DangerMonkeys/leaf/src/README.md

# leaf source code

This folder contains the source code for the leaf vario including [libraries](libraries) and [core source code](vario).  It requires Arduino and the ESP 32 Board Manager (see [documentation](vario/README.md)).

## PlatformIO

To use [PlatformIO](https://platformio.org/) to develop this project:

### Setup

1. Download [Visual Studio Code](https://code.visualstudio.com/)
2. In the Extensions tab, search for PlatformIO and install the extension (make sure to restart VS Code when requested)
3. Make sure that formatting will be applied on save:
    1. Open preferences with File -> Preferences -> Settings
    2. Type in "files: auto save" to the search box to find "Files: Auto Save"
    3. Ensure this setting is **not** afterDelay (all other settings are ok)

### Development

* Open the [root repository folder](..) (File -> Open Folder...)
* Change build environment as desired
    * Click second-from-right icon in PlatformIO toolbar (small bar at bottom of IDE) and select the release environment appropriate to your hardware (e.g., "leaf_3_2_5_release")
* Build and upload firmware
    * If needed (if upload fails and/or if running a release version with mass storage enabled), put in bootloader mode:
        * Unplug device (leaf)
        * Make sure device is turned off (hold center button to turn off)
        * Hold down boot button (smallest speaker hole)
        * Plug in device to USB
            * Alternately, press and release reset button (largest speaker hole)
        * Release boot button
    * Click the small rightward arrow in the PlatformIO toolbar to build and upload firmware

### Testing

* To ensure minimal functionality of new firmware, use this [basic test procedure](../docs/dev-references/testing/test_procedure.md)

#### Formatting

To auto-format all Leaf C++ files:

* Open command palette (ctrl-shift-p or View -> Command Palette...)
* Select "Tasks: Run Task" (start typing "run task" to find that option)
* Select "Format Leaf C++ Files"

### Versioning

The many types of versions used by leaf are documented here.

#### Tag version

Releases on this repository are assigned [semantic versions](https://semver.org) which point to a specific commit in the repository, and the tag for the release is named according to that version, prefixed with a "v" (e.g., `v0.0.9`).  That semantic version is a "tag version".  Since a release contains/produces firmware for multiple hardware variants, a given tag version can be associated with multiple firmware versions.

#### Hardware version

All leaf-compatible hardware designs are assigned [semantic versions](https://semver.org); e.g., 2.3.5.

#### Hardware type

Currently, firmware is only built for native leaf hardware and the hardware type for all leaf hardware versions is "leaf".  If support were ever added for hardware other than leaf hardware, that hardware would have a different hardware type.  The hardware type should be a lowercase alphanumeric identifier starting with an alphabet character.

#### Hardware variant

A hardware variant refers to a specific type of hardware.  It is formed by replacing the periods in the hardware version with underscores, and then concatenating the hardware type and underscored hardware version with an underscore.  So, for instance leaf hardware version 2.3.5 would be the hardware variant `leaf_2_3_5`.  Each hardware variant customizes the build as described in [variants](./variants).

#### Behavior variant

All supported hardware uses the `release` environment. Developer features are controlled by the runtime `dev_mode` setting in that firmware.

UDP sensor injection accepts messages on port 7431 only when `dev_mode` and the web app Developer card's **UDP sensor injection** setting are both enabled, and Leaf is connected to WiFi or hosting its access point. Injection is off by default. Disabling `dev_mode` also clears the saved injection setting, so enabling developer mode again does not resume injection. Connect using the usual WiFi controls; developer mode does not automatically start WiFi or keep it connected after leaving the menu.

For replay while using the flight pages, enable the web app's developer control to keep the app always on before leaving the menu.

The v3.2.2 lab hardware can be built manually with `pio run -e leaf_3_2_2_release`; GitHub CI builds only field hardware.

#### Firmware version

A firmware version is a [semantic version](https://semver.org) describing a particular firmware binary.  It is composed of the tag version of the most recent release tag in the history of the branch from which the firmware was built, plus a prerelease label when appropriate, plus build metadata.

When firmware is built from a commit tagged as a release, no prerelease label is added (e.g., `0.0.9+h2.3.5`).  When firmware is built from a clean workspace at a commit later than a tagged release, a prerelease label of the first three characters of the commit hash is added (e.g., `0.0.9-fa8+h2.3.5`).  If the workspace is dirty (there are uncommitted changes that would affect the repository), a "d" is appended to the prerelease label (e.g., `0.0.9-fa8d+h2.3.5` for local changes on top of commit faa8 after/on the `0.0.9` tag version).

The build metadata is the hardware version prefixed with "h" (e.g., `h2.3.5` for leaf hardware version 2.3.5).  The build metadata is appended to the firmware version with a plus, per semantic versioning.  Note that hardware type is not encoded in firmware version.
