DangerMonkeys/leaf/vario/hardware/readme.md

Sensor Axes
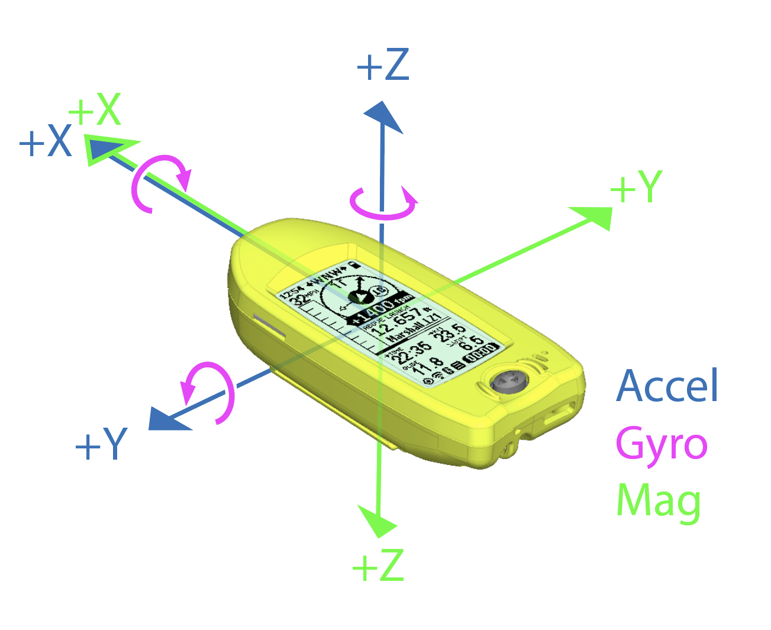
[picture p1: vario/hardware/assets/Leaf_Axes.jpg]


PCB
