DangerMonkeys/leaf/src/vario/hardware/README.md

# hardware

This folder contains abstractions for hardware devices. These tools interact directly with the hardware device at the electrical level and present the information gathered in the most "raw" form that is semantically meaningful.

- [Buttons](./buttons.md)
