DangerMonkeys/leaf/docs/dev-references/bluetooth.md

---
title: Bluetooth Low Energy
description: Leaf BLE serial protocol and diagnostics
---

# Bluetooth Low Energy

Leaf exposes a Nordic UART Service (NUS) so that flight applications can treat it as a BLE serial
device. The implementation has been tested with XCSoar, XCTrack, and SeeYou Navigator.

## Device name and advertising

The complete Bluetooth name is `LeafXXXX`, where `XXXX` is the last four hexadecimal digits of
Leaf's Wi-Fi station MAC address. The Connect menu and the GAP Device Name characteristic use
this same eight-character name. The Wi-Fi access point name remains `Leaf-XXXX`.

The primary advertisement contains flags (3 bytes), the Nordic UART service UUID (18 bytes), and
the complete Bluetooth name (10 bytes including field overhead), totaling 31 bytes. Both the
service and the full device identifier are available without a scan response. Advertising data
is reset on each setup so Bluetooth restarts do not accumulate old fields.

Disabling Bluetooth tears down both the radio stack and its server, services, and characteristics.
Re-enabling it creates a fresh GATT database with a single Nordic UART service. The server callback
has static lifetime and is not owned by NimBLE, allowing the server to be safely deleted.

## GATT interface

| Item | UUID | Properties | Purpose |
| --- | --- | --- | --- |
| Nordic UART service | `6E400001-B5A3-F393-E0A9-E50E24DCCA9E` | Service | BLE serial container |
| RX characteristic | `6E400002-B5A3-F393-E0A9-E50E24DCCA9E` | Write without response, 64-byte maximum | Data written by the phone to Leaf |
| TX characteristic | `6E400003-B5A3-F393-E0A9-E50E24DCCA9E` | Read and notify | Data sent by Leaf to the phone |

The RX characteristic is present because some BLE serial clients require the complete bidirectional
NUS interface during service discovery. Leaf currently accepts but does not interpret RX data. It
also does not echo received data.

Only one BLE central connection is supported at a time. When an application disconnects, Leaf
restarts advertising so another application can connect. The BLE task checks the connection count
and actual advertising state on each wakeup. While enabled and disconnected, it retries inactive
advertising at most once per second, including after a failed initial start. Disconnect callbacks
record diagnostics; restarting happens in the BLE task. Advertising attempts are serialized with
start/stop, so recovery cannot undo an intentional Bluetooth shutdown.

The Connect menu shows the sampled runtime state below the Bluetooth name: `Advertising`,
`Connected`, `Retrying...`, or `Inactive`. `Connected` means NimBLE still reports a central connection;
it does not confirm that the phone has subscribed to NMEA notifications. If the phone reports a
disconnect but Leaf remains `Connected`, advertising retries deliberately leave that connection
alone. This distinguishes a missed disconnect or retained phone connection from a failed restart.

## Transmitted data

All TX records are ASCII NMEA-style sentences ending in an XOR checksum and `\r\n`. Incoming GPS
GGA and RMC records have their checksum recalculated before transmission, so a checksum inherited
from the GPS module cannot cover stale or modified content.

Leaf sends the following record types:

- `$LK8EX1` at up to 10 Hz, containing pressure in Pa, pressure altitude in metres, filtered climb
  rate in cm/s, ambient temperature in degrees Celsius, and battery percentage encoded as
  `1000 + percentage`. The comma before the checksum is intentional and required for compatibility
  with some clients. Temperature is `99` until the ambient sensor is ready.
- `$GPGGA`/`$GNGGA` and `$GPRMC`/`$GNRMC` GPS records, limited to two of each type per second.
- `$PFLAA` traffic records generated from received FANET tracking packets when Leaf has a usable
  local GPS fix.

Leaf does not expose the standard Battery Service or Environmental Sensing Service. Battery and
temperature are carried in `$LK8EX1`; humidity and wind are not currently transmitted over BLE.

## Diagnostics

BLE diagnostics use the existing `diagnostics/system_events.csv` file. No separate BLE log or
in-memory history buffer is created. The instrumentation records:

- connection and disconnection checkpoints, including the NimBLE disconnect reason;
- advertising restart success or failure;
- changes in the sampled connection/advertising state (also shown in the Connect menu);
- cumulative NUS notification submission counts at disconnect;
- immediately reported notification-submission failures;
- full periodic, GPS, or FANET BLE queues; and
- heap and registered-task stack snapshots at important connection lifecycle events.

Leaf also checks heap integrity every five seconds while the BLE task is running. A healthy check is
silent; only a failure produces a `ble-heap-invalid` event. Consequently, normal operation adds no
per-sentence SD writes and only a few records around each connection transition.
SD diagnostics require Developer Mode and the System Events diagnostic log to be enabled.

NimBLE's characteristic-update API is asynchronous. A successful `notify()` result means the update
was submitted to NimBLE; it is not confirmation that the phone received the notification over the
air.
