DangerMonkeys/leaf/codex_artifacts/runtime-telemetry/thermal-track-bitmap-2026-10-22/report.html

# Leaf runtime assessment · Leaf 3.2.8 bitmap Thermal Track - logging and wind page sweep

device · leaf_3_2_8 · 0.2.4-842d.thermaltest+h3.2.8 · 72.3 seconds

REVIEW REQUIRED · Normal slots: 43 deadline crossings · 0 duration overruns · 0 coalesced ticks · minimum 67 samples/slot

0–10 ms scale. Green <5; yellow 5–7.5; orange 7.5–10; red >10 ms or a deadline miss. Thresholds are provisional. Bars show maxima across different seconds. A short red bar indicates work finishing beyond its deadline despite low accumulated occupancy. T/G/S show average assigned-task/GPS/service milliseconds. GPS and foreground services are included; empty UART polling is separate. Base work includes barometer, buttons, and speaker.

00 baro_adc

max 1.15 ms · p95 ≤ 1.15 msstart +0.01 · end +0.00 msavg T 0.89 G 0.00 S 0.00n=69 · misses 0excluded B 4 · R 0

01 base

max 0.60 ms · p95 ≤ 0.60 msstart +0.01 · end +0.00 msavg T 0.46 G 0.00 S 0.00n=69 · misses 0excluded B 3 · R 1

02 imu_wind

max 3.91 ms · p95 ≤ 3.91 msstart +0.01 · end +0.00 msavg T 3.48 G 0.00 S 0.00n=69 · misses 0excluded B 3 · R 1

03 base

max 0.79 ms · p95 ≤ 0.50 msstart +0.01 · end +0.00 msavg T 0.31 G 0.00 S 0.00n=69 · misses 0excluded B 3 · R 1

04 base

max 0.80 ms · p95 ≤ 0.80 msstart +0.01 · end +0.00 msavg T 0.42 G 0.00 S 0.00n=70 · misses 0excluded B 3 · R 0

05 baro_adc

max 1.70 ms · p95 ≤ 1.00 msstart +0.01 · end +0.00 msavg T 0.76 G 0.00 S 0.00n=70 · misses 0excluded B 3 · R 0

06 base

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

88 base

max 0.91 ms · p95 ≤ 0.91 msstart +0.01 · end +0.00 msavg T 0.31 G 0.00 S 0.01n=72 · misses 0excluded B 1 · R 0

89 display

max 8.01 ms · p95 ≤ 8.00 msstart +0.01 · end +0.00 msavg T 6.84 G 0.00 S 0.01n=71 · misses 0excluded B 2 · R 0

90 baro_adc

max 1.56 ms · p95 ≤ 1.00 msstart +0.01 · end +0.00 msavg T 0.85 G 0.00 S 0.01n=71 · misses 0excluded B 2 · R 0

91 base

max 1.13 ms · p95 ≤ 1.00 msstart +0.01 · end +0.00 msavg T 0.49 G 0.00 S 0.01n=71 · misses 0excluded B 1 · R 1

92 imu_wind

max 4.44 ms · p95 ≤ 4.00 msstart +0.01 · end +0.00 msavg T 3.41 G 0.00 S 0.01n=71 · misses 0excluded B 1 · R 1

93 base

max 0.91 ms · p95 ≤ 0.91 msstart +0.01 · end +0.00 msavg T 0.30 G 0.00 S 0.01n=70 · misses 0excluded B 2 · R 1

94 base

max 1.03 ms · p95 ≤ 1.00 msstart +0.01 · end +0.00 msavg T 0.41 G 0.00 S 0.01n=70 · misses 0excluded B 3 · R 0

95 baro_adc

max 1.14 ms · p95 ≤ 1.00 msstart +0.01 · end +0.00 msavg T 0.74 G 0.00 S 0.00n=70 · misses 0excluded B 3 · R 0

96 base

max 0.84 ms · p95 ≤ 0.84 msstart +0.01 · end +0.00 msavg T 0.47 G 0.00 S 0.00n=70 · misses 0excluded B 3 · R 0

97 imu

max 4.22 ms · p95 ≤ 4.00 msstart +0.01 · end +0.00 msavg T 3.37 G 0.00 S 0.00n=70 · misses 0excluded B 3 · R 0

98 base

max 0.77 ms · p95 ≤ 0.77 msstart +0.01 · end +0.00 msavg T 0.30 G 0.00 S 0.00n=70 · misses 0excluded B 3 · R 0

99 ambient_read

max 1.73 ms · p95 ≤ 1.73 msstart +0.01 · end +0.00 msavg T 0.81 G 0.00 S 0.00n=69 · misses 0excluded B 4 · R 0

## Display pages

Normal renders only; menus and overlays excluded. Render costs include SPI wait, drawing and transfer, and are already included in slot occupancy. Page flags refer to actual rendered content. Unvisited pages remain unmeasured.

Page | Renders | Max ms | Mean ms | p95 ms | Max occupied slot ms | Slot misses/samples | Excluded B/R renders
User | 23 | 8.727 | 6.346 | ≤7.000 | 9.239 | 0/23 | 6/0
Thermal Track | 32 | 7.379 | 6.684 | ≤7.000 | 7.827 | 0/32 | 6/0
Navigate | 31 | 7.354 | 7.121 | ≤7.354 | 8.016 | 0/31 | 7/0
Basic | 24 | 6.183 | 5.807 | ≤6.183 | 6.766 | 0/24 | 3/1
Thermal Core | 25 | 5.706 | 5.332 | ≤5.706 | 6.215 | 0/25 | 7/0
Debug | Not measured | | | | | | 0/0
Debug 2 | Not measured | | | | | | 0/0

## Buttons and recovery

Excluded from normal grid: 238 button slots and 52 recovery slots. Button peak occupied 21.877 ms; button coalesced ticks 0. Recovery: 2 deadline crossings, 2 coalesced ticks; max start +8.916 ms, end +0.022 ms, barometer first call +8.979 ms.

Recovery by slot

Slot | Excluded B/R | Max start +ms | Max end +ms | Misses/ticks | Baro +ms
00 | 4/0 | 0.000 | 0.000 | 0/0 | 0.000
01 | 3/1 | 4.442 | 0.000 | 0/0 | 4.503
02 | 3/1 | 0.005 | 0.000 | 0/0 | 0.038
03 | 3/1 | 0.007 | 0.000 | 0/0 | 0.073
04 | 3/0 | 0.000 | 0.000 | 0/0 | 0.000
05 | 3/0 | 0.000 | 0.000 | 0/0 | 0.000
06 | 2/0 | 0.000 | 0.000 | 0/0 | 0.000
07 | 3/0 | 0.000 | 0.000 | 0/0 | 0.000
08 | 2/1 | 0.005 | 0.000 | 0/0 | 0.066
09 | 2/2 | 5.257 | 0.000 | 0/0 | 5.320
10 | 2/1 | 0.005 | 0.000 | 0/0 | 0.053
11 | 2/1 | 0.005 | 0.000 | 0/0 | 0.025
12 | 2/0 | 0.000 | 0.000 | 0/0 | 0.000
13 | 2/0 | 0.000 | 0.000 | 0/0 | 0.000
14 | 2/0 | 0.000 | 0.000 | 0/0 | 0.000
15 | 2/0 | 0.000 | 0.000 | 0/0 | 0.000
16 | 2/0 | 0.000 | 0.000 | 0/0 | 0.000
17 | 2/0 | 0.000 | 0.000 | 0/0 | 0.000
18 | 2/0 | 0.000 | 0.000 | 0/0 | 0.000
19 | 2/0 | 0.000 | 0.000 | 0/0 | 0.000
20 | 2/1 | 5.369 | 0.000 | 0/0 | 5.436
21 | 2/1 | 0.005 | 0.000 | 0/0 | 0.059
22 | 2/1 | 0.007 | 0.000 | 0/0 | 0.026
23 | 2/1 | 4.573 | 0.000 | 0/0 | 4.636
24 | 2/1 | 0.008 | 0.000 | 0/0 | 0.037
25 | 2/1 | 0.007 | 0.000 | 0/0 | 0.023
26 | 2/0 | 0.000 | 0.000 | 0/0 | 0.000
27 | 2/0 | 0.000 | 0.000 | 0/0 | 0.000
28 | 2/0 | 0.000 | 0.000 | 0/0 | 0.000
29 | 3/0 | 0.000 | 0.000 | 0/0 | 0.000
30 | 3/0 | 0.000 | 0.000 | 0/0 | 0.000
31 | 3/0 | 0.000 | 0.000 | 0/0 | 0.000
32 | 3/0 | 0.000 | 0.000 | 0/0 | 0.000
33 | 2/1 | 7.808 | 0.000 | 0/0 | 7.874
34 | 2/1 | 0.008 | 0.000 | 0/0 | 0.038
35 | 2/1 | 0.005 | 0.000 | 0/0 | 0.020
36 | 2/0 | 0.000 | 0.000 | 0/0 | 0.000
37 | 2/0 | 0.000 | 0.000 | 0/0 | 0.000
38 | 2/0 | 0.000 | 0.000 | 0/0 | 0.000
39 | 1/1 | 2.091 | 0.000 | 0/0 | 2.156
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

## GPS sentence handling

1002 completed dispatches · 5 sentence deadline crossings. Sentence and slot crossing counts differ: multiple sentences may share a slot. These summaries include button/recovery activity.

NMEA | Count | Accepted/rejected/unobserved | Mean ms | Max ms | p95 ms | Crossings | Max end +ms
GGA | 72 | 72/0/0 | 1.818 | 2.026 | ≤2.000 | 0 | 0.000
RMC | 73 | 73/0/0 | 1.864 | 2.062 | ≤2.000 | 1 | 0.155
GSV | 421 | 421/0/0 | 1.209 | 1.894 | ≤1.894 | 3 | 0.262
GSA | 216 | 216/0/0 | 1.035 | 1.330 | ≤1.330 | 0 | 0.000
VTG | 73 | 73/0/0 | 0.926 | 1.068 | ≤1.068 | 0 | 0.000
GLL | 72 | 72/0/0 | 1.300 | 1.374 | ≤1.374 | 1 | 0.112
ZDA | Not measured
Other | 75 | 75/0/0 | 0.636 | 0.888 | ≤0.888 | 0 | 0.000

Checksum acceptance is separate from a valid position fix. Processing combines active UART-read chunks and complete-line dispatch; idle waiting between fragments is excluded. On device, elapsed times include blocking and preemption; simulator values use host thread CPU time.

Processing stages · mean (maximum) ms

Stages are exclusive, including nested mutex waits. GPS updates means immediate sentence updates; scheduled navigation/glide work remains in slots 09/59. Other is remaining measured processing time. UART reads are absent for injected messages; separate captures should be used for distinct input sources.

NMEA | UART read | Bus mutex wait | Mutex wait | Parse | GPS updates | Reading callbacks | BLE enqueue | Other mean
GGA | 1.404 (1.505) | 0.006 (0.011) | 0.006 (0.008) | 0.115 (0.161) | 0.031 (0.043) | 0.103 (0.120) | 0.041 (0.052) | 0.110
RMC | 1.360 (1.484) | 0.006 (0.010) | 0.006 (0.008) | 0.097 (0.110) | 0.008 (0.011) | 0.230 (0.274) | 0.049 (0.097) | 0.109
GSV | 0.921 (1.291) | 0.006 (0.014) | 0.004 (0.012) | 0.082 (0.201) | 0.062 (0.131) | 0.062 (0.199) | 0.014 (0.041) | 0.057
GSA | 0.848 (1.019) | 0.006 (0.011) | 0.004 (0.010) | 0.044 (0.067) | 0.005 (0.014) | 0.059 (0.113) | 0.014 (0.031) | 0.055
VTG | 0.712 (0.784) | 0.005 (0.016) | 0.005 (0.010) | 0.035 (0.044) | 0.007 (0.011) | 0.076 (0.118) | 0.014 (0.030) | 0.070
GLL | 1.006 (1.052) | 0.006 (0.011) | 0.005 (0.011) | 0.048 (0.052) | 0.009 (0.011) | 0.100 (0.121) | 0.024 (0.029) | 0.100
Other | 0.531 (0.580) | 0.005 (0.012) | 0.004 (0.009) | 0.016 (0.044) | 0.002 (0.011) | 0.037 (0.100) | 0.010 (0.046) | 0.031

### Sentence dispatch phase across the 100 logical slots

Phase is observed after a line is assembled, before dispatch. It is not the receiver's wire-arrival timestamp; queued bytes can be older. Logical phase can shift after coalesced ticks. Injected input reflects its playback schedule.

### Retained sentence deadline crossings

Ready/end offsets are relative to the slot's intended start; end beyond +10 ms crosses its deadline. Observed read span may include inter-fragment waiting and is not CPU cost. Hover for stage durations.

Sentence | Checksum/parser | Slot/tick | Ready +ms | End +ms | Processing ms | Observed read span ms | Context
GPGSV | accepted | 83/2881475 | 9.770 | 10.262 | 1.306 | 0.839 | UART, partial ingestion
GNRMC | accepted | 82/2886575 | 9.637 | 10.155 | 1.860 | 4.945 | UART
GNGLL | accepted | 78/2883471 | 9.795 | 10.112 | 1.326 | 8.215 | UART
GLGSV | accepted | 81/2887074 | 9.824 | 10.053 | 1.010 | 7.647 | UART

Recent sentences (may overlap retained crossings)

Sentence | Checksum/parser | Slot/tick | Ready +ms | End +ms | Processing ms | Observed read span ms | Context
GPGSV | accepted | 79/2888673 | 2.504 | 3.028 | 1.677 | 8.689 | UART
GPGSV | accepted | 79/2888673 | 3.532 | 3.711 | 0.627 | 0.458 | UART
GLGSV | accepted | 80/2888674 | 1.772 | 2.123 | 1.158 | 8.044 | UART
GAGSV | accepted | 80/2888674 | 3.377 | 3.571 | 1.392 | 1.207 | UART
GAGSV | accepted | 80/2888674 | 4.202 | 4.333 | 0.738 | 0.613 | UART
GNRMC | accepted | 81/2888675 | 3.280 | 3.825 | 1.903 | 8.932 | UART
GNVTG | accepted | 81/2888675 | 4.687 | 4.913 | 0.949 | 0.749 | UART
PQOther | accepted | 81/2888675 | 5.473 | 5.569 | 0.625 | 0.534 | UART

Coverage: 0 asynchronous dispatches excluded; 0 nested dispatches omitted; 0 dispatches before a slot; 1 partial-ingestion sentences; 0 UART buffer resets. Recent events overwritten: 994 (capacity 8); crossing capacity 4. Maximum profile-record bookkeeping: 37 µs. This does not isolate full profiler overhead.

## Memory

Internal heap change -4 B. Allocation failures: 0

Sampled minima: {"internal_free": 33208, "internal_min": 26644, "internal_largest": 13300, "loop_stack": 8304, "ble_stack": 2992, "fanet_tx_stack": 0, "fanet_rx_stack": 0}

## Observer footprint

Capture buffer: 22,496 B (internal). Clock pair max: 1 µs; slot bookkeeping max: 166 µs; memory sample max: 650 µs. Trace records overwritten: 7216; partial slots excluded: 1.

## Baseline changes

No compatible baseline comparison

Slot | Maximum change | Miss-rate change

## Worst incident and preceding slot

Timestamps in microseconds since boot; work columns use elapsed microseconds.

Event | Slot | Tick | Expected start | Actual start | Tasks end | Last work end | Tasks/GPS/services | Page mask
Normal worst | 83 | 2881475 | 28815754600 | 28815763223 | 28815763500 | 28815764890 | 248/1365/0 | 00
Recovery preceding | 82 | 2881575 | 28816754600 | 28816754606 | 28816773469 | 28816773432 | 18780/0/0 | 08
Recovery worst | 83 | 2881576 | 28816764600 | 28816773516 | 28816773804 | 28816774622 | 263/790/0 | 00

Review notes and measurement limits

- Normal slot/page statistics exclude held buttons, button events and recovery. Recovery covers the next two dispatched slots and extends while completion is late or start delay exceeds 1 ms; inspect it separately.
- Few samples: the least-sampled slot has 67; tail estimates are preliminary.
- GPS summaries include all sentence dispatches, including interactions. Stages are exclusive elapsed times on device (host thread CPU in sim), not isolated CPU costs. UART timestamps observe firmware reads, not wire arrival. Checksum acceptance does not establish a valid position fix.
- The first UART sentence(s) contained bytes read before capture; their ingestion timings are partial.
- Recent trace wrapped by design; full-run slot aggregates and the worst incident remain available.
- Clock-pair, slot-bookkeeping, and memory-sampling costs are reported. Full instrumentation overhead requires an external A/B measurement.
- A zero stack reading can mean an unregistered task or no headroom; inspect active task state and raw samples. Positive stack minima skip zero readings.
- Stage 1 manual capture: enabled features are not verified workload coverage. Review is required before release.
- Memory change is between manual capture endpoints; a negative change alone does not prove a leak. Heap low watermarks include earlier boot activity.
- ATTENTION: internal free heap ended below its starting value; repeat equivalent lifecycle phases to assess recovery.
- ATTENTION: barometer first-call delay exceeded 1 ms in slots 83. Check conversion timing.
- ATTENTION: button recovery includes deadline crossings, coalesced ticks or barometer delays. Button exclusions do not establish safe recovery; check sensor/GPS/IGC continuity on hardware.

Provenance

{"commit": "8427b318ffb68ce1360d7c247d6eaacf4d6997ad", "coverage_notes": "User reports logging active, enough collected points for a valid wind estimate, then about 10-12 seconds on each page from Navigate through Basic. Capture spans 72.261 seconds. Ten fixed synthetic Thermal Track markers, bitmap rings/erase/markers/pilot, outlined distance labels. BLE enabled; client activity not established. Debug pages enabled but unvisited. Latest IGC preserved separately; this export does not record wind estimate validity or its value.", "device_id": "7C4FAD3BACB0", "dirty": true, "firmware_sha256": "1847d9102bfe5b5d9fb40b6beb8cbbbc3108df9b7cd0986936401472f5fbd548", "flashed_firmware_verified": "USB I:/FIRMWARE.BIN SHA256 equals local test build and preserved firmware.bin", "label": "Leaf 3.2.8 bitmap Thermal Track - logging and wind page sweep", "limitations": "Short exploratory manual sweep, 23-32 normal renders per page; not a release assessment. Prior runtime_6 had different GPS activity/arrival phase, shorter duration, debug setting and unconfirmed flight logging/wind conditions. Descriptive before/after only; no matched-baseline speedup attribution. Render times include SPI wait, raster drawing and transfer.", "profile": "manual-page-sweep-v1", "scenario": "real-gps-logging-wind-ten-fixed-thermal-markers-v1", "sd_card": "Connected Leaf SD card; model/capacity not recorded", "toolchain": "leaf_3_2_8_thermaltest; pinned PlatformIO configuration; exact firmware.bin preserved"}
