DangerMonkeys/leaf/test-data/field-testing/2026-10-25-firmware-0.2.4-968/_motion-analysis/auto-stop-proposals.html

# October 25: both auto-stop proposals pass the recorded flights

Fresh replay from the six original flight-containing IGC files, including Bowen and Scott in unknown hardware. Ground-only records are excluded from the airborne-landing assessment. No original files or firmware were changed.

Both candidates retain speed below 3 mph when GPS is usable (speed bypassed without GPS), valid acceleration within 0.2 g of 1 g, and altitude strictly within 2 m of the retained anchor. They differ only in requiring 10 or 15 consecutive qualifying checks, approximately seconds at the normal one-Hz check rate. This is the existing anchor/counter algorithm, not a new full-range altitude window.

Recording | 10-second proposal | 15-second proposal | Possible in-flight stops
Racoon | 14:40:10 | 14:40:15 | None
RedStrap | 14:40:00 | 14:40:05 | None
BlueGreen326 | 14:40:19 | 14:40:24 | None
Bethany | Not reached before file ended | Not reached before file ended | None
Bowen | 14:50:24 | 14:50:29 | None
Scott | 14:50:15 | 14:50:20 | None

All times are October 25 PDT. Bethany's file ends at 13:41:53; neither proposal reaches confirmation within its recorded post-landing coverage. This is not an in-flight false stop.

Bowen has the longest recorded airborne run passing speed and acceleration alone: 8 consecutive checks. Neither confirmation duration is reached while airborne. A ten-check confirmation leaves relatively little margin against longer unrecorded calm, slow flight; fifteen is the more conservative of the two proposals. These six recordings include repeated views of the same flights and are not six independent flight conditions.

Limits: auto-stop is evaluated hypothetically without pilot cancellation. Flight boundaries use the earlier analysis references, not newly confirmed touchdown labels. Each whole-meter pressure-altitude record is treated as any of its 100 possible integer-centimeter values, and all compatible retained-anchor/count states are propagated. At the tabulated candidate stop times, the compatible pressure reconstructions agree. Actual sensor freshness and sampling order were not fully logged, so these remain model predictions, approximately one-second precision, not observed device stops.

Per-track results, source paths and original-file hashes
