DangerMonkeys/leaf/docs/dev-references/archives/index.md

---
title: Historical development records
description: Archived repository audits and development history.
---

# Historical development records

These records describe the repository state at the time they were written. They
are retained for context, not maintained as current instructions.

- [October 28, 2026 branch-cleanup audit](branch-cleanup-2026-10-28.txt): original
  audit before the approved seven-branch cleanup. Its branch lists and deletion
  status are historical; recheck current refs before any future cleanup.
