DangerMonkeys/leaf/codex_artifacts/leaf-thermal-map-preview-384x480.gif

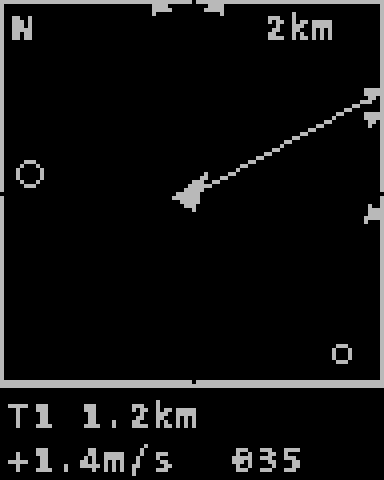
codex_artifacts/leaf-thermal-map-preview-384x480.gif
