DangerMonkeys/leaf/codex_artifacts/leaf-thermal-map-track-up-preview-384x480.gif

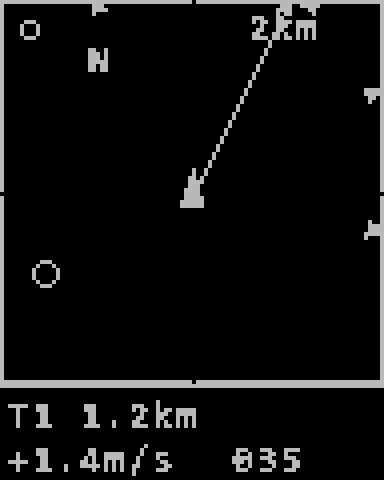
codex_artifacts/leaf-thermal-map-track-up-preview-384x480.gif
