DangerMonkeys/leaf/docs/dev-references/assets/idle_activeflight_activities.png

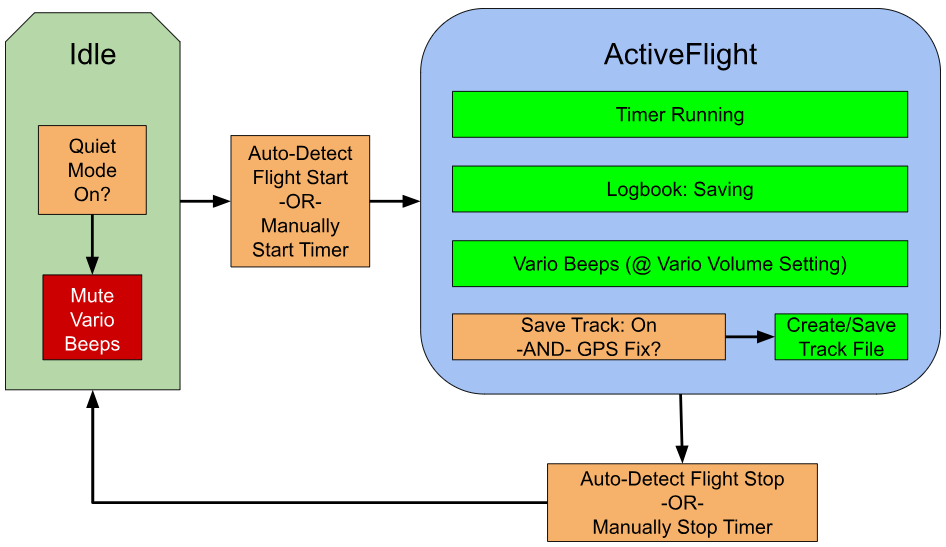
docs/dev-references/assets/idle_activeflight_activities.png
