DangerMonkeys/leaf/docs/dev-references/assets/idle_activeflight_state_diagram.png

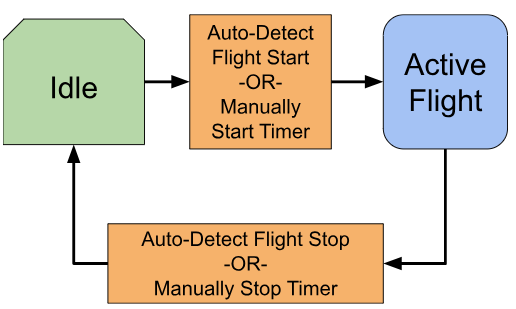
docs/dev-references/assets/idle_activeflight_state_diagram.png
