DangerMonkeys/leaf/docs/ui-reviews/charging-compact-status/preview.png

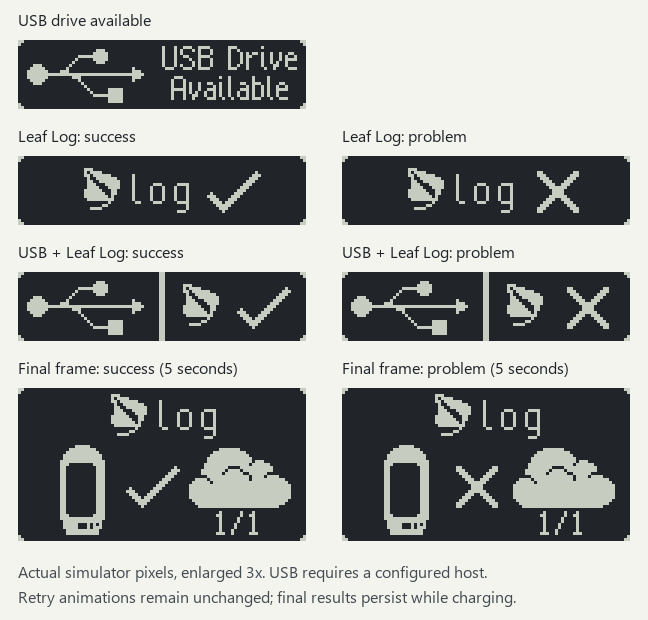
docs/ui-reviews/charging-compact-status/preview.png
