DangerMonkeys/leaf/docs/ui-reviews/charging-dialog-revamp/reference/dialog-spec.png

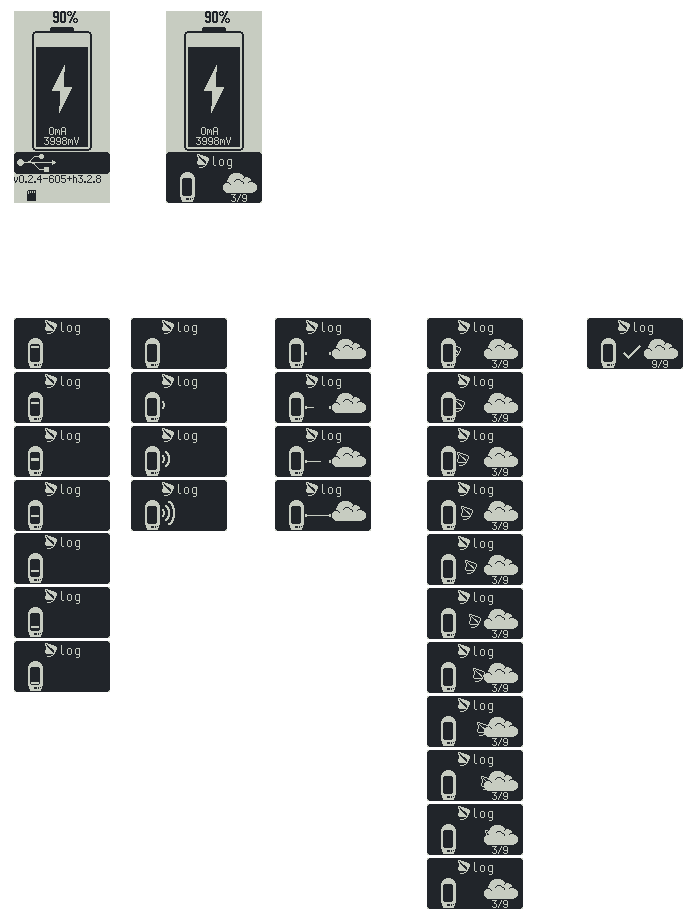
docs/ui-reviews/charging-dialog-revamp/reference/dialog-spec.png
