DangerMonkeys/leaf/docs/ui-reviews/charging-dialog-revamp/reference/upload-detail.png

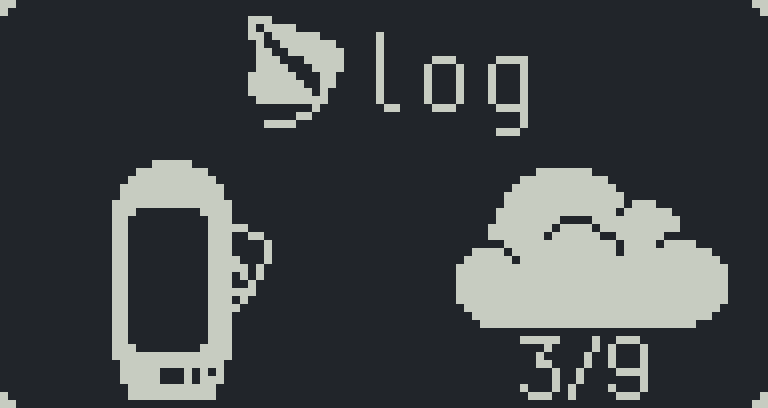
docs/ui-reviews/charging-dialog-revamp/reference/upload-detail.png
