DangerMonkeys/leaf/docs/ui-reviews/charging-dialogs-2026-10-21/01-leaf-log-checking-flights.png

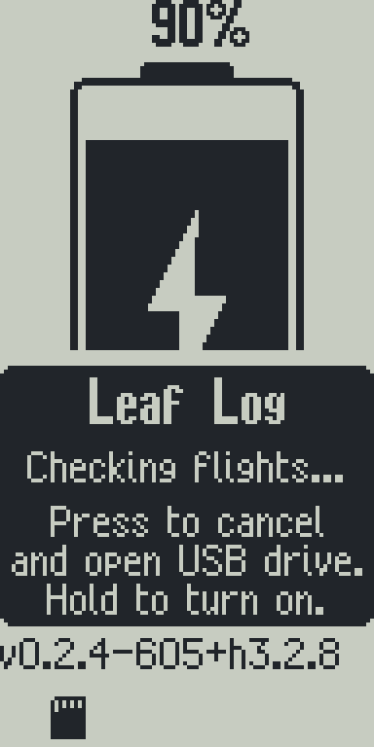
docs/ui-reviews/charging-dialogs-2026-10-21/01-leaf-log-checking-flights.png
