DangerMonkeys/leaf/docs/ui-reviews/charging-dialogs-2026-10-21/02-leaf-log-starting-wifi.png

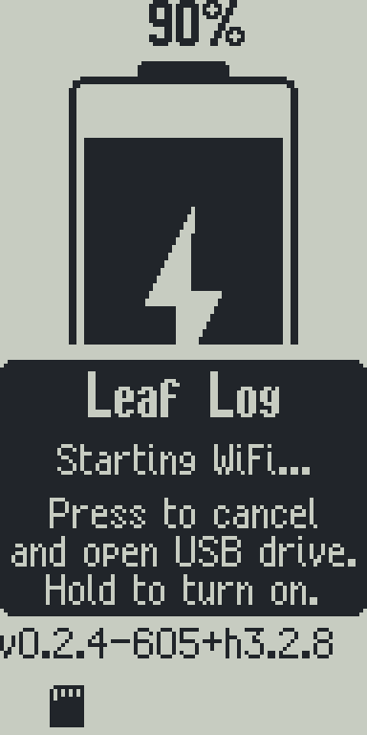
docs/ui-reviews/charging-dialogs-2026-10-21/02-leaf-log-starting-wifi.png
