DangerMonkeys/leaf/docs/ui-reviews/charging-dialogs-2026-10-21/07-leaf-log-uploaded-2-of-2-preparing-usb.png

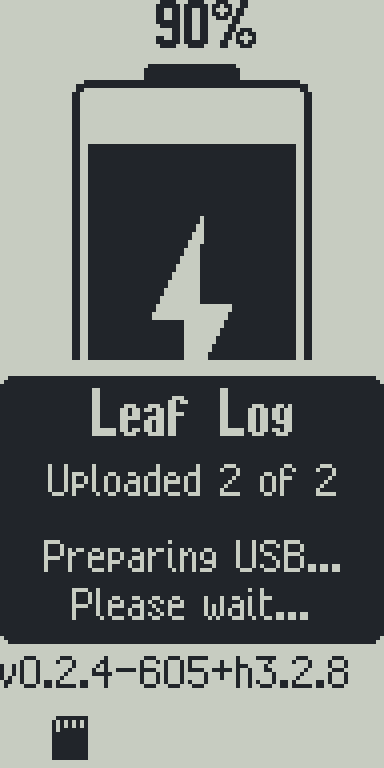
docs/ui-reviews/charging-dialogs-2026-10-21/07-leaf-log-uploaded-2-of-2-preparing-usb.png
