DangerMonkeys/leaf/docs/ui-reviews/charging-dialogs-2026-10-21/15-turning-on-please-wait.png

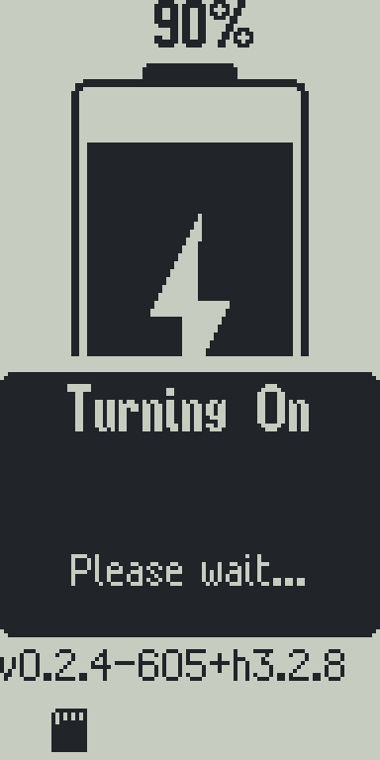
docs/ui-reviews/charging-dialogs-2026-10-21/15-turning-on-please-wait.png
