DangerMonkeys/leaf/docs/ui-reviews/charging-dialogs-2026-10-21/contact-sheet.png

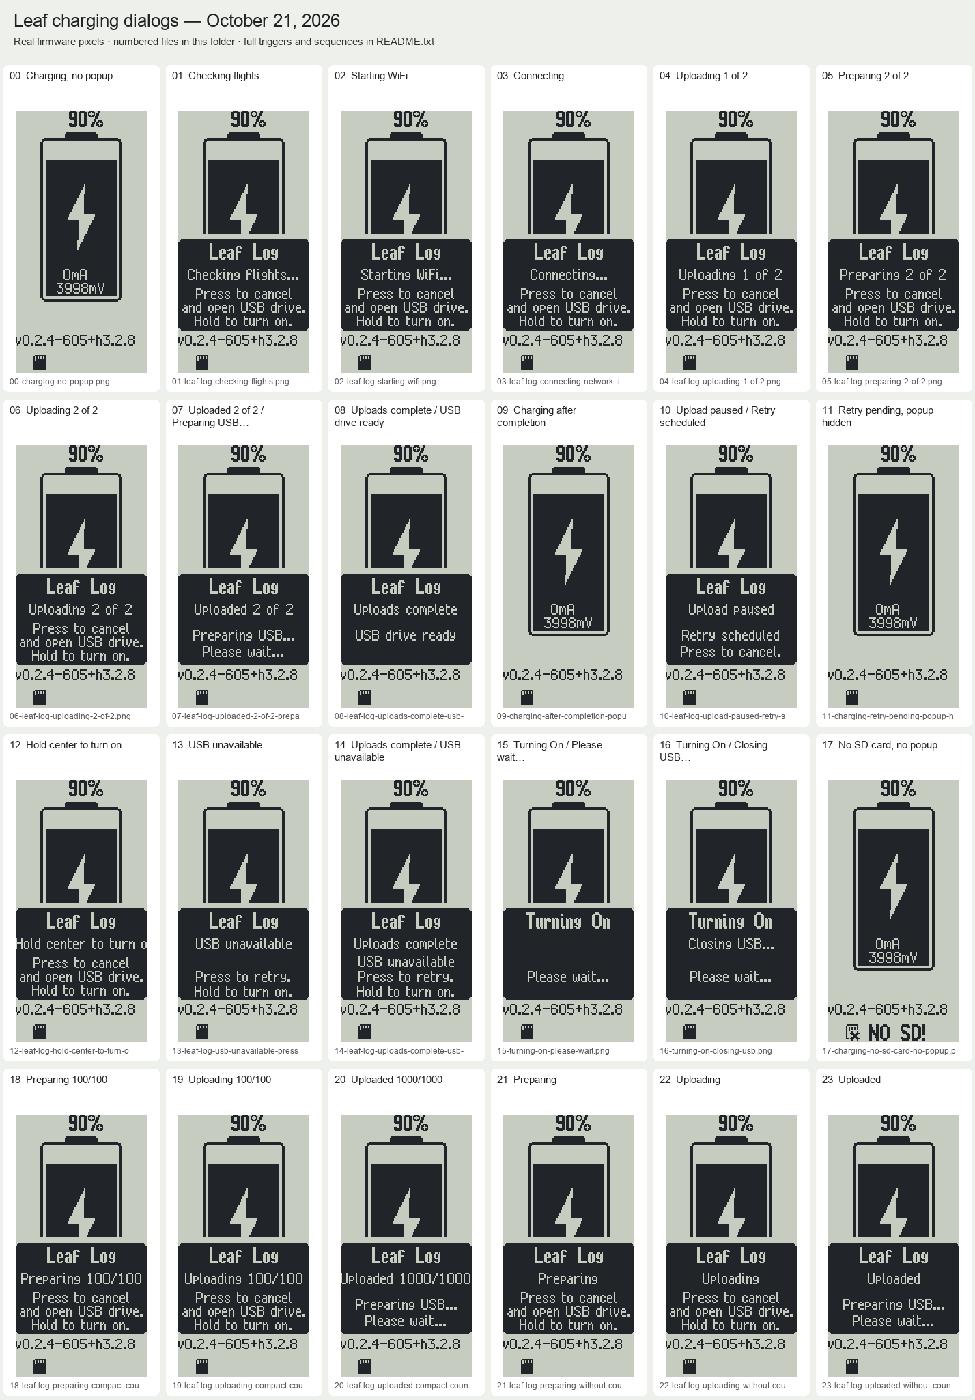
docs/ui-reviews/charging-dialogs-2026-10-21/contact-sheet.png
