DangerMonkeys/leaf/docs/ui-reviews/sd-card-dialogs/05-charging-animation.png

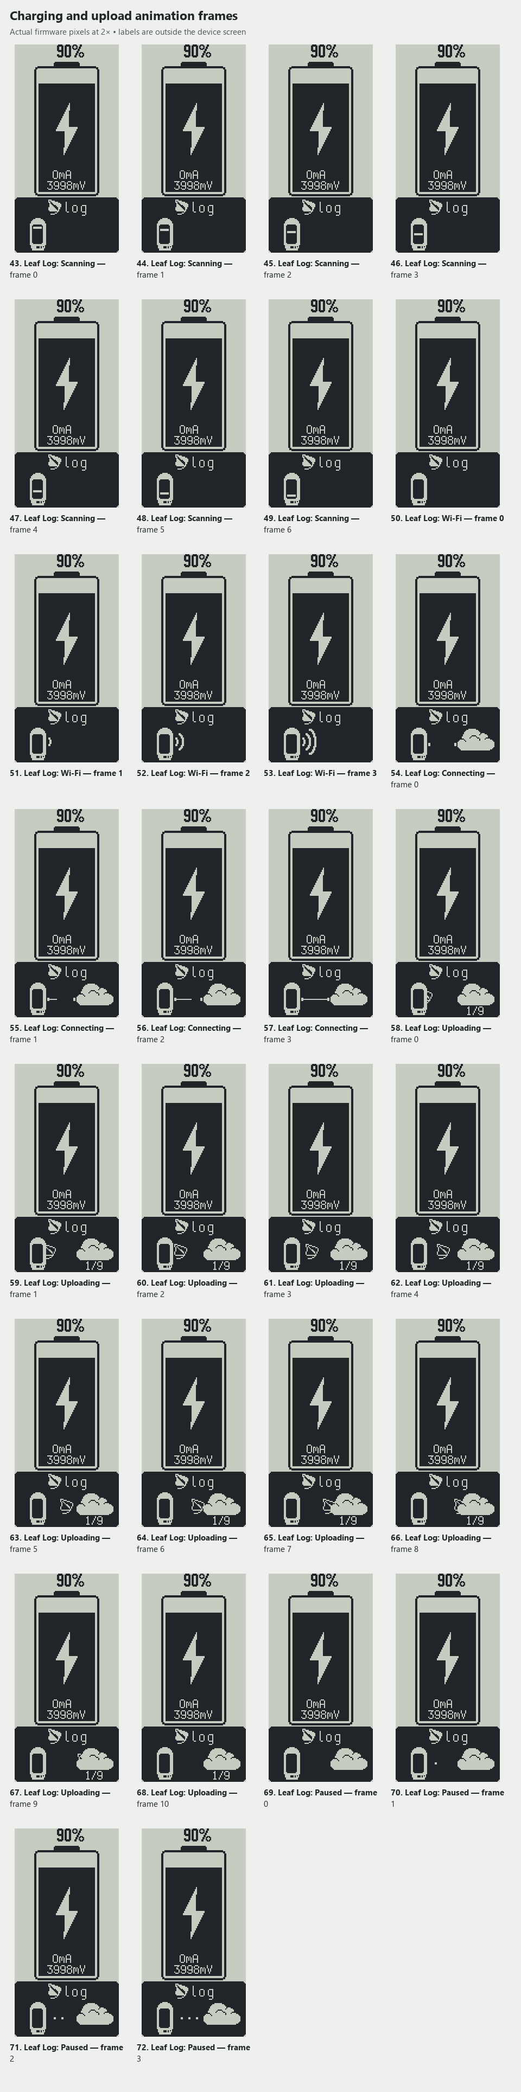
docs/ui-reviews/sd-card-dialogs/05-charging-animation.png
