DangerMonkeys/leaf/scratch/speaker-research/cpt9019a-p2.png

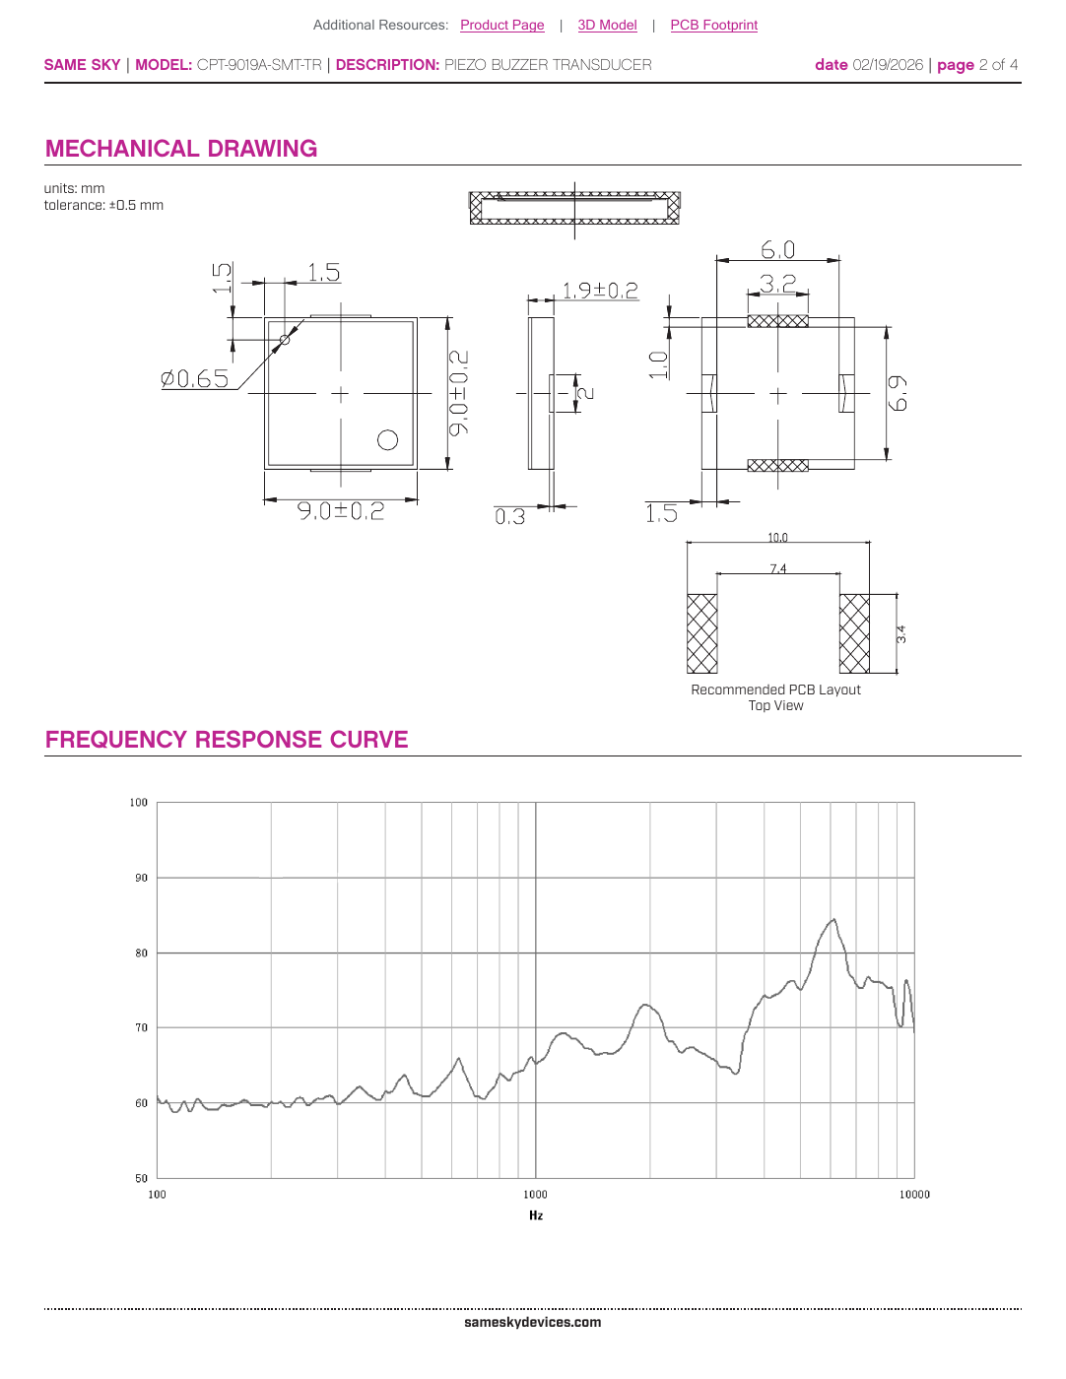
scratch/speaker-research/cpt9019a-p2.png
