DangerMonkeys/leaf/scratch/speaker-research/cy9019-p2.png

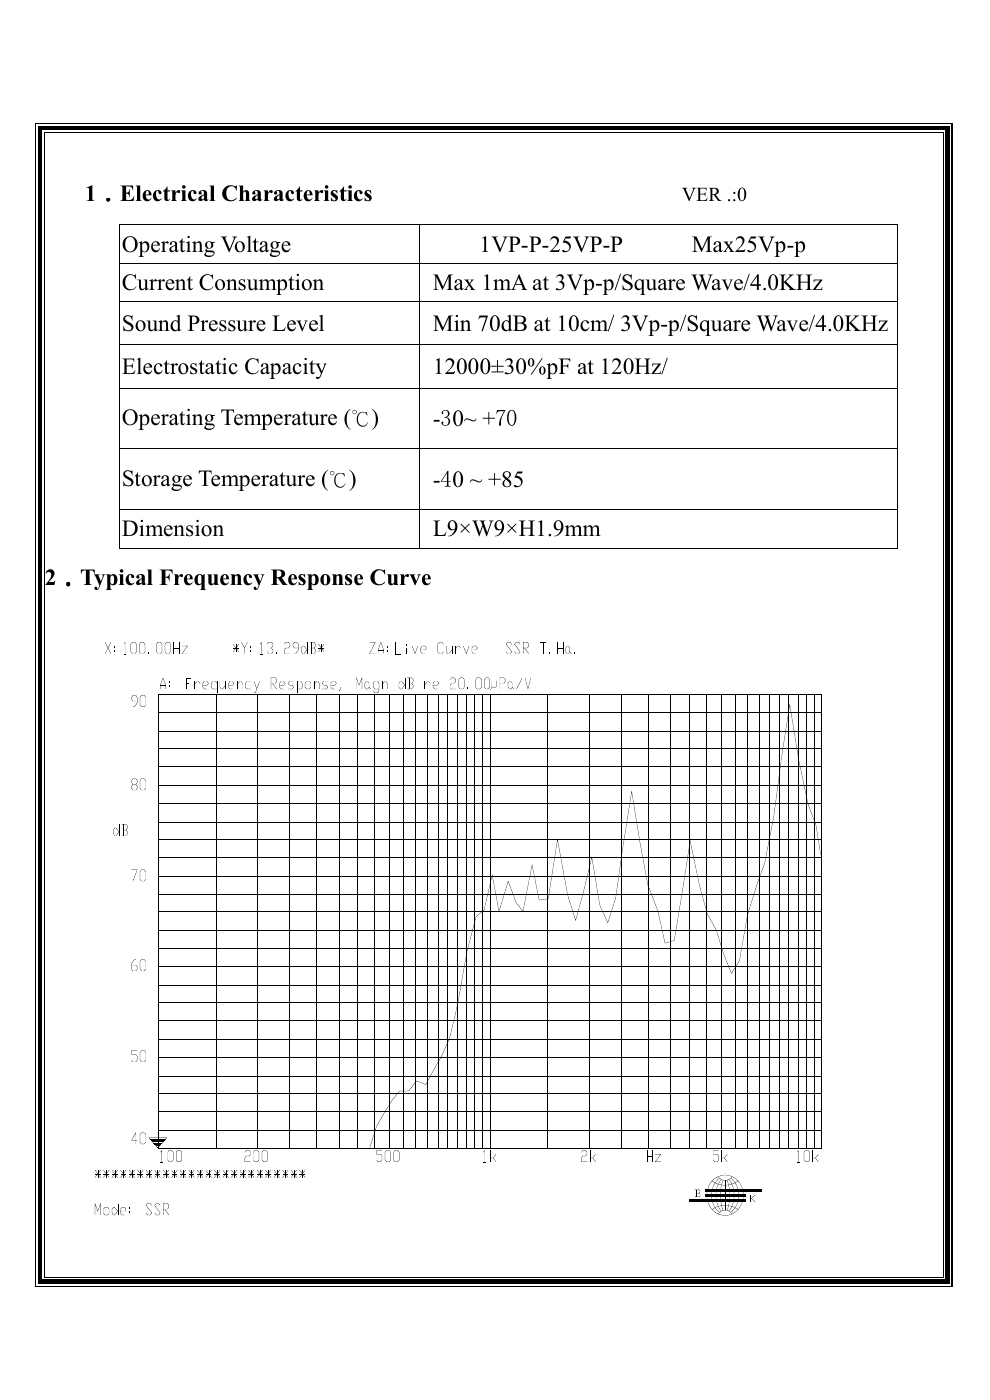
scratch/speaker-research/cy9019-p2.png
