DangerMonkeys/leaf/docs/user-guides/vario-user-manual/button-left-only.png

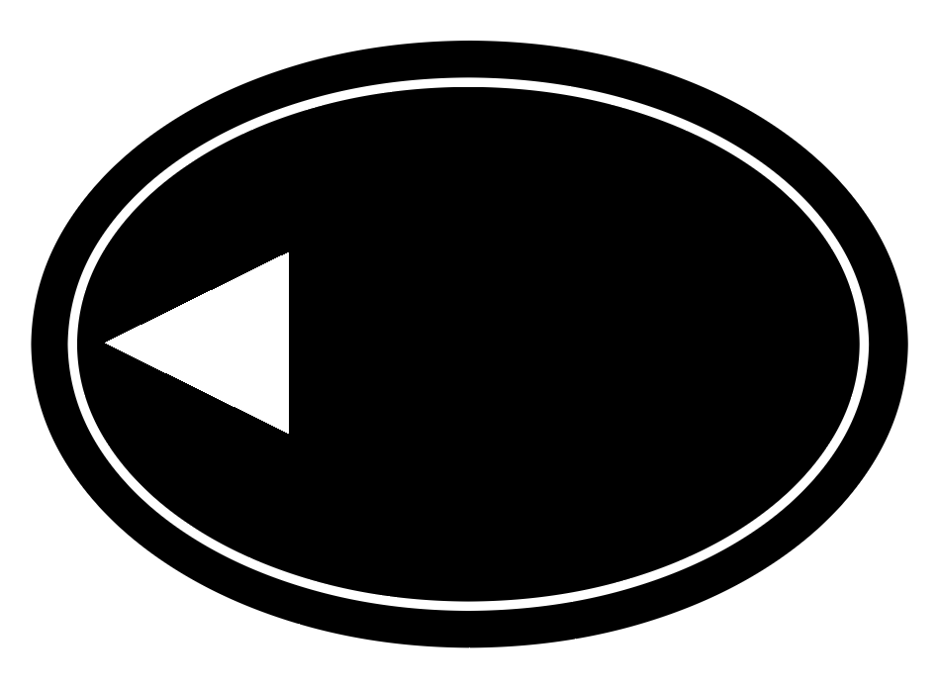
docs/user-guides/vario-user-manual/button-left-only.png
