DangerMonkeys/leaf/docs/user-guides/vario-user-manual/menu_images/GPSmenu.png

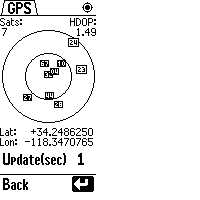
docs/user-guides/vario-user-manual/menu_images/GPSmenu.png
