DangerMonkeys/leaf/docs/user-guides/vario-user-manual/menu_images/MenuAltimeter.png

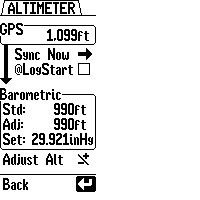
docs/user-guides/vario-user-manual/menu_images/MenuAltimeter.png
