DangerMonkeys/leaf/docs/user-guides/vario-user-manual/menu_images/MenuDisplay.png

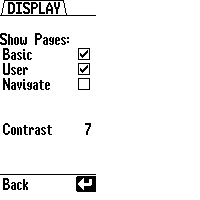
docs/user-guides/vario-user-manual/menu_images/MenuDisplay.png
