DangerMonkeys/leaf/docs/user-guides/vario-user-manual/menu_images/MenuLogTimer.png

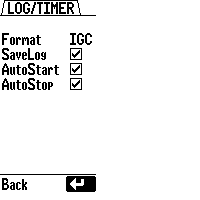
docs/user-guides/vario-user-manual/menu_images/MenuLogTimer.png
