DangerMonkeys/leaf/docs/user-guides/vario-user-manual/menu_images/MenuSystem.png

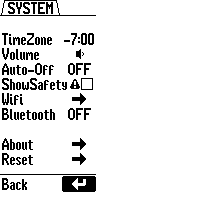
docs/user-guides/vario-user-manual/menu_images/MenuSystem.png
