DangerMonkeys/leaf/docs/user-guides/vario-user-manual/menu_images/MenuSystemAbout.png

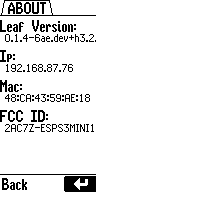
docs/user-guides/vario-user-manual/menu_images/MenuSystemAbout.png
