DangerMonkeys/leaf/docs/user-guides/vario-user-manual/menu_images/MenuUnits.png

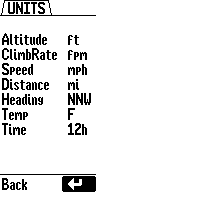
docs/user-guides/vario-user-manual/menu_images/MenuUnits.png
