DangerMonkeys/leaf/docs/user-guides/vario-user-manual/menu_images/MenuVario.png

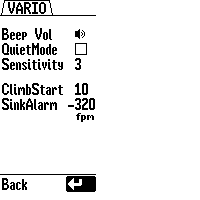
docs/user-guides/vario-user-manual/menu_images/MenuVario.png
