DangerMonkeys/leaf/docs/user-guides/vario-user-manual/menu_images/WifiPortal_screenshot.png

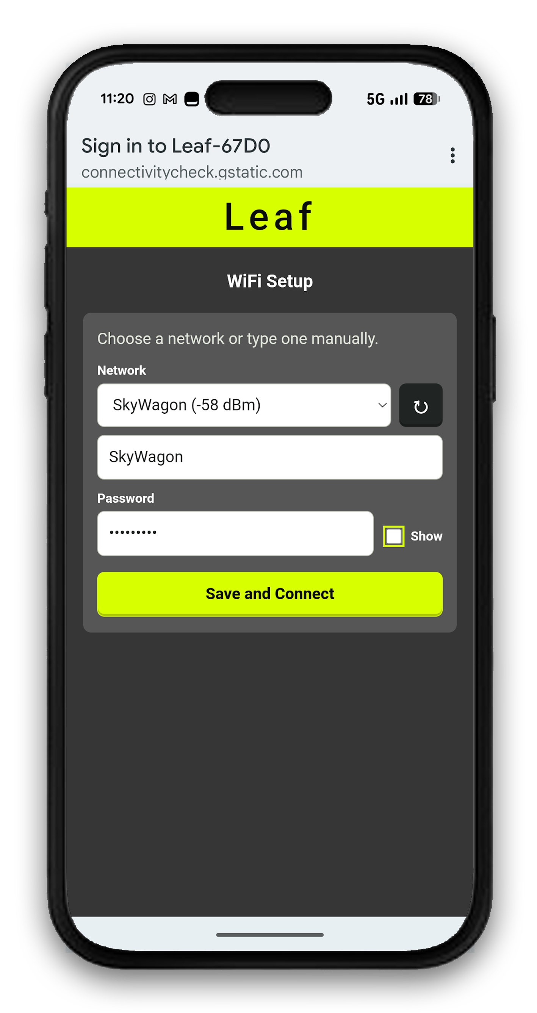
docs/user-guides/vario-user-manual/menu_images/WifiPortal_screenshot.png
