DangerMonkeys/leaf/docs/user-guides/vario-user-manual/menu_images/WifiSetup_leafScreenshot.png

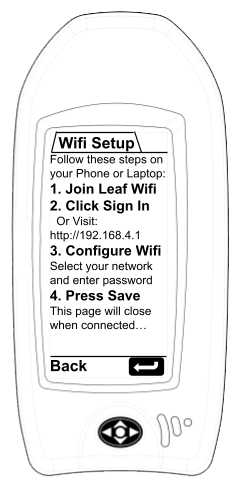
docs/user-guides/vario-user-manual/menu_images/WifiSetup_leafScreenshot.png
