DangerMonkeys/leaf/docs/user-guides/vario-user-manual/ResetButton.png

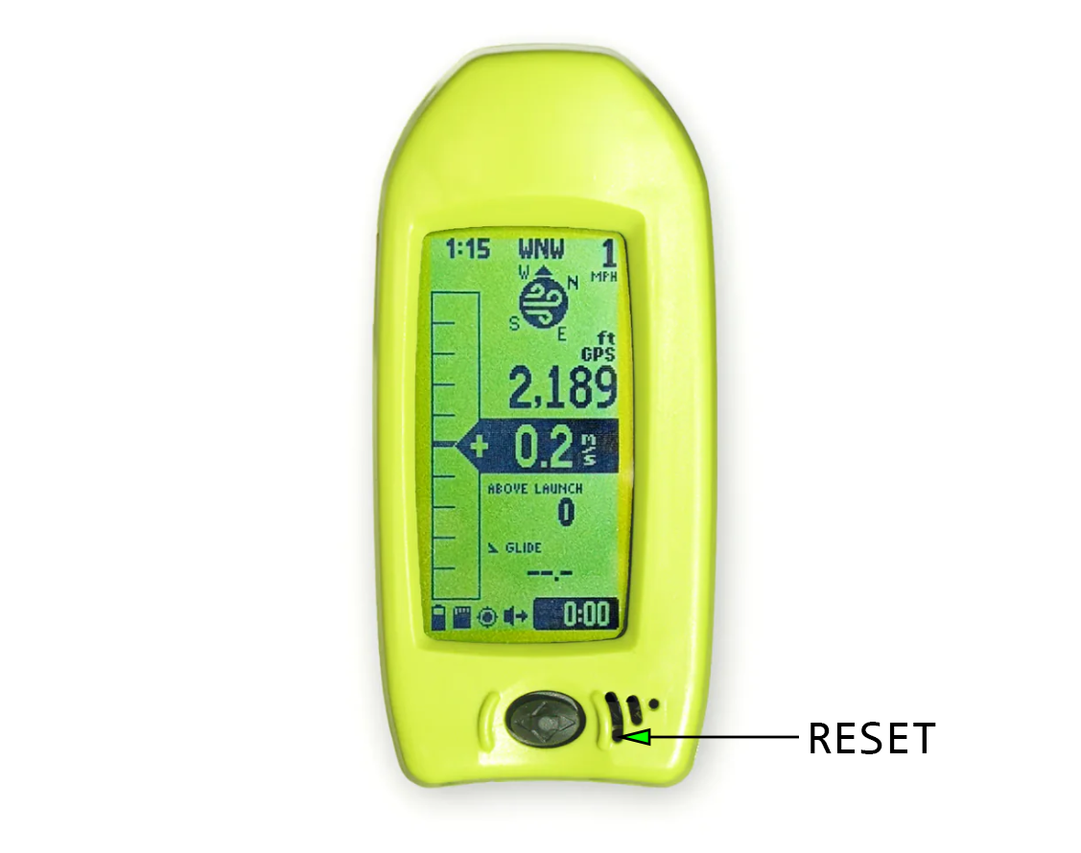
docs/user-guides/vario-user-manual/ResetButton.png
