DangerMonkeys/leaf/docs/user-guides/vario-user-manual/user-page.png

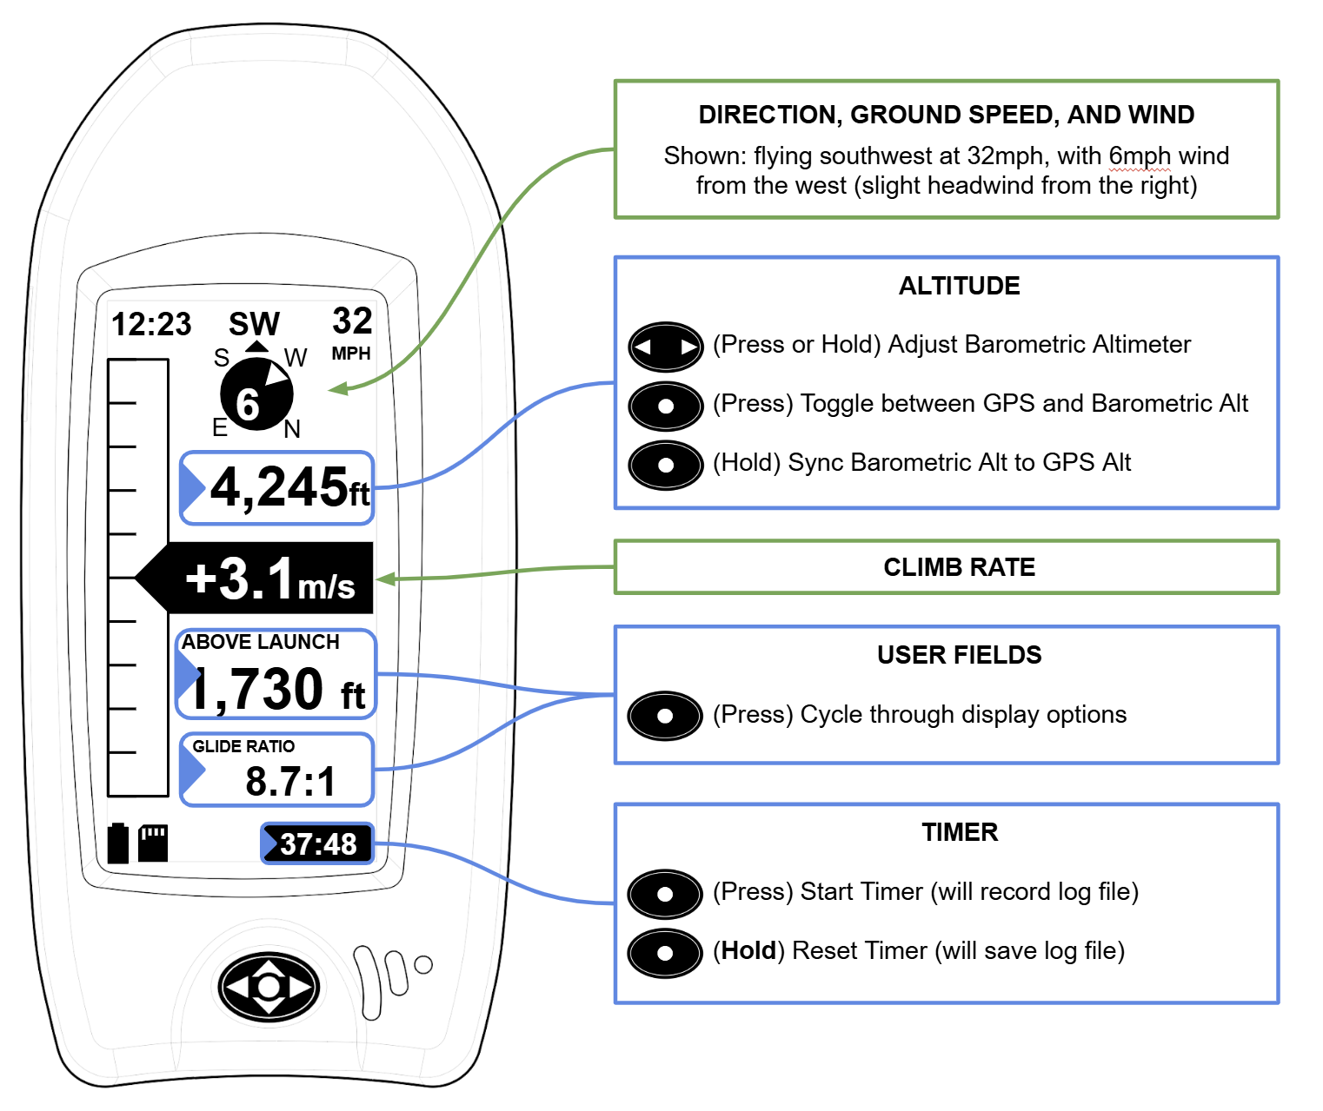
docs/user-guides/vario-user-manual/user-page.png
