DangerMonkeys/leaf/docs/user-guides/vario-user-manual/wifi-setup.png

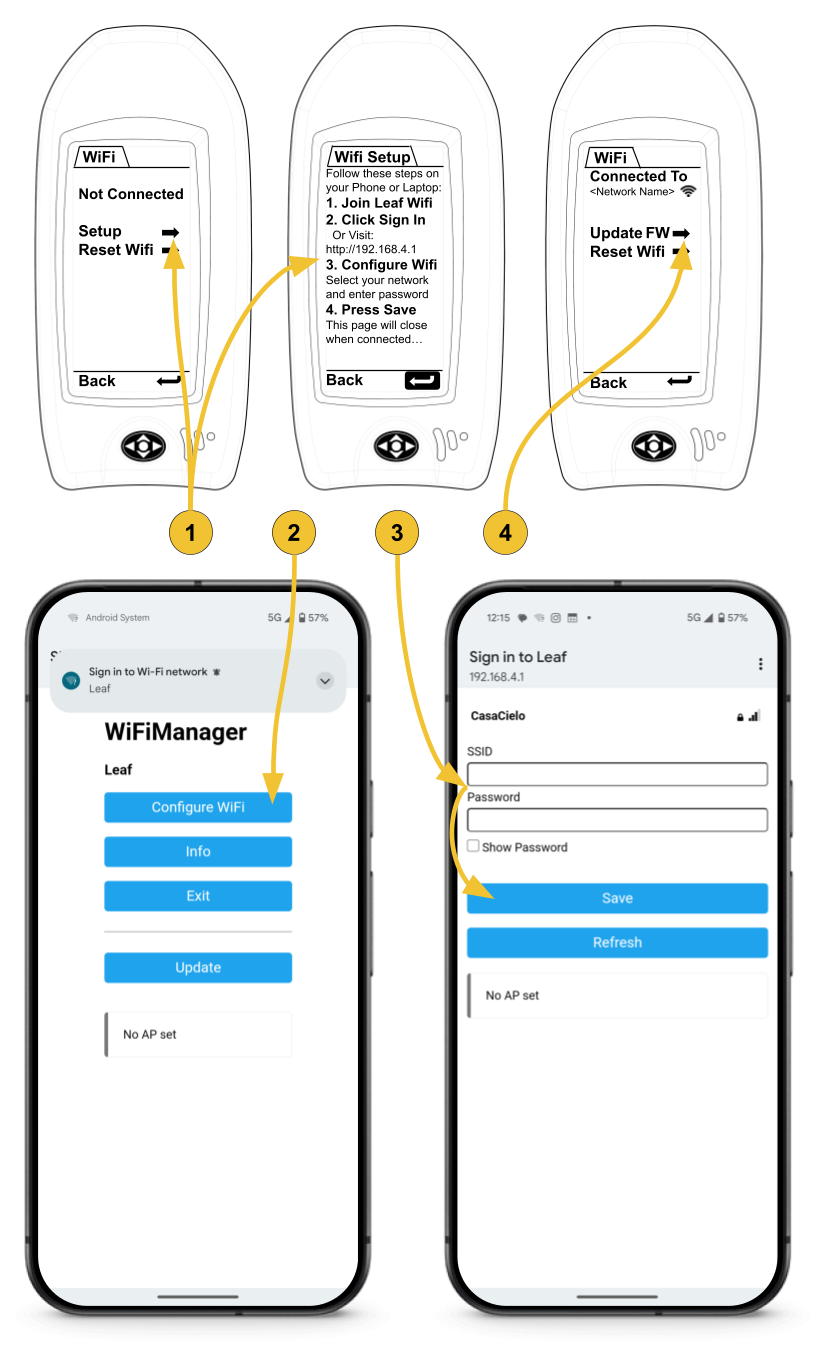
docs/user-guides/vario-user-manual/wifi-setup.png
