DangerMonkeys/leaf/docs/user-guides/test-pilot-page.md

---
title: Test Pilot Page
description: Helpful links and resources for test pilots
---



Thanks for being a test pilot!  Here are some helpful links:

## Leaf Manual
[User Manual Available Here](/user-manual/)

## Feedback Form
Let us know what you think! 

Fill out [this brief questionnaire](https://docs.google.com/forms/d/e/1FAIpQLScCz3XbxYCgQPGmazFjcjsg6wPizb-6Uk98m3w0qamMUfB78g/viewform?usp=dialog) 

## Contact Us!
[Email](mailto:leafvario@gmail.com) us!

Chat on our [Leaf Discord Server](https://discord.gg/m7nC8Dgbu6)

## Leaf Vario Website

[See more info here!](https://leafvario.com)
