DangerMonkeys/leaf/test-data/field-testing/2026-10-25-firmware-0.2.4-968/_motion-analysis/categorized-tracks.csv

path | unit | hardware | name | date | firmware | sha256 | n_b | n_gl | cause | end | duration | local_start | local_end | alt_start | alt_end | alt_range | max_speed | p95_speed | climb_p95 | sink_p05 | distance | max_gap | category | inferred_takeoff_PDT | inferred_touchdown_PDT
hardware-3.2.3/Racoon/tracks/2026-10-25-XLV-000-01.igc | Racoon | hardware-3.2.3 | 2026-10-25-XLV-000-01.igc | 251026 | v0.2.4-968 | ee0d055e29029cdf2779f8860169bde2ff429191d5a469db602b45a8cdce5d9d | 3875 | 3876 | AUTO | MANUAL | 3879.4 | 13:54:03 | 14:58:42 | 639 | 129 | 620 | 13.684 | 11.52 | 2.08 | -1.85 | 18867 | 1.26 | Flight-containing (inferred) | 14:04:10 | 14:39:35
hardware-3.2.3/RedStrap/tracks/2026-10-25-XLV-000-01.igc | RedStrap | hardware-3.2.3 | 2026-10-25-XLV-000-01.igc | 251026 | v0.2.4-968 | bbfb834743fd1b8bc70f3bf87ad9100a0e97eebe1e1106deaf331dd2bbea198a | 2302 | 2303 | AUTO | MANUAL | 2302.34 | 14:04:10 | 14:42:32 | 641 | 129 | 621 | 13.561 | 11.745 | 2.459 | -2.017 | 19073 | 1.209 | Flight-containing (inferred) | 14:04:10 | 14:39:35
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
