DangerMonkeys/leaf/test-data/field-testing/2026-10-25-firmware-0.2.4-968/_motion-analysis/vertical-confirm-replay.csv

id | ms | candidates | triggered | mean_speed_mps | mean_climb_mps | alt_change_m | displacement_m | valid
0 | 80857 | 0 | 0 | 0 | 0 | 0 | 0 | 0
0 | 81857 | 0 | 0 | 0 | 0 | 0 | 0 | 0
0 | 82857 | 0 | 0 | 0 | 0 | 0 | 0 | 0
0 | 83857 | 0 | 0 | 0.295798928 | 0.0216666665 | 0 | 0 | 3
0 | 84857 | 0 | 0 | 0.297520041 | -0.0116666667 | 0 | 0 | 3
0 | 85857 | 0 | 0 | 0.304389536 | -0.0516666658 | 0 | 0 | 3
0 | 86857 | 0 | 0 | 0.312965274 | 0.0150000006 | 0 | 0 | 3
0 | 87857 | 0 | 0 | 0.320676714 | 0.321666688 | 0 | 0 | 3
0 | 88857 | 0 | 0 | 0.324960828 | 0.411666691 | 0 | 0 | 3
0 | 89857 | 0 | 0 | 0.325817674 | 0.190000027 | 0 | 0 | 3
0 | 90857 | 0 | 0 | 0.344682753 | -0.0949999914 | 0 | 0 | 3
0 | 91857 | 0 | 0 | 0.354972124 | -0.0983333364 | 0 | 0 | 3
0 | 92857 | 0 | 0 | 0.335250199 | 0.103333332 | 0 | 0 | 3
0 | 93857 | 0 | 0 | 0.278662384 | 0.144999996 | 0 | 0 | 3
0 | 94857 | 0 | 0 | 0.21092838 | 0.13166666 | 0 | 0 | 3
0 | 95857 | 0 | 0 | 0.163773105 | 0.0599999987 | 0 | 0 | 3
0 | 96857 | 0 | 0 | 0.128620863 | -0.0100000007 | 0 | 0 | 3
0 | 97857 | 0 | 0 | 0.132904992 | -0.088333331 | 0 | 0 | 3
0 | 98857 | 0 | 0 | 0.161195174 | -0.0966666639 | 0 | 0 | 3
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
