DangerMonkeys/leaf/test-data/field-testing/2026-10-27/_analysis/replay-results.csv

id | ms | candidates | triggered | mean_speed_mps | mean_climb_mps | alt_change_m | displacement_m | valid
0 | 440978 | 0 | 0 | 0 | 0 | 0 | 0 | 0
0 | 441978 | 0 | 0 | 0 | 0 | 0 | 0 | 0
0 | 442978 | 0 | 0 | 0 | 0 | 0 | 0 | 0
0 | 443978 | 0 | 0 | 0.10977 | 0.0316666663 | 0.450012207 | 0.127201393 | 15
0 | 444978 | 0 | 0 | 0.088320002 | 0.0566666648 | 0.530029297 | 0.28861329 | 15
0 | 445978 | 0 | 0 | 0.0737366676 | 0.108333334 | 0.350036621 | 0.335621446 | 15
0 | 446978 | 0 | 0 | 0.0694500059 | 0.143333331 | 0.349975586 | 0.329282582 | 15
0 | 447978 | 0 | 0 | 0.0703083351 | 0.174999997 | 0.179992676 | 0.403332174 | 15
0 | 448978 | 0 | 0 | 0.0763100013 | 0.168333337 | -0.260009766 | 0.358549058 | 15
0 | 449978 | 0 | 0 | 0.0883166641 | 0.0966666639 | 0.0900268555 | 0.379565865 | 15
0 | 450978 | 0 | 0 | 0.103758335 | -0.088333331 | -0.710021973 | 0.433344603 | 15
0 | 451978 | 0 | 0 | 0.115773335 | -0.203333333 | -0.359985352 | 0.156152859 | 15
0 | 452978 | 0 | 0 | 0.121783331 | -0.275000006 | -2.22003174 | 0.138023958 | 15
0 | 453978 | 0 | 0 | 0.120066665 | -0.336666673 | -0.179992676 | 0.0529481545 | 15
0 | 454978 | 0 | 0 | 0.114050001 | -0.316666663 | 0.889953613 | 0.242900357 | 15
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
