DangerMonkeys/leaf/test-data/field-testing/2026-10-25-firmware-0.2.4-968/_motion-analysis/new-tracks-bowen.png

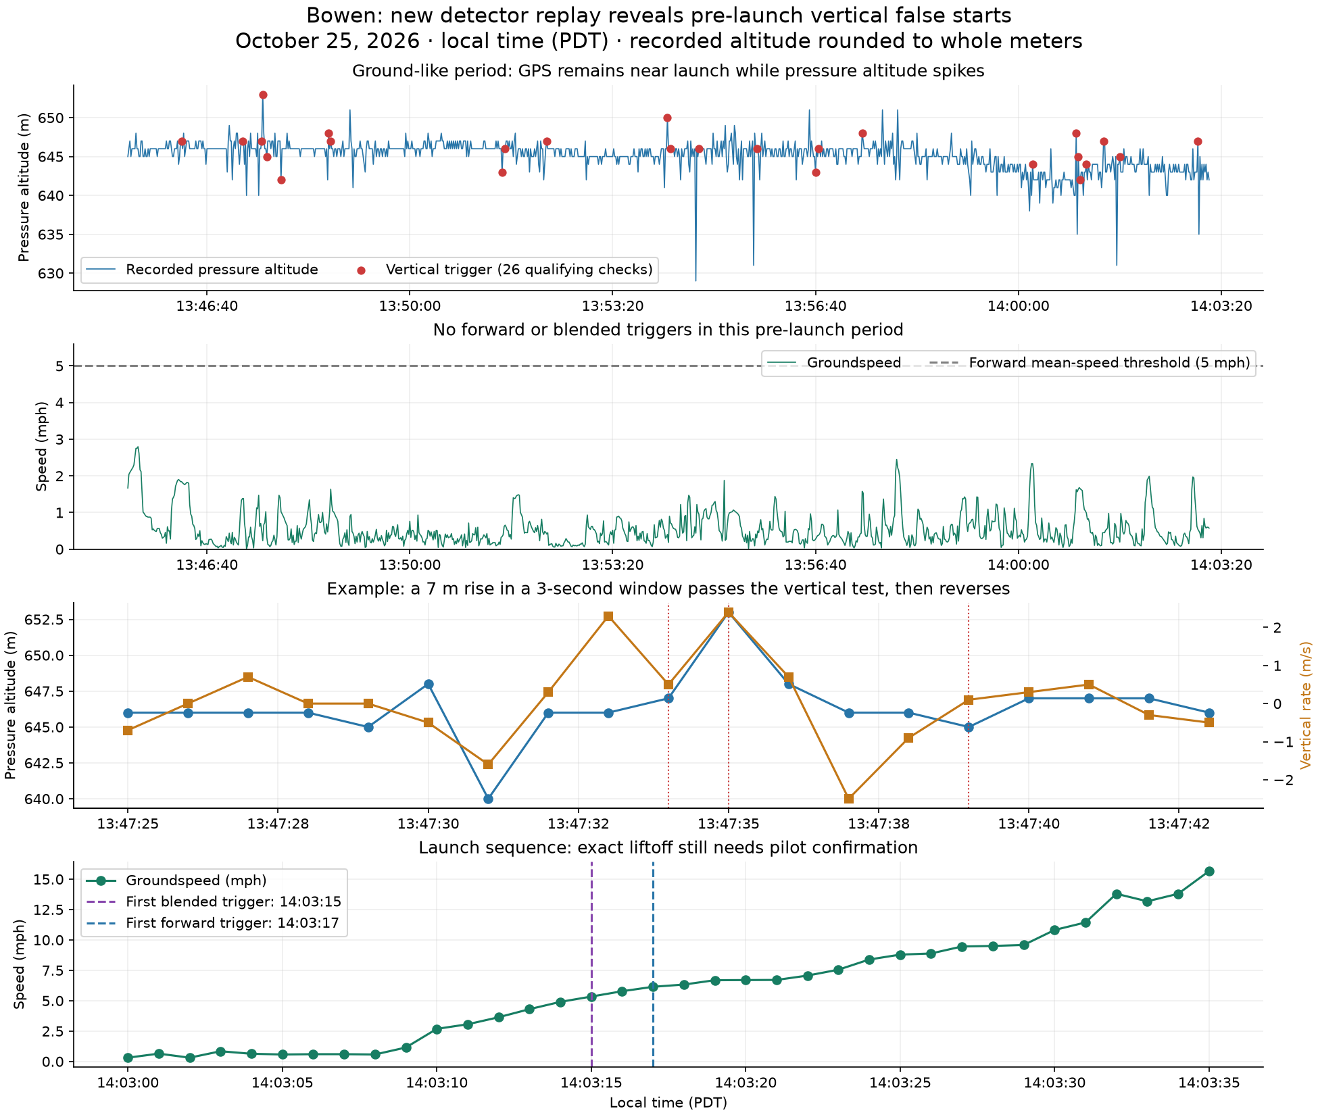
test-data/field-testing/2026-10-25-firmware-0.2.4-968/_motion-analysis/new-tracks-bowen.png
