DangerMonkeys/leaf/docs/ui-reviews/logbook-maintenance/index.html

# Logbook maintenance

Only changed/new screens. Native 96 × 192 captures rendered by the firmware in the simulator; display enlargement uses nearest-neighbor scaling. Click a screen for its native PNG.

## Logging settings

Repair Logs selected

Logging settings

## Checking logs

Manual maintenance

Checking logs

## Repairing logs

Recovery in progress

Repairing logs

## Repair complete

All affected logs recovered

Repair complete

## No problems found

Healthy logbook

No problems found

## Loading Flights

Opening and paging

Loading Flights

## Flight needs repair

Confirmed invalid/incomplete log

Flight needs repair

## Could not read flight

Temporary read failure

Could not read flight

## Some logs not repaired

Conflict preserved

Some logs not repaired

## Storage unavailable

Explicit failure

Storage unavailable

## Repair cancelled

Back / center cancellation

Repair cancelled

## Logs busy

Another storage transaction

Logs busy

## Flight timer running

Maintenance unavailable

Flight timer running
