DangerMonkeys/leaf/docs/ui-reviews/logbook-maintenance/01-maintenance-flow.png

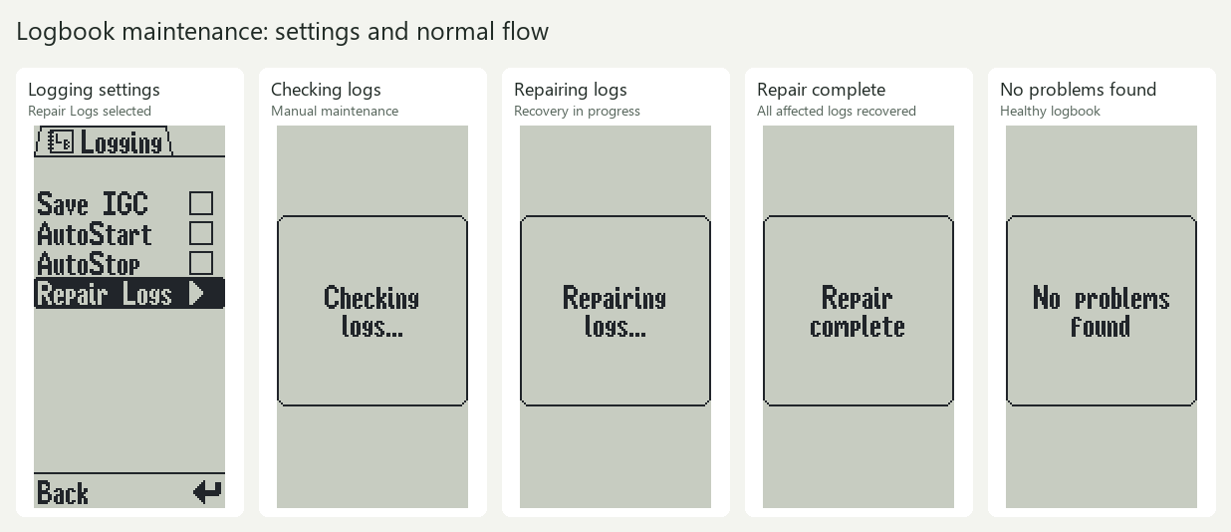
docs/ui-reviews/logbook-maintenance/01-maintenance-flow.png
