DangerMonkeys/leaf/(threads)

Thread 4 (2024-12-15):

Firmware Updates without Arduino IDE

oxothnk423, 2024-12-15:
Feature for end-users:

Need to create & test a method for uploading new firmware that does not require Arduino IDE etc.

Possible Candidates:
- put new firmware file on SD card
- wireless over the air (OTA) updates
- simple executable for Windows/Mac computers
- possibly mobile phone app via USB-C connection

scottyob, 2024-12-31:
@oxothnk423:  Worth closing this now https://github.com/DangerMonkeys/leaf/commit/47e0c28cac5e303f6f4cf75ab1a86d8cd76920e1 has it over WiFi?  Or want to keep the SD card option on the todo list too (as a P1?)

oxothnk423, 2024-12-31:
@scottyob I think we can close for now.  Thanks again!  Also, Just tried an update solely with my phone.. did manual wifi setup, connected to "leaf" with my phone, typed in credentials for my phone hotspot, hit "save" on the wifi manager page, and as soon as it said "trying to connect" I switched on my hotspot.  Worked like a charm!  So we can even update in the field easily too if needed, with just a phone and cell signal.  Perfect!

Perhaps I'll add a note to the SDcard Mass storage issue, that if we want at that point, we can enable SD card firmware updates.  Just so we don't lose the idea.

Closed 2024-12-31.

Thread 7 (2024-12-15):

Sleep Modes for Power Saving

oxothnk423, 2024-12-15:
Enable "light-sleep" on ESP32 when finished with tasks.

Notes:
* Investigate ability to keep speaker timer running during sleep (so vario sounds will still play)
* Light Sleep already supported in charging-mode.  Extending to operational mode should be fairly straightforward

Thread 8 (2024-12-15):

Bluetooth Support

oxothnk423, 2024-12-15:
Support Bluetooth data to host device.

Feature-request comment from user:

Most people want their varios to connect to their phones so that they can use them for waypoint type tasks/ starting comps. While this looks great for hike and fly I wouldn't be buying anything that doesn't support the XCTrack or FlySkyhigh via Bluetooth. The bottom of this page shows the sentence you need to support

https://xctrack.org/External_Devices.html

scottyob, 2025-03-12:
Can close when merge in https://github.com/DangerMonkeys/leaf/pull/91

Closed 2025-03-14.

Thread 18 (2024-12-22):

[Bug] Charging with audible vario makes terrible beep

scottyob, 2024-12-22:
If you set the Vario audio, then plug in the Leaf, I get a low pitched beep when it first comes up charging.  Holding down the D pad seems to initialize the device and makes the low tone go away.

oxothnk423, 2024-12-27:
I've noticed this too

I think this is an artifact of improper initialization ... either
(a) the altitude and climb filters aren't set up properly and need time to become accurate, or
(b) the initial pressure reading from the sensor is incorrect and several more samples are needed to "average out" the bad data point.
 (or something like that)

You can see this when the vario is first turned on -- the alt and climb rate are fluctuating for a moment before stabilizing.

A complete fix would be:
 1) fixing the boot up initialization issues so the vario starts at the proper altitude and with [near-]zero climbrate
   AND
 2) properly disabling the speaker in charge mode so that any future errors don't create funny sounds :)

oxothnk423, 2024-12-29:
Fixed.
   Boot sequence begins with altitudes assumed to be zero,
   then taking a pressure measurement,
   then calculating true altitude,
   then calculating climb rate (current altitude vs previous altitude)

   This resulted in a erroneous climb rate (comparing current altitude to zero).

   Quick solution without rearchitecting the baro initization sequence was to set a flag
`  bool firstClimbInitialization = true;`
 This allows us to skip the first climb rate calculation (assuming climb rate = 0), then set flag to false, and wait until the next altitude measurement so we have two true altitudes to compare for actual climbrate.

Closed 2024-12-29.

Thread 29 (2025-01-01):

[bug] Altitude adjustment appears "backwards" on display pages because you're adjusting the altimeter setting, not the height

oxothnk423, 2025-01-01:
change button directions when on the display page altitude MSL fields

oxothnk423, 2025-01-02:
Fixed.  Changed baro_adjustAltSetting() to use an int8_t argument instead of Button type argument.  This allows reversing the direction so altimeter changes work as expected depending if you're adjusting the altimeter setting or the actual altimeter height.

Closed 2025-01-02.

Thread 37 (2025-01-05):

[bug] holding buttons can lead to sequential actions being taken unexpectedly

oxothnk423, 2025-01-05:
..particularly when holding down CENTER to reset the timer, then the leaf will power off soon after

oxothnk423, 2025-01-06:
Fixed: After executing an action due to holding the center button (such as turning on, or resetting the timer), call buttons_lockAfterHold().  This prevents any future center-hold actions until user lets go of the center button.  Currently this is only implemented for the center button.  We can later generalize to all buttons if needed.

This function call is optional, because for some things (like scrolling through a list), we may want continued repeat actions while continuously holding a button.

Closed 2025-01-06.

Thread 48 (2025-01-10):

Fix Arduino artifacts

BenjaminPelletier, 2025-01-10:
#41 incidentally included removal of the Arduino CI check without properly removing Arduino support from the repository.  To fix this, the newly-incorrect documentation needs to be fixed and likely the src/libraries folder removed also.

scottyob, 2025-03-13:
Let's put "and likely the src/libraries folder removed also" in a "cleanup" task.  With Arduino support dropped I think we can close this bug?

Closed 2025-03-13.

Thread 60 (2025-01-31):

About screen doesn't show Mac in prod build

scottyob, 2025-01-31:
In prod release, mac address is all 0's unless you attempt a WiFi software update first.  Seems it needs to be enabled or initialized.

scottyob, 2025-03-14:
Was fixed to use e-fuse in #84

Thread 65 (2025-02-05):

[Bug] Timer Running without SD card creates repeated failure sounds

oxothnk423, 2025-02-05:
Without SD card, starting the timer results in repeated failure sounds (likely from kml/igc log files not being successfully created?)

This happens even if the "SAVE LOG" setting is "OFF".

I think we need to rearchitect the way we handle timers, flight-detection, and logging.

I think:
1 -- we need to auto-detect if we're flying, regardless of timer running or log setting.  This way, "flying things" can happen if someone launches without starting the timer or saving a log.  Things like: wind estimation, vario beeping turning on if Quiet Mode was enabled, etc.  Currently this is implemented with the bool flag "weAreFlying" which happens to use the timer auto-start logic to detect if we're flying or not.  It could be cleaner (maybe we should create a separate "flightManger.cpp" to make the logic more clear), but no immediate changes necessary I don't think.
2 -- we need to allow timer to run normally (solid, not blinking) even if no log is desired (SAVE LOG == OFF)
3 -- we need to allow timer to run with warning (blinking) if a log IS desired, but not possible (NO GPS FIX or NO SD CARD).

    2&3 above  were the conditions that caused unexpected repeated error sounds mentioned in this bug report.

Closed 2025-03-14.

Thread 71 (2025-02-13):

Bug - conflict with Serial debug messages and mass storage?

oxothnk423, 2025-02-13:
When first plugging leaf into USB, it will power up and show the charging screen... simultaneously it will begin initializing mass storage.

It seems that if you turn on Leaf at that point (which sends some serial debugging messages over USB due to the button pushes), it will conflict with the initialization of mass storage, and crash and reset the board.

If you instead wait for the mass storage drives to initialize, then turn on, you get working serial debug messages and no crash.

oxothnk423, 2025-02-15:
Fixed.  This was caused by a force re-mount of the SDCard whenever we changed PowerOnState (from example, from 'charging' -> 'PowerOn').  This meant when turning on shortly after plugging in to USB power, the SDMMC object was deleted and remounted right in the middle of setting up Mass Storage, which led to crash and reboot.

Now, the SDMMC object will only be renewed when there's a state change on the SD_DETECT pin.

Closed 2025-02-15.

Thread 89 (2025-03-02):

Mass Storage setup long delays on large SD cards

oxothnk423, 2025-03-02:
Moving from 1GB to 8GB SD cards: Mass Storage setup takes ~8 seconds instead of ~1 second.  This might be acceptable when plugging into USB for charging or interfacing with computer; but it's too long of a delay when just turning on from battery power (i.e., out in the field).

At minimum: only setup mass storage when turning on by USB power, not push-button

Better: only setup mass storage when turning on by USB power AND with data connection (i.e., so we don't experience the delay when just plugging into a power source like a backup battery or solar panel or "dumb" wall charger)

If possible: find a way to accelerate mass storage setup

scottyob, 2025-03-12:
Any idea what calls are blocking on the SD card?  We may be able to move that off to it's own task and make it more async.

For what it's worth.  I've not seen it take near this long on my large SD cards

scottyob, 2025-03-13:
Unable to reproduce.  will re-open if we see it again.

Closed 2025-03-13.

Thread 101 (2025-03-13):

[Cleanup][Libraries in Repo]

scottyob, 2025-03-13:
There are a bunch of libraries copied/pasted in our repo from old Arduino days.  PlatformIO takes care of this for us!  This needs to be cleaned up.

oxothnk423, 2025-03-18:
FYI the IMU library requires some tweaks to work properly in our configuration, so we should keep a copy of that one.

(line 29 has to be uncommented [here](https://github.com/DangerMonkeys/leaf/blob/496447968bb42eb7d9aa8aa69991e2e4c3ed5aef/src/libraries/SparkFun_9DoF_IMU_Breakout_-_ICM_20948_-_Arduino_Library/src/util/I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))

Thread 108 (2025-03-14):

OTA checks or attempts sometimes fail

BenjaminPelletier, 2025-03-14:
OTA updates now seem to be unreliable -- sometimes HTTPS queries work, but sometimes they don't.  To reproduce:

1. Check out commit at v0.0.10
2. Select leaf_3_2_5_dev environment
3. Build and upload firmware
4. Turn leaf on
5. Scroll to WiFi update
6. Select Update
7. Observe success (usually), but no update because v0.0.10 is current
8. Go back one screen
9. Repeat steps 6-8 until an error is observed (usually second try for me)

Note that continuing to repeat steps 6-8 will often yield another success again eventually.

When the failure occurs, I see something like this in the Serial monitor:

```
[114293][E][NetworkClient.cpp:323] setSocketOption(): fail on 0, errno: 9, "Bad file number"
[114367][E][ssl_client.cpp:36] _handle_error(): [start_ssl_client():302]: (-32512) SSL - Memory allocation failed
[114377][E][NetworkClientSecure.cpp:159] connect(): start_ssl_client: connect failed: -32512
[114386][E][NetworkClient.cpp:323] setSocketOption(): fail on 0, errno: 9, "Bad file number"
```

Even on success, I see something like this in the Serial monitor:

```
[ 22281][E][NetworkClient.cpp:323] setSocketOption(): fail on 0, errno: 9, "Bad file number"
```

**Alternate reproduction method**

1. Check out commit at v0.0.9
2. Select release environment
3. Build and upload firmware
4. Turn leaf on
5. Scroll to WiFi update
6. Select Update
7. Observe success; update takes a while but succeeds -- I've tried 3 times and gotten 3 successes here
8. Turn leaf on
9. Scroll to WiFi update
10. Select Update
11. Observe failure (usually) -- if success is observed, try again

This seems to suggest this bug was introduced between 0.0.9 and 0.0.10.

scottyob, 2025-03-16:
I found using the dev build on a 3.2.5 board, it wasn't "works on the first go", but, "never works" :(  Maybe #122 is a nice dirty enough hack to close this one out???

scottyob, 2025-03-16:
Also checked with my 3.2.3 boards on prod build.  Looks like v0.0.10 with BLE support totally broke the ability to do WiFi updates all together!  This is totally not a low pri bug :(

Thanks so much for finding this so quick, @BenjaminPelletier

Closed 2025-03-17.

Thread 111 (2025-03-15):

[Feature] Device IDs

scottyob, 2025-03-15:
- Currently we expose the e-fuse MAC address as an identifier
- We've allocated a prefix for Fanet unique addresses
- We've decided to do sequential 2-byte ID numbers for our Fanet IDs.

We need a way of allocating and flashing the device ID to the device before we can assure no Fanet ID collisions

Thread 120 (2025-03-16):

Power Latch Pin on boot / reboot

oxothnk423, 2025-03-16:
On certain occasions the ESP32 will restart (sometimes intentionally -- like during a WIFI firmware update; and sometimes unintentionally -- like during a crash).

In these cases, the power-latch pin stays high (latched), so the system is "on" and drawing power.  But because the center/power button is not being pressed, the boot-up state goes to the "charging page".  So, we're left seeing the charging page, while on battery power (and discharging).

First fix:  on startup, first forcibly set the power-latch pin to low, instead of floating, so that the system will truly turn off.  (if user is holding center button, then later in the startup routine the power-latch pin will be set high as expected).

Second fix: save a nvm flag on wifi updates, so that when the system reboots, that flag will allow a true startup back on "on/operating" state, as user would expect.  (even when not holding the center button).  Then of course clear the flag.

Closed 2025-03-16.

Thread 125 (2025-03-16):

Stopping Flight results in Crash

oxothnk423, 2025-03-16:
Even with GPS fix and SD card inserted, stopping flight results in crash.  Tested on 3.2.3hw.

scottyob, 2025-03-16:
On dev branch?  I'll try and re-create later but if you have a core dump to attach that'd be very useful!

oxothnk423, 2025-03-16:
Yes on Dev.  Is this enough (see below)?

button: CENTER state: HELD      hold count: 1
settinGuru Meditation Error: Core  1 panic'ed (LoadProhibited). Exception was unhandled.

Core  1 register dump:
PC      : 0x420320ba  PS      : 0x00060a30  A0      : 0x82006e6c  A1      : 0x3fcbf470
A2      : 0x00000000  A3      : 0x00000000  A4      : 0x00000002  A5      : 0x3fcbf4a4
A6      : 0x3fca9f40  A7      : 0x00000000  A8      : 0x82009e5c  A9      : 0x3fcbf440
A10     : 0x00000001  A11     : 0x00000001  A12     : 0x3fcd3b10  A13     : 0x00000000
A14     : 0x3fccbf60  A15     : 0x00000000  SAR     : 0x0000000a  EXCCAUSE: 0x0000001c
EXCVADDR: 0x0000015c  LBEG    : 0x40056f5c  LEND    : 0x40056f72  LCOUNT  : 0x00000000

Backtrace: 0x420320b7:0x3fcbf470 0x42006e69:0x3fcbf4a0 0x4200a1e1:0x3fcbf4d0 0x42017b11:0x3fcbf5b0 0x42006d59:0x3fcbf5d0 0x42012d78:0x3fcbf5f0 0x42012e23:0x3fcbf610 0x42012e70:0x3fcbf630 0x4205e32c:0x3fcbf650 0x403849a2:0x3fcbf670

ELF file SHA256: 644ef70db

Rebooting...

scottyob, 2025-03-16:
Not easily.  I was able to reproduce so have a core dump, but it's probably worth trying to see if you can get this running on your computer:  https://leafvario.com/dev-references/core-dumps/

Closed 2025-03-16.

Thread 130 (2025-03-17):

Charge screen broken

BenjaminPelletier, 2025-03-17:
Merging #122 seems to have broken the charge screen -- the screen is blank immediately after firmware upload, though the unit will turn on and looks normal (after cursory look) after that.  The squashed commit for #129 (c89d4e5f74e8f6e412ac657ba9467eedd337216f) appears to work (charge screen visible) but the next squashed commit for #122 (8a4b4570fe59e568803fe06ea465609ed213cc7c) appears not to work.

To reproduce:
1. Check out c89d4e5f74e8f6e412ac657ba9467eedd337216f
2. Build and upload leaf_3_2_3_dev
3. Observe charge screen
4. Check out 8a4b4570fe59e568803fe06ea465609ed213cc7c
5. Build and upload leaf_3_2_3_dev
6. Observe blank screen

oxothnk423, 2025-03-17:
@scottyob , why'd you add [this line](https://github.com/DangerMonkeys/leaf/blob/f06f6744fcb2ffd0cf88a0ede13fa3a8e6ff9f60/src/vario/power.cpp#L205)?

This will keep the unit resetting constantly, no?   We should keep separate (1) the command to unlatch power and (2) restarting.

Closed 2025-03-17.

Thread 136 (2025-03-17):

Stop beeping when not wanted (Menu, OTA, etc)

oxothnk423, 2025-03-17:
Noticed when performing OTA update, the vario beeping function can get stuck and play unwelcome continuous beeps.  At least when performing an update, we should call speaker_mute() or baro_sleep() to avoid unwanted beeps.

Perhaps we should stop all beeping when in the menu in general, since user input beeps (system sound effects from buttons) could be heard more clearly and vario beeps are unlikely to be desired anyway.

Thread 141 (2025-03-18):

Add "warning: auto-off" dialog when vario is about to auto-turn off from inactivity

oxothnk423, 2025-03-18:
Only applies when system_autoOff setting is enabled.

Dialog should pop up when vario starts playing the "auto-off" beeps (counting down 5 seconds til turn-off).

Pressing any button should dismiss the dialog if shown, as well as if the autoOffCounter is reset (from GPS speed or altitude change being above 'inactive' thresholds).

Thread 151 (2025-04-14):

Occasional Bogus Climb Rate

scottyob, 2025-04-14:
We've seen a couple of instances of bogus climb rates reported, that sustains until the device is rebooted.  Sometimes it shows as -40m/s sink, sometimes a very high lift.

## Observations:
* Not based on duration of flight.  Happened to me (Scott) with Fanet device after maybe 1 hour 15 minutes of flight time
* Happened to Non-Fanet variant after only 15 minutes.
* Reboot seems to get it back into a good state.

https://github.com/user-attachments/assets/533b1921-b461-48bb-95b4-8bce8e9fe397

scottyob, 2025-09-02:
Captured a debug log event of this happening:  https://gist.github.com/scottyob/2f9a6d059ac28d4038a78c2d8abd5600

Thread 153 (2025-04-28):

SD card mount failure if not formatted

oxothnk423, 2025-04-28:
Currently, if a non-formatted SD card is present when booting up, the display will show a valid SD card present (boot-up init only checks for the physical presence, not a successful mount)

However, if you eject and reinsert the SD card, then the display will properly show 'NO SD Card' icon because the mount failed due to improper format.

-> change boot-up init to also check for successful mount before saying SD is present.
-> also consider enabling "format if mount fails" option; but this may risk losing user data if the card fails to mount for a different reason.

BenjaminPelletier, 2025-07-31:
There also appears to be no indication that anything is wrong in general when a non-formatted SD card is present; it seems like there should definitely be an indication if the SD card is "present" but unusable.

Thread 212 (2025-08-26):

Ambient Temperature Incorrect

oxothnk423, 2025-08-26:
Ambient Temperature Reads abnormally high.  Seen on at least 2 devices, running v0.1.0 with cherry-picked flight summary speed fix.

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

Thread 220 (2025-09-02):

[Crash][In-Flight] newSentence encountered in the middle of the line of text

scottyob, 2025-09-02:
Firmware version: 0.1.0-713d.dev+h3.2.6
Error: newSentence encountered in the middle of the line of text '$GPGSV,3,1,11,10,67,309,17,27,52,280,18,23,50,042,23,46,46,191,28,1*6B1*52'

Backtrace: 0x4200E3B3:0x3FCC1050 0x4200E832:0x3FCC1070 0x42010EB1:0x3FCC12C0 0x42011711:0x3FCC14A0 0x42011725:0x3FCC14C0 0x42015455:0x3FCC14E0 0x4201566B:0x3FCC1520 0x420156B5:0x3FCC1540 0x4200F7A2:0x3FCC1570 0x42018B07:0x3FCC1680 0x42018B69:0x3FCC16A0 0x42015196:0x3FCC16E0 0x4206CF14:0x3FCC1700 0x40384D82:0x3FCC1720

```
[info] Decoding 28 unique addresses...
0x4200e3b3: getBacktrace(char*, unsigned int) at /homes-local/scott/Documents/leaf/src/vario/diagnostics/fatal_error.cpp:83
0x3fcc1050: ?? ??:0
0x4200e832: fatalError(char const*, ...) at /homes-local/scott/Documents/leaf/src/vario/diagnostics/fatal_error.cpp:189
0x3fcc1070: ?? ??:0
0x42010eb1: LeafGPS::on_receive(GpsMessage const&) at /homes-local/scott/Documents/leaf/src/vario/instruments/gps.cpp:127 (discriminator 1)
0x3fcc12c0: ?? ??:0
0x42011711: bool etl::message_router<LeafGPS, GpsMessage>::receive_message_type<GpsMessage>(etl::imessage const&) at /homes-local/scott/Documents/leaf/.pio/libdeps/leaf_3_2_6_dev/Embedded Template Library/include/etl/message_router.h:519
0x3fcc14a0: ?? ??:0
0x42011725: etl::message_router<LeafGPS, GpsMessage>::receive(etl::imessage const&) at /homes-local/scott/Documents/leaf/.pio/libdeps/leaf_3_2_6_dev/Embedded Template Library/include/etl/message_router.h:450
0x3fcc14c0: ?? ??:0
0x42015455: etl::imessage_bus::receive(unsigned char, etl::imessage const&) at /homes-local/scott/Documents/leaf/.pio/libdeps/leaf_3_2_6_dev/Embedded Template Library/include/etl/message_bus.h:177
0x3fcc14e0: ?? ??:0
0x4201566b: etl::imessage_bus::receive(etl::imessage const&) at /homes-local/scott/Documents/leaf/.pio/libdeps/leaf_3_2_6_dev/Embedded Template Library/include/etl/message_bus.h:149
 (inlined by) MessageBus<(unsigned char)11>::Locked::receive(etl::imessage const&) at /homes-local/scott/Documents/leaf/src/vario/dispatch/message_bus.h:47
0x3fcc1520: ?? ??:0
0x420156b5: MessageBus<(unsigned char)11>::receive(etl::imessage const&) at /homes-local/scott/Documents/leaf/src/vario/dispatch/message_bus.h:65
0x3fcc1540: ?? ??:0
0x4200f7a2: LC86G::readLine() at /homes-local/scott/Documents/leaf/src/vario/hardware/lc86g.cpp:94 (discriminator 4)
0x3fcc1570: ?? ??:0
0x42018b07: TaskManager::updateWhileOn() at /homes-local/scott/Documents/leaf/src/vario/taskman.cpp:229
0x3fcc1680: ?? ??:0
0x42018b69: TaskManager::update() at /homes-local/scott/Documents/leaf/src/vario/taskman.cpp:141
0x3fcc16a0: ?? ??:0
0x42015196: loop() at /homes-local/scott/Documents/leaf/src/vario/main.cpp:117
0x3fcc16e0: ?? ??:0
0x4206cf14: loopTask(void*) at /home/scott/.platformio/packages/framework-arduinoespressif32/cores/esp32/main.cpp:74
0x3fcc1700: ?? ??:0
0x40384d82: vPortTaskWrapper at /home/runner/work/esp32-arduino-lib-builder/esp32-arduino-lib-builder/esp-idf/components/freertos/FreeRTOS-Kernel/portable/xtensa/port.c:139
0x3fcc1720: ?? ??:0
 *  Terminal will be reused by tasks, press any key to close it.
```

BenjaminPelletier, 2025-09-02:
This error is triggered when there is inconsistent GPS data.  NMEA sentences are supposed to be terminated with line breaks, so a line of text is the primitive unit of data collected by leaf before processing.  During processing, the parser reports that the NMEA sentence is finished before we reach the line break.  This means the sentence is invalid, and we can confirm this by seeing that the sentence in question has two checksums.

My guess for what happened is that the system was interrupted from processing just after the last character of the NMEA sentence arrived in the buffer, and then didn't start back up until near the end of the next sentence from the GPS module.  So, the line break and entire first part of the next (and maybe more) sentences are missing.

What we do about this depends on what assumption we want to make about the validity of an NMEA sentence that isn't terminated with a line break as required by the NMEA standard.  If we assume omitting the CRLF is ok, then we can accept the sentence found mid-line and discard the rest of the line.  If we require more strict adherence to the NMEA standard, we can discard the entire line as invalid.

scottyob, 2025-09-02:
I vote for assuming it's corrupt, chucking it away on an exception, and assuming a good update will follow.

Thread 223 (2025-09-02):

[Performance] SD Card writes can back up runloops

scottyob, 2025-09-02:
* Created some telemetry for measuring IO time in the runloop:  https://github.com/scottyob/leaf/tree/file_io_telemetry

Findings:

 I added some telemetry to figure out how long some operations are taking.

Looking at the temp/humidity runtime, not much variance:

```
[scott@sob-desktop buslogs]$ {   echo "p0,p1,p5,p10,p50,p75,p90,p95,p99,p100";   grep -iE "^a" BusLog_2080-01-05_1659-2.log     | datamash -t,         min 4 perc:1 4 perc:5 4 perc:10 4 perc:50 4         perc:75 4 perc:90 4 perc:95 4 perc:99 4 perc:100 4; }
p0,p1,p5,p10,p50,p75,p90,p95,p99,p100
224,225,225,225,227,228,229,229,230,244
```

Looking at the FileWrite operations, a lot more:
```
[scott@sob-desktop buslogs]$ {   echo "p0,p1,p5,p10,p50,p75,p90,p95,p99,p100";   grep -iE "^#F" BusLog_2080-01-05_1659-2.log     | datamash -H -t,         min 2 perc:1 2 perc:5 2 perc:10 2 perc:50 2         perc:75 2 perc:90 2 perc:95 2 perc:99 2 perc:100 2; }
p0,p1,p5,p10,p50,p75,p90,p95,p99,p100
min(FileWriteTimeTakenUs(us)),perc:1(FileWriteTimeTakenUs(us)),perc:5(FileWriteTimeTakenUs(us)),perc:10(FileWriteTimeTakenUs(us)),perc:50(FileWriteTimeTakenUs(us)),perc:75(FileWriteTimeTakenUs(us)),perc:90(FileWriteTimeTakenUs(us)),perc:95(FileWriteTimeTakenUs(us)),perc:99(FileWriteTimeTakenUs(us)),perc:100(FileWriteTimeTakenUs(us))
22,25,25,26,149,155,394,417,515,939882
[scott@sob-desktop buslogs]$
```

The almost 1 second backup, was in writing the kalman record to the SD card:

```
M275187,A,0.976807,-0.0637207,0.192383,Q,0.54735,-0.321952,0.691105
#F275189,441
#275215,baro mb*100,101248
#F275216,150
P275215,101248
#F275216,27
#275238,kalman,6.52884845,-0.03414665,-0.03046155
#F276178,939882
M275237,A,0.976318,-0.0690918,0.19165,Q,0.547392,-0.321948,0.691093
#F276178,396
#276181,baro mb*100,101241
#F276181,146
P276180,101241
#F276181,34
```

To prevent the timing backlogs, we should move all File IO writes to their own thread.

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

scottyob, 2025-09-03:
Might be worth checking out some of the queues ETL provides:  https://www.etlcpp.com/concurrent_queues.html

Considering for the duration of my test, the P99 was 515us, I'm thinking it very rare that these multi-ms blocking events occur I'm thinking we would just accept the bus log as a lossy format, and, if we have to skip a few writes, perhaps we just log a counter on how many records were skipped?

I've not noticed it "backing up" on my igc logged flights over the past few months that has a different throughput, so think if we end up undersizing the buffer and skipping too many records to be useful, a move from ASCII to a binary file format for this log would be a huge, huge reduction in bytes written.

BenjaminPelletier, 2025-09-04:
> I'm thinking we would just accept the bus log as a lossy format

One of the key purposes of the bus log is to investigate behavior, and one of the most interesting places to investigate behavior is when things might back up.  This is exactly the time we wouldn't want to drop log entries.  Also, there are many debugging activities where the presence or absence of a log entry is the key piece of information -- if log entries might not exist for other reasons, this debugging approach is effectively impossible, or at least potentially very frustrating.  Also, the bus log is not the only thing we write to the SD card as mentioned above -- it would not be ok to drop GPS track or logbook SD card writes, yet we still want to immunize ourselves from long SD card writes for this data as well.  So, I don't think we would want to accept any observable write loss.

> a move from ASCII to a binary file format for this log would be a huge, huge reduction in bytes written

A big reduction in bytes written could easily be achieved by turning off [what are effectively debug messages](https://github.com/DangerMonkeys/leaf/blob/main/src/vario/logging/telemetry.h) -- KALMAN, GPS, and BARO duplicate data from the actual sensors and/or simply print computed state.  These three message types accounted for 41% of the bytes in the 8/29 bus logs.  The three remaining messages accounting for nearly all the remaining bytes are the motion message (M) at 27% of bytes, the GPS message (G) at 20% of bytes, and the pressure message (P) at 11% of bytes.

The G message's main payload is effectively already in binary -- it's reporting the raw bytes received from the GPS module and those aren't going to get smaller unless we applied some kind of compression.  The G message has three bytes of overhead (message type, comma, \n) plus timestamp per message.  8/29 timestamps averaged 6.5 bytes per timestamp.  In binary, presumably the timestamp would be a 4-byte unsigned long, so on net I think a binary format would save 3.5 bytes/G message which would reduce the bytes used for G messages by about 5%.

The M message would presumably be binary-coded with 1 byte for message type, 4 bytes for timestamp, 1 byte for validity flags, and 6*4 bytes for 6 float values = 30 bytes, versus 70 bytes on average from the 8/29 data.

The P message would presumably be binary-coded with 1 byte for message type, 4 bytes for timestamp, and 4 bytes for value = 9 bytes, versus 15 bytes on average from the 8/29 data.

With these three effects (G, M, P messages), I estimate we would reduce our byte usage by about 36% relative to today's text for the high-volume messages by switching to binary.  That's not tiny, but I don't think I would really consider it huge, huge.  And, with binary, we lose the ability to perform human-readability sanity checks (scroll to a particular place in the log and generally understand what's happening without writing code, be able to tell if things are reasonable at a glance), reduce error tolerance (\n is no longer a value reserved for termination of messages, for instance), and perform any kind of examination of the log without writing non-trivial code.

For our later reference, here's what I counted in the 8/29 logs:

| Message type | Fraction of log | Message count | Bytes per message |
|---|---|---|---|
| M | 26.5% | 382276 | 70.3 |
| baro mb*100 | 19.9% | 748160 | 27.0 |
| G | 19.8% | 302797 | 66.2 |
| kalman | 19.3% | 382276 | 51.1 |
| P | 11.1% | 748160 | 15.0 |
| gps | 2.2% | 39994 | 56.8 |
| fanet_rx | 0.6% | 7357 | 87.3 |
| A | 0.6% | 19998 | 28.5 |
| V | 0.0% | 9 | 22.1 |

> I've not noticed it "backing up" on my igc logged flights over the past few months that has a different throughput

Presumably the back up frequency is probably close to (IGC throughput) / (full-log throughput), right?  So, there are probably ~10x fewer back ups with 10x less throughput.

> Might be worth checking out some of the queues ETL provides

I would expect we would see best results by writing to a single large block of memory space rather than have each write operation be a queue element -- this would allow many write operations to be flushed to the SD card at once, which is also a more efficient way to perform the SD writes.  I don't think I'm seeing an ETL tool that does this in that queue list; perhaps they have something else that could accomplish this?

Thread 237 (2025-09-19):

Switch to HW-calibrated battery voltage

oxothnk423, 2025-09-19:
As part of [https://github.com/DangerMonkeys/leaf/pull/236](url), we now have a HW-calibrated battery voltage from the ADC.  But before we use it, we should test many units and see if the HW-calibrated value is more consistent than the manually-developed ADC curve.

If so, switch to using the HW-calibrated value, and also adjust the battery thresholds for "full" and "empty" etc.

Thread 243 (2025-09-21):

Put SX1262 radio to sleep when not in use

oxothnk423, 2025-09-21:
I noticed power consumption is higher than it used to be (even when "off" and charging).

I think the FANET Radio/SX1262 might be part of the cause?

We should put the module to sleep when not being used.  I think this requires three adjustments:

1) put it to sleep when we shut down all the peripherals to enter charge mode
https://github.com/DangerMonkeys/leaf/blob/bc8159f2d27e21d2dd438512bc537941ac198fe7/src/vario/power.cpp#L163

2) wake it up if needed when we wake all the peripherals
https://github.com/DangerMonkeys/leaf/blob/bc8159f2d27e21d2dd438512bc537941ac198fe7/src/vario/power.cpp#L177

3) sleep/wake the module when the user changes their FANET settings to ON (a valid region) or OFF
https://github.com/DangerMonkeys/leaf/blob/bc8159f2d27e21d2dd438512bc537941ac198fe7/src/vario/ui/display/pages/fanet/page_fanet.cpp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

scottyob, 2025-10-01:
This is going to need a lot more testing.  Currently the radio is put into a sleep mode, only to come out of it when a flight has started.

I'd love if there's a way to test the consumption the power on this chip.

https://github.com/DangerMonkeys/leaf/blob/main/src/vario/comms/fanet_radio.cpp#L308-L309
