DangerMonkeys/leaf/vario/hardware/Schematic_Leaf-Vario-v3.2.8_2026-10-24.pdf

## POWER TURN ON / LATCH

BATTERY CHARGE | POWER 3.3V REG

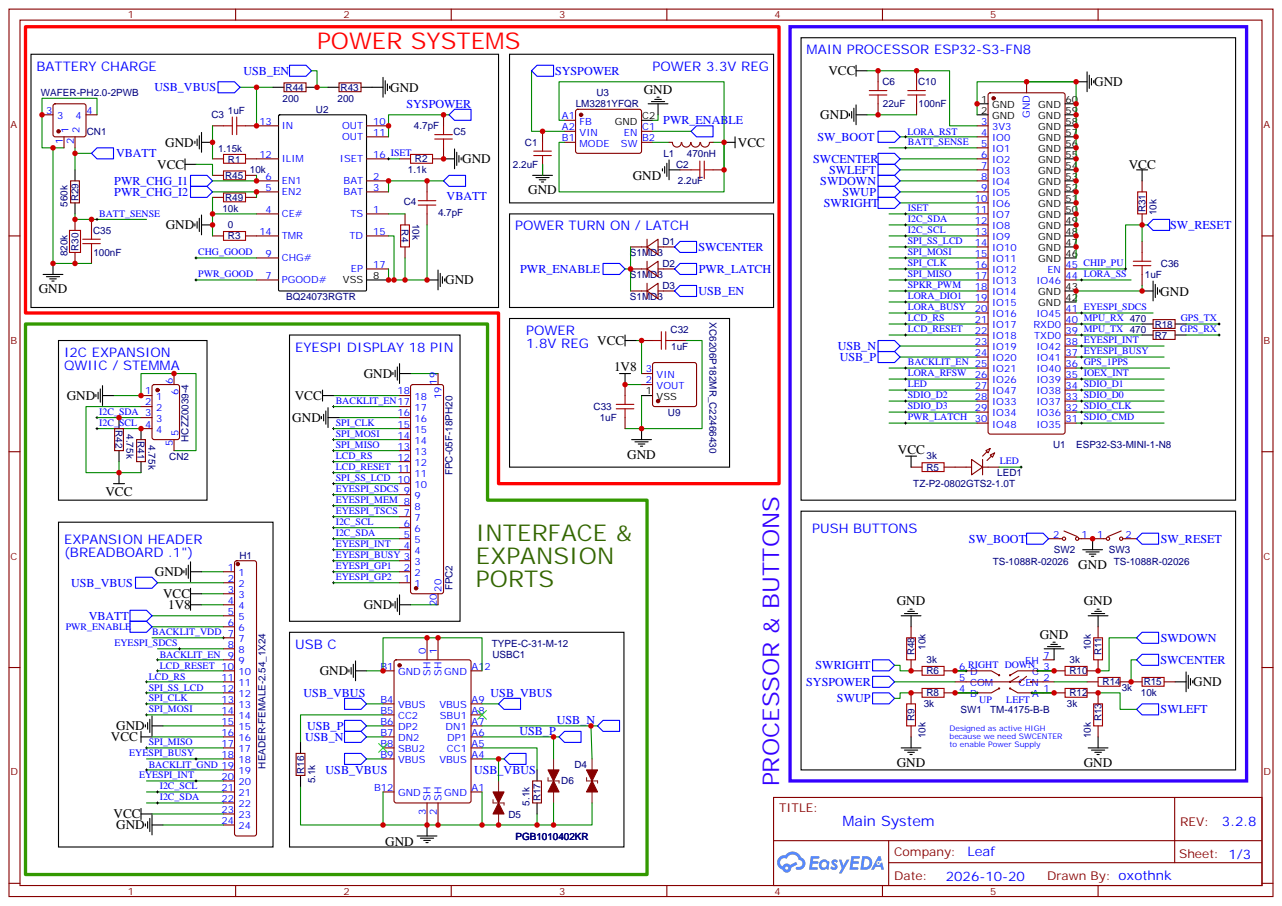
[picture p37: page 1]

Designed as active HIGH
because we need SWCENTER
to enable Power Supply

## GPS BACKUP SUPPLY

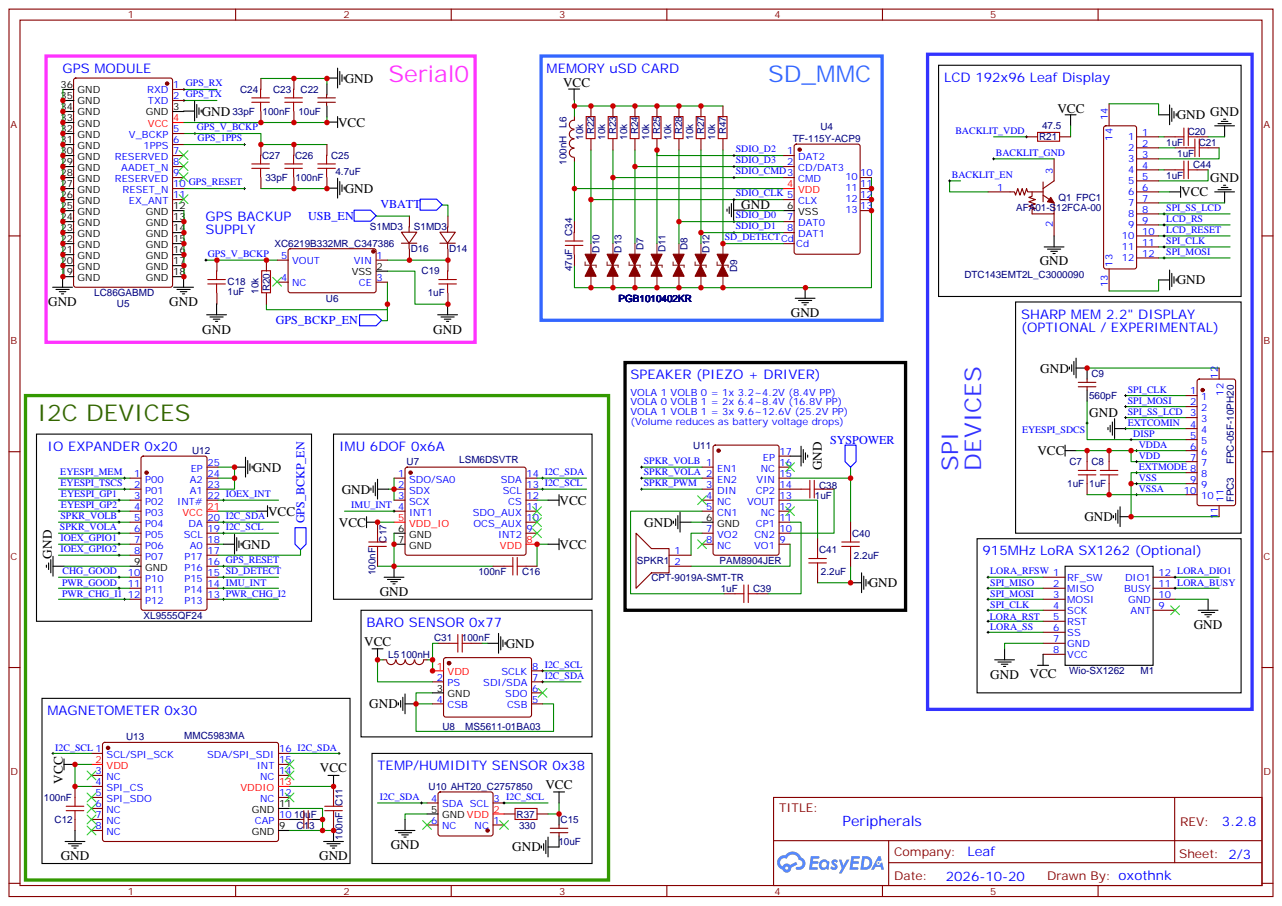
[picture p38: page 2]

GPS MODULE
GND 18 GND 19 GND 20 GND 21 GND 22 GND 23 GND 24 GND 25 GND 26 GND 27 GND 28 GND 29 GND 30 GND 31 GND 32 GND 33 GND 34 GND 35 GND 36

SPEAKER (PIEZO + DRIVER)
VOLA 1 VOLB 0 = 1x 3.2~4.2V (8.4V PP)
VOLA 0 VOLB 1 = 2x 6.4~8.4V (16.8V PP)
VOLA 1 VOLB 1 = 3x 9.6~12.6V (25.2V PP)
(Volume reduces as battery voltage drops)
CN2 10 CP1 11 NC 12 VOUT 13 CP2 14 VIN 15 NC 16 EP 17

CAP 10 GND 11 NC 12 VDDIO 13 NC 14 INT 15 SDA/SPI_SDI 16

## PROCESSOR

## MAIN 3.3V

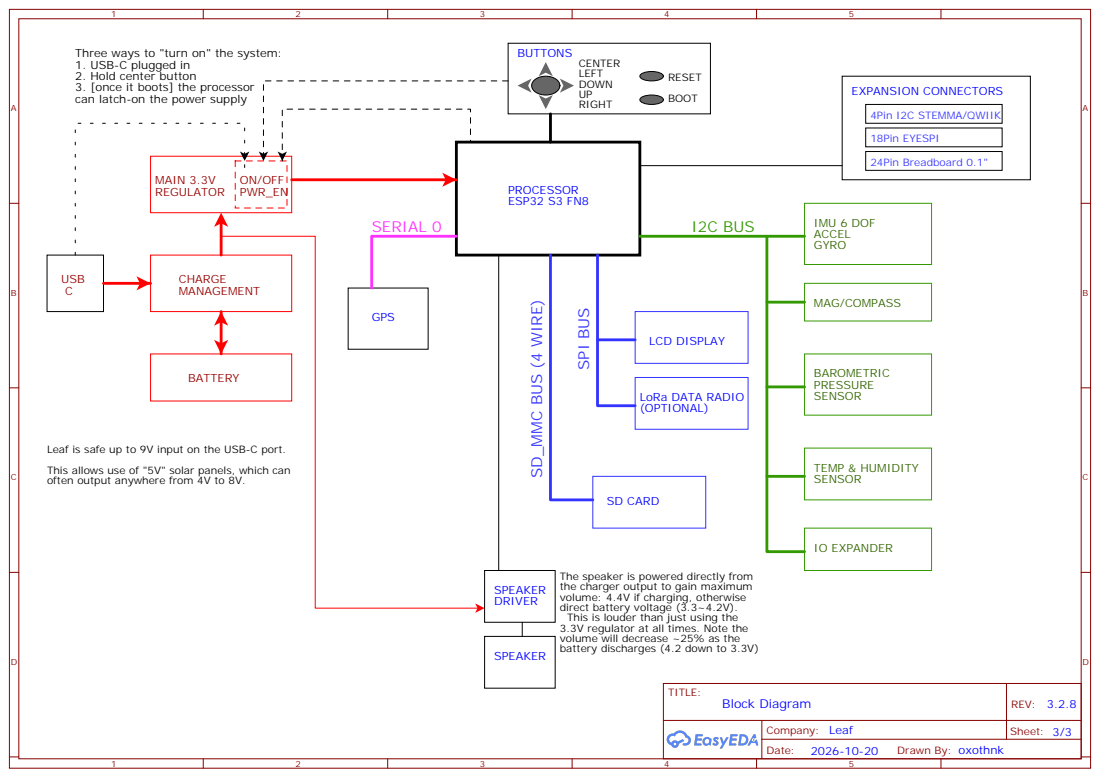
[picture p39: page 3]

Three ways to "turn on" the system:
1. USB-C plugged in
2. Hold center button
3. [once it boots] the processor
can latch-on the power supply

Leaf is safe up to 9V input on the USB-C port.
This allows use of "5V" solar panels, which can
often output anywhere from 4V to 8V.

The speaker is powered directly from
the charger output to gain maximum
volume: 4.4V if charging, otherwise
direct battery voltage (3.3~4.2V).
This is louder than just using the
3.3V regulator at all times. Note the
volume will decrease ~25% as the
battery discharges (4.2 down to 3.3V)
