DangerMonkeys/leaf/src/vario/vario.ino

// includes
#include <Arduino.h>
#include <HardwareSerial.h>

#include "IMU.h"
#include "Leaf_SPI.h"
#include "SDcard.h"
#include "baro.h"
#include "buttons.h"
#include "display.h"
#include "gps.h"
#include "log.h"
#include "power.h"
#include "settings.h"
#include "speaker.h"
#include "tempRH.h"
#include "wind_estimate/wind_estimate.h"

  #ifdef DEBUG_WIFI
    #include <WiFi.h>
    #include "DebugWebserver.h"
  #endif

#define DEBUG_MAIN_LOOP false

// Pinout for ESP32 Leaf V2
#define AVAIL_GPIO_0 0    // unused, broken out to header
#define AVAIL_GPIO_21 21  // unused, broken out to header (also used as LCD backlight if desired)
#define AVAIL_GPIO_39 39  // unused, broken out to header

// Main system event/task timer
hw_timer_t *task_timer = NULL;
#define TASK_TIMER_FREQ 1000  // run at 1000Hz
#define TASK_TIMER_LENGTH 10  // trigger the ISR every 10ms
void onTaskTimer(void);

// Standby system timer (when on USB power and charging battery, but otherwise "off" (i.e., soft
// off))
hw_timer_t *charge_timer = NULL;
#define CHARGE_TIMER_FREQ 1000   // run at 1000Hz
#define CHARGE_TIMER_LENGTH 500  // trigger the ISR every 500ms
void onChargeTimer(void);

// let the ISR timer set this to 1 so we're on proper timing cycle each time
char chargeman_doTasks = 0;  
// track micros() for how long we should sleep in charge mode between actions
uint64_t sleepChargeTimeStamp =0;

// Counters for system task timer
char counter_10ms_block = 0;
char counter_100ms_block = 0;
// track micros() for how long we should sleep in between task frames
uint64_t sleepTasksTimeStamp =0;

// flag if the GPS serial port is done sending data for awhile
bool gps_is_quiet = 0;

// Trackers for Task Manager Queue.  Default to tasks being needed, so they execute upon startup
char taskman_setTasks = 1;  // the task of setting tasks -- usually set by timer-driven interrupt

char taskman_buttons = 1;  // poll & process buttons
char taskman_baro = 1;     // (1) preprocess on-chip ADC pressure, (2) read pressure and preprocess
                        // on-chip ADC temperature, (3) read temp and calulate true Alt, (4) filter
                        // Alt, update climb, and store values etc
char taskman_imu = 1;      // read sensors and update values
char taskman_gps = 1;      // process any NMEA strings and update values
char taskman_display = 1;  // update display
char taskman_power = 1;    // check battery, check auto-turn-off, etc
char taskman_log = 1;      // check auto-start, increment timers, update log file, etc
char taskman_tempRH = 1;   // (1) trigger temp & humidity measurements, (2) process values and save
char taskman_SDCard = 1;   // check if SD card state has changed and attempt remount if needed
char taskman_estimateWind = 1;  // estimate wind speed and direction
char taskman_speakerSample = 1;

// temp testing stuff
// uint8_t display_page = 0;
uint8_t display_do_tracker = 1;
#define TESTING_LOOP false

/////////////////////////////////////////////////
//             SETUP              ///////////////
/////////////////////////////////////////////////
void setup() {

  // Start USB Serial Debugging Port
  Serial.begin(115200);
  delay(200);
  Serial.println("Starting Setup");

    #ifdef DEBUG_WIFI
      // Start WiFi
      WiFi.begin();
      WiFi.onEvent([](WiFiEvent_t event, WiFiEventInfo_t info) {
        Serial.println("WiFi Event " + WiFi.localIP().toString() + ": " + event);
      });
    #endif
    #ifdef DEBUG_WIFI
      // Start WebServer
      webserver_setup();
    #endif

  // turn on and handle all device initialization
  power_bootUp();

  // Start Main System Timer for Interrupt Events (this will tell Main Loop to set tasks every
  // interrupt cycle)
  task_timer = timerBegin(TASK_TIMER_FREQ);
  timerAttachInterrupt(
      task_timer,
      &onTaskTimer);  // timer, ISR call          NOTE: timerDetachInterrupt() does the opposite
  timerAlarm(task_timer,
             TASK_TIMER_LENGTH,
             true,
             0);  // auto reload timer ever time we've counted a sample length

  // Start Charge System Timer for Interrupt Events (this will tell Main Loop to do tasks every
  // interrupt cycle)
  charge_timer = timerBegin(CHARGE_TIMER_FREQ);
  timerAttachInterrupt(
      charge_timer,
      &onChargeTimer);  // timer, ISR call          NOTE: timerDetachInterrupt() does the opposite
  timerAlarm(charge_timer,
             CHARGE_TIMER_LENGTH,
             true,
             0);  // auto reload timer ever time we've counted a sample length

  // All done!
  Serial.println("Finished Setup");

  // Serial.println("Testing SD Card");
  // SDcard_test();
}

// Main Timer Interrupt
void IRAM_ATTR onTaskTimer() {
  sleepTasksTimeStamp = micros();
  // do stuff every alarm cycle (default 10ms)
  taskman_setTasks = 1;  // next time through main loop, set tasks to do!
  // wakeup();  // go back to main loop and keep processing stuff that needs doing!
}

// Charge Timer Interrupt
void IRAM_ATTR onChargeTimer() {
  sleepChargeTimeStamp = micros();
  // do stuff every alarm cycle (default 10ms)
  chargeman_doTasks = 1;  // next time through main loop, set tasks to do!
  // wakeup();  // go back to main loop and keep processing stuff that needs doing!
}

/////////////////////////////////////////////////
// Main Loop for Processing Tasks ///////////////
/////////////////////////////////////////////////
/*
The main loop perioritizes processesing any data in the serial buffer so as not to miss any NMEA GPS
characters. When the serial buffer is empty, the main loop will move on to processing any other
remaining tasks.

The gps serial port is considered 'quiet' if we received the last character of the last NMEA
sentence.  We shouldn't expect more sentences for awhile (~1 second GPS updates) If the serial port
is quiet, and all tasks are done, then the processor will go to sleep for the remainder of the 10ms
time block. Every 10ms, driven by an interrupt timer, the system will wake up, set flags for which
tasks are needed, and then return to running the main loop.

TODO: In addition to the timer-driven interrupt, we may consider also setting wake-up interrupts for
the pushbuttons, the GPS 1PPS signal, and perhaps others.
*/

// LOOP NOTES:
// when re-entering POWER_ON state, be sure to start from tasks #1, so baro ADC can be re-prepped
// before reading

void loop() {

  #ifdef DEBUG_WIFI
    webserver_loop();
  #endif
  
  if (power.onState == POWER_ON)
    main_ON_loop();
  else if (power.onState == POWER_OFF_USB)
    main_CHARGE_loop();
  else
    Serial.print("FAILED MAIN LOOP HANDLER");
}

bool allowSleepThisCycle = false;

void main_CHARGE_loop() {
  if (chargeman_doTasks) {
    allowSleepThisCycle = true;
    
    // Display Charging Page
    display_setPage(page_charging);
    display_update();  // update display based on battery charge state etc

    // Check SD Card State and remount if card was inserted
    SDcard_update();

    // update battery level and charge state 
    power_readBatteryState();

    // Check Buttons (user can turn ON from charging state)
    auto buttonPushed = buttons_update(); 
 
    // Prep to end this cycle and sleep
    chargeman_doTasks = 0;  // done with tasks this timer cycle

    if (buttonPushed == Button::NONE) {

      // don't go right back to sleep when waking, 
      // wait for new charge timer int cycle
      allowSleepThisCycle = false; 

      goToSleep();
    }  
  }
}

// uint32_t millisBegin;
void main_ON_loop() {
  if (taskman_setTasks) {  // check flag set by timer interrupt.  We only do this once every 10ms
    // millisBegin = millis();   // save the timestamp when we enter this 10ms block... we'll need
    // to be done within 10ms! Serial.println(millisBegin);
    setTasks();            // set necessary tasks for this 10ms block
    taskman_setTasks = 0;  // we don't need to do this again until the next 10ms timer interrupt

    allowSleepThisCycle = true;
  }

  // do necessary tasks
  taskManager();

  // GPS Serial Buffer Read
  // stop reading if buffer returns empty, OR, if our 10ms time block is up (because main timer
  // interrupt fired and set setTasks to true)
  bool gps_buffer_full = true;
  while (gps_buffer_full && !taskman_setTasks) {
    gps_buffer_full = gps_read_buffer_once();
  }

  // Go to sleep until next 10ms timer block
  // IF no more GPS characters, ECO_MODE is on, and we 
  //   didn't overrun our time block and setTasks has been called again
  if (!gps_buffer_full
      // && ECO_MODE 
      && !taskman_setTasks
      && allowSleepThisCycle) {

    // don't go right back to sleep when waking, 
    // wait for new task timer int cycle
    allowSleepThisCycle = false; 
      
    goToSleep();
  } 
  // else, run this loop again and keep processing the serial buffer until we're done with all the
  // NMEA sentences this cycle

  // TODO: if gps serial buffer can fill while processor is sleeping, then we don't need to wait for
  // serial port to be quiet
}

void goToSleep() {
  // don't sleep if speaker playing
  if (speaker_currentlyPlaying()) return;

  // Set Wake-up if button pushes, especially while in charge mode    
    // TODO: we probably only need to wake up with center button
    esp_sleep_enable_ext0_wakeup((gpio_num_t)BUTTON_PIN_CENTER, HIGH);
    esp_sleep_enable_ext0_wakeup((gpio_num_t)BUTTON_PIN_LEFT, HIGH);
    esp_sleep_enable_ext0_wakeup((gpio_num_t)BUTTON_PIN_RIGHT, HIGH);
    esp_sleep_enable_ext0_wakeup((gpio_num_t)BUTTON_PIN_UP, HIGH);
    esp_sleep_enable_ext0_wakeup((gpio_num_t)BUTTON_PIN_DOWN, HIGH);

  // Set wake up with timer
    uint64_t sleepTimeStamp;
    // get frame length depending on which state we're in
      uint32_t frameLength;
      if (power.onState == POWER_ON) {
        frameLength = TASK_TIMER_LENGTH * 1000; // uS frame length power on state
        sleepTimeStamp = sleepTasksTimeStamp;
      } else if (power.onState == POWER_OFF_USB) {
        frameLength = CHARGE_TIMER_LENGTH * 1000; // uS frame length charge state
        sleepTimeStamp = sleepChargeTimeStamp;
      }

    // calculate how long should we sleep for
      uint64_t microsNow = micros();
      //sleep until just 250uS before the next frame will start 
        //TODO: maybe shrink this with testing
      int64_t sleepMicros = sleepTimeStamp + frameLength - microsNow - 250;

      // cap sleep length to avoid sleeping too long 
      // in case of any math errors or micros() rollover etc
        if (sleepMicros <= 0) {
          Serial.println("** NEGATIVE SLEEP **");
          //sleepMicros = frameLength - 500;
          return;
        } else if (sleepMicros > frameLength) {
          Serial.println("** OVERRUN SLEEP **");
          //sleepMicros = frameLength - 500;
          return;
        }

      // finally, set timer duration
        esp_sleep_enable_timer_wakeup(sleepMicros);  // set timer to wake up

  // sleep for real if ECO_MODE is set, otherwise 'fake sleep' using delay
  if (ECO_MODE) {
    esp_light_sleep_start();
  } else {
    Serial.print("10ms #: ");
    Serial.print((uint8_t)counter_10ms_block);
    Serial.print("  100ms #: ");
    Serial.print((uint8_t)counter_100ms_block);
    Serial.print(" tasks uS: ");
    Serial.print(microsNow - sleepTimeStamp);
    Serial.print(" sleep uS: ");
    Serial.println(sleepMicros);

    Serial.print("timeStamp:    ");
    Serial.println(sleepTimeStamp);
    Serial.print("microsNow:    ");
    Serial.println(microsNow);
    Serial.print("sleepMicros:  ");
    Serial.println(sleepMicros);

    // use delay instead of actual sleep to test sleep logic
    // (allows us to serial print during 'fake sleep' and also
    // re-program over USB mid-'fake sleep')
    delayMicroseconds(sleepMicros);  
  }
} 





bool doBaroTemp = true;  // flag to track when to update temp reading from Baro Sensor (we can do
                         // temp every ~1 sec, even though we're doing pressure every 50ms)
bool baro_startNewCycle =
    false;  // flag to track when Baro should start over processing a new pressure measurement

void setTasks(void) {
  // increment time counters
  if (++counter_10ms_block >= 10) {
    counter_10ms_block = 0;  // every 10 periods of 10ms, go back to 0 (100ms total)
    if (++counter_100ms_block >= 10) {
      counter_100ms_block = 0;  // every 10 periods of 100ms, go back to 0 (1sec total)
    }
  }

  // tasks to complete every 10ms
  taskman_buttons = 1;
  taskman_baro = 1;
  taskman_speakerSample = 1;

  // set additional tasks to complete, broken down into 10ms block cycles.  (embedded if()
  // statements allow for tasks every second, spaced out on different 100ms blocks)
  switch (counter_10ms_block) {
    case 0:
      baro_startNewCycle = true;  // begin updating baro every 50ms on the 0th and 5th blocks
      // taskman_baro = 0;  // begin updating baro every 50ms on the 0th and 5th blocks
      break;
    case 1:
      // taskman_baro = 1;        
      break;
    case 2:
      // taskman_baro = 2;
      taskman_estimateWind = 1;  // estimate wind speed and direction
      break;
    case 3:
      // taskman_baro = 3;
      break;
    case 4:
      taskman_imu = 1;  // update accel every 100ms during the 4th block
      break;
    case 5:
      baro_startNewCycle = true;  // begin updating baro every 50ms on the 0th and 5th blocks
      // taskman_baro = 0;  // begin updating baro every 50ms on the 0th and 5th blocks
      break;
    case 6:
      // taskman_baro = 1;
      break;
    case 7:
      // taskman_baro = 2;
      break;
    case 8:
      // taskman_baro = 3
      break;
    case 9:

      // Tasks every second complete here in the 9th 10ms block.  Pick a unique 100ms block for each
      // task to space things out

      if (counter_100ms_block == 0 || counter_100ms_block == 5)
        taskman_gps = 1;  // gps update every half second (this avoids any aliasing issues if we
                          // keep trying to update GPS in the middle of an NMEA sentence string)
      if (counter_100ms_block == 1) taskman_power = 1;  // every second: power checks
      if (counter_100ms_block == 2) taskman_log = 1;    // every second: logging
      if (counter_100ms_block == 3 || counter_100ms_block == 8)
        taskman_display = 1;  // Update LCD every half-second on the 3rd and 8th 100ms blocks
      if (counter_100ms_block == 4)
        taskman_tempRH = 1;  // trigger the start of a new temp & humidity measurement
      // 5 - gps
      if (counter_100ms_block == 6)
        taskman_SDCard = 1;  // check if SD card state has changed and remount if needed
      // 7 - available
      // 8 - LCD
      if (counter_100ms_block == 9)
        taskman_tempRH = 2;  // read and process temp & humidity measurement
      break;
  }
}

uint32_t taskman_timeStamp = 0;
uint8_t taskman_didSomeTasks = 0;
uint8_t speakerCounter = 0;

void handleSpeaker() {
  speakerCounter++;
  if (speakerCounter >= 4) {
    speakerCounter = 0;
    onSpeakerTimerSample();
  }
}


// execute necessary tasks while we're awake and have things to do
void taskManager(void) {
  // just for capturing start time of taskmanager loop
  if (taskman_buttons && DEBUG_MAIN_LOOP) {
    taskman_timeStamp = micros();
    taskman_didSomeTasks = 1;
  }
  // Trying a version where we update speaker note using main task timer, 
  // rather than a separate speaker timer
  if (taskman_speakerSample) {
    handleSpeaker();
    taskman_speakerSample = 0;
  }

  // Do Baro first, because the ADC prep & read cycle is time dependent (must have >9ms between prep
  // & read).  If other tasks delay the start of the baro prep step by >1ms, then next cycle when we
  // read ADC, the Baro won't be ready.
  if (taskman_baro) {
    baro_update(baro_startNewCycle, doBaroTemp);
    taskman_baro = 0;
    baro_startNewCycle = false;
  }
  if (taskman_buttons) {
    buttons_update();
    taskman_buttons = 0;
  }
  if (taskman_estimateWind) {
    estimateWind();
    taskman_estimateWind = 0;
  }
  if (taskman_imu) {
    imu_update();
    taskman_imu = 0;
  }
  if (taskman_gps) {
    gps_update();
    taskman_gps = 0;
  }
  if (taskman_power) {
    power_update();
    taskman_power = 0;
  }
  if (taskman_log) {
    log_update();
    taskman_log = 0;
  }
  if (taskman_display) {
    display_update();
    taskman_display = 0;
  }
  if (taskman_tempRH) {
    tempRH_update(taskman_tempRH);
    taskman_tempRH = 0;
  }
  if (taskman_SDCard) {
    SDcard_update();
    taskman_SDCard = 0;
  }

  if (taskman_didSomeTasks && DEBUG_MAIN_LOOP) {
    taskman_didSomeTasks = 0;
    taskman_timeStamp = micros() - taskman_timeStamp;
    Serial.print("10ms: ");
    Serial.print((uint8_t)counter_10ms_block);
    Serial.print(" 100ms: ");
    Serial.print((uint8_t)counter_100ms_block);
    Serial.print(" taskTime: ");
    Serial.println(taskman_timeStamp);
  }
}
