DangerMonkeys/leaf/src/vario/main.cpp

#include "Arduino.h"
#include "comms/ble.h"
#include "comms/fanet_radio.h"
#include "comms/udp_message_server.h"
#include "diagnostics/boot_diagnostics.h"
#include "diagnostics/buttons.h"
#include "diagnostics/heap_monitor.h"
#include "dispatch/message_bus.h"
#include "hardware/Leaf_SPI.h"
#include "hardware/aht20.h"
#include "hardware/buttons.h"
#include "hardware/configuration.h"
#include "hardware/lc86g.h"
#include "hardware/motion_sensor.h"
#include "hardware/ms5611.h"
#include "instruments/ambient.h"
#include "instruments/baro.h"
#include "instruments/gps.h"
#include "instruments/imu.h"
#include "logging/buslog.h"
#include "power.h"
#include "system/shutdown_guard.h"
#include "taskman.h"
#include "ui/audio/sound_effects.h"
#include "ui/audio/speaker.h"
#include "ui/input/button_dispatcher.h"
#include "ui/settings/settings.h"
#include "wind_estimate/wind_estimate.h"

#ifdef RUN_EMBEDDED_TESTS
#include "tests/tests.h"
#endif

// MAIN Module
// initializes the system.  Responsible for setting up resources with
// as much dynamic memory as possible at the system bootup.  Sets up
// a message bus and hook the module's event routers into the bus

// Main message bus
MessageBus<11> bus;

TaskManager taskman;

void setup() {
  shutdown_guard::init();
  // Start USB Serial Debugging Port
  Serial.begin(115200);
  boot_diagnostics::captureResetReason();
  Serial.println("Starting Setup");

  // Initialize the shared bus
  spi_init();
  Serial.println(" - Finished SPI");

#ifdef FANET_CAPABLE
  fanetRadio.subscribe(&bus);
  fanetRadio.setup();
  fanetRadio.publishTo(&bus);
#endif

  // grab user settings (or populate defaults if no saved settings)
  settings.init();
  heap_monitor::registerTask("loop", xTaskGetCurrentTaskHandle());
  heap_monitor::record("setup-settings");

  buttons.publishTo(&bus);

  if (!settings.dev_startDisconnected) {
    Serial.println("Connecting hardware devices to bus");
    aht20.publishTo(&bus);
    MotionSensor::getInstance().publishTo(&bus);
    lc86g.publishTo(&bus);
    ms5611.publishTo(&bus);
  } else {
    Serial.println("Leaving hardware devices unconnected to bus");
  }

  udpMessageServer.publishTo(&bus);

  baro.subscribeTo(&bus);
  baro.publishTo(&bus);

  // Initialize anything left over on the Task Manager System
  Serial.println("Initializing Taskman Service");
  taskman.init();
  heap_monitor::checkpoint("setup-taskman");

  // Initialize the BLE stack only when the saved setting asks for it. BLE still subscribes to the
  // bus below so it can be enabled later from settings without rebooting.
  if (power.info().onState == PowerState::On && settings.system_bluetoothOn) {
    Serial.println("Initializing Bluetooth Module");
    BLE::get().setup();
    heap_monitor::checkpoint("setup-ble");
    BLE::get().start();
    heap_monitor::checkpoint("setup-ble-start");
  } else {
    heap_monitor::checkpoint("setup-ble-skipped");
  }

  // Connect GPS instrument to message bus sourcing lines of text that should be NMEA sentences
  gps.subscribeTo(&bus);
  // Publish parsed GPS messages to message bus
  gps.publishTo(&bus);

  // Connect ambient environment instrument to message bus sourcing ambient environment updates
  ambient.subscribeTo(&bus);

  // Connect IMU instrument to message bus sourcing motion updates
  imu.subscribeTo(&bus);
  imu.publishTo(&bus);

  windEstimator.subscribeTo(&bus);

  BLE::get().subscribeTo(&bus);

  buttonMonitor.subscribeTo(&bus);
  buttonDispatcher.subscribeTo(&bus);

  // Provide bus logger access to the bus
  busLog.setBus(&bus);

  Serial.println("Leaf Initialized");
  heap_monitor::checkpoint("setup-complete");
  shutdown_guard::finishBoot();
}

void loop() {
#ifdef RUN_EMBEDDED_TESTS
  run_tests(&bus);
#else
  taskman.update();
#endif
}
