DangerMonkeys/leaf/src/vario/logbook/flight.cpp

#include "flight.h"

#include <SD_MMC.h>

#include "FS.h"
#include "instruments/gps.h"
#include "logging/telemetry.h"
#include "storage/sd_card.h"

bool Flight::startFlight() {
  // Short circuit if the card is not mounted or reading properly
  if (!sdcard.isMounted()) return false;
  if (!gps.systemTimeSyncedThisBoot()) {
    Serial.println("Flight::startFlight waiting for valid GPS date/time");
    return false;
  }

  Serial.printf("Sectors: %d\n", SD_MMC.numSectors());
  File trackLogsDir = SD_MMC.open(this->desiredFilePath());

  auto filePrefix = this->desiredFilePath() + "/" + this->desiredFileName();
  auto suffix = this->fileNameSuffix();
  // Perform a directory listing of all the file in the tracks directory
  auto nextFile = trackLogsDir.getNextFileName();
  auto desiredFlightNum = 1;
  while (!nextFile.isEmpty()) {
    if (!nextFile.endsWith(suffix) || !nextFile.startsWith(filePrefix)) {
      nextFile = trackLogsDir.getNextFileName();
      continue;
    }

    // This file matches the format we're after.  Find the flight number
    // igc-file-01.igc should match 01
    auto flightNumStr =
        nextFile.substring(filePrefix.length() + 1, nextFile.length() - suffix.length());
    auto flightNum = flightNumStr.toInt();
    if (flightNum >= desiredFlightNum) {
      desiredFlightNum = flightNum + 1;
    }

    nextFile = trackLogsDir.getNextFileName();
  }

  String fileName = filePrefix + "-" +
                    (desiredFlightNum < 10 ? String(0) + desiredFlightNum : desiredFlightNum) +
                    "." + suffix;

  // Create the file for writing
  file = SD_MMC.open(fileName, "w", true);
  if (!file) {
    filePath_ = "";
    return false;
  }

  filePath_ = fileName;
  return true;
}

void Flight::end(const FlightStats stats, bool showSummary) { file.close(); }

bool Flight::started() { return (boolean)file; }

String Flight::trackLogPath() const {
  if (filePath_.isEmpty()) return "";
  return filePath_[0] == '/' ? filePath_.substring(1) : filePath_;
}
