DangerMonkeys/leaf/src/vario/comms/webserver.cpp

#include "comms/webserver.h"
#include <ArduinoJson.h>
#include <DNSServer.h>
#include <FS.h>
#include <HTTPClient.h>
#include <SD_MMC.h>
#include <WebServer.h>
#include <WiFi.h>
#include <WiFiClientSecure.h>
#include <ctype.h>
#include <esp_heap_caps.h>
#include <math.h>
#include <time.h>
#include <stdexcept>
#include "comms/ble.h"
#include "comms/factory_discovery.h"
#include "comms/fanet_radio.h"
#include "comms/leaf_log_credentials.h"
#include "comms/ota.h"
#include "comms/udp_message_server.h"
#include "comms/wifi_coordinator.h"
#include "diagnostics/cpu_utilization.h"
#include "diagnostics/diagnostic_logs.h"
#include "diagnostics/diagnostic_network/diagnostic_network.h"
#include "diagnostics/heap_monitor.h"
#include "diagnostics/memory_report.h"
#include "diagnostics/self_test/selfTest.h"
#include "instruments/baro.h"
#include "instruments/gps.h"
#include "logbook/logbook_io.h"
#include "logbook/logbook_store.h"
#include "navigation/gpx.h"
#include "navigation/optimized_route_guidance.h"
#include "navigation/route_store.h"
#include "navigation/user_waypoints.h"
#include "power.h"
#include "profiles/profile_store.h"
#include "storage/sd_card.h"
#include "system/version_info.h"
#include "ui/audio/speaker.h"
#include "ui/display/display.h"
#include "ui/settings/settings.h"

namespace {
  ::WebServer user_server(80);
  DNSServer dns_server;
  String send_buffer = "";
  bool user_server_started = false;
  bool user_server_routes_configured = false;
  bool commissioning_routes_configured = false;
  bool debug_routes_configured = false;
  bool user_app_enabled = false;
  bool user_app_using_leaf_wifi = false;
  bool user_app_provisioning = false;
  bool user_app_services_paused = false;
  bool user_app_dns_started = false;
  bool user_app_restart_ble = false;
  bool user_app_restart_fanet = false;
  bool user_app_always_on = false;
  bool user_app_keep_bluetooth_disabled = false;
  FanetRadioRegion user_app_fanet_region = FanetRadioRegion::OFF;
  String wifi_setup_networks_json = "{\"scanning\":false,\"networks\":[]}";
  bool wifi_setup_scan_running = false;
  bool wifi_setup_connecting = false;
  uint32_t wifi_setup_connect_started_ms = 0;
  uint32_t wifi_setup_connected_ms = 0;
  String wifi_setup_connect_ssid = "";
  String wifi_setup_connect_password = "";
  String wifi_setup_connect_error = "";
  bool wifi_setup_connect_saved = false;
  int16_t wifi_setup_last_scan_result = WIFI_SCAN_FAILED;
  uint32_t user_app_loop_count = 0;
  uint32_t user_app_handle_count = 0;
  uint32_t user_app_route_root_count = 0;
  uint32_t user_app_route_app_count = 0;
  uint32_t user_app_route_status_count = 0;
  uint32_t user_app_route_profiles_get_count = 0;
  uint32_t user_app_route_profiles_put_count = 0;
  uint32_t user_app_route_logbook_count = 0;
  uint32_t user_app_route_logbook_entry_count = 0;
  uint32_t user_app_route_logbook_delete_count = 0;
  uint32_t user_app_route_waypoints_upload_count = 0;
  uint32_t user_app_route_routes_import_count = 0;
  uint32_t user_app_route_not_found_count = 0;
  uint8_t user_app_max_ap_stations = 0;

  enum class SelfTestMode { None, Interactive };

  static constexpr uint32_t SELF_TEST_POWER_ON_DELAY_MS = 10000;
  static constexpr uint32_t WIFI_SETUP_CONNECT_TIMEOUT_MS = 12000;
  static constexpr uint32_t WIFI_SETUP_AP_SUCCESS_GRACE_MS = 10000;
  static constexpr size_t PROFILE_FILE_MAX_BYTES = 6144;
  static constexpr size_t ROUTE_IMPORT_REQUEST_MAX_BYTES = 10000;
  static constexpr size_t ROUTE_EDITOR_REQUEST_MAX_BYTES = 18000;
  static constexpr size_t USER_WAYPOINTS_MAX_BYTES = 24576;
  static constexpr size_t NAV_UPLOAD_MAX_BYTES = 262144UL;
  static constexpr uint32_t NAV_POINTS_MIN_FREE_HEAP = 18000;
  static constexpr uint32_t NAV_POINTS_MIN_MAX_ALLOC = 6000;
  static constexpr const char* PROFILE_TEMP_FILE = "/profiles/profiles.tmp";
  static constexpr const char* PROFILE_BACKUP_FILE = "/profiles/profiles.bak";
  static constexpr const char* WAYPOINTS_DIR = "/waypoints";
  static constexpr const char* NAV_UPLOAD_TEMP_FILE = "/waypoints/upload.tmp";
  static constexpr size_t WIFI_SETUP_NETWORKS_JSON_RESERVE = 896;
  static constexpr uint32_t WEB_REQUEST_SLOW_MS = 1000;
  static constexpr const char* LEAF_LOG_BASE_URL = "https://log.leafvario.com";
  static constexpr uint32_t LEAF_LOG_TIME_MIN_EPOCH = 1704067200UL;

  static constexpr const char* ISRG_ROOT_X1_CA =
      "-----BEGIN CERTIFICATE-----\n"
      "MIIFazCCA1OgAwIBAgIRAIIQz7DSQONZRGPgu2OCiwAwDQYJKoZIhvcNAQELBQAw\n"
      "TzELMAkGA1UEBhMCVVMxKTAnBgNVBAoTIEludGVybmV0IFNlY3VyaXR5IFJlc2Vh\n"
      "cmNoIEdyb3VwMRUwEwYDVQQDEwxJU1JHIFJvb3QgWDEwHhcNMTUwNjA0MTEwNDM4\n"
      "WhcNMzUwNjA0MTEwNDM4WjBPMQswCQYDVQQGEwJVUzEpMCcGA1UEChMgSW50ZXJu\n"
      "ZXQgU2VjdXJpdHkgUmVzZWFyY2ggR3JvdXAxFTATBgNVBAMTDElTUkcgUm9vdCBY\n"
      "MTCCAiIwDQYJKoZIhvcNAQEBBQADggIPADCCAgoCggIBAK3oJHP0FDfzm54rVygc\n"
      "h77ct984kIxuPOZXoHj3dcKi/vVqbvYATyjb3miGbESTtrFj/RQSa78f0uoxmyF+\n"
      "0TM8ukj13Xnfs7j/EvEhmkvBioZxaUpmZmyPfjxwv60pIgbz5MDmgK7iS4+3mX6U\n"
      "A5/TR5d8mUgjU+g4rk8Kb4Mu0UlXjIB0ttov0DiNewNwIRt18jA8+o+u3dpjq+sW\n"
      "T8KOEUt+zwvo/7V3LvSye0rgTBIlDHCNAymg4VMk7BPZ7hm/ELNKjD+Jo2FR3qyH\n"
      "B5T0Y3HsLuJvW5iB4YlcNHlsdu87kGJ55tukmi8mxdAQ4Q7e2RCOFvu396j3x+UC\n"
      "B5iPNgiV5+I3lg02dZ77DnKxHZu8A/lJBdiB3QW0KtZB6awBdpUKD9jf1b0SHzUv\n"
      "KBds0pjBqAlkd25HN7rOrFleaJ1/ctaJxQZBKT5ZPt0m9STJEadao0xAH0ahmbWn\n"
      "OlFuhjuefXKnEgV4We0+UXgVCwOPjdAvBbI+e0ocS3MFEvzG6uBQE3xDk3SzynTn\n"
      "jh8BCNAw1FtxNrQHusEwMFxIt4I7mKZ9YIqioymCzLq9gwQbooMDQaHWBfEbwrbw\n"
      "qHyGO0aoSCqI3Haadr8faqU9GY/rOPNk3sgrDQoo//fb4hVC1CLQJ13hef4Y53CI\n"
      "rU7m2Ys6xt0nUW7/vGT1M0NPAgMBAAGjQjBAMA4GA1UdDwEB/wQEAwIBBjAPBgNV\n"
      "HRMBAf8EBTADAQH/MB0GA1UdDgQWBBR5tFnme7bl5AFzgAiIyBpY9umbbjANBgkq\n"
      "hkiG9w0BAQsFAAOCAgEAVR9YqbyyqFDQDLHYGmkgJykIrGF1XIpu+ILlaS/V9lZL\n"
      "ubhzEFnTIZd+50xx+7LSYK05qAvqFyFWhfFQDlnrzuBZ6brJFe+GnY+EgPbk6ZGQ\n"
      "3BebYhtF8GaV0nxvwuo77x/Py9auJ/GpsMiu/X1+mvoiBOv/2X/qkSsisRcOj/KK\n"
      "NFtY2PwByVS5uCbMiogziUwthDyC3+6WVwW6LLv3xLfHTjuCvjHIInNzktHCgKQ5\n"
      "ORAzI4JMPJ+GslWYHb4phowim57iaztXOoJwTdwJx4nLCgdNbOhdjsnvzqvHu7Ur\n"
      "TkXWStAmzOVyyghqpZXjFaH3pO3JLF+l+/+sKAIuvtd7u+Nxe5AW0wdeRlN8NwdC\n"
      "jNPElpzVmbUq4JUagEiuTDkHzsxHpFKVK7q4+63SM1N95R1NbdWhscdCb+ZAJzVc\n"
      "oyi3B43njTOQ5yOf+1CceWxG1bQVs5ZufpsMljq4Ui0/1lvh+wjChP4kqKOJ2qxq\n"
      "4RgqsahDYVvTH9w7jXbyLeiNdd8XM2w9U/t7y0Ff/9yi0GE44Za4rF2LN9d11TPA\n"
      "mRGunUHBcnWEvgJBQl9nJEiU0Zsnvgc/ubhPgXRR4Xq37Z0j4r7g1SgEEzwxA57d\n"
      "emyPxgcYxn/eR44/KJ4EBs+lVDR3veyJm+kXQ99b21/+jh5Xos1AnX5iItreGCc=\n"
      "-----END CERTIFICATE-----\n";

  SelfTestMode last_self_test_mode = SelfTestMode::None;
  bool interactive_self_test_pending = false;
  uint32_t interactive_self_test_start_ms = 0;

  uint32_t wifi_setup_cycle = 0;
  uint32_t wifi_setup_started_ms = 0;
  uint32_t wifi_setup_last_diag_ms = 0;
  File nav_upload_file;
  String nav_upload_final_path = "";
  String nav_upload_saved_name = "";
  String nav_upload_error = "";
  size_t nav_upload_bytes = 0;
  uint32_t web_request_sequence = 0;
  String leaf_log_pair_code = "";
  String leaf_log_poll_handle = "";
  String leaf_log_pair_expires_at = "";
  String leaf_log_previous_token = "";

  bool diagnosticsEnabled() {
    return diagnostic_logs::enabled(diagnostic_logs::Log::NetworkEvents);
  }

  bool webRequestDiagnosticsEnabled() {
    return diagnostic_logs::enabled(diagnostic_logs::Log::WebRequests);
  }

  bool commissioningHttpAllowed() {
    return diagnostic_network.connected() && !settings.commissioningComplete;
  }

  void logWifiSetupTiming(const char* event) {
    if (!diagnosticsEnabled()) return;
    Serial.printf("Leaf WiFi setup cycle %lu +%lums: %s heap=%u maxAlloc=%u\n",
                  static_cast<unsigned long>(wifi_setup_cycle),
                  static_cast<unsigned long>(millis() - wifi_setup_started_ms), event,
                  ESP.getFreeHeap(), ESP.getMaxAllocHeap());
  }

  void resetUserAppCounters() {
    if (!diagnosticsEnabled()) return;
    user_app_loop_count = 0;
    user_app_handle_count = 0;
    user_app_route_root_count = 0;
    user_app_route_app_count = 0;
    user_app_route_status_count = 0;
    user_app_route_profiles_get_count = 0;
    user_app_route_profiles_put_count = 0;
    user_app_route_logbook_count = 0;
    user_app_route_logbook_entry_count = 0;
    user_app_route_logbook_delete_count = 0;
    user_app_route_waypoints_upload_count = 0;
    user_app_route_routes_import_count = 0;
    user_app_route_not_found_count = 0;
    user_app_max_ap_stations = 0;
  }

  void updateUserAppStationPeak() {
    if (!diagnosticsEnabled()) return;
    const uint8_t station_count = WiFi.softAPgetStationNum();
    if (station_count > user_app_max_ap_stations) user_app_max_ap_stations = station_count;
  }

  bool stationConnectionReady() {
    return WiFi.status() == WL_CONNECTED && WiFi.localIP() != IPAddress(0, 0, 0, 0);
  }

  uint32_t wifiSetupConnectedElapsedMs() {
    return wifi_setup_connected_ms == 0 ? 0 : millis() - wifi_setup_connected_ms;
  }

  bool wifiSetupReadyForTransition() {
    return user_app_enabled && user_app_provisioning && stationConnectionReady() &&
           wifi_setup_connected_ms != 0 &&
           wifiSetupConnectedElapsedMs() >= WIFI_SETUP_AP_SUCCESS_GRACE_MS;
  }

  void printCsvString(File& file, const String& value) {
    file.print('"');
    for (size_t i = 0; i < value.length(); i++) {
      if (value[i] == '"') file.print('"');
      file.print(value[i]);
    }
    file.print('"');
  }

  void writeNetworkEventsHeaderIfNeeded(File& file, bool existed) {
    if (existed && file.size() > 0) return;
    file.println(
        "millis,event,mode,cycle,attempt_index,saved_count,enabled,using_leaf_wifi,provisioning,"
        "connecting,ready,wifi_status,wifi_mode,rssi,ap_stations,max_ap_stations,local_ip,ap_ip,"
        "target_ssid,current_ssid,connect_error,elapsed_ms,connect_started_ms,connected_ms,"
        "last_scan_result,diagnostics_allowed,free_heap,max_alloc_heap,current_task,loop_count,"
        "handle_count,root,app,status,profiles_get,profiles_put,logbook,logbook_entry,"
        "logbook_delete,waypoints_upload,routes_import,not_found");
  }

  const char* httpMethodName(HTTPMethod method) {
    switch (method) {
      case HTTP_GET:
        return "GET";
      case HTTP_POST:
        return "POST";
      case HTTP_DELETE:
        return "DELETE";
      case HTTP_PUT:
        return "PUT";
      case HTTP_PATCH:
        return "PATCH";
      case HTTP_OPTIONS:
        return "OPTIONS";
      default:
        return "OTHER";
    }
  }

  void appendWebRequestDiagnostics(const char* event, uint32_t sequence, const char* route,
                                   uint32_t startedMs, uint32_t durationMs) {
    if (!webRequestDiagnosticsEnabled()) return;
    if (!diagnostic_logs::ensureDirectory()) return;

    const bool existed = SD_MMC.exists(diagnostic_logs::WEB_REQUESTS_PATH);
    File file = SD_MMC.open(diagnostic_logs::WEB_REQUESTS_PATH, "a", true);
    if (!file) return;

    if (!existed || file.size() == 0) {
      file.println(
          "millis,event,sequence,route,method,uri,duration_ms,started_ms,free_heap,"
          "min_free_heap,largest_free_block,max_alloc_heap,wifi_status,wifi_mode,rssi,"
          "ap_stations,using_leaf_wifi,provisioning,current_task");
    }

    file.printf("%lu,", static_cast<unsigned long>(millis()));
    printCsvString(file, event ? String(event) : String(""));
    file.printf(",%lu,", static_cast<unsigned long>(sequence));
    printCsvString(file, route ? String(route) : String(""));
    file.print(',');
    printCsvString(file, httpMethodName(user_server.method()));
    file.print(',');
    printCsvString(file, user_server.uri());
    file.printf(",%lu,%lu,%lu,%lu,%lu,%lu,%d,%d,%d,%u,%u,%u,",
                static_cast<unsigned long>(durationMs), static_cast<unsigned long>(startedMs),
                static_cast<unsigned long>(ESP.getFreeHeap()),
                static_cast<unsigned long>(esp_get_minimum_free_heap_size()),
                static_cast<unsigned long>(heap_caps_get_largest_free_block(MALLOC_CAP_8BIT)),
                static_cast<unsigned long>(ESP.getMaxAllocHeap()), static_cast<int>(WiFi.status()),
                static_cast<int>(WiFi.getMode()), WiFi.RSSI(),
                static_cast<unsigned int>(WiFi.softAPgetStationNum()),
                user_app_using_leaf_wifi ? 1 : 0, user_app_provisioning ? 1 : 0);
    printCsvString(file, pcTaskGetName(NULL));
    file.println();
    file.close();
  }

  template <typename Handler>
  void handleUserRequest(const char* route, Handler handler) {
    if (!webRequestDiagnosticsEnabled()) {
      handler();
      return;
    }

    const uint32_t sequence = ++web_request_sequence;
    const uint32_t startedMs = millis();
    appendWebRequestDiagnostics("start", sequence, route, startedMs, 0);
    handler();
    const uint32_t durationMs = millis() - startedMs;
    appendWebRequestDiagnostics(durationMs >= WEB_REQUEST_SLOW_MS ? "slow" : "end", sequence, route,
                                startedMs, durationMs);
  }

  void appendWifiSetupDiagnostics(const char* event, bool force = false) {
    if (!diagnosticsEnabled()) return;
    const uint32_t now = millis();
    if (!force && now - wifi_setup_last_diag_ms < 1000) return;
    wifi_setup_last_diag_ms = now;

    const bool ready = wifiSetupReadyForTransition();
    const int wifi_status = static_cast<int>(WiFi.status());
    const int wifi_mode = static_cast<int>(WiFi.getMode());
    const uint8_t ap_stations = WiFi.softAPgetStationNum();
    const String local_ip = WiFi.localIP().toString();
    const String ap_ip = WiFi.softAPIP().toString();
    const String ssid = WiFi.SSID();

    Serial.printf(
        "Leaf WiFi setup diag: event=%s enabled=%u leaf_ap=%u provisioning=%u connecting=%u "
        "ready=%u status=%d mode=%d local_ip=%s ap_ip=%s ap_stations=%u ssid=%s target=%s "
        "connected_elapsed=%lu error=%s\n",
        event ? event : "", user_app_enabled ? 1 : 0, user_app_using_leaf_wifi ? 1 : 0,
        user_app_provisioning ? 1 : 0, wifi_setup_connecting ? 1 : 0, ready ? 1 : 0, wifi_status,
        wifi_mode, local_ip.c_str(), ap_ip.c_str(), static_cast<unsigned int>(ap_stations),
        ssid.c_str(), wifi_setup_connect_ssid.c_str(),
        static_cast<unsigned long>(wifiSetupConnectedElapsedMs()),
        wifi_setup_connect_error.c_str());

    if (!diagnostic_logs::ensureDirectory()) return;
    const bool existed = SD_MMC.exists(diagnostic_logs::NETWORK_EVENTS_PATH);
    File file = SD_MMC.open(diagnostic_logs::NETWORK_EVENTS_PATH, "a", true);
    if (!file) return;

    writeNetworkEventsHeaderIfNeeded(file, existed);

    file.printf("%lu,", static_cast<unsigned long>(now));
    printCsvString(file, event ? String(event) : String(""));
    file.print(",wifi_setup");
    file.printf(",%lu,,,%u,%u,%u,%u,%u,%d,%d,%d,%u,%u,",
                static_cast<unsigned long>(wifi_setup_cycle), user_app_enabled ? 1 : 0,
                user_app_using_leaf_wifi ? 1 : 0, user_app_provisioning ? 1 : 0,
                wifi_setup_connecting ? 1 : 0, ready ? 1 : 0, wifi_status, wifi_mode, WiFi.RSSI(),
                static_cast<unsigned int>(ap_stations),
                static_cast<unsigned int>(user_app_max_ap_stations));
    printCsvString(file, local_ip);
    file.print(',');
    printCsvString(file, ap_ip);
    file.print(',');
    printCsvString(file, wifi_setup_connect_ssid);
    file.print(',');
    printCsvString(file, ssid);
    file.print(',');
    printCsvString(file, wifi_setup_connect_error);
    file.printf(
        ",%lu,%lu,%lu,%d,%u,%lu,%lu,", static_cast<unsigned long>(wifiSetupConnectedElapsedMs()),
        static_cast<unsigned long>(wifi_setup_connect_started_ms),
        static_cast<unsigned long>(wifi_setup_connected_ms),
        static_cast<int>(wifi_setup_last_scan_result), leaf_wifi::diagnosticsAllowed() ? 1 : 0,
        static_cast<unsigned long>(ESP.getFreeHeap()),
        static_cast<unsigned long>(ESP.getMaxAllocHeap()));
    printCsvString(file, pcTaskGetName(NULL));
    file.println(",,,,,,,,,,,,,");
    file.close();
  }

  void rememberSuccessfulWifiSetupNetwork() {
    if (wifi_setup_connect_saved || wifi_setup_connect_ssid.isEmpty()) return;
    leaf_wifi::rememberSuccessfulNetwork(wifi_setup_connect_ssid, wifi_setup_connect_password);
    wifi_setup_connect_saved = true;
    wifi_setup_connect_password = "";
  }

  void markWifiSetupConnected(const char* event) {
    wifi_setup_connecting = false;
    if (wifi_setup_connected_ms == 0) wifi_setup_connected_ms = millis();
    wifi_setup_connect_error = "";
    rememberSuccessfulWifiSetupNetwork();
    appendWifiSetupDiagnostics(event, true);
  }

  void dumpUserAppCounters(const char* event) {
    if (!diagnosticsEnabled()) return;
    if (!diagnostic_logs::ensureDirectory()) return;

    const bool existed = SD_MMC.exists(diagnostic_logs::NETWORK_EVENTS_PATH);
    File file = SD_MMC.open(diagnostic_logs::NETWORK_EVENTS_PATH, "a", true);
    if (!file) return;

    writeNetworkEventsHeaderIfNeeded(file, existed);

    updateUserAppStationPeak();
    const String ap_ip = WiFi.softAPIP().toString();
    file.printf("%lu,", static_cast<unsigned long>(millis()));
    printCsvString(file, event ? String(event) : String(""));
    file.print(",webapp,,,,");
    file.printf("%u,%u,%u,,,%d,%d,%d,%u,%u,", user_app_enabled ? 1 : 0,
                user_app_using_leaf_wifi ? 1 : 0, user_app_provisioning ? 1 : 0,
                static_cast<int>(WiFi.status()), static_cast<int>(WiFi.getMode()), WiFi.RSSI(),
                static_cast<unsigned int>(WiFi.softAPgetStationNum()),
                static_cast<unsigned int>(user_app_max_ap_stations));
    printCsvString(file, WiFi.localIP().toString());
    file.print(',');
    printCsvString(file, ap_ip);
    file.print(",,,,,,,");
    file.printf("%u,%lu,%lu,", leaf_wifi::diagnosticsAllowed() ? 1 : 0,
                static_cast<unsigned long>(ESP.getFreeHeap()),
                static_cast<unsigned long>(ESP.getMaxAllocHeap()));
    printCsvString(file, pcTaskGetName(NULL));
    file.printf(",%lu,%lu,%lu,%lu,%lu,%lu,%lu,%lu,%lu,%lu,%lu,%lu,%lu\n",
                static_cast<unsigned long>(user_app_loop_count),
                static_cast<unsigned long>(user_app_handle_count),
                static_cast<unsigned long>(user_app_route_root_count),
                static_cast<unsigned long>(user_app_route_app_count),
                static_cast<unsigned long>(user_app_route_status_count),
                static_cast<unsigned long>(user_app_route_profiles_get_count),
                static_cast<unsigned long>(user_app_route_profiles_put_count),
                static_cast<unsigned long>(user_app_route_logbook_count),
                static_cast<unsigned long>(user_app_route_logbook_entry_count),
                static_cast<unsigned long>(user_app_route_logbook_delete_count),
                static_cast<unsigned long>(user_app_route_waypoints_upload_count),
                static_cast<unsigned long>(user_app_route_routes_import_count),
                static_cast<unsigned long>(user_app_route_not_found_count));
    file.close();
  }

  const char* selfTestModeName(SelfTestMode mode) {
    switch (mode) {
      case SelfTestMode::Interactive:
        return "interactive";
      case SelfTestMode::None:
      default:
        return "none";
    }
  }

  const char* selfTestStatusName(SelfTest::Status status) {
    switch (status) {
      case SelfTest::Status::Pass:
        return "pass";
      case SelfTest::Status::Fail:
        return "fail";
      case SelfTest::Status::Running:
        return "running";
      case SelfTest::Status::Complete:
        return "complete";
      case SelfTest::Status::Unknown:
      default:
        return "unknown";
    }
  }

  void appendSelfTestResult(String& json, const char* name, SelfTest::Status status,
                            bool trailingComma = true) {
    json += "\"";
    json += name;
    json += "\":\"";
    json += selfTestStatusName(status);
    json += "\"";
    if (trailingComma) json += ",";
  }

  String selfTestSnapshotJson() {
    const bool running = selfTest.updateNeeded();
    String json = "{";
    json += "\"running\":";
    json += (running || interactive_self_test_pending) ? "true" : "false";
    json += ",\"pending\":";
    json += interactive_self_test_pending ? "true" : "false";
    json += ",\"mode\":\"";
    json += selfTestModeName(last_self_test_mode);
    json += "\",\"gps_satellites\":";
    json += static_cast<unsigned int>(gps.fixInfo.numberOfSats);
    json += ",\"status\":\"";
    json += interactive_self_test_pending ? "pending"
            : running                     ? "running"
                                          : selfTestStatusName(selfTest.results.allTests);
    json += "\",\"results\":{";
    appendSelfTestResult(json, "sd_card", selfTest.results.sdCard);
    appendSelfTestResult(json, "baro", selfTest.results.baro);
    appendSelfTestResult(json, "imu", selfTest.results.imu);
    appendSelfTestResult(json, "gps_serial", selfTest.results.gpsSerial);
    appendSelfTestResult(json, "ambient", selfTest.results.ambient);
    appendSelfTestResult(json, "display", selfTest.results.display);
    appendSelfTestResult(json, "power", selfTest.results.power);
    appendSelfTestResult(json, "vario", selfTest.results.vario);
    appendSelfTestResult(json, "buttons", selfTest.results.buttons);
    appendSelfTestResult(json, "speaker", selfTest.results.speaker);
    appendSelfTestResult(json, "gps_fix", selfTest.results.gpsFix);
    appendSelfTestResult(json, "all_tests", selfTest.results.allTests, false);
    json += "}}";
    return json;
  }

  String latestSelfTestDetailsFileName() {
    String current_file_name = selfTest.resultsFileName();
    if (!current_file_name.isEmpty() && SD_MMC.exists(current_file_name)) {
      return current_file_name;
    }

    String latest_file_name = "";
    char file_name[32];

    for (unsigned int i = 1; i <= 1000; i++) {
      snprintf(file_name, sizeof(file_name), "/self_test_%u.txt", i);
      if (SD_MMC.exists(file_name)) {
        latest_file_name = file_name;
      }
    }

    return latest_file_name;
  }

  void sendLatestSelfTestDetails(WebServer& target) {
    if (!sdcard.isMounted()) {
      target.send(404, "application/json", "{\"detail\":\"SD card is not mounted.\"}");
      return;
    }

    String file_name = latestSelfTestDetailsFileName();
    if (file_name.isEmpty()) {
      target.send(404, "application/json", "{\"detail\":\"No self test details file found.\"}");
      return;
    }

    File file = SD_MMC.open(file_name, "r");
    if (!file) {
      target.send(500, "application/json",
                  "{\"detail\":\"Self test details file could not be opened.\"}");
      return;
    }

    target.streamFile(file, "text/plain");
    file.close();
  }

  void clearSelfTestDetailsFiles(WebServer& target) {
    if (!sdcard.isMounted()) {
      target.send(404, "application/json", "{\"detail\":\"SD card is not mounted.\"}");
      return;
    }

    if (selfTest.updateNeeded()) {
      target.send(409, "application/json", "{\"detail\":\"Self test is still running.\"}");
      return;
    }

    unsigned int deleted_count = 0;
    unsigned int failed_count = 0;
    char file_name[32];

    for (unsigned int i = 1; i <= 1000; i++) {
      snprintf(file_name, sizeof(file_name), "/self_test_%u.txt", i);
      if (!SD_MMC.exists(file_name)) continue;

      if (SD_MMC.remove(file_name)) {
        deleted_count++;
      } else {
        failed_count++;
      }
    }

    if (failed_count > 0) {
      String json = "{\"cleared\":false,\"deleted_count\":";
      json += deleted_count;
      json += ",\"failed_count\":";
      json += failed_count;
      json += "}";
      target.send(500, "application/json", json);
      return;
    }

    String json = "{\"cleared\":true,\"deleted_count\":";
    json += deleted_count;
    json += "}";
    target.send(200, "application/json", json);
  }

  void beginInteractiveSelfTest() {
    interactive_self_test_pending = false;
    last_self_test_mode = SelfTestMode::Interactive;
    selfTest.begin(false);
  }

  void requestInteractiveSelfTest() {
    last_self_test_mode = SelfTestMode::Interactive;

    if (interactive_self_test_pending) return;

    if (power.info().onState == PowerState::OffUSB) {
      display.clear();
      display.showOnSplash();
      display.setPage(MainPage::User);
      power.switchToOnState();
      if (selfTest.updateNeeded()) return;

      interactive_self_test_pending = true;
      interactive_self_test_start_ms = millis();
      return;
    }

    if (selfTest.updateNeeded()) return;

    beginInteractiveSelfTest();
  }

  void updatePendingInteractiveSelfTest() {
    if (!interactive_self_test_pending) return;

    const uint32_t elapsed_ms = millis() - interactive_self_test_start_ms;
    if (elapsed_ms >= SELF_TEST_POWER_ON_DELAY_MS) {
      beginInteractiveSelfTest();
    }
  }

  bool isHexDigit(char c) {
    return (c >= '0' && c <= '9') || (c >= 'a' && c <= 'f') || (c >= 'A' && c <= 'F');
  }

  bool isValidFanetAddress(const String& fanet_address) {
    if (fanet_address.length() != 6) return false;

    for (size_t i = 0; i < fanet_address.length(); i++) {
      if (!isHexDigit(fanet_address[i])) return false;
    }

    return true;
  }

  String extractJsonStringValue(const String& body, const char* key) {
    String quoted_key = "\"";
    quoted_key += key;
    quoted_key += "\"";

    int key_index = body.indexOf(quoted_key);
    if (key_index < 0) return "";

    int separator_index = body.indexOf(':', key_index + quoted_key.length());
    if (separator_index < 0) return "";

    int value_start = separator_index + 1;
    while (value_start < body.length() && isspace(body[value_start])) {
      value_start++;
    }
    if (value_start >= body.length() || body[value_start] != '"') return "";

    String value;
    for (int i = value_start + 1; i < body.length(); i++) {
      const char c = body[i];
      if (c == '"') break;
      if (c == '\\' && i + 1 < body.length()) {
        i++;
        const char escaped = body[i];
        if (escaped == 'n') {
          value += '\n';
        } else if (escaped == 'r') {
          value += '\r';
        } else {
          value += escaped;
        }
      } else {
        value += c;
      }
    }

    return value;
  }

  bool extractJsonBoolValue(const String& body, const char* key, bool defaultValue = false) {
    String quoted_key = "\"";
    quoted_key += key;
    quoted_key += "\"";

    int key_index = body.indexOf(quoted_key);
    if (key_index < 0) return defaultValue;

    int separator_index = body.indexOf(':', key_index + quoted_key.length());
    if (separator_index < 0) return defaultValue;

    int value_start = separator_index + 1;
    while (value_start < body.length() && isspace(body[value_start])) {
      value_start++;
    }

    if (body.substring(value_start, value_start + 4) == "true") return true;
    if (body.substring(value_start, value_start + 5) == "false") return false;
    return defaultValue;
  }

  String jsonEscape(const String& value) {
    String escaped;
    escaped.reserve(value.length() + 4);
    for (uint16_t i = 0; i < value.length(); i++) {
      const char c = value[i];
      if (c == '"' || c == '\\') escaped += '\\';
      if (c == '\n') {
        escaped += "\\n";
      } else if (c == '\r') {
        escaped += "\\r";
      } else {
        escaped += c;
      }
    }
    return escaped;
  }

  class JsonStream {
   public:
    JsonStream(WebServer& target, char* buffer, size_t bufferSize)
        : target_(target), buffer_(buffer), bufferSize_(bufferSize) {}

    void write(const char* value) {
      if (value == nullptr) return;
      write(value, strlen(value));
    }

    void write(const char* value, size_t len) {
      if (value == nullptr || len == 0) return;
      if (len > bufferSize_) {
        flush();
        target_.sendContent(value, len);
        return;
      }
      if (len > bufferSize_ - used_) flush();
      memcpy(buffer_ + used_, value, len);
      used_ += len;
    }

    void writeEscaped(const char* value) {
      if (value == nullptr) return;
      const char* chunkStart = value;
      for (const char* p = value; *p != '\0'; p++) {
        const char* replacement = nullptr;
        char escapedChar[3] = {'\\', *p, '\0'};
        if (*p == '"' || *p == '\\') {
          replacement = escapedChar;
        } else if (*p == '\n') {
          replacement = "\\n";
        } else if (*p == '\r') {
          replacement = "\\r";
        }

        if (replacement != nullptr) {
          if (p > chunkStart) write(chunkStart, p - chunkStart);
          write(replacement);
          chunkStart = p + 1;
        }
      }
      if (*chunkStart != '\0') write(chunkStart, strlen(chunkStart));
    }

    void writeUInt(unsigned long value) {
      char buffer[16];
      snprintf(buffer, sizeof(buffer), "%lu", value);
      write(buffer);
    }

    void writeFloat(double value, unsigned int decimals) {
      char buffer[32];
      if (isfinite(value)) {
        snprintf(buffer, sizeof(buffer), "%.*f", decimals, value);
      } else {
        snprintf(buffer, sizeof(buffer), "null");
      }
      write(buffer);
    }

    void finish() {
      flush();
      target_.sendContent("", 0);
    }

   private:
    void flush() {
      if (used_ == 0) return;
      target_.sendContent(buffer_, used_);
      used_ = 0;
    }

    WebServer& target_;
    char* buffer_;
    const size_t bufferSize_;
    size_t used_ = 0;
  };

  String filenameFromUploadPath(String fileName) {
    fileName.replace('\\', '/');
    const int slash = fileName.lastIndexOf('/');
    if (slash >= 0) fileName = fileName.substring(slash + 1);
    fileName.trim();
    return fileName;
  }

  String lowerFileExtension(const String& fileName) {
    const int dot = fileName.lastIndexOf('.');
    if (dot < 0 || dot == fileName.length() - 1) return "";
    String ext = fileName.substring(dot + 1);
    ext.toLowerCase();
    return ext;
  }

  bool supportedNavUploadExtension(const String& ext) {
    return ext == "gpx" || ext == "cup" || ext == "wpt" || ext == "wyp";
  }

  String sanitizeNavUploadFileName(String fileName) {
    fileName = filenameFromUploadPath(fileName);
    const String ext = lowerFileExtension(fileName);
    if (!supportedNavUploadExtension(ext)) return "";

    const int dot = fileName.lastIndexOf('.');
    String stem = dot > 0 ? fileName.substring(0, dot) : "waypoints";
    stem.trim();

    String safeStem;
    safeStem.reserve(stem.length());
    for (uint16_t i = 0; i < stem.length(); i++) {
      const char c = stem[i];
      if (isalnum(static_cast<unsigned char>(c)) || c == '-' || c == '_') {
        safeStem += c;
      } else if (c == ' ' || c == '.') {
        safeStem += '-';
      }
    }

    while (safeStem.startsWith("-")) safeStem.remove(0, 1);
    while (safeStem.endsWith("-")) safeStem.remove(safeStem.length() - 1);
    if (safeStem.isEmpty()) safeStem = "waypoints";

    constexpr size_t MAX_UPLOAD_FILENAME_LENGTH = maxGpxFileNameLength - 16;
    const size_t maxStemLength = MAX_UPLOAD_FILENAME_LENGTH - ext.length() - 1;
    if (safeStem.length() > maxStemLength) safeStem = safeStem.substring(0, maxStemLength);

    String safeName = safeStem;
    safeName += ".";
    safeName += ext;
    return safeName;
  }

  String uniqueWaypointUploadPath(const String& safeName) {
    const int dot = safeName.lastIndexOf('.');
    if (dot <= 0) return "";

    String stem = safeName.substring(0, dot);
    const String ext = safeName.substring(dot);
    String path = String(WAYPOINTS_DIR) + "/" + safeName;
    if (!SD_MMC.exists(path)) return path;

    for (uint16_t suffix = 2; suffix < 1000; suffix++) {
      String suffixText = "-";
      suffixText += suffix;
      constexpr size_t MAX_UPLOAD_FILENAME_LENGTH = maxGpxFileNameLength - 16;
      const size_t maxStemLength = MAX_UPLOAD_FILENAME_LENGTH - ext.length() - suffixText.length();
      String candidateStem = stem;
      if (candidateStem.length() > maxStemLength) {
        candidateStem = candidateStem.substring(0, maxStemLength);
      }
      path = String(WAYPOINTS_DIR) + "/" + candidateStem + suffixText + ext;
      if (!SD_MMC.exists(path)) return path;
    }

    return "";
  }

  bool validUserWaypointJson(JsonObjectConst point) {
    const double lat = point["lat"] | NAN;
    const double lon = point["lon"] | NAN;
    return !isnan(lat) && !isnan(lon) && lat >= -90 && lat <= 90 && lon >= -180 && lon <= 180;
  }

  uint8_t mergeUserWaypointIntoNavigator(JsonObjectConst point) {
    if (!validUserWaypointJson(point)) return 0;

    Waypoint waypoint;
    const char* sourceName = point["name"] | "";
    while (*sourceName == ' ' || *sourceName == '\t') sourceName++;
    char name[maxGpxNameLength + 1];
    strncpy(name, *sourceName == '\0' ? "Saved Point" : sourceName, maxGpxNameLength);
    name[maxGpxNameLength] = '\0';
    char* end = name + strlen(name);
    while (end > name && (end[-1] == ' ' || end[-1] == '\t')) *--end = '\0';
    if (name[0] == '\0') {
      strncpy(name, "Saved Point", maxGpxNameLength);
      name[maxGpxNameLength] = '\0';
    }
    waypoint.setName(name);
    waypoint.setLatitude(point["lat"] | 0.0);
    waypoint.setLongitude(point["lon"] | 0.0);
    waypoint.ele = point["alt_m"] | NAN;

    for (uint8_t i = 1; i <= navigator.totalWaypoints; i++) {
      if (navigator.waypoints[i].latE7 == waypoint.latE7 &&
          navigator.waypoints[i].lonE7 == waypoint.lonE7) {
        navigator.waypoints[i] = waypoint;
        return i;
      }
    }

    if (!navigator.addWaypoint(waypoint)) return 0;
    return navigator.totalWaypoints;
  }

  void resetNavUploadState() {
    if (nav_upload_file) nav_upload_file.close();
    nav_upload_final_path = "";
    nav_upload_saved_name = "";
    nav_upload_error = "";
    nav_upload_bytes = 0;
  }

  void failNavUpload(const String& message) {
    if (!nav_upload_error.isEmpty()) return;
    nav_upload_error = message;
    if (nav_upload_file) nav_upload_file.close();
    if (SD_MMC.exists(NAV_UPLOAD_TEMP_FILE)) SD_MMC.remove(NAV_UPLOAD_TEMP_FILE);
  }

  void beginNavUpload(const String& uploadFileName) {
    resetNavUploadState();

    if (!user_app_enabled) {
      nav_upload_error = "Leaf Web App is not active.";
      return;
    }

    if (!sdcard.isMounted()) {
      nav_upload_error = "SD card is not mounted.";
      return;
    }

    if (!SD_MMC.exists(WAYPOINTS_DIR) && !SD_MMC.mkdir(WAYPOINTS_DIR)) {
      nav_upload_error = "Unable to create waypoints folder.";
      return;
    }

    const String safeName = sanitizeNavUploadFileName(uploadFileName);
    if (safeName.isEmpty()) {
      nav_upload_error = "Choose a GPX, CUP, WPT, or WYP file.";
      return;
    }

    nav_upload_final_path = uniqueWaypointUploadPath(safeName);
    if (nav_upload_final_path.isEmpty()) {
      nav_upload_error = "Unable to choose a unique file name.";
      return;
    }

    if (SD_MMC.exists(NAV_UPLOAD_TEMP_FILE)) SD_MMC.remove(NAV_UPLOAD_TEMP_FILE);
    nav_upload_file = SD_MMC.open(NAV_UPLOAD_TEMP_FILE, "w", true);
    if (!nav_upload_file) {
      nav_upload_error = "Unable to write waypoint file.";
      return;
    }
  }

  void receiveWaypointUpload(WebServer& target) {
    HTTPUpload& upload = target.upload();
    switch (upload.status) {
      case UPLOAD_FILE_START:
        heap_monitor::checkpoint("waypoint-upload-start");
        beginNavUpload(upload.filename);
        break;
      case UPLOAD_FILE_WRITE:
        if (!nav_upload_error.isEmpty()) return;
        nav_upload_bytes += upload.currentSize;
        if (nav_upload_bytes > NAV_UPLOAD_MAX_BYTES) {
          failNavUpload("Waypoint file is too large.");
          return;
        }
        if (!nav_upload_file ||
            nav_upload_file.write(upload.buf, upload.currentSize) != upload.currentSize) {
          failNavUpload("Unable to write waypoint file.");
        }
        break;
      case UPLOAD_FILE_END:
        if (!nav_upload_file && nav_upload_error.isEmpty()) {
          failNavUpload("Waypoint upload did not start.");
          return;
        }
        if (nav_upload_file) nav_upload_file.close();
        if (!nav_upload_error.isEmpty()) {
          if (SD_MMC.exists(NAV_UPLOAD_TEMP_FILE)) SD_MMC.remove(NAV_UPLOAD_TEMP_FILE);
          return;
        }
        if (nav_upload_bytes == 0) {
          failNavUpload("Waypoint file is empty.");
          return;
        }
        if (SD_MMC.exists(nav_upload_final_path) ||
            !SD_MMC.rename(NAV_UPLOAD_TEMP_FILE, nav_upload_final_path)) {
          failNavUpload("Unable to save waypoint file.");
          return;
        }
        nav_upload_saved_name = filenameFromUploadPath(nav_upload_final_path);
        break;
      case UPLOAD_FILE_ABORTED:
        failNavUpload("Waypoint upload was cancelled.");
        break;
    }
  }

  void finishWaypointUpload(WebServer& target) {
    if (!nav_upload_error.isEmpty()) {
      String json = "{\"saved\":false,\"loaded\":false,\"detail\":\"";
      json += jsonEscape(nav_upload_error);
      json += "\"}";
      resetNavUploadState();
      heap_monitor::checkpoint("waypoint-upload-fail");
      target.send(400, "application/json", json);
      return;
    }

    if (nav_upload_final_path.isEmpty() || nav_upload_saved_name.isEmpty()) {
      resetNavUploadState();
      target.send(
          400, "application/json",
          "{\"saved\":false,\"loaded\":false,\"detail\":\"No waypoint file was uploaded.\"}");
      return;
    }

    const String savedPath = nav_upload_final_path;
    const String savedName = nav_upload_saved_name;
    NavLoadError loadError;
    const bool loaded = nav_readFile(SD_MMC, savedPath, &loadError);
    if (loaded) user_waypoints::loadIntoNavigator();

    String json = "{\"saved\":true,\"loaded\":";
    json += loaded ? "true" : "false";
    json += ",\"filename\":\"";
    json += jsonEscape(savedName);
    json += "\",\"path\":\"";
    json += jsonEscape(savedPath);
    json += "\",\"points\":";
    json += loaded ? navigator.loadedFileWaypointCount() : 0;
    json += ",\"routes\":";
    json += loaded ? navigator.totalRoutes : 0;
    if (!loaded) {
      json += loadError == NavLoadError::RoutePointLimit
                  ? ",\"detail\":\"File was saved but exceeds the 20-point route limit.\""
                  : ",\"detail\":\"File was saved, but Leaf could not load it.\"";
    }
    json += "}";

    resetNavUploadState();
    heap_monitor::checkpoint(loaded ? "waypoint-upload-end" : "waypoint-upload-load-fail");
    target.send(loaded ? 200 : 422, "application/json", json);
  }

  String userAppMode() {
    if (!user_app_enabled) return "off";
    if (user_app_provisioning) return "provisioning";
    if (user_app_using_leaf_wifi) return "leaf_wifi";
    return "network";
  }

  String userAppAddress() {
    if (!user_app_enabled) return "";
    if (user_app_using_leaf_wifi) return WiFi.softAPIP().toString();
    return WiFi.localIP().toString();
  }

  String userAppUrl() {
    if (!user_app_enabled) return "";
    String url = "http://";
    url += userAppAddress();
    url += "/app";
    return url;
  }

  String stationUserAppUrl() {
    String url = "http://";
    url += WiFi.localIP().toString();
    url += "/app";
    return url;
  }

  String deviceHexDigits() {
    String hex = settings.getMacAddress();
    hex.replace(":", "");
    hex.toUpperCase();
    if (hex.length() < 4) return "LEAF";
    return hex;
  }

  String leafApSsid() {
    const String hex = deviceHexDigits();
    String ssid = "Leaf-";
    ssid += hex.substring(hex.length() - 4);
    return ssid;
  }

  uint8_t hexNibble(char c) {
    if (c >= '0' && c <= '9') return c - '0';
    if (c >= 'A' && c <= 'F') return c - 'A' + 10;
    if (c >= 'a' && c <= 'f') return c - 'a' + 10;
    return 0;
  }

  String leafApPassword() {
    static constexpr const char* words[] = {"sunset", "thermal", "clouds", "lifted", "circle"};
    const String hex = deviceHexDigits();
    const uint8_t a = hexNibble(hex.length() > 1 ? hex[hex.length() - 2] : '2');
    const uint8_t b = hexNibble(hex.length() > 0 ? hex[hex.length() - 1] : '3');

    String password = words[(a + b) % (sizeof(words) / sizeof(words[0]))];
    password += static_cast<char>('2' + (a % 8));
    password += static_cast<char>('2' + (b % 8));
    return password;
  }

  bool startLeafAp() {
    const String ssid = leafApSsid();
    const String password = leafApPassword();
    const bool started = WiFi.softAP(ssid.c_str(), password.c_str());
    if (!started) {
      Serial.printf("Leaf access point failed to start: ssid=%s password_length=%u\n", ssid.c_str(),
                    static_cast<unsigned int>(password.length()));
    }
    return started;
  }

  void startLeafApDns() {
    if (user_app_dns_started) return;
    dns_server.start(53, "*", WiFi.softAPIP());
    user_app_dns_started = true;
  }

  void stopLeafApDns() {
    if (!user_app_dns_started) return;
    dns_server.stop();
    user_app_dns_started = false;
  }

  String leafApWifiQr() {
    String qr = "WIFI:T:WPA;S:";
    qr += leafApSsid();
    qr += ";P:";
    qr += leafApPassword();
    qr += ";;";
    return qr;
  }

  void pauseServicesForUserApp() {
    if (user_app_services_paused) return;

    user_app_restart_ble = settings.system_bluetoothOn;
    if (user_app_restart_ble) {
      BLE::get().end();
    }

    user_app_restart_fanet = fanetRadio.getState() == FanetRadioState::RUNNING;
    user_app_fanet_region = settings.fanet_region;
    if (user_app_restart_fanet) {
      fanetRadio.end();
    }

    user_app_services_paused = true;
  }

  void resumeServicesAfterUserApp() {
    if (!user_app_services_paused) return;

    if (user_app_restart_fanet && settings.fanet_region != FanetRadioRegion::OFF) {
      fanetRadio.begin(settings.fanet_region);
    } else if (user_app_restart_fanet && user_app_fanet_region != FanetRadioRegion::OFF) {
      fanetRadio.begin(user_app_fanet_region);
    }

    if (user_app_restart_ble && settings.system_bluetoothOn && !user_app_keep_bluetooth_disabled) {
      BLE::get().setup();
      BLE::get().start();
    }

    user_app_restart_ble = false;
    user_app_restart_fanet = false;
    user_app_fanet_region = FanetRadioRegion::OFF;
    user_app_services_paused = false;
  }

  void sendNoStoreHeaders(WebServer& target) {
    target.sendHeader("Cache-Control", "no-store, no-cache, must-revalidate, max-age=0");
    target.sendHeader("Pragma", "no-cache");
    target.sendHeader("Expires", "0");
  }

  void setWifiSetupNetworksJson(const char* json) {
    wifi_setup_networks_json = "";
    wifi_setup_networks_json.reserve(WIFI_SETUP_NETWORKS_JSON_RESERVE);
    wifi_setup_networks_json = json;
  }

  void releaseWifiSetupNetworksJson() {
    wifi_setup_networks_json = String();
    wifi_setup_networks_json = "{\"scanning\":false,\"networks\":[]}";
  }

  void stopFailedWifiSetupAttempt(const char* error) {
    wifi_setup_connecting = false;
    wifi_setup_connected_ms = 0;
    wifi_setup_connect_error = error;
    wifi_setup_connect_password = "";
    wifi_setup_connect_saved = false;

    // Stop the RAM-only setup attempt while keeping the previous saved default
    // and the Leaf AP available.
    WiFi.disconnect(false, false);
    WiFi.mode(WIFI_AP_STA);
    WiFi.setSleep(false);
    startLeafAp();
  }

  String wifiStatusJson() {
    appendWifiSetupDiagnostics("status", true);
    wl_status_t status = WiFi.status();
    if (wifi_setup_connecting && stationConnectionReady()) {
      markWifiSetupConnected("status-connected");
    } else if (wifi_setup_connecting &&
               millis() - wifi_setup_connect_started_ms > WIFI_SETUP_CONNECT_TIMEOUT_MS) {
      const wl_status_t timed_out_status = WiFi.status();
      if (timed_out_status == WL_CONNECTED) {
        markWifiSetupConnected("status-connected-after-timeout");
      } else if (timed_out_status == WL_NO_SSID_AVAIL) {
        stopFailedWifiSetupAttempt("network_not_found");
      } else if (timed_out_status == WL_CONNECT_FAILED) {
        stopFailedWifiSetupAttempt("connect_failed");
      } else {
        stopFailedWifiSetupAttempt("timeout");
      }
      status = WiFi.status();
    }

    String json = "{\"status\":";
    json += (int)status;
    json += ",\"connected\":";
    json += status == WL_CONNECTED ? "true" : "false";
    json += ",\"connecting\":";
    json += wifi_setup_connecting ? "true" : "false";
    json += ",\"transition_ready\":";
    json += wifiSetupReadyForTransition() ? "true" : "false";
    json += ",\"using_leaf_wifi\":";
    json += user_app_using_leaf_wifi ? "true" : "false";
    json += ",\"wifi_mode\":";
    json += static_cast<int>(WiFi.getMode());
    json += ",\"ap_stations\":";
    json += static_cast<int>(WiFi.softAPgetStationNum());
    json += ",\"connected_elapsed_ms\":";
    json += static_cast<unsigned long>(wifiSetupConnectedElapsedMs());
    json += ",\"ssid\":\"";
    json += jsonEscape(WiFi.SSID().isEmpty() && status == WL_CONNECTED ? wifi_setup_connect_ssid
                                                                       : WiFi.SSID());
    json += "\",\"target_ssid\":\"";
    json += jsonEscape(wifi_setup_connect_ssid);
    json += "\",\"ip_address\":\"";
    json += status == WL_CONNECTED ? WiFi.localIP().toString() : "";
    json += "\",\"setup_active\":";
    json += user_app_provisioning ? "true" : "false";
    json += ",\"error\":\"";
    json += jsonEscape(wifi_setup_connect_error);
    json += "\",\"app_url\":\"";
    json += status == WL_CONNECTED ? stationUserAppUrl() : userAppUrl();
    json += "\"}";
    return json;
  }

  const char* emptyProfilesJson() {
    return "{\"schema\":\"leaf.profiles\",\"schema_version\":\"v0.1.0\","
           "\"active_pilot_id\":null,\"active_glider_id\":null,"
           "\"pilots\":[],\"gliders\":[]}";
  }

  void sendProfiles(WebServer& target) {
    heap_monitor::checkpoint("profiles-get-start");
    if (!user_app_enabled) {
      target.send(404, "application/json", "{\"detail\":\"Leaf Web App is not active.\"}");
      return;
    }

    if (!sdcard.isMounted()) {
      target.send(404, "application/json", "{\"detail\":\"SD card is not mounted.\"}");
      return;
    }

    if (!SD_MMC.exists(ProfileStore::filePath())) {
      sendNoStoreHeaders(target);
      target.send(200, "application/json", emptyProfilesJson());
      return;
    }

    File file = SD_MMC.open(ProfileStore::filePath(), "r");
    if (!file) {
      target.send(500, "application/json", "{\"detail\":\"Profiles file could not be opened.\"}");
      return;
    }

    sendNoStoreHeaders(target);
    target.streamFile(file, "application/json");
    file.close();
    heap_monitor::checkpoint("profiles-get-end");
  }

  bool profilesRequestLooksValid(const String& body) {
    if (body.length() == 0 || body.length() > PROFILE_FILE_MAX_BYTES) return false;

    JsonDocument doc;
    DeserializationError error = deserializeJson(doc, body);
    if (error) return false;

    const char* schema = doc["schema"] | "";
    if (strcmp(schema, "leaf.profiles") != 0) return false;

    JsonArray pilots = doc["pilots"].as<JsonArray>();
    JsonArray gliders = doc["gliders"].as<JsonArray>();
    if (pilots.isNull() || gliders.isNull()) return false;
    if (pilots.size() > 12 || gliders.size() > 12) return false;

    String activePilotId =
        doc["active_pilot_id"].isNull() ? "" : doc["active_pilot_id"].as<String>();
    String activeGliderId =
        doc["active_glider_id"].isNull() ? "" : doc["active_glider_id"].as<String>();
    bool activePilotFound = activePilotId.isEmpty();
    bool activeGliderFound = activeGliderId.isEmpty();

    for (JsonObject item : pilots) {
      String id = item["id"] | "";
      String name = item["name"] | "";
      id.trim();
      name.trim();
      if (id.isEmpty() || id.length() > 20 || name.isEmpty() || name.length() > 48) return false;
      if (!activePilotId.isEmpty() && id == activePilotId) activePilotFound = true;
    }

    for (JsonObject item : gliders) {
      String id = item["id"] | "";
      String brand = item["brand"] | "";
      String model = item["model"] | "";
      String size = item["size"] | "";
      String displayName = item["display_name"] | "";
      id.trim();
      brand.trim();
      model.trim();
      size.trim();
      displayName.trim();
      if (id.isEmpty() || id.length() > 20 || model.isEmpty() || model.length() > 48) return false;
      if (brand.length() > 32 || size.length() > 16 || displayName.length() > 64) return false;
      if (!activeGliderId.isEmpty() && id == activeGliderId) activeGliderFound = true;
    }

    if (!activePilotFound || !activeGliderFound) return false;

    return true;
  }

  bool writeProfilesBody(const String& body) {
    if (!SD_MMC.exists(ProfileStore::directoryPath()) &&
        !SD_MMC.mkdir(ProfileStore::directoryPath())) {
      return false;
    }

    if (SD_MMC.exists(PROFILE_TEMP_FILE)) SD_MMC.remove(PROFILE_TEMP_FILE);
    if (SD_MMC.exists(PROFILE_BACKUP_FILE)) SD_MMC.remove(PROFILE_BACKUP_FILE);

    File file = SD_MMC.open(PROFILE_TEMP_FILE, "w", true);
    if (!file) return false;

    const size_t written = file.print(body);
    file.close();
    if (written != body.length()) {
      SD_MMC.remove(PROFILE_TEMP_FILE);
      return false;
    }

    const bool hadExisting = SD_MMC.exists(ProfileStore::filePath());
    if (hadExisting && !SD_MMC.rename(ProfileStore::filePath(), PROFILE_BACKUP_FILE)) {
      SD_MMC.remove(PROFILE_TEMP_FILE);
      return false;
    }

    if (!SD_MMC.rename(PROFILE_TEMP_FILE, ProfileStore::filePath())) {
      if (hadExisting) SD_MMC.rename(PROFILE_BACKUP_FILE, ProfileStore::filePath());
      SD_MMC.remove(PROFILE_TEMP_FILE);
      return false;
    }

    if (hadExisting) SD_MMC.remove(PROFILE_BACKUP_FILE);
    return true;
  }

  void saveProfiles(WebServer& target) {
    heap_monitor::checkpoint("profiles-put-start");
    if (!user_app_enabled) {
      target.send(404, "application/json", "{\"detail\":\"Leaf Web App is not active.\"}");
      return;
    }

    if (!sdcard.isMounted()) {
      target.send(404, "application/json", "{\"detail\":\"SD card is not mounted.\"}");
      return;
    }

    const String body = target.arg("plain");
    if (!profilesRequestLooksValid(body)) {
      heap_monitor::checkpoint("profiles-put-invalid");
      target.send(
          400, "application/json",
          "{\"detail\":\"Invalid profiles data. Pilot name and glider model are required.\"}");
      return;
    }

    if (!writeProfilesBody(body)) {
      heap_monitor::checkpoint("profiles-put-fail");
      target.send(500, "application/json", "{\"saved\":false}");
      return;
    }

    heap_monitor::checkpoint("profiles-put-end");
    target.send(200, "application/json", "{\"saved\":true}");
  }

  bool leafLogNetworkReady() {
    return user_app_enabled && !user_app_using_leaf_wifi && WiFi.status() == WL_CONNECTED;
  }

  bool ensureLeafLogTime() {
    time_t now = time(nullptr);
    if (now >= static_cast<time_t>(LEAF_LOG_TIME_MIN_EPOCH)) return true;

    configTime(0, 0, "pool.ntp.org", "time.nist.gov");
    const uint32_t start = millis();
    while (millis() - start < 8000) {
      delay(250);
      now = time(nullptr);
      if (now >= static_cast<time_t>(LEAF_LOG_TIME_MIN_EPOCH)) return true;
    }
    return false;
  }

  bool leafLogPostJson(const char* path, const String& body, int& statusCode, String& response) {
    WiFiClientSecure client;
    client.setCACert(ISRG_ROOT_X1_CA);

    HTTPClient http;
    String url = String(LEAF_LOG_BASE_URL) + path;
    if (!http.begin(client, url)) return false;
    http.setConnectTimeout(10000);
    http.setTimeout(15000);
    http.addHeader("Content-Type", "application/json");
    http.addHeader("Accept", "application/json");
    statusCode = http.POST(body);
    response = http.getString();
    http.end();
    return statusCode > 0;
  }

  bool loadProfilesForUpdate(JsonDocument& doc) {
    if (SD_MMC.exists(ProfileStore::filePath())) {
      File file = SD_MMC.open(ProfileStore::filePath(), "r");
      if (!file) return false;
      DeserializationError error = deserializeJson(doc, file);
      file.close();
      return !error;
    }

    DeserializationError error = deserializeJson(doc, emptyProfilesJson());
    return !error;
  }

  bool revokeLeafLogToken(const String& token) {
    if (!token.startsWith("llk_")) return false;
    WiFiClientSecure client;
    client.setCACert(ISRG_ROOT_X1_CA);
    HTTPClient http;
    if (!http.begin(client, String(LEAF_LOG_BASE_URL) + "/api/devices/revoke-self")) return false;
    http.setConnectTimeout(10000);
    http.setTimeout(15000);
    http.addHeader("Authorization", "Bearer " + token);
    const int statusCode = http.POST(nullptr, 0);
    http.end();
    return statusCode == 200 || statusCode == 401;
  }

  void sendLeafLogStatus(WebServer& target) {
    const auto credential = leaf_log_credentials::load();
    String json = "{\"linked\":";
    json += credential.linked() ? "true" : "false";
    json += ",\"reconnect_required\":";
    json += credential.reconnectRequired ? "true" : "false";
    json += ",\"account\":{\"handle\":\"";
    json += jsonEscape(credential.handle);
    json += "\",\"displayName\":\"";
    json += jsonEscape(credential.displayName);
    json += "\"}}";
    sendNoStoreHeaders(target);
    target.send(200, "application/json", json);
  }

  void sendDeviceMaintenanceStatus(WebServer& target) {
    String json = "{\"setup_repair_available\":";
    json += settings.commissioningRepairAvailable() ? "true" : "false";
    json += "}";
    sendNoStoreHeaders(target);
    target.send(200, "application/json", json);
  }

  void repairDeviceCommissioningState(WebServer& target) {
    const bool repairAvailable = settings.commissioningRepairAvailable();
    if (!settings.repairCommissioningState()) {
      sendNoStoreHeaders(target);
      target.send(409, "application/json",
                  "{\"detail\":\"This device is not eligible for automatic repair.\"}");
      return;
    }

    String json = "{\"repaired\":true,\"already_repaired\":";
    json += repairAvailable ? "false" : "true";
    json += ",\"setup_repair_available\":false}";
    sendNoStoreHeaders(target);
    target.send(200, "application/json", json);
  }

  void unlinkLeafLog(WebServer& target) {
    const auto credential = leaf_log_credentials::load();
    bool revoked = false;
    if (!credential.token.isEmpty() && leafLogNetworkReady() && ensureLeafLogTime()) {
      revoked = revokeLeafLogToken(credential.token);
    }
    leaf_log_credentials::clear();
    String json = "{\"unlinked\":true,\"server_revoked\":";
    json += revoked ? "true" : "false";
    json += "}";
    sendNoStoreHeaders(target);
    target.send(200, "application/json", json);
  }

  void startLeafLogPair(WebServer& target) {
    if (!leafLogNetworkReady()) {
      target.send(409, "application/json",
                  "{\"detail\":\"Leaf Log linking requires network WiFi mode.\"}");
      return;
    }

    if (!ensureLeafLogTime()) {
      target.send(503, "application/json",
                  "{\"detail\":\"Leaf could not set network time for TLS.\"}");
      return;
    }

    leaf_log_previous_token = leaf_log_credentials::load().token;
    int statusCode = 0;
    String response;
    if (!leafLogPostJson("/api/devices/pair/start", "{}", statusCode, response)) {
      target.send(502, "application/json", "{\"detail\":\"Leaf Log is unreachable.\"}");
      return;
    }

    JsonDocument doc;
    DeserializationError error = deserializeJson(doc, response);
    if (error || statusCode < 200 || statusCode >= 300) {
      target.send(502, "application/json", "{\"detail\":\"Leaf Log did not start pairing.\"}");
      return;
    }

    String code = doc["code"] | "";
    String pollHandle = doc["pollHandle"] | "";
    String expiresAt = doc["expiresAt"] | "";
    code.trim();
    pollHandle.trim();
    expiresAt.trim();
    if (code.isEmpty() || pollHandle.isEmpty()) {
      target.send(502, "application/json",
                  "{\"detail\":\"Leaf Log pairing response was invalid.\"}");
      return;
    }

    leaf_log_pair_code = code;
    leaf_log_poll_handle = pollHandle;
    leaf_log_pair_expires_at = expiresAt;

    String activationUrl = String(LEAF_LOG_BASE_URL) + "/activate?code=" + code;
    String json = "{\"ok\":true,\"code\":\"";
    json += jsonEscape(code);
    json += "\",\"activation_url\":\"";
    json += jsonEscape(activationUrl);
    json += "\",\"expires_at\":\"";
    json += jsonEscape(expiresAt);
    json += "\"}";
    sendNoStoreHeaders(target);
    target.send(200, "application/json", json);
  }

  void pollLeafLogPair(WebServer& target) {
    if (leaf_log_poll_handle.isEmpty()) {
      target.send(409, "application/json", "{\"detail\":\"No Leaf Log pairing is active.\"}");
      return;
    }

    if (!leafLogNetworkReady()) {
      target.send(409, "application/json",
                  "{\"detail\":\"Leaf Log linking requires network WiFi mode.\"}");
      return;
    }

    if (!ensureLeafLogTime()) {
      target.send(503, "application/json",
                  "{\"detail\":\"Leaf could not set network time for TLS.\"}");
      return;
    }

    String request = "{\"pollHandle\":\"";
    request += jsonEscape(leaf_log_poll_handle);
    request += "\"}";

    int statusCode = 0;
    String response;
    if (!leafLogPostJson("/api/devices/pair/poll", request, statusCode, response)) {
      target.send(502, "application/json", "{\"detail\":\"Leaf Log is unreachable.\"}");
      return;
    }

    JsonDocument doc;
    DeserializationError error = deserializeJson(doc, response);
    if (error || statusCode < 200 || statusCode >= 300) {
      target.send(502, "application/json", "{\"detail\":\"Leaf Log pairing poll failed.\"}");
      return;
    }

    String status = doc["status"] | "";
    String token = doc["token"] | "";
    JsonObject account = doc["account"];
    String handle = account["handle"] | "";
    String displayName = account["displayName"] | "";
    status.trim();
    token.trim();
    handle.trim();
    displayName.trim();
    bool saved = false;
    if (status == "claimed" && !token.isEmpty() && !handle.isEmpty() && !displayName.isEmpty()) {
      saved = leaf_log_credentials::store(token, handle, displayName);
      if (saved && !leaf_log_previous_token.isEmpty() && leaf_log_previous_token != token) {
        revokeLeafLogToken(leaf_log_previous_token);
      }
      leaf_log_previous_token = "";
      leaf_log_pair_code = "";
      leaf_log_poll_handle = "";
      leaf_log_pair_expires_at = "";
    } else if (status == "consumed" || status == "expired" || status == "unknown") {
      leaf_log_pair_code = "";
      leaf_log_poll_handle = "";
      leaf_log_pair_expires_at = "";
    }

    String json = "{\"status\":\"";
    json += jsonEscape(status);
    json += "\",\"saved\":";
    json += saved ? "true" : "false";
    if (saved) {
      json += ",\"account\":{\"handle\":\"";
      json += jsonEscape(handle);
      json += "\",\"displayName\":\"";
      json += jsonEscape(displayName);
      json += "\"}";
    }
    json += "}";
    sendNoStoreHeaders(target);
    target.send(200, "application/json", json);
  }

  void importRoute(WebServer& target) {
    heap_monitor::checkpoint("route-import-start");
    if (!user_app_enabled) {
      target.send(404, "application/json", "{\"detail\":\"Leaf Web App is not active.\"}");
      return;
    }

    if (!sdcard.isMounted()) {
      target.send(404, "application/json", "{\"detail\":\"SD card is not mounted.\"}");
      return;
    }

    const String body = target.arg("plain");
    if (body.length() == 0 || body.length() > ROUTE_IMPORT_REQUEST_MAX_BYTES) {
      target.send(400, "application/json", "{\"detail\":\"Route import request is invalid.\"}");
      return;
    }

    JsonDocument doc;
    DeserializationError error = deserializeJson(doc, body);
    if (error) {
      target.send(400, "application/json", "{\"detail\":\"Route import request is not JSON.\"}");
      return;
    }

    String name = doc["name"] | "";
    String data = doc["data"] | "";
    const bool activate = doc["activate"] | false;
    name.trim();
    data.trim();
    if (name.isEmpty() || data.isEmpty()) {
      target.send(400, "application/json", "{\"detail\":\"Route name and data are required.\"}");
      return;
    }
    doc.clear();

    route_store::ImportResult result;
    if (!route_store::importRouteText(name, data, activate, result)) {
      String json = "{\"saved\":";
      json += result.path.isEmpty() ? "false" : "true";
      json += ",\"detail\":\"";
      json += jsonEscape(result.error);
      json += "\"}";
      heap_monitor::checkpoint("route-import-fail");
      target.send(result.path.isEmpty() ? 400 : 500, "application/json", json);
      return;
    }

    String json = "{\"saved\":true,\"active\":";
    json += result.active ? "true" : "false";
    json += ",\"name\":\"";
    json += jsonEscape(name);
    json += "\",\"path\":\"";
    json += jsonEscape(result.path);
    json += "\",\"points\":";
    json += result.points;
    json += "}";
    heap_monitor::checkpoint("route-import-end");
    target.send(200, "application/json", json);
  }

  void sendNavData(WebServer& target) {
    heap_monitor::checkpoint("nav-data-start");
    if (!user_app_enabled) {
      target.send(404, "application/json", "{\"detail\":\"Leaf Web App is not active.\"}");
      return;
    }

    const bool includePoints = target.hasArg("points") && target.arg("points") == "1";
    target.setContentLength(CONTENT_LENGTH_UNKNOWN);
    const bool lowHeap = includePoints && (ESP.getFreeHeap() < NAV_POINTS_MIN_FREE_HEAP ||
                                           ESP.getMaxAllocHeap() < NAV_POINTS_MIN_MAX_ALLOC);
    target.send(lowHeap ? 503 : 200, "application/json", "");
    char responseBuffer[1024];
    JsonStream json(target, responseBuffer, sizeof(responseBuffer));
    json.write("{\"loaded_file\":\"");
    json.writeEscaped(navigator.loadedNavFilename());
    json.write("\",\"loaded_path\":\"");
    json.writeEscaped(navigator.loadedNavPath());
    json.write("\",\"point_count\":");
    json.writeUInt(navigator.loadedFileWaypointCount());
    json.write(",\"route_count\":");
    json.writeUInt(navigator.totalRoutes);
    json.write(",\"active_type\":\"");
    if (navigator.activeRouteIndex) {
      json.write("route");
    } else if (navigator.activeWaypointIndex) {
      json.write("point");
    }
    json.write("\",\"active_name\":\"");
    if (navigator.activeRouteIndex && navigator.activeRouteIndex <= navigator.totalRoutes) {
      json.writeEscaped(navigator.routes[navigator.activeRouteIndex].name);
    } else if (navigator.activeWaypointIndex) {
      json.writeEscaped(navigator.activePoint.name);
    }
    json.write("\"");
    if (!includePoints) {
      json.write("}");
      json.finish();
      heap_monitor::checkpoint("nav-data-end");
      return;
    }

    if (lowHeap) {
      json.write(",\"points_unavailable\":true,\"detail\":\"Unable to refresh waypoint list.\"}");
      json.finish();
      heap_monitor::checkpoint("nav-data-low-heap");
      return;
    }

    json.write(",\"points\":[");
    const uint8_t pointCount = navigator.loadedFileWaypointCount();
    for (uint8_t i = 1; i <= pointCount; i++) {
      const Waypoint& waypoint = navigator.waypoint(WaypointID(i));
      if (i > 1) json.write(",");
      json.write("{\"index\":");
      json.writeUInt(i);
      json.write(",\"name\":\"");
      json.writeEscaped(waypoint.name);
      json.write("\",\"lat\":");
      json.writeFloat(waypoint.latitude(), 7);
      json.write(",\"lon\":");
      json.writeFloat(waypoint.longitude(), 7);
      json.write(",\"alt_m\":");
      json.writeFloat(waypoint.ele, 1);
      json.write("}");
      if ((i & 0x07) == 0) yield();
    }
    json.write("]}");
    json.finish();
    heap_monitor::checkpoint("nav-data-end");
  }

  void activateNavPoint(WebServer& target) {
    if (!user_app_enabled) {
      target.send(404, "application/json", "{\"detail\":\"Leaf Web App is not active.\"}");
      return;
    }

    JsonDocument doc;
    DeserializationError error = deserializeJson(doc, target.arg("plain"));
    if (error) {
      target.send(400, "application/json", "{\"detail\":\"Nav activation request is not JSON.\"}");
      return;
    }

    const uint8_t index = doc["index"] | 0;
    if (index == 0 || index > navigator.totalWaypoints) {
      target.send(400, "application/json", "{\"detail\":\"Choose a valid waypoint.\"}");
      return;
    }

    if (!navigator.activatePoint(WaypointID(index), true)) {
      target.send(400, "application/json", "{\"detail\":\"Leaf could not activate this point.\"}");
      return;
    }

    String json = "{\"active\":true,\"index\":";
    json += index;
    json += ",\"name\":\"";
    json += jsonEscape(navigator.activePoint.name);
    json += "\"}";
    target.send(200, "application/json", json);
  }

  void sendWaypointFileList(WebServer& target) {
    if (!user_app_enabled) {
      target.send(404, "application/json", "{\"detail\":\"Leaf Web App is not active.\"}");
      return;
    }

    if (!sdcard.isMounted()) {
      target.send(404, "application/json", "{\"detail\":\"SD card is not mounted.\"}");
      return;
    }

    target.setContentLength(CONTENT_LENGTH_UNKNOWN);
    target.send(200, "application/json", "");
    char responseBuffer[1024];
    JsonStream json(target, responseBuffer, sizeof(responseBuffer));
    json.write("{\"files\":[");
    bool first = true;
    File dir = SD_MMC.open(WAYPOINTS_DIR);
    if (dir && dir.isDirectory()) {
      File entry = dir.openNextFile();
      while (entry) {
        if (!entry.isDirectory()) {
          const String name = filenameFromUploadPath(entry.name());
          if (supportedNavUploadExtension(lowerFileExtension(name))) {
            if (!first) json.write(",");
            first = false;
            json.write("{\"name\":\"");
            json.writeEscaped(name.c_str());
            json.write("\",\"path\":\"");
            json.writeEscaped(WAYPOINTS_DIR);
            json.write("/");
            json.writeEscaped(name.c_str());
            json.write("\"}");
          }
        }
        entry.close();
        entry = dir.openNextFile();
      }
    }
    if (dir) dir.close();
    json.write("]}");
    json.finish();
  }

  void activateWaypointFile(WebServer& target) {
    if (!user_app_enabled) {
      target.send(404, "application/json", "{\"detail\":\"Leaf Web App is not active.\"}");
      return;
    }

    if (!sdcard.isMounted()) {
      target.send(404, "application/json", "{\"detail\":\"SD card is not mounted.\"}");
      return;
    }

    JsonDocument doc;
    DeserializationError error = deserializeJson(doc, target.arg("plain"));
    if (error) {
      target.send(400, "application/json",
                  "{\"detail\":\"Waypoint activation request is invalid.\"}");
      return;
    }

    const String name = filenameFromUploadPath(doc["name"] | "");
    if (name.isEmpty() || !supportedNavUploadExtension(lowerFileExtension(name))) {
      target.send(400, "application/json", "{\"detail\":\"Choose a waypoint file.\"}");
      return;
    }

    const String path = String(WAYPOINTS_DIR) + "/" + name;
    if (!SD_MMC.exists(path)) {
      target.send(404, "application/json", "{\"detail\":\"Waypoint file was not found.\"}");
      return;
    }

    NavLoadError loadError;
    if (!nav_readFile(SD_MMC, path, &loadError)) {
      target.send(400, "application/json",
                  loadError == NavLoadError::RoutePointLimit
                      ? "{\"detail\":\"File exceeds the 20-point route limit.\"}"
                      : "{\"detail\":\"Leaf could not parse this waypoint file.\"}");
      return;
    }
    user_waypoints::loadIntoNavigator();

    String json = "{\"loaded\":true,\"filename\":\"";
    json += jsonEscape(name);
    json += "\",\"points\":";
    json += navigator.loadedFileWaypointCount();
    json += ",\"routes\":";
    json += navigator.totalRoutes;
    json += "}";
    target.send(200, "application/json", json);
  }

  void saveEditedRoute(WebServer& target) {
    heap_monitor::checkpoint("route-save-start");
    if (!user_app_enabled) {
      target.send(404, "application/json", "{\"detail\":\"Leaf Web App is not active.\"}");
      return;
    }

    if (!sdcard.isMounted()) {
      target.send(404, "application/json", "{\"detail\":\"SD card is not mounted.\"}");
      return;
    }

    const String body = target.arg("plain");
    if (body.length() == 0 || body.length() > ROUTE_EDITOR_REQUEST_MAX_BYTES) {
      target.send(400, "application/json", "{\"detail\":\"Route save request is invalid.\"}");
      return;
    }

    JsonDocument input;
    DeserializationError error = deserializeJson(input, body);
    if (error) {
      target.send(400, "application/json", "{\"detail\":\"Route save request is not JSON.\"}");
      return;
    }

    String name = input["name"] | "";
    name.trim();
    const bool activate = input["activate"] | true;
    JsonArrayConst inputPoints = input["points"].as<JsonArrayConst>();
    if (inputPoints.size() > maxRoutePointRefs) {
      target.send(400, "application/json", "{\"detail\":\"Route exceeds the 20-point limit.\"}");
      return;
    }
    if (name.isEmpty() || inputPoints.isNull() || inputPoints.size() == 0) {
      target.send(400, "application/json",
                  "{\"detail\":\"Route name and at least one waypoint are required.\"}");
      return;
    }

    JsonDocument routeDoc;
    JsonObject route = routeDoc.to<JsonObject>();
    route["schema"] = "leaf.route";
    route["schema_version"] = "v0.1.0";
    route["name"] = name;
    route["source_format"] = "leaf_web";
    route["task_type"] = "route";
    route["earth_model"] = "wgs84";
    route["goal"]["type"] = "cylinder";
    route["start"]["type"] = "none";
    route["start"]["time_gates"].to<JsonArray>();

    JsonArray points = route["points"].to<JsonArray>();
    uint8_t pointIndex = 0;
    const uint8_t totalPoints = inputPoints.size();
    for (JsonObjectConst inputPoint : inputPoints) {
      pointIndex++;
      const double lat = inputPoint["lat"] | NAN;
      const double lon = inputPoint["lon"] | NAN;
      if (isnan(lat) || isnan(lon) || lat < -90 || lat > 90 || lon < -180 || lon > 180) {
        target.send(400, "application/json",
                    "{\"detail\":\"Route contains an invalid waypoint coordinate.\"}");
        return;
      }

      uint16_t radiusM = inputPoint["radius_m"] | defaultWaypointRadius;
      if (radiusM == 0)
        radiusM = defaultWaypointRadius;
      else if (radiusM < 10)
        radiusM = 10;
      if (radiusM > 20000) radiusM = 20000;

      JsonObject outPoint = points.add<JsonObject>();
      outPoint["name"] = inputPoint["name"] | "";
      outPoint["lat"] = lat;
      outPoint["lon"] = lon;
      outPoint["alt_m"] = inputPoint["alt_m"] | NAN;
      outPoint["radius_m"] = radiusM;
      outPoint["role"] = pointIndex == totalPoints ? "goal" : "normal";
    }
    input.clear();

    route_store::ImportResult result;
    if (!route_store::saveRouteJson(routeDoc, activate, result)) {
      String json = "{\"saved\":";
      json += result.path.isEmpty() ? "false" : "true";
      json += ",\"detail\":\"";
      json += jsonEscape(result.error);
      json += "\"}";
      heap_monitor::checkpoint("route-save-fail");
      target.send(result.path.isEmpty() ? 400 : 500, "application/json", json);
      return;
    }
    if (result.active) user_waypoints::loadIntoNavigator();

    String json = "{\"saved\":true,\"active\":";
    json += result.active ? "true" : "false";
    json += ",\"name\":\"";
    json += jsonEscape(name);
    json += "\",\"path\":\"";
    json += jsonEscape(result.path);
    json += "\",\"points\":";
    json += result.points;
    json += "}";
    heap_monitor::checkpoint("route-save-end");
    target.send(200, "application/json", json);
  }

  void sendUserWaypoints(WebServer& target) {
    if (!user_app_enabled) {
      target.send(404, "application/json", "{\"detail\":\"Leaf Web App is not active.\"}");
      return;
    }

    if (!sdcard.isMounted()) {
      target.send(404, "application/json",
                  "{\"points\":[],\"detail\":\"SD card is not mounted.\"}");
      return;
    }

    JsonDocument doc;
    if (!SD_MMC.exists(user_waypoints::filePath())) {
      doc["schema"] = "leaf.user_waypoints";
      doc["schema_version"] = "v0.1.0";
      doc["points"].to<JsonArray>();
    } else {
      File file = SD_MMC.open(user_waypoints::filePath(), "r");
      if (!file) {
        target.send(404, "application/json",
                    "{\"points\":[],\"detail\":\"Unable to read user waypoints.\"}");
        return;
      }
      if (file.size() > USER_WAYPOINTS_MAX_BYTES) {
        file.close();
        target.send(404, "application/json",
                    "{\"points\":[],\"detail\":\"User waypoint file is too large.\"}");
        return;
      }
      DeserializationError error = deserializeJson(doc, file);
      file.close();
      if (error || strcmp(doc["schema"] | "", "leaf.user_waypoints") != 0) {
        target.send(404, "application/json",
                    "{\"points\":[],\"detail\":\"User waypoint file is invalid.\"}");
        return;
      }
    }

    target.setContentLength(CONTENT_LENGTH_UNKNOWN);
    target.send(200, "application/json", "");
    char responseBuffer[1024];
    JsonStream json(target, responseBuffer, sizeof(responseBuffer));
    json.write("{\"points\":[");
    bool first = true;
    for (JsonObjectConst point : doc["points"].as<JsonArrayConst>()) {
      const double lat = point["lat"] | NAN;
      const double lon = point["lon"] | NAN;
      if (!validUserWaypointJson(point)) continue;
      const uint8_t navigatorIndex = mergeUserWaypointIntoNavigator(point);

      if (!first) json.write(",");
      first = false;
      json.write("{\"id\":\"");
      json.writeEscaped(point["id"] | "");
      json.write("\",\"index\":");
      json.writeUInt(navigatorIndex);
      json.write(",\"name\":\"");
      json.writeEscaped(point["name"] | "");
      json.write("\",\"lat\":");
      json.writeFloat(lat, 7);
      json.write(",\"lon\":");
      json.writeFloat(lon, 7);
      json.write(",\"alt_m\":");
      json.writeFloat(point["alt_m"] | NAN, 1);
      json.write(",\"created_utc\":\"");
      json.writeEscaped(point["created_utc"] | "");
      json.write("\"}");
    }
    json.write("]}");
    json.finish();
  }

  void saveUserWaypoints(WebServer& target) {
    if (!user_app_enabled) {
      target.send(404, "application/json", "{\"detail\":\"Leaf Web App is not active.\"}");
      return;
    }

    JsonDocument input;
    DeserializationError error = deserializeJson(input, target.arg("plain"));
    if (error) {
      target.send(400, "application/json", "{\"detail\":\"User waypoint request is not JSON.\"}");
      return;
    }

    String detail;
    if (!user_waypoints::renameFromJson(input, detail)) {
      String json = "{\"saved\":false,\"detail\":\"";
      json += jsonEscape(detail);
      json += "\"}";
      target.send(400, "application/json", json);
      return;
    }

    user_waypoints::loadIntoNavigator();
    target.send(200, "application/json", "{\"saved\":true}");
  }

  void deleteUserWaypoint(WebServer& target) {
    if (!user_app_enabled) {
      target.send(404, "application/json", "{\"detail\":\"Leaf Web App is not active.\"}");
      return;
    }

    String id = target.arg("id");
    id.trim();
    String detail;
    if (!user_waypoints::deleteById(id.c_str(), detail)) {
      String json = "{\"deleted\":false,\"detail\":\"";
      json += jsonEscape(detail);
      json += "\"}";
      target.send(400, "application/json", json);
      return;
    }

    target.send(200, "application/json", "{\"deleted\":true}");
  }

  void sendRedirect(WebServer& target, const char* location) {
    sendNoStoreHeaders(target);
    target.sendHeader("Location", location, true);
    target.send(302, "text/plain", "");
  }

  bool handleCaptivePortalRequest(WebServer& target) {
    if (!user_app_using_leaf_wifi) return false;
    sendRedirect(target, user_app_provisioning ? "/wifi" : "/app");
    return true;
  }

  void sendNoCaptivePortalResponse(WebServer& target, const char* body = "") {
    if (handleCaptivePortalRequest(target)) return;
    if (strlen(body) == 0) {
      target.send(204, "text/plain", "");
    } else {
      target.send(200, "text/plain", body);
    }
  }

  void sendUserAppShell(WebServer& target) {
    if (!user_app_enabled) {
      target.send(404, "text/plain", "Leaf Web App is not active.");
      return;
    }
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
