DangerMonkeys/leaf/src/vario/power.cpp

// Includes
#include "power.h"

#include "battery_characterization.h"
#include "comms/ble.h"
#include "comms/leaf_log_sync.h"
#include "diagnostics/diagnostic_network/diagnostic_network.h"
#include "diagnostics/heap_monitor.h"
#include "hardware/Leaf_I2C.h"
#include "hardware/Leaf_SPI.h"
#include "hardware/aht20.h"
#include "hardware/buttons.h"
#include "hardware/configuration.h"
#include "hardware/io_pins.h"
#include "hardware/lc86g.h"
#include "hardware/motion_sensor.h"
#include "hardware/ms5611.h"
#include "instruments/baro.h"
#include "instruments/gps.h"
#include "instruments/imu.h"
#include "logbook/logbook_io.h"
#include "logging/buslog.h"
#include "logging/log.h"
#include "power.h"
#include "storage/sd_card.h"
#include "system/shutdown_guard.h"
#include "system/usb_state.h"
#include "ui/audio/sound_effects.h"
#include "ui/audio/speaker.h"
#include "ui/display/display.h"
#include "ui/display/display_fields.h"
#include "ui/display/pages/dialogs/page_alert_autoOff.h"
#include "ui/input/buttons.h"
#include "ui/settings/settings.h"
#include "utils/magic_enum.h"

// Alert page to warn if auto-off is about to occur
PageAlertAutoOff pageAlertAutoOff;

Power power;  // struct for battery-state and on-state variables

// Pinout for Leaf V3.2.0+
#define POWER_LATCH shutdown_guard::LATCH_PIN
#define BATT_SENSE 1  // INPUT ADC

// Battery Threshold values
#define BATT_FULL_MV 4080   // mV full battery on which to base % full (100%)
#define BATT_EMPTY_MV 3250  // mV empty battery on which to base % full (0%)
#define BATT_SHUTDOWN_MV 3200
// mV at which to shutdown the system to prevent battery over-discharge
// Note: the battery apparently also has over discharge protection, but we don't fully trust it,
// plus we want to shutdown while we have power to save logs etc

// Auto-Power-Off Threshold values
#define AUTO_OFF_MAX_SPEED 3   // mph max -- must be below this speed for timer to auto-stop
#define AUTO_OFF_MAX_ACCEL 10  // Max accelerometer signal
#define AUTO_OFF_MAX_ALT 400   // cm altitude change for timer auto-stop

const char* nameOf(PowerInputLevel level) {
  switch (level) {
    case PowerInputLevel::Standby:
      return "Standby";
    case PowerInputLevel::i100mA:
      return "100mA";
    case PowerInputLevel::i500mA:
      return "500mA";
    case PowerInputLevel::Max:
      return "Max";
  }
  return "Unknown";
}

void Power::bootUp() {
  heap_monitor::checkpoint("power-boot-start");
  // Init Peripheral Busses
  wire_init();
  heap_monitor::checkpoint("power-wire");
  Serial.println(" - Finished I2C Wire");
  spi_init();
  heap_monitor::checkpoint("power-spi");
  Serial.println(" - Finished SPI");

  // initialize IO expander (needed for speaker in v3.2.5+ and power supply in v3.2.6+)
#ifdef HAS_IO_EXPANDER
  ioexInit();  // initialize IO Expander
  heap_monitor::checkpoint("power-ioex");
  Serial.println(" - Finished IO Expander");
#endif

  initPowerSystem();  // configure power supply
  heap_monitor::checkpoint("power-system");

  // initialize Buttons and check if holding the center button is what turned us on
  Button button = buttons.init();
  heap_monitor::checkpoint("power-buttons");

  // go to "ON" state if button (user input) or BOOT_TO_ON flag from firmware update
  if (shutdown_guard::recovering()) {
    // A watchdog reset during shutdown must not boot into flying mode, even
    // while the center button is held or an OTA boot-to-on flag is persisted.
    settings.boot_toOnState = false;
    settings.save();
    buttons.suppressEventsUntilRelease();
    info_.onState = PowerState::OffUSB;
    display.setPage(MainPage::Charging);
  } else if (button == Button::CENTER || settings.boot_toOnState) {
    settings.boot_toOnState = false;
    settings.save();

    info_.onState = PowerState::On;

    display.showOnSplash();  // show the splash screen if user turned us on
    heap_monitor::checkpoint("power-splash");
    display.setPage((MainPage)settings.startPage);
    heap_monitor::checkpoint("power-start-page");

    maybeStartBusLog();
  } else {
    // if not center button, then USB power turned us on, go into charge mode
    info_.onState = PowerState::OffUSB;
    display.setPage(MainPage::Charging);
  }

  // init peripherals (even if we're not turning on and just going into
  // charge mode, we still need to initialize devices so we can put some
  // of them back to sleep)
  initPeripherals();
  heap_monitor::checkpoint("power-boot-end");
}

void Power::initPowerSystem() {
  heap_monitor::checkpoint("power-system-start");
  Serial.print("power_init: ");
  Serial.println(nameOf(info_.onState));

  // Set output / input pins to control battery charge and power supply
  pinMode(BATT_SENSE, INPUT);
  pinMode(POWER_LATCH, OUTPUT);
  if (!POWER_CHARGE_I1_IOEX) pinMode(POWER_CHARGE_I1, OUTPUT);
  if (!POWER_CHARGE_I2_IOEX) pinMode(POWER_CHARGE_I2, OUTPUT);
  if (!POWER_CHARGE_GOOD_IOEX) pinMode(POWER_CHARGE_GOOD, INPUT_PULLUP);
  // POWER_GOOD is only available on v3.2.6+ on IOexpander, so not set here

  // set default current limit for charger input
  setInputCurrent(PowerInputLevel::i500mA);
  heap_monitor::checkpoint("power-system-pins");

#ifdef LED_PIN
  pinMode(LED_PIN, OUTPUT);  // LED power status indicator
#endif

#ifdef ISET
  pinMode(ISET, INPUT);  // pin to read actual charge current (if used)
#endif
}

void Power::initPeripherals() {
  heap_monitor::checkpoint("periph-start");
  Serial.print("init_peripherals: ");
  Serial.println(nameOf(info_.onState));

  if (info_.onState == PowerState::On) {
    latchOn();
    speaker.playSound(fx::enter);
    // loop until sound is done playing
    while (speaker.update()) {
      delay(10);
    }
    heap_monitor::checkpoint("periph-enter-sound");
  } else {
    latchOff();  // turn off 3.3V regulator (if we're plugged into USB, we'll stay on)
  }

  // then initialize the rest of the devices
  // The SD LUN starts absent in every power state. Charging mode runs Leaf Log first and explicitly
  // presents the card; operating mode retains exclusive firmware ownership.
  sdcard.init(true);
  if (info_.onState == PowerState::On) {
    leafLogSync.prepareForOperating();
    leaf_usb::disconnect();
  } else {
    leafLogSync.prepareForCharging();
  }
  heap_monitor::checkpoint("periph-sd");
  Serial.println(" - Finished SDcard");
  lc86g.init();
  heap_monitor::checkpoint("periph-lc86g");
  gps.init();
  heap_monitor::checkpoint("periph-gps");
  Serial.println(" - Finished GPS");
  wire_init();
  heap_monitor::checkpoint("periph-wire");
  Serial.println(" - Finished I2C Wire");
  display.init();
  heap_monitor::checkpoint("periph-display");
  Serial.println(" - Finished display");
  ms5611.init();
  heap_monitor::checkpoint("periph-baro");
  Serial.println(" - Finished Baro");
  MotionSensor::getInstance().init();
  heap_monitor::checkpoint("periph-imu");
  Serial.println(" - Finished IMU");

  // then put devices to sleep if we're in PowerState::OffUSB
  // (plugged into USB but vario not actively turned on)
  if (info_.onState == PowerState::OffUSB) {
    sleepPeripherals();
  }
  heap_monitor::checkpoint("periph-end");
  Serial.println(" - DONE");
}

void Power::sleepPeripherals() {
  Serial.print("sleep_peripherals: ");
  Serial.println(nameOf(info_.onState));
  // TODO: all the rest of the peripherals not needed while charging
  Serial.println(" - Sleeping GPS");
  lc86g.sleep();
  Serial.println(" - Sleeping baro");
  baro.sleep();
  MotionSensor::getInstance().sleep();
  imu.wake(GLoadTracker::ResetReason::Sleep);  // Invalidate before any subsequent wake.
  Serial.println(" - Sleeping speaker");
  speaker.mute();
  Serial.println("Shut down speaker");
  Serial.println(" - DONE");
}

void Power::wakePeripherals() {
  heap_monitor::checkpoint("wake-periph-start");
  Serial.println("wake_peripherals: ");
  heap_monitor::checkpoint("wake-periph-sd");
  Serial.println(" - waking GPS");
  lc86g.wake();
  heap_monitor::checkpoint("wake-periph-gps");
  Serial.println(" - waking baro and IMU");
  baro.wake();
  imu.wake(GLoadTracker::ResetReason::Wake);
  MotionSensor::getInstance().wake();
  heap_monitor::checkpoint("wake-periph-baro-imu");
  Serial.println(" - waking speaker");
  speaker.unMute();
  heap_monitor::checkpoint("wake-periph-speaker");
  Serial.println(" - DONE");
}

bool Power::switchToOnState() {
  if (!sdcard.acquireForFirmwareUse(2000, true)) {
    Serial.println("switch_to_on_state: SD ownership transition failed");
    return false;
  }
  leafLogSync.prepareForOperating();
  latchOn();
  Serial.println("switch_to_on_state");
  info_.onState = PowerState::On;
  wakePeripherals();
  if (settings.system_bluetoothOn) BLE::get().start();
  if (diagnostic_network.shouldResetWhenSwitchingOn()) {
    diagnostic_network.reset("switch_to_on_state");
  }
  maybeStartBusLog();
  return true;
}

void Power::maybeStartBusLog() {
  if (settings.dev_startLogAtBoot) {
    Serial.println("Starting bus log at startup");
    if (busLog.startLog()) {
      Serial.println("Started bus log at startup");
    } else {
      Serial.println("Failed to start bus log at startup");
      speaker.playSound(fx::bad);
    }
  }
}
void Power::shutdown() { shutdown(false); }

void Power::shutdown(bool deadBattery) {
  // Arm before ANY lock, SD write, or driver cleanup can block the loop.
  shutdown_guard::begin();
  shutdown_guard::faultPoint(shutdown_guard::Stage::Lock);
  // Finish an already-running logbook operation before shutdown starts, and prevent
  // another reader/save from crossing the final-save/power-latch boundary.
  logbook_io::Guard transaction(true);
  Serial.println("power_shutdown");

  switch (display.getPage()) {
    case MainPage::Debug:
    case MainPage::Basic:
    case MainPage::User:
    case MainPage::ThermalCore:
    case MainPage::ThermalTrack:
    case MainPage::Navigate:
      settings.startPage = (uint8_t)display.getPage();
      break;
    default:
      break;
  }

  // save logs and system data
  shutdown_guard::stage(shutdown_guard::Stage::Flight);
  shutdown_guard::faultPoint(shutdown_guard::Stage::Flight);
  flightTimer_stop(false, deadBattery ? FlightEndCause::LowBattery : FlightEndCause::PowerOff);
  shutdown_guard::stage(shutdown_guard::Stage::BusLog);
  busLog.endLog();
  shutdown_guard::stage(shutdown_guard::Stage::Settings);
  settings.save();

  // Show user we're shutting down
  shutdown_guard::stage(shutdown_guard::Stage::Display);
  display.clearPage();
  if (deadBattery) {
    display_batteryDead_splash();
  } else {
    display_off_splash();
  }

  shutdown_guard::stage(shutdown_guard::Stage::BleWorker);
  shutdown_guard::faultPoint(shutdown_guard::Stage::BleWorker);
  if (!BLE::get().quiesce()) shutdown_guard::force(shutdown_guard::Reason::WorkerTimeout);
  shutdown_guard::stage(shutdown_guard::Stage::Sound);
  shutdown_guard::faultPoint(shutdown_guard::Stage::Sound);
  baro.sleep();  // stop getting climbrate updates so we don't hear vario beeps while shutting down

  // play shutdown sound
  speaker.playSound(fx::exit);

  // loop until sound is done playing
  const uint32_t soundStartedMs = millis();
  while (speaker.update() && millis() - soundStartedMs < 1000) {
    delay(10);
  }

  // wait another 2.5 seconds before shutting down to give user
  // a chance to see the shutdown screen
  delay(2500);

  // finally, turn off devices
  shutdown_guard::stage(shutdown_guard::Stage::Peripherals);
  shutdown_guard::faultPoint(shutdown_guard::Stage::Peripherals);
  sleepPeripherals();
  shutdown_guard::stage(shutdown_guard::Stage::Sleeping);
  shutdown_guard::faultPoint(shutdown_guard::Stage::Sleeping);
  display.clear();
  delay(100);
  shutdown_guard::stage(shutdown_guard::Stage::Latch);
  shutdown_guard::faultPoint(shutdown_guard::Stage::Latch);
  latchOff();  // turn off 3.3V regulator (if we're plugged into USB, we'll stay on)
  delay(100);
  shutdown_guard::stage(shutdown_guard::Stage::LatchReleased);
  shutdown_guard::faultPoint(shutdown_guard::Stage::LatchReleased);

  // go to PowerState::OffUSB, in case device was shut down while
  // plugged into USB, then we can show necessary charging updates etc
  info_.onState = PowerState::OffUSB;
  // Battery power is already released. Only USB (or a held button) keeps the
  // processor alive here, so expensive NimBLE deinit cannot prevent latch-off.
  shutdown_guard::stage(shutdown_guard::Stage::BleDeinit);
  shutdown_guard::faultPoint(shutdown_guard::Stage::BleDeinit);
  BLE::get().end();
  display.setPage(MainPage::Charging);
  shutdown_guard::stage(shutdown_guard::Stage::Charging);
  if (sdcard.acquireForFirmwareUse()) {
    leafLogSync.prepareForCharging();
  } else {
    Serial.println("power_shutdown: SD unavailable for charging transition");
  }
  shutdown_guard::complete();
}

void Power::latchOn() { digitalWrite(POWER_LATCH, HIGH); }

void Power::latchOff() { digitalWrite(POWER_LATCH, LOW); }

void Power::update() {
  // first check for USB power and turn on LED if so
  // (only for v3.2.6+ with controllable LED and PowerGood input)
#ifdef LED_PIN
  info_.USBinput = !ioexDigitalRead(POWER_GOOD_IOEX, POWER_GOOD);
  if (info_.USBinput) {
    digitalWrite(LED_PIN, LOW);  // turn on LED if charging
  } else {
    digitalWrite(LED_PIN, HIGH);  // turn off LED if not charging
  }
#endif

  // update battery state
  readBatteryState();

  // check if we should shut down due to low battery..
  // TODO: should we only do this if we're NOT charging?
  //       Probably not, since shutting down allows more current for charging
  if (info_.batteryMV <= BATT_SHUTDOWN_MV) {
#ifndef DISABLE_BATTERY_SHUTDOWN
    shutdown(true);
#endif

    // ..or if we should shutdown due to inactivity
    // (only check if user setting is on and flight timer is stopped)
  } else if (settings.system_autoOff && !flightTimer_isRunning()) {
    // check if inactivity conditions are met
    if (autoOff()) {
      shutdown();  // shutdown!
    }
  }
}

bool showingAlertAutoOff = false;

void Power::resetAutoOffCounter() {
  autoOffCounter_ = 0;
  if (showingAlertAutoOff) {
    buttons.consumeButton();
    pageAlertAutoOff.closeAlert();  // close the alert if it's open, since we're shutting down now
    showingAlertAutoOff = false;    // reset alert page flag so it can show again after this reset
  }
}

uint16_t Power::getAutoOffSecondsRemaining() {
  return (settings.system_autoOff * 60 - autoOffCounter_);
}

bool Power::autoOff() {
  bool autoShutOff = false;  // start with assuming we're not going to turn off

  autoOffCounter_++;
  if (autoOffCounter_ >= settings.system_autoOff * 60) {  // convert minutes to seconds
    autoShutOff = true;
  } else if (autoOffCounter_ >= settings.system_autoOff * 60 - 10) {
    // start playing warning sounds 10 seconds before it auto-turns off
    speaker.playSound(fx::decrease);

    // and pop up the alert if we have 10 seconds left
    if (autoOffCounter_ == settings.system_autoOff * 60 - 10 && !showingAlertAutoOff) {
      pageAlertAutoOff.show();  // show alert page with countdown until auto-off
      showingAlertAutoOff = true;
    }
  }
  if (autoShutOff) {
    pageAlertAutoOff.closeAlert();  // close the alert if it's open, since we're shutting down now
    showingAlertAutoOff =
        false;  // reset alert page flag for next time we turn on and start counting
  }
  return autoShutOff;
}

void Power::readBatteryState() {
  // Update Charge State
  info_.charging = !ioexDigitalRead(POWER_CHARGE_GOOD_IOEX, POWER_CHARGE_GOOD);
  // logic low is charging, logic high is not

  info_.chargeCurrentMA = 0;
#ifdef ISET
  // V_ISET = (I_CHARGE / 400) * R_ISET note: R_ISET is 1100 Ohms
  info_.chargeCurrentMA = analogReadMilliVolts(ISET) * 400 / 1100;
#endif

  // Test internal calibration of ADC:
  info_.batteryMV = analogReadMilliVolts(BATT_SENSE) * 69 / 41;

  // The ISET current measurement is available on v3.2.6+; earlier variants estimate the charge
  // current from terminal voltage instead. Never compensate the raw voltage used for shutdown.
  const uint16_t percentMV =
      battery_characterization::voltageForPercent(info_.batteryMV, info_.charging,
#ifdef ISET
                                                  true,
#else
                                                  false,
#endif
                                                  info_.chargeCurrentMA);

  if (percentMV < BATT_EMPTY_MV) {
    info_.batteryPercent = 0;
  } else if (percentMV > BATT_FULL_MV) {
    info_.batteryPercent = 100;
  } else {
    info_.batteryPercent = 100 * (percentMV - BATT_EMPTY_MV) / (BATT_FULL_MV - BATT_EMPTY_MV);
  }

  // use a 2% hysteresis on battery% to avoid rapid fluctuations as ADC values change
  if (info_.charging) {  // don't let % go down (within 2%) when charging
    if (info_.batteryPercent < batteryPercentLast_ &&
        info_.batteryPercent >= batteryPercentLast_ - 2) {
      info_.batteryPercent = batteryPercentLast_;
    }
  } else {  // don't let % go up (within 2%) when discharging
    if (info_.batteryPercent > batteryPercentLast_ &&
        info_.batteryPercent <= batteryPercentLast_ + 2) {
      info_.batteryPercent = batteryPercentLast_;
    }
  }
  batteryPercentLast_ = info_.batteryPercent;
}

void Power::increaseInputCurrent() { setInputCurrent(++info_.inputCurrent); }

void Power::decreaseInputCurrent() { setInputCurrent(--info_.inputCurrent); }

// Note: the Battery Charger Chip has controllable input current (which is then used for both batt
// charging AND system load).  The battery will be charged with whatever current is remaining
// after system load.
void Power::setInputCurrent(PowerInputLevel current) {
  info_.inputCurrent = current;
  switch (current) {
    case PowerInputLevel::i100mA:
      ioexDigitalWrite(POWER_CHARGE_I1_IOEX, POWER_CHARGE_I1, LOW);
      ioexDigitalWrite(POWER_CHARGE_I2_IOEX, POWER_CHARGE_I2, LOW);
      break;
    default:
    case PowerInputLevel::i500mA:
      // set I2 to low first, so we don't accidentally have both set to High (if coming from iMax)
      ioexDigitalWrite(POWER_CHARGE_I2_IOEX, POWER_CHARGE_I2, LOW);
      ioexDigitalWrite(POWER_CHARGE_I1_IOEX, POWER_CHARGE_I1, HIGH);
      break;
    case PowerInputLevel::Max:
      // Approx 1.348A max input current (set by ILIM pin resistor value).
      // In this case, battery charging will then be limited by the max fast-charge limit
      // set by the ISET pin resistor value (approximately 810mA to the battery).
      ioexDigitalWrite(POWER_CHARGE_I1_IOEX, POWER_CHARGE_I1, LOW);
      ioexDigitalWrite(POWER_CHARGE_I2_IOEX, POWER_CHARGE_I2, HIGH);
      break;
    case PowerInputLevel::Standby:
      // USB Suspend mode - turns off USB input power (no charging or supplemental
      // power, but battery can still power the system)
      ioexDigitalWrite(POWER_CHARGE_I1_IOEX, POWER_CHARGE_I1, HIGH);
      ioexDigitalWrite(POWER_CHARGE_I2_IOEX, POWER_CHARGE_I2, HIGH);
      break;
  }
  Serial.print("set input current: ");
  Serial.println(nameOf(current));
}
