DangerMonkeys/leaf/src/vario/instruments/imu.cpp

#include "instruments/imu.h"

#include "instruments/vario_timing.h"

#include "dispatch/message_types.h"
#include "hardware/Leaf_I2C.h"
#include "logging/log.h"
#include "logging/telemetry.h"
#include "math/gravity_projection.h"
#include "math/kalman.h"
#include "storage/sd_card.h"
#include "utils/const_math.h"

// Singleton IMU instance for device
IMU imu;

namespace {
  // === What to display on the serial port
  // #define ALIGN_TEXT 3  // When set, puts values in equal-width columns with this many digits
  // #define SHOW_QUATERNION  // When set, print the components of the orientation quaternion
  // #define SHOW_DEVICE_ACCEL    // When set, print the components of the device-frame acceleration
  // #define SHOW_WORLD_ACCEL     // When set, print the components of the world-frame acceleration
  // #define SHOW_VERTICAL_ACCEL  // When set, print the vertical acceleration (with gravity
  // removed) #define SHOW_FIXED_BOUNDS 0.2  // When set, print fixed values to keep the Arduino
  // serial plot in a consistent range

  // == Estimation of constant gravity acceleration ==
  constexpr double NEW_MEASUREMENT_WEIGHT = 0.9;  // Weight given to new measurements...
  constexpr double AFTER_SECONDS = 5.0;           // ...after this number of seconds
  constexpr double K_UPDATE = constexpr_log(1 - NEW_MEASUREMENT_WEIGHT) / AFTER_SECONDS;

  constexpr double MIN_GRAVITY_G = 0.9;
  constexpr double MAX_GRAVITY_G = 1.1;
  constexpr double MIN_GRAVITY_ESTIMATE_G = 0.94;
  constexpr double MAX_GRAVITY_ESTIMATE_G = 1.06;
  // Shared sample windows for legacy gravity learning and SFLP bias learning. On SFLP they
  // gate bias learning only; climb prediction and data validity remain separate.
  constexpr double GRAVITY_UPDATE_ACCEL_TOLERANCE_G = 0.065;
  constexpr double GRAVITY_UPDATE_VERTICAL_TOLERANCE_G = 0.10;
  constexpr double GRAVITY_UPDATE_MAX_SLEW_G_PER_S = 0.05;
  constexpr uint8_t IMU_SAMPLE_RATE = 20;  // Hz
  constexpr uint16_t GRAVITY_RECOVERY_VERTICAL_REJECT_SAMPLES = IMU_SAMPLE_RATE * 2;
  constexpr uint16_t KALMAN_STARTUP_REPORT_SAMPLES = IMU_SAMPLE_RATE;
  constexpr uint16_t STARTUP_NON_VERT_SAMPLES = IMU_SAMPLE_RATE;
  constexpr uint32_t STARTUP_IMU_MAX_READINESS_MS = 8000;
  constexpr uint32_t BIAS_LEARNING_RECOVERY_MS = 2000;

  bool normalizeQuaternion(double* qw, double* qx, double* qy, double* qz) {
    double qVecMagnitude2 = (*qx * *qx) + (*qy * *qy) + (*qz * *qz);
    if (isnan(qVecMagnitude2) || isinf(qVecMagnitude2) || qVecMagnitude2 > 1.05) {
      return false;
    }

    if (qVecMagnitude2 > 1.0) {
      qVecMagnitude2 = 1.0;
    }

    *qw = sqrt(1.0 - qVecMagnitude2);

    double qMagnitude = sqrt((*qw * *qw) + (*qx * *qx) + (*qy * *qy) + (*qz * *qz));
    if (isnan(qMagnitude) || isinf(qMagnitude) || qMagnitude < 0.5) {
      return false;
    }

    *qw /= qMagnitude;
    *qx /= qMagnitude;
    *qy /= qMagnitude;
    *qz /= qMagnitude;
    return true;
  }

  bool plausibleGravity(double gravity) {
    double magnitude = fabs(gravity);
    return !isnan(gravity) && !isinf(gravity) && magnitude >= MIN_GRAVITY_G &&
           magnitude <= MAX_GRAVITY_G;
  }

  double clampGravityEstimate(double gravity) {
    if (gravity < MIN_GRAVITY_ESTIMATE_G) return MIN_GRAVITY_ESTIMATE_G;
    if (gravity > MAX_GRAVITY_ESTIMATE_G) return MAX_GRAVITY_ESTIMATE_G;
    return gravity;
  }
}  // namespace

void quaternionMult(double qw, double qx, double qy, double qz, double rw, double rx, double ry,
                    double rz, double* pw, double* px, double* py, double* pz) {
  *pw = rw * qw - rx * qx - ry * qy - rz * qz;
  *px = rw * qx + rx * qw - ry * qz + rz * qy;
  *py = rw * qy + rx * qz + ry * qw - rz * qx;
  *pz = rw * qz - rx * qy + ry * qx + rz * qw;
}

void rotateByQuaternion(double px, double py, double pz, double qw, double qx, double qy, double qz,
                        double* p1x, double* p1y, double* p1z) {
  double qrw, qrx, qry, qrz, qcw;
  quaternionMult(qw, qx, qy, qz, 0, px, py, pz, &qrw, &qrx, &qry, &qrz);
  quaternionMult(qrw, qrx, qry, qrz, qw, -qx, -qy, -qz, &qcw, p1x, p1y, p1z);
}

inline void printFloat(double v) {
#ifdef ALIGN_TEXT
  if (v >= 0) {
    Serial.print(' ');
  }
  const int digits = ALIGN_TEXT;
#else
  const int digits = 4;
#endif
  Serial.print(v, digits);
}

IMU::IMU()
    : kalmanvert_(pow(POSITION_MEASURE_STANDARD_DEVIATION, 2),
                  pow(ACCELERATION_MEASURE_STANDARD_DEVIATION, 2)),
      kalmanStartupSamplesRemaining_(KALMAN_STARTUP_REPORT_SAMPLES) {}

void IMU::processMotion(const MotionUpdate& m) {
  double qw = 0;
  double qx = m.qx;
  double qy = m.qy;
  double qz = m.qz;
  if (!normalizeQuaternion(&qw, &qx, &qy, &qz)) {
    motionSampleRejectedQuaternionCount_++;
    validAccelVert_ = false;
    return;
  }
  motionSampleProcessedCount_++;
  lastMotionTime_ = m.t;
  lastQuatX_ = qx;
  lastQuatY_ = qy;
  lastQuatZ_ = qz;

  bool needComma = false;
  bool needNewline = false;

#ifdef SHOW_QUATERNION
  Serial.print(F("Qw:"));
  printFloat(qw);
  Serial.print(F(",Qx:"));
  printFloat(qx);
  Serial.print(F(",Qy:"));
  printFloat(qy);
  Serial.print(F(",Qz:"));
  printFloat(qz);
  needComma = true;
  needNewline = true;
#endif

  accelTot_ = sqrt(m.ax * m.ax + m.ay * m.ay + m.az * m.az);
  validAccelTot_ = true;
  gLoad_.addSample((float)accelTot_, m.t, 4.0f * 1.732051f);
  lastDeviceAccelX_ = m.ax;
  lastDeviceAccelY_ = m.ay;
  lastDeviceAccelZ_ = m.az;

#ifdef SHOW_DEVICE_ACCEL
  if (needComma) {
    Serial.print(',');
  }
  Serial.print(F("Ax:"));
  printFloat(m.ax);
  Serial.print(F(",Ay:"));
  printFloat(m.ay);
  Serial.print(F(",Az:"));
  printFloat(m.az);
  needComma = true;
  needNewline = true;
#endif

  double awx, awy, awz;
  rotateByQuaternion(m.ax, m.ay, m.az, qw, qx, qy, qz, &awx, &awy, &awz);
  if (isinf(awz) || isnan(awz)) {
    fatalErrorInfo(
        "m.ax=%g, m.ay=%g, m.az=%g, qw=%g, m.qx=%g, m.qy=%g, m.qz=%g, awx=%g, awy=%g, awz=%g", m.ax,
        m.ay, m.az, qw, qx, qy, qz, awx, awy, awz);
    fatalError("IMU awz was invalid");
  }
  lastWorldAccelX_ = awx;
  lastWorldAccelY_ = awy;
  lastWorldVerticalAccel_ = awz;
  validLastWorldVerticalAccel_ = true;

#ifdef SHOW_WORLD_ACCEL
  if (needComma) {
    Serial.print(',');
  }
  Serial.print("Wx:");
  printFloat(awx);
  Serial.print(",Wy:");
  printFloat(awy);
  Serial.print(",Wz:");
  printFloat(awz);
  needComma = true;
  needNewline = true;
#endif

#ifdef SHOW_FIXED_BOUNDS
  if (needComma) {
    Serial.print(',');
  }
  Serial.print("min:");
  printFloat(SHOW_FIXED_BOUNDS);
  Serial.print(",max:");
  printFloat(-SHOW_FIXED_BOUNDS);
  needNewline = true;
#endif

  // In steady-state (normally), actual vertical acceleration is the difference between measured
  // vertical acceleration and gravity
  accelVert_ = awz - gravity_;
  kalmanAccelVert_ = accelVert_;
  validAccelVert_ = true;

  // Slowly update estimate of gravity
  gravityUpdateCandidateCount_++;
  double accelMagnitudeDelta = fabs(accelTot_ - 1.0);
  double verticalDelta = fabs(accelVert_);
  if (accelMagnitudeDelta > GRAVITY_UPDATE_ACCEL_TOLERANCE_G) {
    gravityUpdateRejectedAccelCount_++;
    gravityVerticalRejectCount_ = 0;
  } else if (verticalDelta > GRAVITY_UPDATE_VERTICAL_TOLERANCE_G) {
    gravityUpdateRejectedVerticalCount_++;
    kalmanAccelVert_ = 0.0;
    if (++gravityVerticalRejectCount_ >= GRAVITY_RECOVERY_VERTICAL_REJECT_SAMPLES &&
        fabs(gravity_ - 1.0) > GRAVITY_UPDATE_VERTICAL_TOLERANCE_G) {
      lastRejectedGravity_ = gravity_;
      gravityInitResetCount_++;
      gravity_ = 1.0;
      gravityVerticalRejectCount_ = 0;
      validAccelVert_ = false;
    }
  } else {
    gravityVerticalRejectCount_ = 0;
    if (startupNonVertSamples_ < STARTUP_NON_VERT_SAMPLES) {
      startupNonVertSamples_++;
    }
    double dt = ((double)m.t - tLastGravityUpdate_) * 0.001;
    if (dt > 0.0 && dt < 1.0) {
      double f = exp(K_UPDATE * dt);
      double nextGravity = gravity_ * f + awz * (1 - f);
      double maxDelta = GRAVITY_UPDATE_MAX_SLEW_G_PER_S * dt;
      double gravityDelta = nextGravity - gravity_;
      if (fabs(gravityDelta) > maxDelta) {
        nextGravity = gravity_ + (gravityDelta > 0.0 ? maxDelta : -maxDelta);
        gravityUpdateSlewLimitedCount_++;
      }
      if (plausibleGravity(nextGravity)) {
        gravity_ = clampGravityEstimate(nextGravity);
        gravityUpdateAcceptedCount_++;
      } else {
        gravityUpdateRejectedPlausibilityCount_++;
      }
    } else {
      gravityUpdateRejectedTimeCount_++;
    }
  }

#ifdef SHOW_VERTICAL_ACCEL
  if (needComma) {
    Serial.print(',');
  }
  Serial.print("dAz:");
  printFloat(accelVert_);
  needComma = true;
  needNewline = true;
#endif

  tLastGravityUpdate_ = m.t;

  if (needNewline) {
    Serial.println();
  }
}

void IMU::processGravity(const MotionUpdate& m) {
  validAccelVert_ =
      projectVerticalAcceleration(m.ax, m.ay, m.az, m.gx, m.gy, m.gz, accelVert_, gravity_);
  if (!validAccelVert_) {
    validAccelTot_ = validLastWorldVerticalAccel_ = false;
    return;
  }
  motionSampleProcessedCount_++;
  lastMotionTime_ = m.t;
  lastDeviceAccelX_ = m.ax;
  lastDeviceAccelY_ = m.ay;
  lastDeviceAccelZ_ = m.az;
  accelTot_ = sqrt(m.ax * m.ax + m.ay * m.ay + m.az * m.az);
  validAccelTot_ = true;
  kalmanAccelVert_ = accelVert_;
  gLoad_.addSample((float)accelTot_, m.t, 8.0f * 1.732051f);
  lastWorldVerticalAccel_ = accelVert_ + gravity_;
  validLastWorldVerticalAccel_ = true;
  // No horizontal orientation or quaternion is requested from the chip.
  lastWorldAccelX_ = lastWorldAccelY_ = lastQuatX_ = lastQuatY_ = lastQuatZ_ = NAN;
  startupNonVertSamples_ = STARTUP_NON_VERT_SAMPLES;
}

void IMU::on_receive(const MotionUpdate& msg) {
  motionSampleCount_++;
  if (msg.clippedSinceLastUpdate) gLoad_.recordClipping();
  if (msg.reset) {
    wake(GLoadTracker::ResetReason::SensorMessage);
    return;
  }
  // A late sample is not evidence of a broken filter. Preserve the current estimate.
  if (static_cast<uint32_t>(millis() - msg.t) > vario_timing::SENSOR_FRESH_MS) return;
  if (haveMotionTime_) {
    const int32_t dt = static_cast<int32_t>(msg.t - lastMotionTime_);
    if (dt <= 0) return;
    if (gravityVectorMode_ != msg.hasGravity) wake(GLoadTracker::ResetReason::SourceChange);
  }
  if (msg.hasGravity) {
    const double initialBias = flatBiasReference_.initialBias(msg.gx, msg.gy, msg.gz);
    if (!gravityVectorMode_) kalmanvert_.reset(25.0, true, initialBias);
    gravityVectorMode_ = true;
    if (!msg.hasAcceleration) {
      wake(GLoadTracker::ResetReason::MissingAcceleration);
      return;
    }
    processGravity(msg);
    haveMotionTime_ = true;
    if (!validAccelVert_) {
      wake(GLoadTracker::ResetReason::InvalidGravity);
      return;
    }
    const bool disturbed = msg.clippedSinceLastUpdate ||
                           fabs(accelTot_ - 1.0) > GRAVITY_UPDATE_ACCEL_TOLERANCE_G ||
                           fabs(accelVert_) > GRAVITY_UPDATE_VERTICAL_TOLERANCE_G;
    if (disturbed) {
      haveBiasDisturbance_ = true;
      lastBiasDisturbance_ = msg.t;
    }
    biasLearningAllowed_ = !haveBiasDisturbance_ ||
                           uint32_t(msg.t - lastBiasDisturbance_) >= BIAS_LEARNING_RECOVERY_MS;
    if (biasLearningAllowed_) haveBiasDisturbance_ = false;
    if (baro.state() != Barometer::State::Ready || !baro.pressureFresh()) {
      motionSampleBaroNotReadyCount_++;
      // A temporary pressure outage must not erase velocity or learned bias. The Kalman
      // timestamp guard handles a genuinely long interval when observations resume.
      return;
    }
    // Each pressure observation is used at most once. Do not make the filter overconfident
    // by replaying a FIFO burst against the same pressure measurement.
    if (kalmanvert_.initialized() && lastPressureTime_ == baro.lastPressureTime()) return;
    lastPressureTime_ = baro.lastPressureTime();
    if (kalmanvert_.initialized())
      kalmanTime_ += uint32_t(msg.t - lastKalmanTime_) * .001;
    else
      kalmanTime_ = 0;
    lastKalmanTime_ = msg.t;
    kalmanvert_.update(kalmanTime_, baro.altF(), kalmanAccelVert_ * 9.80665, biasLearningAllowed_);
    ++kalmanUpdateSampleCount_;
    if (kalmanStartupSamplesRemaining_) --kalmanStartupSamplesRemaining_;
    return;
  }
  if (baro.state() != Barometer::State::Ready) {
    if (msg.hasAcceleration && msg.hasOrientation) {
      processMotion(msg);
    }
    // Gravity can update without baro, but Kalman needs simultaneous barometer-measured altitude.
    motionSampleBaroNotReadyCount_++;
    return;
  }
  if (!msg.hasAcceleration || !msg.hasOrientation) {
    // We need to use both acceleration and orientation.
    // In the future, we could potentially collect them separately, but that seems unnecessary given
    // that they almost always occur together.
    motionSampleMissingFieldsCount_++;
    return;
  }

  if (startupReadinessStartMs_ == 0) {
    startupReadinessStartMs_ = millis();
  }

  processMotion(msg);
  haveMotionTime_ = true;

  if (validAccelVert_) {
    // As on SFLP, consume each fresh pressure observation once. Reusing a held altitude
    // during an outage would incorrectly pull an otherwise continuous climb toward zero.
    if (!baro.pressureFresh() ||
        (kalmanvert_.initialized() && lastPressureTime_ == baro.lastPressureTime()))
      return;
    lastPressureTime_ = baro.lastPressureTime();
    // update kalman filter
    kalmanvert_.update(millis() / 1000.0, baro.altF(), kalmanAccelVert_ * 9.80665f);
    kalmanUpdateSampleCount_++;
    if (kalmanStartupSamplesRemaining_ > 0) {
      kalmanStartupSamplesRemaining_--;
    }

    if (LOG::KALMAN && bus_) {
      String kalmanName = "kalman,";
      String kalmanEntryString = kalmanName + String(kalmanvert_.getPosition(), 8) + ',' +
                                 String(kalmanvert_.getVelocity(), 8) + ',' +
                                 String(kalmanvert_.getAcceleration(), 8);
      bus_->receive(CommentMessage(kalmanEntryString));
    }
  }
}

void IMU::wake(GLoadTracker::ResetReason reason) {
  gLoad_.resetFilter(reason);
  kalmanvert_.reset();
  validAccelVert_ = validAccelTot_ = validLastWorldVerticalAccel_ = false;
  haveMotionTime_ = false;
  gravityVectorMode_ = false;
  gravity_ = 1.0;
  gravityVerticalRejectCount_ = 0;
  startupNonVertSamples_ = 0;
  startupReadinessStartMs_ = 0;
  tLastGravityUpdate_ = 0;
  kalmanStartupSamplesRemaining_ = KALMAN_STARTUP_REPORT_SAMPLES;
  biasLearningAllowed_ = true;
  haveBiasDisturbance_ = false;
}

bool IMU::accelValid() {
  return validAccelTot_ && uint32_t(millis() - lastMotionTime_) <= vario_timing::SENSOR_FRESH_MS;
}

float IMU::getAccel() {
  if (!accelValid()) {
    fatalError("IMU::getAccel when not valid");
  }
  return accelTot_;
}

bool IMU::velocityValid() {
  return accelValid() && baro.pressureFresh() && kalmanvert_.initialized() &&
         kalmanStartupSamplesRemaining_ == 0 &&
         (startupNonVertSamples_ >= STARTUP_NON_VERT_SAMPLES || startupReadinessTimedOut());
}

float IMU::getVelocity() {
  if (!velocityValid()) {
    fatalError("IMU::getVelocity when not valid");
  }
  return (float)kalmanvert_.getVelocity();
}

uint16_t IMU::gravityInitSamplesRemaining() const { return 0; }

float IMU::gravityEstimate() const { return (float)gravity_; }

float IMU::verticalAccel() const { return (float)accelVert_; }

float IMU::kalmanAccelInput() const { return (float)kalmanAccelVert_; }

bool IMU::kalmanValid() const { return kalmanvert_.initialized(); }

float IMU::kalmanPosition() const {
  return kalmanvert_.initialized() ? (float)kalmanvert_.getPosition() : 0.0f;
}

float IMU::kalmanVelocity() const {
  return kalmanvert_.initialized() ? (float)kalmanvert_.getVelocity() : 0.0f;
}

float IMU::kalmanAcceleration() const {
  return kalmanvert_.initialized() ? (float)kalmanvert_.getAcceleration() : 0.0f;
}

unsigned long IMU::lastMotionTime() const { return lastMotionTime_; }

float IMU::lastDeviceAccelX() const { return (float)lastDeviceAccelX_; }

float IMU::lastDeviceAccelY() const { return (float)lastDeviceAccelY_; }

float IMU::lastDeviceAccelZ() const { return (float)lastDeviceAccelZ_; }

float IMU::lastQuatX() const { return (float)lastQuatX_; }

float IMU::lastQuatY() const { return (float)lastQuatY_; }

float IMU::lastQuatZ() const { return (float)lastQuatZ_; }

float IMU::lastWorldAccelX() const { return (float)lastWorldAccelX_; }

float IMU::lastWorldAccelY() const { return (float)lastWorldAccelY_; }

float IMU::lastWorldVerticalAccel() const { return (float)lastWorldVerticalAccel_; }

bool IMU::worldVerticalAccelValid() const { return validLastWorldVerticalAccel_; }

uint16_t IMU::gravityInitResetCount() const { return gravityInitResetCount_; }

float IMU::lastRejectedGravityEstimate() const { return (float)lastRejectedGravity_; }

uint32_t IMU::motionSampleCount() const { return motionSampleCount_; }

uint32_t IMU::motionSampleBaroNotReadyCount() const { return motionSampleBaroNotReadyCount_; }

uint32_t IMU::motionSampleMissingFieldsCount() const { return motionSampleMissingFieldsCount_; }

uint32_t IMU::motionSampleProcessedCount() const { return motionSampleProcessedCount_; }

uint32_t IMU::motionSampleRejectedQuaternionCount() const {
  return motionSampleRejectedQuaternionCount_;
}

uint32_t IMU::gravityInitSampleCount() const { return gravityInitSampleCount_; }

uint32_t IMU::gravityUpdateCandidateCount() const { return gravityUpdateCandidateCount_; }

uint32_t IMU::gravityUpdateAcceptedCount() const { return gravityUpdateAcceptedCount_; }

uint32_t IMU::gravityUpdateRejectedAccelCount() const { return gravityUpdateRejectedAccelCount_; }

uint32_t IMU::gravityUpdateRejectedVerticalCount() const {
  return gravityUpdateRejectedVerticalCount_;
}

uint32_t IMU::gravityUpdateRejectedTimeCount() const { return gravityUpdateRejectedTimeCount_; }

uint32_t IMU::gravityUpdateRejectedPlausibilityCount() const {
  return gravityUpdateRejectedPlausibilityCount_;
}

uint32_t IMU::gravityUpdateSlewLimitedCount() const { return gravityUpdateSlewLimitedCount_; }

uint32_t IMU::kalmanUpdateSampleCount() const { return kalmanUpdateSampleCount_; }

bool IMU::startupReadinessTimedOut() const {
  return startupReadinessStartMs_ != 0 &&
         static_cast<uint32_t>(millis() - startupReadinessStartMs_) >= STARTUP_IMU_MAX_READINESS_MS;
}

uint16_t IMU::startupSamplesCompleted() const {
  uint16_t kalmanCompleted = KALMAN_STARTUP_REPORT_SAMPLES - kalmanStartupSamplesRemaining_;
  if (kalmanStartupSamplesRemaining_ == 0 && startupReadinessTimedOut()) {
    return KALMAN_STARTUP_REPORT_SAMPLES;
  }
  uint16_t nonVertCompleted = startupNonVertSamples_ > STARTUP_NON_VERT_SAMPLES
                                  ? STARTUP_NON_VERT_SAMPLES
                                  : startupNonVertSamples_;
  return kalmanCompleted < nonVertCompleted ? kalmanCompleted : nonVertCompleted;
}

uint16_t IMU::startupSamplesRequired() const { return KALMAN_STARTUP_REPORT_SAMPLES; }
