DangerMonkeys/leaf/src/vario/diagnostics/diagnostic_network/diagnostic_network.cpp

#include "diagnostic_network.h"

#include <WiFi.h>

#include "comms/wifi_coordinator.h"
#include "diagnostics/fatal_error.h"
#include "diagnostics/self_test/selfTest.h"
#include "power.h"
#include "storage/sd_card.h"
#include "ui/settings/settings.h"
#include "utils/magic_enum.h"

static constexpr const char* DIAGNOSTIC_NETWORK_SSID = "LeafDiagnostics";
static constexpr const char* DIAGNOSTIC_NETWORK_PASSWORD = "leafdiagnostics";

static constexpr int32_t MIN_RSSI_DBM = -85;  // ignore super-weak signals
static constexpr uint32_t CONNECT_TIMEOUT_MS = 15000;
static constexpr uint32_t SEARCH_TIMEOUT_MS = 20000;
static constexpr uint32_t SCAN_RETRY_DELAY_MS = 2000;

DiagnosticNetwork diagnostic_network;

const char* DiagnosticNetwork::ssid() { return DIAGNOSTIC_NETWORK_SSID; }

bool DiagnosticNetwork::connected() const {
  return WiFi.status() == WL_CONNECTED && WiFi.SSID() == ssid();
}

bool DiagnosticNetwork::chargingWorkBlocked() const {
  if (connected()) return true;
  if (!settings.diagnosticNetworkScanAllowed() || !leaf_wifi::diagnosticsAllowed()) return false;
  return state_ == State::Ready || state_ == State::WifiResetting ||
         state_ == State::LookingForNetwork || state_ == State::ConnectingToNetwork;
}

void DiagnosticNetwork::reset(const char* reason) {
  Serial.printf("DiagnosticNetwork: reset (%s)\n", reason ? reason : "unknown");
  printed_end_state_ = false;
  off_usb_scan_attempted_ = false;
  search_started_ = false;
  error_msg_ = "No error";
  state_ = State::Ready;
  next_scan_attempt_ms_ = millis() + SCAN_RETRY_DELAY_MS;
  WiFi.scanDelete();
  WiFi.disconnect();
}

bool DiagnosticNetwork::shouldResetWhenSwitchingOn() const {
  return state_ == State::Ready || state_ == State::NoNetworkFound || state_ == State::Error;
}

bool DiagnosticNetwork::canSleepWhileCharging() const { return shouldResetWhenSwitchingOn(); }

void DiagnosticNetwork::update() {
  if (!settings.diagnosticNetworkScanAllowed()) {
    // Preserve the factory connection for acknowledgement/retry of the completion request.
    // Charging work stays held until this connection ends; the next boot skips factory search.
    if (connected()) return;
    if (!printed_end_state_) {
      Serial.println("DiagnosticNetwork: skipped; commissioning is complete");
      printed_end_state_ = true;
    }
    state_ = State::NoNetworkFound;
    return;
  }

  if (search_started_ &&
      (state_ == State::Ready || state_ == State::WifiResetting ||
       state_ == State::LookingForNetwork) &&
      millis() - search_started_ms_ >= SEARCH_TIMEOUT_MS) {
    WiFi.scanDelete();
    WiFi.disconnect();
    error_msg_ = "Timeout searching for diagnostic network";
    state_ = State::Error;
    return;
  }

  if (!leaf_wifi::diagnosticsAllowed()) {
    if (!printed_end_state_) {
      Serial.println("DiagnosticNetwork: disabled by user WiFi action");
      printed_end_state_ = true;
    }
    state_ = State::NoNetworkFound;
    return;
  }

  if (state_ == State::Ready) {
    maybeLookForNetwork();
  } else if (state_ == State::WifiResetting) {
    if (millis() >= t0_) {
      WiFi.scanDelete();
      int16_t result = WiFi.scanNetworks(/*async=*/true, /*show_hidden=*/false);
      if (result == WIFI_SCAN_RUNNING) {
        state_ = State::LookingForNetwork;
      } else {
        Serial.printf("DiagnosticNetwork: WiFi.scanNetworks failed (%d)\n", result);
        error_msg_ = "WiFi.scanNetworks did not indicate WIFI_SCAN_RUNNING";
        next_scan_attempt_ms_ = millis() + SCAN_RETRY_DELAY_MS;
        state_ = State::Ready;
      }
    }
  } else if (state_ == State::LookingForNetwork) {
    checkForDiagnosticNetwork();
  } else if (state_ == State::NoNetworkFound) {
    // Do nothing
    if (!printed_end_state_) {
      Serial.println("DiagnosticNetwork: No network found");
      printed_end_state_ = true;
    }
  } else if (state_ == State::ConnectingToNetwork) {
    checkForConnection();
  } else if (state_ == State::ConnectedToNetwork) {
    if (!printed_end_state_) {
      Serial.println("DiagnosticNetwork: Connected to network");
      printed_end_state_ = true;
    }
    // During factory commissioning, wait for the factory interface to format the SD card and
    // explicitly start the test. Preserve the automatic production-test behavior for older or
    // non-commissioning diagnostic flows.
    if (settings.commissioningPending) return;

    // begin self test (mark as official production test)
    if (!settings.productionTest && settings.consumeProductionTestForceFormatSdCard()) {
      Serial.println("DiagnosticNetwork: force-formatting SD card before production self test");
      if (sdcard.format()) {
        sdcard.setLabel();
      }
    }
    selfTest.begin(true);
  } else if (state_ == State::Error) {
    // Do nothing
    if (!printed_end_state_) {
      Serial.print("DiagnosticNetwork: Error: ");
      Serial.println(error_msg_);
      printed_end_state_ = true;
    }
  } else {
    fatalError("Unsupported state %d", (uint8_t)state_);
  }
}

void DiagnosticNetwork::maybeLookForNetwork() {
  const Power::Info& info = power.info();

  const bool onAndUsbPowered = info.onState == PowerState::On && info.USBinput;
  const bool offAndUsbPowered = info.onState == PowerState::OffUSB;

  // Look continuously while on and USB-powered, or exactly once when USB wakes the device into
  // charge-only mode.
  if (!onAndUsbPowered && !offAndUsbPowered) {
    return;
  }

  uint32_t now = millis();
  if (now < next_scan_attempt_ms_) {
    return;
  }

  const bool offUsbAttempt = info.onState == PowerState::OffUSB;
  if (offUsbAttempt) {
    if (off_usb_scan_attempted_) {
      return;
    }
  }

  Serial.printf("DiagnosticNetwork: starting scan (USBinput=%d onState=%s)\n", info.USBinput,
                nameOf(info.onState));
  if (!search_started_) {
    search_started_ = true;
    search_started_ms_ = now;
  }
  Serial.printf("DiagnosticNetwork: pre-scan status=%d mode=%d freeHeap=%u\n", WiFi.status(),
                WiFi.getMode(), ESP.getFreeHeap());

  WiFi.mode(WIFI_STA);
  WiFi.disconnect();  // drop the active connection without erasing saved user credentials

  // Use WifiResetting state to let WiFi settle for 100ms without blocking the loop
  t0_ = millis() + 100;
  if (offUsbAttempt) {
    off_usb_scan_attempted_ = true;
  }
  state_ = State::WifiResetting;
}

void DiagnosticNetwork::checkForDiagnosticNetwork() {
  int16_t result = WiFi.scanComplete();
  if (result == WIFI_SCAN_RUNNING) {
    return;
  } else if (result == WIFI_SCAN_FAILED) {
    error_msg_ = "WiFi.scanComplete indicated WIFI_SCAN_FAILED";
    Serial.println("DiagnosticNetwork: WiFi.scanComplete failed");
    next_scan_attempt_ms_ = millis() + SCAN_RETRY_DELAY_MS;
    state_ = State::Ready;
    return;
  } else if (result < 0) {
    Serial.printf("DiagnosticNetwork: WiFi.scanComplete unexpected result %d\n", result);
    error_msg_ = "WiFi.scanComplete returned unexpected negative result";
    next_scan_attempt_ms_ = millis() + SCAN_RETRY_DELAY_MS;
    state_ = State::Ready;
    return;
  }

  int32_t bestRssi = -127;
  bool found = false;
  Serial.printf("DiagnosticNetwork: scanComplete found %d networks\n", result);

  for (int i = 0; i < result; i++) {
    String s = WiFi.SSID(i);
    int32_t rssi = WiFi.RSSI(i);

    if (s == DIAGNOSTIC_NETWORK_SSID) {
      found = true;
      if (rssi > bestRssi) bestRssi = rssi;  // if multiple APs share SSID
    }
  }

  WiFi.scanDelete();

  if (found && bestRssi > MIN_RSSI_DBM) {
    t0_ = millis();
    WiFi.begin(ssid(), DIAGNOSTIC_NETWORK_PASSWORD);
    state_ = State::ConnectingToNetwork;
    return;
  } else {
    Serial.printf("checkForDiagnosticNetwork -> %d with RSSI %d (min %d) scan count %d\n", found,
                  bestRssi, MIN_RSSI_DBM, result);
    state_ = State::NoNetworkFound;
    return;
  }
}

void DiagnosticNetwork::checkForConnection() {
  uint32_t now = millis();
  if (now - t0_ > CONNECT_TIMEOUT_MS) {
    WiFi.disconnect();
    error_msg_ = "Timeout attempting to connect to diagnostic network";
    state_ = State::Error;
    return;
  }

  wl_status_t status = WiFi.status();
  if (status == WL_CONNECTED) {
    state_ = State::ConnectedToNetwork;
    return;
  } else if (status == WL_CONNECT_FAILED || status == WL_STOPPED) {
    WiFi.disconnect();
    error_msg_ = "WiFi FAILED or STOPPED while connecting to diagnostic network";
    state_ = State::Error;
  }
}
