DangerMonkeys/leaf/src/vario/logging/log.cpp

#include "logging/log.h"

#include <Arduino.h>

#include "comms/fanet_radio.h"
#include "diagnostics/flight_diagnostics.h"
#include "instruments/ambient.h"
#include "instruments/baro.h"
#include "instruments/gps.h"
#include "instruments/imu.h"
#include "logbook/flight.h"
#include "logbook/igc.h"
#include "logbook/logbook_entry.h"
#include "logging/fanet_log.h"
#include "logging/flight_auto_start.h"
#include "navigation/gpx.h"
#include "power.h"
#include "storage/sd_card.h"
#include "ui/audio/sound_effects.h"
#include "ui/audio/speaker.h"
#include "ui/display/display.h"
#include "ui/display/fonts.h"
#include "ui/display/message_box.h"
#include "ui/display/pages/dialogs/page_alert_timerAutoStop.h"
#include "ui/display/pages/dialogs/page_flight_summary.h"
#include "ui/display/pages/fanet/page_fanet_stats.h"
#include "ui/settings/settings.h"
#include "utils/string_utils.h"
#include "wind_estimate/wind_estimate.h"

// This file keeps track of logging a flight to persistent storage.  As the operator may
// wish to start their flight and flight log before we have a "fix", know the time or
// location, we keep track of their intent to log, and start the flight record when we have
// a fix and a date/time record.
Flight* flight =
    NULL;  // Pointer to the current flight record (null if we're not deisred to be logging)
Igc igcFlight;
bool trackLogEnabledForFlight = false;

// TODO:  Delete ME

// used to keep track of current flight statistics
FlightStats logbook;
LogbookEntryFile logbookEntry;

// Alert page to warn if auto-stop is about to occur
PageAlertTimerAutoStop pageAlertTimerAutoStop;

namespace {
  static_assert(FlightDiagnostics::GAP_MS == GLoadTracker::MAX_SAMPLE_GAP_MS,
                "diagnostic motion-gap threshold must match the tracker");
  FlightAutoStart autoStartDetector;
  uint32_t flightStartedAtMs = 0;
  FlightStartCause flightStartCause = FlightStartCause::Manual;
  uint8_t flightStartPaths = 0;
  uint8_t pendingAutoLaunchPaths = 0;

  FlightAutoStart::Sample autoStartSample() {
    FlightAutoStart::Sample sample;
    sample.speedValid = gps.hasFreshGroundSpeed();
    if (sample.speedValid) sample.speedMps = gps.speed.mps();
    sample.climbValid = baro.pressureFresh() && baro.climbRate1SecAverageValid();
    if (sample.climbValid) sample.climbMps = baro.climbRate1SecAverage() / 100.0f;
    sample.altitudeValid = baro.pressureFresh();
    if (sample.altitudeValid) sample.altitudeM = baro.alt() / 100.0f;
    sample.positionValid = gps.hasUsableFix();
    if (sample.positionValid) {
      sample.latitude = gps.location.lat();
      sample.longitude = gps.location.lng();
    }
    return sample;
  }

  void captureFirstGpsFixForLogbook() {
    GPSPositionSnapshot fix;
    if (!gps.lastValidFix(fix)) return;

    logbook.gpsalt_start = fix.altitudeM;
    logbook.gpsalt = logbook.gpsalt_start;
    logbook.gpsalt_above_launch = 0;
    logbook.gpsalt_max = logbook.gpsalt_start;
    logbook.gpsalt_min = logbook.gpsalt_start;
    logbook.gpsalt_above_launch_max = 0;
    logbook.speed = fix.speedMps;
    logbook.speed_max = logbook.speed;
    logbook.startLocationLat = fix.latitude;
    logbook.startLocationLng = fix.longitude;
    logbookEntry.captureFirstFix(logbook);
  }

  // Activity only vetoes landing. Entry uses the corroborated motion-window detector.

  struct FlightEvidence {
    uint32_t checkMs = 0;
    bool speedValid = false, climbValid = false, fast = false, vertical = false;
    uint8_t launchPaths = 0;
    bool looksAirborne() const { return fast || vertical; }
    bool detectorInputsValid() const { return looksAirborne() || (speedValid && climbValid); }
  };
  FlightEvidence captureFlightEvidence() {
    FlightEvidence d;
    d.checkMs = millis();
    d.speedValid = gps.hasUsableFix() && gps.hasFreshGroundSpeed();
    d.fast = d.speedValid && gps.speed.mps() > 8.0f * 0.44704f;
    d.climbValid = baro.state() == Barometer::State::Ready && baro.climbRateFilteredValid();
    d.vertical = d.climbValid && abs(baro.climbRateFiltered()) > 50;
    return d;
  }

  void captureGLoadExtrema() {
    logbook.accel_max = imu.gLoad().valid() ? imu.gLoad().maxG() : NAN;
    logbook.accel_min = imu.gLoad().valid() ? imu.gLoad().minG() : NAN;
  }

  void captureGLoadEvents() {
    const auto interval = imu.gLoad().takeInterval();
    if (interval.gaps)
      flightDiagnostics.record(FlightDiagnostics::Kind::MotionGap, interval.maxGapEndMs,
                               interval.maxGapMs, 0, interval.gaps);
  }
}  // namespace

//////////////////////////////////////////////////////////////////////////////////////////
// UPDATE - Main function to run every second
void log_update() {
  // Check auto-start criteria if we haven't begun a flight yet
  if (!flight) {
    // Evaluate automatic starts while idle. Manual flights collect fresh launch
    // evidence once the timer is running, independent of the Auto Start setting.
    if (flightTimer_autoStart()) flightTimer_start(FlightStartCause::Automatic);
    // Check auto-stop criteria if we have started a flight (and AutoStop is ON)
  } else {
    if (settings.log_autoStop) {
      if (flightTimer_autoStop()) flightTimer_stop(true, FlightEndCause::Automatic);
    }
  }

  fanet_log::update();

  // Now do all the regular log stuff if we have an active log
  if (flight) {
    // We're currently logging a flight (we're flying)

    // Current second of the flight
    auto currentSecondSinceBoot = millis() / 1000;

    // Current second of the flight
    logbook.duration = currentSecondSinceBoot - logbook.logStartedAt;
    auto evidence = captureFlightEvidence();
    if (pendingAutoLaunchPaths) {
      // The timer already consumed this check's launch evidence; do not confirm it again.
      evidence.launchPaths = pendingAutoLaunchPaths;
      pendingAutoLaunchPaths = 0;
    } else {
      // Manual logs and relaunches use the same detector, independent of Auto Start settings.
      autoStartDetector.update(evidence.checkMs, autoStartSample());
      evidence.launchPaths = autoStartDetector.triggered();
    }
    imu.gLoad().updateFlightState(evidence.launchPaths != 0, evidence.looksAirborne(),
                                  evidence.detectorInputsValid());
    if (imu.gLoad().diagnosticState().transition == GLoadTracker::Transition::Landed)
      autoStartDetector.reset();  // A relaunch needs a fresh motion window after landing.
    captureGLoadExtrema();
    logbookEntry.refreshStartTimeFromSyncedClock(logbook);

    // We wish to save a tracklog, but the tracklog has not yet started.
    if (trackLogEnabledForFlight && !flight->started()) {
      if (!gps.hasUsableFix()) {
        // We don't have a valid GPS location yet, try again later
        logbookEntry.writePlaceholder(logbook);
        captureGLoadEvents();
        return;
      }

      if (baro.state() != Barometer::State::Ready) {
        // The baro is still discarding its startup samples, so it can't set a launch altitude
        // yet; try again later
        logbookEntry.writePlaceholder(logbook);
        captureGLoadEvents();
        return;
      }

      // We have a GPS fix, we're able to start recording of the flight.
      // Do all the necessary starting actions as we start the recording.
      // TODO:  A second sound effect to show that recording has now started??
      if (flight->startFlight()) {
        // TODO:  Make this sound much cooler
        speaker.playSound(fx::started);

        // if Altimeter GPS-SYNC is on, reset altimeter setting
        // so baro matches GPS when log is started
        if (settings.vario_altSyncToGPS) baro.syncToGPSAlt();

        // starting values
        baro.setLaunchAlt();
        logbook.alt_start = baro.altAtLaunch();
        captureFirstGpsFixForLogbook();
        logbookEntry.setTrack(flight->trackLogFormat(), flight->trackLogPath());

        // get first set of log values
        log_captureValues();

        // initial min/max values
        logbook.alt_max = logbook.alt_start;
        logbook.alt_min = logbook.alt_start;
        logbook.alt_above_launch_max = 0;
        logbook.climb_max = logbook.climb_min = 0;
        logbook.speed_max = 0;
        logbook.temperature_max = logbook.temperature_min = logbook.temperature;
      }
    }

    if (!trackLogEnabledForFlight && gps.hasUsableFix() && logbook.startLocationLat == 0 &&
        logbook.startLocationLng == 0) {
      captureFirstGpsFixForLogbook();
    }

    // Coalesce clock, first-fix and track association before the single milestone write.
    logbookEntry.writePlaceholder(logbook);
    // Generate a tracklog record.
    captureGLoadEvents();
    if (trackLogEnabledForFlight) flight->log(logbook.duration);
    log_captureValues();      // TODO:  Update this to an "Update Flight Stats" or something
    log_checkMinMaxValues();  // TODO:  Probably rename this to be "bound Flight Stats"
  }
}

/////////////////////////////////////////////////////////////////////////////////////////////////////////////
// Auto Start & Stop check functions.

uint8_t autoStopCounter = 0;
int32_t autoStopAltitude = 0;

void flightTimer_resetAutoStart() { autoStartDetector.reset(); }

bool flightTimer_autoStart() {
  if (flight) return false;
  const auto sample = autoStartSample();
  const bool inhibited = PageFlightSummary::isShowing();
  bool start = false;
  if (!settings.log_autoStart || inhibited) {
    autoStartDetector.reset();
  } else {
    start = autoStartDetector.update(millis(), sample);
  }
  if (start) Serial.println("****************************** autoStart TRUE via motion window");
  return start;
}

void log_writeStartDiagnostics(IgcLogger& logger) {
  char line[73];
  snprintf(line, sizeof(line), "START V=3 CAUSE=%s T_MS=%lu J=%u",
           flightStartCause == FlightStartCause::Automatic ? "AUTO" : "MANUAL",
           (unsigned long)flightStartedAtMs, flightStartPaths);
  logger.writeLRecord(line);
}

bool showingAlert_ = false;

bool flightTimer_autoStop() {
  if (baro.state() != Barometer::State::Ready) {
    return false;  // can't autoStop without the Baro
  }

  int32_t altDifference = abs(baro.alt() - autoStopAltitude);

  const bool gpsSpeedQuiet =
      gps.hasUsableFix() ? gps.hasFreshGroundSpeed() && gps.speed.mph() < AUTO_STOP_MAX_SPEED
                         : true;

  if ((altDifference < AUTO_STOP_MAX_ALT) &&  // Check if altitude is stable
      gpsSpeedQuiet &&                        // And GPS speed is slow enough, if current
      (imu.accelValid() && abs(imu.getAccel() - 1.0f) < AUTO_STOP_MAX_ACCEL)) {  // and IMU is calm

    // if all three conditions are met, increment the counter
    autoStopCounter++;
    // Warn at check 7 of 15, leaving an eight-second cancelable countdown.
    if (autoStopCounter == AUTO_STOP_MIN_SEC / 2) {
      pageAlertTimerAutoStop.show();
      showingAlert_ = true;
      speaker.playSound(fx::cancel);
    }
    // and check if we've been in this state long enough to trigger auto-stop
    if (autoStopCounter >= AUTO_STOP_MIN_SEC) {
      autoStopCounter = 0;  // reset counter for next time
      if (showingAlert_) {
        pageAlertTimerAutoStop.closeAlert();
        showingAlert_ = false;
      }
      return true;
    }
  } else {
    autoStopCounter = 0;
    if (showingAlert_) {
      pageAlertTimerAutoStop.closeAlert();
      showingAlert_ = false;
    }

    // reset the comparison altitude to present altitude, since it's still changing
    autoStopAltitude = baro.alt();
  }
  return false;
}

uint8_t flightTimer_getAutoStopCountRemaining() {
  if (autoStopCounter)
    return AUTO_STOP_MIN_SEC - autoStopCounter;
  else
    return 0;
}

void flightTimer_resetAutoStop() {
  autoStopCounter = 0;
  showingAlert_ = false;
}

//////////////////////////////////////////////////////////////////////////////////
// FLight Timer Management Functions

// check if running
bool flightTimer_isRunning() { return flight != NULL; }
bool flightTimer_ownsLogbookPath(const String& path) {
  if (!flight) return false;
  return path == logbookEntry.path() || path.endsWith("_" + logbookEntry.flightId() + ".json");
}
bool flightTimer_isLogging() {
  return flightTimer_isRunning() && (!trackLogEnabledForFlight || (bool)flight->started());
}

void flightTimer_markSavedPoint(const Waypoint& waypoint) {
  if (flight != &igcFlight || !trackLogEnabledForFlight || !igcFlight.started()) return;
  igcFlight.markSavedPoint(waypoint);
}

// start timer
void flightTimer_start(FlightStartCause cause) {
  // Short-circuit if a flight is already started
  if (flight != NULL) {
    return;
  }

  // Release an idle repair iterator before this flight can create any files.
  LogbookStore::beginRepairSession(false);

  flightStartedAtMs = millis();
  flightStartCause = cause;
  flightStartPaths = cause == FlightStartCause::Automatic ? autoStartDetector.triggered() : 0;
  pendingAutoLaunchPaths = flightStartPaths;
  flightDiagnostics.begin(flightStartedAtMs);
  autoStartDetector.reset();
  flightTimer_resetAutoStop();

  // start timer
  speaker.playSound(fx::enter);
  settings.resetShortcutVolume();
  flight = &igcFlight;
  display.resetThermalState();
  imu.gLoad().startFlight();

  logbook.logStartedAt = millis() / 1000;
  log_captureValues();
  logbook.temperature_max = logbook.temperature_min = logbook.temperature;
  logbookEntry.begin(logbook);
  trackLogEnabledForFlight = settings.log_saveTrack;

  // Start the Fanet radio
  fanet_log::beginFlight();
  fanetRadio.begin(settings.fanet_region);
}

// stop timer
void flightTimer_stop(bool showSummary, FlightEndCause cause) {
  fanet_log::endFlight();
  pendingAutoLaunchPaths = 0;
  autoStartDetector.reset();
  windEstimator.clearWindEstimate();  // clear the wind estimate when we stop a flight
  power.resetAutoOffCounter();  // reset the auto-off counter when we stop a flight (it could have
                                // counted up to nearly the limit prior to auto-starting a log)
  flightTimer_resetAutoStop();
  // Also clear non-logging thermal sessions and repeated stop/shutdown requests.
  display.resetThermalState();
  // Short Circuit, no need to do anything if there's no flight recording.
  if (flight == NULL) {
    return;
  }

  const bool previouslyMuted = speaker.muted();
  speaker.mute();  // Stop hardware output before any final IGC or JSON file work.

  // ending values
  imu.gLoad().stopFlight();
  captureGLoadExtrema();
  captureGLoadEvents();
  log_captureEndingValues();

  const String trackFormat = flight->started() ? flight->trackLogFormat() : "";
  const String trackPath = flight->started() ? flight->trackLogPath() : "";

  // Close the tracklog before finalizing the logbook reference to it.
  if (flight->started()) {
    const char* causeName = "MANUAL";
    switch (cause) {
      case FlightEndCause::Automatic:
        causeName = "AUTO";
        break;
      case FlightEndCause::PowerOff:
        causeName = "POWER_OFF";
        break;
      case FlightEndCause::LowBattery:
        causeName = "LOW_BATTERY";
        break;
      case FlightEndCause::Manual:
        break;
    }
    igcFlight.markEnd(causeName);
    flight->end(logbook, false);
  }
  flightDiagnostics.end();

  u8g2.firstPage();
  do {
    message_box::draw("Saving", "flight...");
  } while (u8g2.nextPage());
  const bool summarySaved = logbookEntry.finalize(logbook, trackFormat, trackPath);
  if (!summarySaved && !showSummary) {
    u8g2.firstPage();
    do {
      message_box::draw("Logbook save", "failed",
                        trackPath.isEmpty() ? "No IGC file" : "IGC unverified");
    } while (u8g2.nextPage());
    delay(1000);  // Visible outcome before shutdown clears the display; no acknowledgement.
  }
  if (showSummary) {
    static PageFlightSummary dialog;
    LogbookEntrySummary snapshot;
    logbookEntry.summary(logbook, snapshot);
    dialog.show(logbook, logbookEntry.path(), trackPath, summarySaved, &snapshot);
  }
  logbookEntry.reset();
  // TODO:  A much cooler end flight sound.  Perhaps even an easter egg?
  if (!previouslyMuted) speaker.unMute();
  speaker.playSound(summarySaved ? fx::confirm : fx::bad);
  settings.resetShortcutVolume();
  flight = NULL;
  trackLogEnabledForFlight = false;
  logbook = FlightStats();  // Reset the flight stats

  // Stop the Fanet radio
  fanetRadio.end();

  // reset initial alt
  // (to enable properly checking again for auto-start conditions now that timer is stopped)
  if (baro.state() == Barometer::State::Ready) baro.setAltInitial();
}

void flightTimer_toggle() {
  if (flight)
    flightTimer_stop();
  else
    flightTimer_start();
}

String flightTimer_getString() {
  // If the flight has not yet started logging, just make it flash empty every half second.
  if (flightTimer_isRunning() && !flightTimer_isLogging()) {
    if ((millis() / 500) % 2) return "";
  }
  // Assume that the flight Timer's boxes are always 6 characters wide
  return formatSeconds(logbook.duration, true, 6);
}

void log_captureValues() {
  if (baro.state() == Barometer::State::Ready) {
    logbook.alt = baro.altAdjusted();
    logbook.alt_above_launch = baro.altAboveLaunch();

    if (baro.climbRate1SecAverageValid()) logbook.climb = baro.climbRate1SecAverage();
  }

  if (gps.hasUsableFix()) {
    GPSPositionSnapshot fix;
    if (gps.lastValidFix(fix)) {
      logbook.speed = fix.speedMps;

      logbook.gpsalt = fix.altitudeM;
      logbook.gpsalt_above_launch = fix.altitudeM - logbook.gpsalt_start;

      // accumulate distance flown
      logbook.distanceAlongPath += fix.speedMps;
    }
  }

  if (ambient.state() == Ambient::State::Ready) {
    logbook.temperature = ambient.temp();
  }

  if (imu.accelValid()) {
    logbook.accel = imu.getAccel();
  }
}

void log_captureEndingValues() {
  if (baro.state() == Barometer::State::Ready) {
    logbook.alt_end = baro.alt();
  }

  GPSPositionSnapshot fix;
  if (gps.lastValidFix(fix)) {
    logbook.gpsalt_end = fix.altitudeM;
    logbook.endLocationLat = fix.latitude;
    logbook.endLocationLng = fix.longitude;

    if (logbook.startLocationLat != 0 || logbook.startLocationLng != 0) {
      logbook.distanceStraightLine =
          gps.distanceBetween(logbook.startLocationLat, logbook.startLocationLng,
                              logbook.endLocationLat, logbook.endLocationLng);
    }
  }
}

void log_checkMinMaxValues() {
  uint32_t time = micros();

  if (baro.state() == Barometer::State::Ready) {
    // check altitude values for log records
    if (logbook.alt > logbook.alt_max) {
      logbook.alt_max = logbook.alt;
      if (logbook.alt_above_launch > logbook.alt_above_launch_max)
        logbook.alt_above_launch_max =
            logbook.alt_above_launch;  // we only need to check for max above-launch values if we're
                                       // also setting a new altitude max.
    } else if (logbook.alt < logbook.alt_min) {
      logbook.alt_min = logbook.alt;
    }

    if (baro.climbRate1SecAverageValid()) {
      // check climb values for log records
      if (logbook.climb > logbook.climb_max) {
        logbook.climb_max = logbook.climb;
      } else if (logbook.climb < logbook.climb_min) {
        logbook.climb_min = logbook.climb;
      }
    }
  }

  if (gps.hasUsableFix()) {
    if (logbook.gpsalt > logbook.gpsalt_max) {
      logbook.gpsalt_max = logbook.gpsalt;
      if (logbook.gpsalt_above_launch > logbook.gpsalt_above_launch_max)
        logbook.gpsalt_above_launch_max =
            logbook.gpsalt_above_launch;  // we only need to check for max above-launch values if
                                          // we're also setting a new gps altitude max.
    } else if (logbook.gpsalt < logbook.gpsalt_min) {
      logbook.gpsalt_min = logbook.gpsalt;
    }
  }

  // check temperature values for log records
  if (ambient.state() == Ambient::State::Ready) {
    if (logbook.temperature > logbook.temperature_max) {
      logbook.temperature_max = logbook.temperature;
    } else if (logbook.temperature < logbook.temperature_min) {
      logbook.temperature_min = logbook.temperature;
    }
  }

  // Check speed value for log records
  if (logbook.speed > logbook.speed_max) {
    logbook.speed_max = logbook.speed;
  }

  const WindEstimate& windEstimate = windEstimator.getWindEstimate();
  if (windEstimate.validEstimate && windEstimate.windSpeed > logbook.windSpeedMax) {
    logbook.windValid = true;
    logbook.windSpeedMax = windEstimate.windSpeed;
    logbook.windDirectionFromAtMaxDeg =
        fmodf(windEstimate.windDirectionFrom * RAD_TO_DEG + 360.0f, 360.0f);
  }

  // time = micros() - time;
  // Serial.print("checkMinMax: ");
  // Serial.println(time);
}
