DangerMonkeys/leaf/src/vario/logbook/logbook_store.cpp

#include "logbook_store.h"

#include <ArduinoJson.h>
#include <SD_MMC.h>
#include <cerrno>

#include "logbook/logbook_entry.h"
#include "logbook/logbook_io.h"
#include "logging/log.h"
#include "storage/sd_card.h"

namespace {
  constexpr const char* LOGBOOK_DIR = "/logbook";
  constexpr size_t LEAF_LOG_MAX_IGC_BYTES = 25 * 1024 * 1024;
  constexpr const char* REPAIR_QUEUE = "/.logbook-repair.tmp";
  constexpr size_t MAX_PATH_BYTES = 512;
  File repairDirectory, repairQueue;
  LogRepairStatus repairStatus;
  bool cancelRepairRequested = false;

  bool repairOnce(const String& path) {
    return !flightTimer_isRunning() && sdcard.firmwareCanAccessFilesystem() &&
           logbook_io::recover(path);
  }

  void closeRepairFiles() {
    repairDirectory.close();
    repairQueue.close();
    if (sdcard.firmwareCanAccessFilesystem()) SD_MMC.remove(REPAIR_QUEUE);
  }

  void finishRepair(LogRepairState state) {
    closeRepairFiles();
    repairStatus.state = state;
  }

  bool healthyMain(const String& path) {
    if (logbook_io::needsMaintenance(path)) return false;
    JsonDocument doc;
    return logbook_io::load(path, doc) && (doc["complete"].isNull() || doc["complete"].as<bool>());
  }

  bool nominalPath(const String& entry, String& path) {
    path = LogbookStore::normalizePath(entry);
    return LogbookStore::isLogbookJsonPath(path) && !flightTimer_ownsLogbookPath(path);
  }

  bool getNextLogbookPath(File& dir, String& path) {
    while (true) {
      String next = dir.getNextFileName();
      if (next.isEmpty()) return false;
      if (nominalPath(next, path)) return true;
    }
  }

  bool isIgcTrack(JsonObjectConst track, const String& path) {
    String format = track["format"] | "";
    format.toLowerCase();
    String lowerPath = path;
    lowerPath.toLowerCase();
    return format == "igc" || lowerPath.endsWith(".igc");
  }

  bool normalizeTrackPath(const String& raw, String& normalized) {
    normalized = raw;
    normalized.trim();
    normalized.replace('\\', '/');
    if (normalized.startsWith("tracks/")) normalized = "/" + normalized;
    if (!normalized.startsWith("/tracks/") || normalized.indexOf("/../") >= 0 ||
        normalized.endsWith("/..") || normalized.indexOf("/./") >= 0) {
      normalized = "";
      return false;
    }
    return true;
  }

  bool writeLeafLogResult(const String& path, const char* key, const String& value) {
    if (value.isEmpty() || flightTimer_isRunning()) return false;
    const String normalizedPath = LogbookStore::normalizePath(path);
    logbook_io::Guard guard;
    if (!guard) return false;
    if ((logbook_io::needsRepair(normalizedPath) || SD_MMC.exists(normalizedPath + ".bak")) &&
        (!repairOnce(normalizedPath) || logbook_io::needsRepair(normalizedPath)))
      return false;
    JsonDocument doc;
    if (!logbook_io::load(normalizedPath, doc)) return false;
    const uint32_t revision = doc["revision"] | 0U;
    if (revision == UINT32_MAX) return false;
    doc["revision"] = revision + 1;
    if (doc["complete"].isNull()) doc["complete"] = doc["end"].is<JsonObject>();
    JsonObject leafLog = doc["leaf_log"].to<JsonObject>();
    leafLog.clear();
    leafLog[key] = value;

    return logbook_io::commit(normalizedPath, doc);
  }
}  // namespace

void LogbookScan::cancel() {
  directory_.close();
  pending_ = false;
  anchor_ = newest_ = "";
  navigation_ = LogbookNavigation();
}

void LogbookScan::begin(const String& anchor) {
  cancel();
  bool missing = false;
  unavailable_ = !logbook_io::directoryAvailable(&missing);
  if (unavailable_ || missing) return;
  anchor_ = anchor;
  newer_ = 0;
  directory_ = SD_MMC.open(LogbookStore::directoryPath());
  pending_ = bool(directory_);
  unavailable_ = !pending_;
}

void LogbookScan::service() {
  if (!pending_) return;
  if (!sdcard.firmwareCanAccessFilesystem()) {
    directory_.close();
    pending_ = false;
    unavailable_ = true;
    return;
  }
  logbook_io::Guard guard;
  if (!guard) return;
  const uint32_t started = millis();
  for (unsigned i = 0; i < 16; ++i) {
    if (i && millis() - started >= 5) return;
    errno = 0;
    String entry = directory_.getNextFileName(), path;
    const int directoryError = errno;
    if (entry.isEmpty()) {
      if (directoryError) unavailable_ = true;
      directory_.close();
      pending_ = false;
      navigation_.position =
          anchor_.isEmpty() ? (newest_.isEmpty() ? 0 : 1) : (navigation_.found ? newer_ + 1 : 0);
      if (anchor_.isEmpty()) navigation_.found = !newest_.isEmpty();
      return;
    }
    if (!nominalPath(entry, path)) continue;
    if (navigation_.total != UINT16_MAX) ++navigation_.total;
    // sortKeyForPath gives unsynced entries the same ordering as the old browser.
    const auto key = [](const String& p) -> String {
      String f = LogbookStore::filenameFromPath(p);
      if (f.startsWith("unsynced_")) return String("0000_") + f.substring(9);
      if (f.startsWith("date_not_available_")) return String("0000_") + f.substring(19);
      return f;
    };
    const String candidate = key(path);
    if (anchor_.isEmpty()) {
      if (newest_.isEmpty() || candidate > key(newest_)) {
        navigation_.previousPath = newest_;
        newest_ = path;
      } else if (navigation_.previousPath.isEmpty() || candidate > key(navigation_.previousPath)) {
        navigation_.previousPath = path;
      }
    } else {
      const String anchorKey = key(anchor_);
      if (path == anchor_)
        navigation_.found = true;
      else if (candidate > anchorKey) {
        if (newer_ != UINT16_MAX) ++newer_;
        if (navigation_.nextPath.isEmpty() || candidate < key(navigation_.nextPath))
          navigation_.nextPath = path;
      } else if (candidate < anchorKey && (navigation_.previousPath.isEmpty() ||
                                           candidate > key(navigation_.previousPath))) {
        navigation_.previousPath = path;
      }
    }
  }
}

bool LogbookStore::repairPending() {
  return ::repairStatus.state == LogRepairState::Checking ||
         ::repairStatus.state == LogRepairState::Ready ||
         ::repairStatus.state == LogRepairState::Repairing;
}

LogRepairStatus LogbookStore::repairStatus() { return ::repairStatus; }

bool LogbookStore::beginRepairSession(bool scan) {
  if (!scan) cancelRepairRequested = true;
  logbook_io::Guard guard;
  if (!guard) return false;
  if (!scan) {
    if (repairPending()) finishRepair(LogRepairState::Cancelled);
    cancelRepairRequested = false;
    return true;
  }
  if (repairPending()) return false;
  cancelRepairRequested = false;
  closeRepairFiles();
  ::repairStatus = LogRepairStatus();
  bool missing = false;
  if (flightTimer_isRunning() || !logbook_io::directoryAvailable(&missing)) {
    finishRepair(LogRepairState::Failed);
    return true;
  }
  if (missing) {
    finishRepair(LogRepairState::Complete);
    return true;
  }
  repairDirectory = SD_MMC.open(LOGBOOK_DIR);
  if (!repairDirectory) {
    finishRepair(LogRepairState::Failed);
    return true;
  }
  repairQueue = SD_MMC.open(REPAIR_QUEUE, "w", true);
  if (!repairQueue) {
    finishRepair(LogRepairState::Failed);
    return true;
  }
  ::repairStatus.state = LogRepairState::Checking;
  return true;
}

bool LogbookStore::startRepair() {
  logbook_io::Guard guard;
  if (!guard || cancelRepairRequested || ::repairStatus.state != LogRepairState::Ready)
    return false;
  if (!sdcard.firmwareCanAccessFilesystem() || !sdcard.isCardPresent()) {
    finishRepair(LogRepairState::Failed);
    return false;
  }
  repairQueue = SD_MMC.open(REPAIR_QUEUE, "r");
  if (!repairQueue) {
    finishRepair(LogRepairState::Failed);
    return false;
  }
  ::repairStatus.state = LogRepairState::Repairing;
  return true;
}

void LogbookStore::serviceRepair() {
  if (!repairPending()) return;
  logbook_io::Guard guard;
  if (!guard) return;
  if (cancelRepairRequested) {
    cancelRepairRequested = false;
    finishRepair(LogRepairState::Cancelled);
    return;
  }
  if (flightTimer_isRunning()) {
    finishRepair(LogRepairState::Cancelled);
    return;
  }
  if (::repairStatus.state == LogRepairState::Ready) return;
  if (!sdcard.firmwareCanAccessFilesystem() || !sdcard.isCardPresent()) {
    finishRepair(LogRepairState::Failed);
    return;
  }
  if (::repairStatus.state == LogRepairState::Repairing) {
    if (!repairQueue.available()) {
      finishRepair(::repairStatus.repaired + ::repairStatus.unresolved == ::repairStatus.problems
                       ? LogRepairState::Complete
                       : LogRepairState::Failed);
      return;
    }
    uint8_t prefix[2];
    if (repairQueue.read(prefix, 2) != 2) {
      finishRepair(LogRepairState::Failed);
      return;
    }
    const size_t length = prefix[0] | (size_t(prefix[1]) << 8);
    char buffer[MAX_PATH_BYTES + 1];
    if (!length || length > MAX_PATH_BYTES || repairQueue.readBytes(buffer, length) != length) {
      finishRepair(LogRepairState::Failed);
      return;
    }
    buffer[length] = 0;
    String path(buffer);
    if (!isLogbookJsonPath(path)) {
      finishRepair(LogRepairState::Failed);
      return;
    }
    // The logbook directory is closed throughout mutation; each queued path gets one attempt.
    if (logbook_io::maintain(path) && healthyMain(path))
      ++::repairStatus.repaired;
    else
      ++::repairStatus.unresolved;
    return;
  }
  const uint32_t started = millis();
  for (unsigned entries = 0; entries < 16; ++entries) {
    if (entries && millis() - started >= 5) return;
    errno = 0;
    String entry = repairDirectory.getNextFileName(), path;
    const int directoryError = errno;
    if (entry.isEmpty()) {
      if (directoryError) {
        finishRepair(LogRepairState::Failed);
        return;
      }
      repairDirectory.close();
      repairQueue.flush();
      repairQueue.close();
      if (!::repairStatus.problems)
        finishRepair(LogRepairState::Complete);
      else
        ::repairStatus.state = LogRepairState::Ready;
      return;
    }
    if (!logbook_io::candidatePath(entry, path)) continue;
    ++::repairStatus.checked;
    if (healthyMain(path)) continue;
    const size_t length = path.length();
    const uint8_t prefix[] = {uint8_t(length), uint8_t(length >> 8)};
    if (!length || length > MAX_PATH_BYTES || repairQueue.write(prefix, 2) != 2 ||
        repairQueue.write((const uint8_t*)path.c_str(), length) != length) {
      finishRepair(LogRepairState::Failed);
      return;
    }
    ++::repairStatus.problems;
  }
}

uint16_t LogbookStore::count() {
  logbook_io::Guard guard;
  if (!guard || !sdcard.firmwareCanAccessFilesystem()) return 0;
  File dir = SD_MMC.open(LOGBOOK_DIR);
  if (!dir) return 0;

  uint16_t entries = 0;
  String path;
  while (getNextLogbookPath(dir, path)) {
    entries++;
  }
  return entries;
}

bool LogbookStore::newestEntryPath(String& path) {
  logbook_io::Guard guard;
  if (!guard || !sdcard.firmwareCanAccessFilesystem()) return false;
  File dir = SD_MMC.open(LOGBOOK_DIR);
  if (!dir) return false;

  bool found = false;
  String bestPath;
  String bestKey;
  String candidatePath;
  while (getNextLogbookPath(dir, candidatePath)) {
    String candidateKey = sortKeyForPath(candidatePath);
    if (!found || candidateKey > bestKey) {
      found = true;
      bestPath = candidatePath;
      bestKey = candidateKey;
    }
  }

  if (!found) return false;
  path = bestPath;
  return true;
}

bool LogbookStore::previousEntryPath(const String& currentPath, String& path) {
  LogbookNavigation navigation;
  if (!navigationForPath(currentPath, navigation) || navigation.previousPath.isEmpty())
    return false;
  path = navigation.previousPath;
  return true;
}

bool LogbookStore::nextEntryPath(const String& currentPath, String& path) {
  LogbookNavigation navigation;
  if (!navigationForPath(currentPath, navigation) || navigation.nextPath.isEmpty()) return false;
  path = navigation.nextPath;
  return true;
}

bool LogbookStore::entryPositionNewestFirst(const String& currentPath, uint16_t& position,
                                            uint16_t& total) {
  LogbookNavigation navigation;
  if (!navigationForPath(currentPath, navigation)) return false;
  position = navigation.position;
  total = navigation.total;
  return true;
}

bool LogbookStore::navigationForPath(const String& currentPath, LogbookNavigation& navigation) {
  logbook_io::Guard guard;
  if (!guard || !sdcard.firmwareCanAccessFilesystem()) return false;
  navigation = LogbookNavigation();
  File dir = SD_MMC.open(LOGBOOK_DIR);
  if (!dir) return false;

  const String currentKey = sortKeyForPath(currentPath);
  uint16_t newerEntries = 0;
  String previousKey;
  String nextKey;
  String candidatePath;
  while (getNextLogbookPath(dir, candidatePath)) {
    const String candidateKey = sortKeyForPath(candidatePath);
    navigation.total++;
    if (candidateKey == currentKey) {
      navigation.found = true;
    } else if (candidateKey > currentKey) {
      newerEntries++;
      if (nextKey.isEmpty() || candidateKey < nextKey) {
        nextKey = candidateKey;
        navigation.nextPath = candidatePath;
      }
    } else if (candidateKey < currentKey) {
      if (previousKey.isEmpty() || candidateKey > previousKey) {
        previousKey = candidateKey;
        navigation.previousPath = candidatePath;
      }
    }
  }

  if (!navigation.found) return false;
  navigation.position = newerEntries + 1;
  return true;
}

bool LogbookStore::readSummary(const String& path, LogbookEntrySummary& summary,
                               LogbookReadStatus* status) {
  summary = LogbookEntrySummary();
  if (status) *status = LogbookReadStatus::Unavailable;
  logbook_io::Guard guard;
  if (!guard || !sdcard.firmwareCanAccessFilesystem()) return false;
  const String normalizedPath = normalizePath(path);
  // Preserve a readable main on an unresolved conflict; writes/uploads remain blocked.
  JsonDocument doc;
  if (!logbook_io::load(normalizedPath, doc)) {
    if (status && logbook_io::lastResult().error == EBADMSG)
      *status = LogbookReadStatus::RepairNeeded;
    return false;
  }
  if (doc["complete"].is<bool>() && !doc["complete"].as<bool>()) {
    if (status) *status = LogbookReadStatus::RepairNeeded;
    return false;
  }
  if (status) *status = LogbookReadStatus::Ready;
  summary.valid = true;
  summary.path = normalizedPath;
  summary.filename = filenameFromPath(normalizedPath);
  summary.flightId = doc["flight_id"] | "";
  JsonObject pilot = doc["pilot"];
  summary.pilotName = pilot["name"] | "";
  JsonObject glider = doc["glider"];
  summary.gliderDisplayName = glider["display_name"] | "";

  JsonObject start = doc["start"];
  summary.startTimeValid = start["time_valid"] | false;
  summary.startTimeUtc = start["time_utc"] | "";
  summary.startTimeLocal = start["time_local"] | "";
  JsonObject startLocation = start["location"];
  if (!startLocation.isNull()) {
    summary.startAltitudeM = startLocation["altitude_m"] | 0.0f;
  } else {
    JsonObject firstFix = doc["first_fix"];
    JsonObject firstFixLocation = firstFix["location"];
    summary.startAltitudeM = firstFixLocation["altitude_m"] | 0.0f;
  }

  JsonObject end = doc["end"];
  JsonObject endLocation = end["location"];
  summary.endAltitudeM = endLocation["altitude_m"] | 0.0f;

  JsonObject metrics = doc["metrics"];
  summary.durationSeconds = metrics["duration_seconds"] | 0;
  summary.maxAltitudeM = metrics["max_altitude_m"] | 0.0f;
  summary.minAltitudeM = metrics["min_altitude_m"] | 0.0f;
  summary.maxAltitudeAboveLaunchM = metrics["max_altitude_above_launch_m"] | 0.0f;
  summary.maxClimbRateMps = metrics["max_climb_rate_mps"] | 0.0f;
  summary.maxSinkRateMps = metrics["max_sink_rate_mps"] | 0.0f;
  summary.maxGroundSpeedMps = metrics["max_ground_speed_mps"] | 0.0f;
  JsonObject maxWind = metrics["max_wind"];
  summary.maxWindValid = !maxWind.isNull();
  summary.maxWindSpeedMps = maxWind["speed_mps"] | 0.0f;
  summary.maxWindDirectionFromDeg = maxWind["direction_from_deg"] | 0.0f;
  summary.pathDistanceM = metrics["path_distance_m"] | 0.0f;
  summary.straightLineDistanceM = metrics["straight_line_distance_m"] | 0.0f;
  summary.maxAccelG = metrics["max_accel_g"] | NAN;
  summary.minAccelG = metrics["min_accel_g"] | NAN;
  summary.maxTemperatureC = metrics["max_temperature_c"] | 0.0f;
  summary.minTemperatureC = metrics["min_temperature_c"] | 0.0f;

  JsonObject track = doc["track"];
  summary.trackSaved = track["saved"] | false;
  summary.trackFormat = track["format"] | "";
  summary.trackPath = track["path"] | "";

  JsonObject leafLog = doc["leaf_log"];
  summary.leafLogFlightId = leafLog["flight_id"] | "";
  summary.leafLogRejection = leafLog["rejected"] | "";
  if (!summary.leafLogFlightId.isEmpty()) {
    summary.leafLogStatus = LeafLogFlightStatus::Uploaded;
  } else if (!summary.leafLogRejection.isEmpty()) {
    summary.leafLogStatus = LeafLogFlightStatus::Rejected;
  } else if (summary.trackSaved && isIgcTrack(track, summary.trackPath)) {
    summary.leafLogStatus = LeafLogFlightStatus::NotUploaded;
  }

  return true;
}

bool LogbookStore::classifyForLeafLog(const String& path, LeafLogCandidate& candidate) {
  logbook_io::Guard guard;
  if (!guard || !sdcard.firmwareCanAccessFilesystem()) return false;
  candidate = LeafLogCandidate();
  candidate.logbookPath = normalizePath(path);
  if (flightTimer_isRunning()) return false;
  if (logbook_io::needsMaintenance(candidate.logbookPath) &&
      (!logbook_io::maintain(candidate.logbookPath) ||
       logbook_io::needsRepair(candidate.logbookPath)))
    return false;
  if (logbook_io::needsRepair(candidate.logbookPath) &&
      (!repairOnce(candidate.logbookPath) || logbook_io::needsRepair(candidate.logbookPath)))
    return false;
  JsonDocument doc;
  if (!logbook_io::load(candidate.logbookPath, doc)) {
    if (!repairOnce(candidate.logbookPath) || !logbook_io::load(candidate.logbookPath, doc))
      return false;
  }
  // Sparse legacy records may acquire completion=false with their upload marker.
  // That existing result is authoritative unless an auxiliary already required repair.
  if (doc["complete"].is<bool>() && !doc["complete"].as<bool>()) {
    const char* uploaded = doc["leaf_log"]["flight_id"] | "";
    const char* rejected = doc["leaf_log"]["rejected"] | "";
    if (!*uploaded && !*rejected &&
        (!repairOnce(candidate.logbookPath) || !logbook_io::load(candidate.logbookPath, doc)))
      return false;
  }

  JsonObjectConst root = doc.as<JsonObjectConst>();
  JsonObjectConst leafLog = root["leaf_log"];
  const String flightId = leafLog["flight_id"] | "";
  candidate.rejectionReason = leafLog["rejected"] | "";
  if (!flightId.isEmpty()) {
    candidate.disposition = LeafLogCandidate::Disposition::Delivered;
    return true;
  }
  if (!candidate.rejectionReason.isEmpty()) {
    candidate.disposition = LeafLogCandidate::Disposition::Rejected;
    candidate.rejectionPersisted = true;
    return true;
  }

  if (root["complete"].is<bool>() && !root["complete"].as<bool>()) return true;
  const String schema = root["schema"] | "";
  JsonObjectConst track = root["track"];
  if (schema != "leaf.logbook.flight" || track.isNull()) {
    candidate.disposition = LeafLogCandidate::Disposition::Rejected;
    candidate.rejectionReason = "invalid_logbook";
    return true;
  }

  const bool saved = track["saved"] | false;
  const String rawTrackPath = track["path"] | "";
  if (!saved || !isIgcTrack(track, rawTrackPath)) return true;
  if (rawTrackPath.isEmpty()) {
    candidate.disposition = LeafLogCandidate::Disposition::Rejected;
    candidate.rejectionReason = "invalid_logbook";
    return true;
  }
  if (!normalizeTrackPath(rawTrackPath, candidate.trackPath)) {
    candidate.disposition = LeafLogCandidate::Disposition::Rejected;
    candidate.rejectionReason = "unsafe_track_path";
    return true;
  }
  candidate.trackFilename = filenameFromPath(candidate.trackPath);
  File trackFile = SD_MMC.open(candidate.trackPath, "r");
  if (!trackFile) {
    candidate.disposition = LeafLogCandidate::Disposition::Rejected;
    candidate.rejectionReason = "missing_track";
    return true;
  }
  candidate.trackSize = trackFile.size();
  trackFile.close();
  if (candidate.trackSize == 0) {
    candidate.disposition = LeafLogCandidate::Disposition::Rejected;
    candidate.rejectionReason = "empty_track";
  } else if (candidate.trackSize > LEAF_LOG_MAX_IGC_BYTES) {
    candidate.disposition = LeafLogCandidate::Disposition::Rejected;
    candidate.rejectionReason = "too_large";
  } else {
    candidate.disposition = LeafLogCandidate::Disposition::Pending;
  }
  return true;
}

bool LogbookStore::recordLeafLogFlightId(const String& path, const String& flightId) {
  return writeLeafLogResult(path, "flight_id", flightId);
}

bool LogbookStore::recordLeafLogRejection(const String& path, const String& reason) {
  return writeLeafLogResult(path, "rejected", reason);
}

const char* LogbookStore::leafLogStatusName(LeafLogFlightStatus status) {
  switch (status) {
    case LeafLogFlightStatus::NotUploaded:
      return "not_uploaded";
    case LeafLogFlightStatus::Uploaded:
      return "uploaded";
    case LeafLogFlightStatus::Rejected:
      return "rejected";
    case LeafLogFlightStatus::NotApplicable:
    default:
      return "not_applicable";
  }
}

const char* LogbookStore::leafLogRejectionLabel(const String& reason) {
  if (reason == "invalid_logbook") return "Invalid logbook";
  if (reason == "unsafe_track_path") return "Unsafe track path";
  if (reason == "missing_track") return "Track file missing";
  if (reason == "empty_track") return "Track file empty";
  if (reason == "too_large") return "Too large";
  if (reason == "invalid_igc") return "Invalid IGC";
  return "Upload rejected";
}

bool LogbookStore::deleteEntry(const String& path) {
  // Deletion must not race an idle directory iterator or restart repair afterward.
  beginRepairSession(false);
  // The shared eraser discovers tracks and filename aliases without running recovery.
  return logbook_io::erase(normalizePath(path));
}

bool LogbookStore::isLogbookJsonPath(const String& path) {
  const String normalizedPath = normalizePath(path);
  if (!normalizedPath.startsWith(String(LOGBOOK_DIR) + "/")) return false;
  if (!normalizedPath.endsWith(".json")) return false;
  if (normalizedPath.indexOf("..") >= 0 || normalizedPath.indexOf('\\') >= 0 ||
      normalizedPath.indexOf('/', 9) >= 0)
    return false;
  if (normalizedPath.endsWith(".tmp")) return false;
  return filenameFromPath(normalizedPath).length() > 5;
}

String LogbookStore::normalizePath(const String& path) {
  if (path.isEmpty()) return "";
  if (path[0] == '/') return path;
  if (path.startsWith("logbook/")) return "/" + path;
  return String(LOGBOOK_DIR) + "/" + path;
}

String LogbookStore::filenameFromPath(const String& path) {
  const int slash = path.lastIndexOf('/');
  if (slash < 0) return path;
  return path.substring(slash + 1);
}

String LogbookStore::sortKeyForPath(const String& path) {
  const String filename = filenameFromPath(normalizePath(path));
  if (filename.startsWith("unsynced_")) return String("0000_") + filename.substring(9);
  if (filename.startsWith("date_not_available_")) return String("0000_") + filename.substring(19);
  return filename;
}
