DangerMonkeys/leaf/src/vario/navigation/gpx.cpp

// GPX is the common gps file format for storing waypoints, routes, and tracks, etc.
// This CPP file is for functions related to navigating and tracking active waypoints and routes
// (Though Leaf may/will support other file types in the future, we'll still use this gpx.cpp file
// even when dealing with other datatypes)

#include "navigation/gpx.h"

#include <ArduinoJson.h>
#include <FS.h>
#include <SD_MMC.h>

#include "diagnostics/heap_monitor.h"
#include "instruments/baro.h"
#include "instruments/gps.h"
#include "logging/log.h"
#include "navigation/gpx_parser.h"
#include "navigation/route_store.h"
#include "navigation/user_waypoints.h"
#include "storage/files.h"
#include "storage/sd_card.h"
#include "ui/audio/sound_effects.h"
#include "ui/audio/speaker.h"

Navigator navigator;

namespace {
  constexpr size_t MAX_NAV_LINE_LENGTH = 256;
  constexpr const char* NAV_STATE_SCHEMA = "leaf.nav_state";
  constexpr const char* LEGACY_ACTIVE_ROUTE_SCHEMA = "leaf.active_route";

  String filenameFromPath(const String& path) {
    const int slash = path.lastIndexOf('/');
    if (slash < 0) return path;
    return path.substring(slash + 1);
  }

  String lowerExtension(const String& fileName) {
    const int dot = fileName.lastIndexOf('.');
    if (dot < 0) return "";
    String ext = fileName.substring(dot + 1);
    ext.toLowerCase();
    return ext;
  }

  const char* sourceName(LoadedNavSource source) {
    switch (source) {
      case LoadedNavSource::NavFile:
        return "nav_file";
      case LoadedNavSource::SavedRoute:
        return "saved_route";
      case LoadedNavSource::UserWaypoints:
        return "user_waypoints";
      case LoadedNavSource::None:
      default:
        return "none";
    }
  }

  LoadedNavSource sourceFromName(const char* value) {
    if (value == nullptr) return LoadedNavSource::None;
    if (strcmp(value, "nav_file") == 0) return LoadedNavSource::NavFile;
    if (strcmp(value, "saved_route") == 0) return LoadedNavSource::SavedRoute;
    if (strcmp(value, "user_waypoints") == 0) return LoadedNavSource::UserWaypoints;
    return LoadedNavSource::None;
  }

  bool writeNavState(JsonDocument& doc) {
    if (!SD_MMC.exists(route_store::directoryPath()) && !SD_MMC.mkdir(route_store::directoryPath()))
      return false;

    const char* tempPath = "/routes/active.tmp";
    if (SD_MMC.exists(tempPath)) SD_MMC.remove(tempPath);

    File file = SD_MMC.open(tempPath, "w", true);
    if (!file) return false;

    const size_t written = serializeJsonPretty(doc, file);
    file.close();
    if (written == 0) {
      SD_MMC.remove(tempPath);
      return false;
    }

    SD_MMC.remove(route_store::activeRoutePath());
    if (!SD_MMC.rename(tempPath, route_store::activeRoutePath())) {
      SD_MMC.remove(tempPath);
      return false;
    }
    return true;
  }

  bool readLine(File& file, char* buffer, size_t len) {
    if (!file || file.available() <= 0 || len == 0) return false;

    size_t index = 0;
    while (file.available() > 0) {
      const char c = file.read();
      if (c == '\r') continue;
      if (c == '\n') break;
      if (index + 1 < len) buffer[index++] = c;
    }
    buffer[index] = '\0';
    return true;
  }

  char* trimInPlace(char* value) {
    if (value == nullptr) return value;
    while (*value == ' ' || *value == '\t') value++;
    char* end = value + strlen(value);
    while (end > value && (end[-1] == ' ' || end[-1] == '\t')) {
      *--end = '\0';
    }
    return value;
  }

  bool nextCsvField(const char*& cursor, char* out, size_t outLen) {
    if (cursor == nullptr || *cursor == '\0' || outLen == 0) return false;

    size_t index = 0;
    bool quoted = false;
    if (*cursor == '"') {
      quoted = true;
      cursor++;
    }

    while (*cursor != '\0') {
      const char c = *cursor++;
      if (quoted) {
        if (c == '"') {
          if (*cursor == '"') {
            if (index + 1 < outLen) out[index++] = '"';
            cursor++;
          } else {
            quoted = false;
          }
        } else if (index + 1 < outLen) {
          out[index++] = c;
        }
      } else if (c == ',') {
        break;
      } else if (index + 1 < outLen) {
        out[index++] = c;
      }
    }

    out[index] = '\0';
    return true;
  }

  bool csvFieldAt(const char* line, uint8_t target, char* out, size_t outLen) {
    const char* cursor = line;
    char field[96];
    for (uint8_t i = 0; i <= target; i++) {
      if (!nextCsvField(cursor, field, sizeof(field))) return false;
    }
    strncpy(out, trimInPlace(field), outLen);
    out[outLen - 1] = '\0';
    return true;
  }

  bool parseCupCoordinate(const char* text, double& value) {
    if (text == nullptr) return false;
    char buffer[32];
    strncpy(buffer, text, sizeof(buffer));
    buffer[sizeof(buffer) - 1] = '\0';
    char* s = trimInPlace(buffer);
    const size_t len = strlen(s);
    if (len < 5) return false;

    const char hemi = s[len - 1];
    if (hemi != 'N' && hemi != 'S' && hemi != 'E' && hemi != 'W' && hemi != 'n' && hemi != 's' &&
        hemi != 'e' && hemi != 'w') {
      return false;
    }
    s[len - 1] = '\0';
    char* dot = strchr(s, '.');
    if (dot == nullptr || dot - s < 2) return false;

    const uint8_t degreeDigits = (dot - s) - 2;
    if (degreeDigits < 2 || degreeDigits > 3) return false;

    char degreesText[4] = "";
    strncpy(degreesText, s, degreeDigits);
    degreesText[degreeDigits] = '\0';
    const double degrees = atof(degreesText);
    const double minutes = atof(s + degreeDigits);
    if (minutes < 0 || minutes >= 60) return false;

    value = degrees + minutes / 60.0;
    if (hemi == 'S' || hemi == 'W' || hemi == 's' || hemi == 'w') value = -value;
    return true;
  }

  float parseElevationMeters(const char* text) {
    if (text == nullptr) return NAN;
    char* end;
    const float elevation = strtof(text, &end);
    return end != text && isfinite(elevation) ? elevation : NAN;
  }

  float parseElevationFeetAsMeters(const char* text) {
    return parseElevationMeters(text) * 0.3048f;
  }

  bool validCoordinate(double lat, double lon) {
    return lat >= -90 && lat <= 90 && lon >= -180 && lon <= 180;
  }

  bool addWaypoint(Navigator* result, const char* name, double lat, double lon, float ele) {
    if (!validCoordinate(lat, lon)) return false;

    Waypoint waypoint;
    waypoint.setName(name);
    waypoint.setCoordinates(lat, lon);
    waypoint.ele = ele;
    return result->addWaypoint(waypoint);
  }

  bool addOrFindRouteWaypoint(Navigator* result, Route* route, const char* name, double lat,
                              double lon, float ele) {
    if (!validCoordinate(lat, lon)) return false;

    Waypoint waypoint;
    waypoint.setName(name);
    waypoint.setCoordinates(lat, lon);
    waypoint.ele = ele;
    const WaypointID waypointIndex = result->addOrFindWaypoint(waypoint);
    return waypointIndex && result->addRoutePoint(route, waypointIndex);
  }

  bool parseCupFile(fs::FS& fs, const String& fileName, Navigator* result) {
    File file = fs.open(fileName, FILE_READ);
    if (!file) return false;

    char line[MAX_NAV_LINE_LENGTH];
    bool parsedAny = false;
    bool inTasks = false;
    uint16_t linesRead = 0;

    while (readLine(file, line, sizeof(line))) {
      if ((++linesRead & 0x0F) == 0) yield();
      char* trimmed = trimInPlace(line);
      if (trimmed[0] == '\0') continue;
      if (strstr(trimmed, "-----Related Tasks-----") != nullptr) {
        inTasks = true;
        continue;
      }

      if (!inTasks) {
        char name[64];
        char latText[32];
        char lonText[32];
        char eleText[32];
        if (!csvFieldAt(trimmed, 0, name, sizeof(name)) || strcmp(name, "name") == 0 ||
            strcmp(name, "Title") == 0 || !csvFieldAt(trimmed, 3, latText, sizeof(latText)) ||
            !csvFieldAt(trimmed, 4, lonText, sizeof(lonText)) ||
            !csvFieldAt(trimmed, 5, eleText, sizeof(eleText))) {
          continue;
        }

        double lat = 0;
        double lon = 0;
        if (parseCupCoordinate(latText, lat) && parseCupCoordinate(lonText, lon) &&
            addWaypoint(result, name, lat, lon, parseElevationMeters(eleText))) {
          parsedAny = true;
        }
      } else {
        char field[64];
        const char* cursor = trimmed;
        if (!nextCsvField(cursor, field, sizeof(field)) || field[0] == '\0') continue;
        if (result->totalRoutes >= maxRoutes) continue;

        Route* activeRoute = &result->routes[++result->totalRoutes];
        activeRoute->setName(field);
        while (nextCsvField(cursor, field, sizeof(field))) {
          char* wpName = trimInPlace(field);
          if (wpName[0] == '\0') continue;
          const WaypointID waypointIndex = result->findWaypointByName(wpName);
          if (waypointIndex) result->addRoutePoint(activeRoute, waypointIndex);
        }
        if (activeRoute->totalPoints == 0) result->totalRoutes--;
      }
    }

    file.close();
    return parsedAny;
  }

  bool parseWptFile(fs::FS& fs, const String& fileName, Navigator* result) {
    File file = fs.open(fileName, FILE_READ);
    if (!file) return false;

    char line[MAX_NAV_LINE_LENGTH];
    bool parsedAny = false;
    uint16_t linesRead = 0;
    while (readLine(file, line, sizeof(line))) {
      if ((++linesRead & 0x0F) == 0) yield();
      char* trimmed = trimInPlace(line);
      if (trimmed[0] == '\0' || strstr(trimmed, "OziExplorer") == trimmed) continue;

      char name[64];
      char latText[32];
      char lonText[32];
      char eleText[32] = "";
      double lat = 0;
      double lon = 0;
      float ele = 0;

      if (csvFieldAt(trimmed, 1, name, sizeof(name)) &&
          csvFieldAt(trimmed, 2, latText, sizeof(latText)) &&
          csvFieldAt(trimmed, 3, lonText, sizeof(lonText))) {
        csvFieldAt(trimmed, 14, eleText, sizeof(eleText));
        lat = atof(latText);
        lon = atof(lonText);
        ele = parseElevationFeetAsMeters(eleText);
      } else if (csvFieldAt(trimmed, 0, name, sizeof(name)) &&
                 csvFieldAt(trimmed, 1, latText, sizeof(latText)) &&
                 csvFieldAt(trimmed, 2, lonText, sizeof(lonText))) {
        csvFieldAt(trimmed, 3, eleText, sizeof(eleText));
        lat = atof(latText);
        lon = atof(lonText);
        ele = parseElevationMeters(eleText);
      } else {
        continue;
      }

      if (addWaypoint(result, name, lat, lon, ele)) parsedAny = true;
    }

    file.close();
    return parsedAny;
  }

}  // namespace

void Navigator::init() {
  clear();

  // loadWaypoints();
  // loadRoutes();
  // activatePoint(19);
  // activateRoute(3);
}

void Navigator::clear() {
  totalWaypoints = 0;
  totalRoutePointRefs = 0;
  totalRoutes = 0;
  activePoint = Waypoint();
  activeRoutePoint = RoutePoint();
  activeWaypointIndex = WaypointID::None;
  activeRoutePointIndex = RouteIndex::None;
  activeRouteIndex = RouteID::None;
  altAboveWaypoint = 0;
  glideToActive = 0;
  segmentDistance = 0;
  pointDistanceRemaining = 0;
  pointTimeRemaining = 0;
  turnToActive = 0;
  navigating = false;
  nextPoint_ = Waypoint();
  goalPoint_ = Waypoint();
  nextPointIndex_ = RouteIndex::None;
  altAboveGoal_ = 0;
  glideToGoal_ = 0;
  totalDistanceRemaining_ = 0;
  courseToActive_ = 0;
  courseToNext_ = 0;
  turnToNext_ = 0;
  reachedGoal_ = false;
  loadedFileWaypointCount_ = 0;
  loadedNavSource_ = LoadedNavSource::None;
  loadedGpxFilename_[0] = '\0';
  loadedNavPath_[0] = '\0';
  lastNavType_ = LastNavType::None;
  lastRouteIndex_ = RouteID::None;
  lastRoutePointIndex_ = RouteIndex::None;
  lastWaypointIndex_ = WaypointID::None;
}

bool Navigator::addWaypoint(const Waypoint& waypoint) {
  if (totalWaypoints >= maxNavPoints) {
    return false;
  }
  waypoints[++totalWaypoints] = waypoint;
  return true;
}

WaypointID Navigator::findWaypointByName(const char* name) const {
  if (name == nullptr || name[0] == '\0') {
    return WaypointID::None;
  }
  for (uint8_t i = 1; i <= totalWaypoints; i++) {
    if (strncmp(waypoints[i].name, name, maxGpxNameLength) == 0) {
      return WaypointID(i);
    }
  }
  return WaypointID::None;
}

WaypointID Navigator::addOrFindWaypoint(const Waypoint& waypoint) {
  WaypointID existingIndex = findWaypointByName(waypoint.name);
  if (existingIndex) {
    return existingIndex;
  }
  if (!addWaypoint(waypoint)) {
    return WaypointID::None;
  }
  return WaypointID(totalWaypoints);
}

bool Navigator::addRoutePoint(Route* route, WaypointID waypointIndex, uint16_t radiusM,
                              RoutePointRole role) {
  if (!waypointIndex || totalRoutePointRefs >= maxRoutePointRefs) {
    return false;
  }
  if (route->totalPoints == 0) {
    route->firstRoutePointIndex = totalRoutePointRefs + 1;
  }
  RoutePoint routePoint;
  routePoint.waypointIndex = waypointIndex;
  routePoint.radiusM = radiusM == 0 ? defaultWaypointRadius : radiusM;
  routePoint.role = role;
  routePoints[++totalRoutePointRefs] = routePoint;
  route->totalPoints++;
  return true;
}

const Waypoint& Navigator::waypoint(WaypointID pointIndex) const { return waypoints[pointIndex]; }

const Waypoint& Navigator::routePoint(RouteID routeIndex, RouteIndex pointIndex) const {
  return waypoint(routePointMeta(routeIndex, pointIndex).waypointIndex);
}

const RoutePoint& Navigator::routePointMeta(RouteID routeIndex, RouteIndex pointIndex) const {
  return routePoints[routes[routeIndex].firstRoutePointIndex + pointIndex - 1];
}

// update nav data every second
void Navigator::update() {
  if (hasActivePoint() && !gpsPositionUsable()) {
    clearNavSolution();
  }

  // only update nav info if we're tracking to an active point
  if (hasNavSolution()) {
    // update distance remaining, then sequence to next point if distance is small enough
    pointDistanceRemaining = gps.distanceBetween(gps.location.lat(), gps.location.lng(),
                                                 activePoint.latitude(), activePoint.longitude());
    if (segmentDistance <= 0) segmentDistance = pointDistanceRemaining;
    const uint16_t activeRadius = activeCylinderRadiusM();
    if (pointDistanceRemaining < activeRadius && !reachedGoal_ && flightTimer_isLogging())
      sequenceWaypoint();  //  (this will also update distance to the new point)

    // Sequencing may have changed the active point and its cylinder.
    pointDistanceRemaining = gps.distanceBetween(gps.location.lat(), gps.location.lng(),
                                                 activePoint.latitude(), activePoint.longitude());
    totalDistanceRemaining_ = pointDistanceRemaining;
    goalPoint_ = activePoint;
    if (activeRouteIndex) {
      const Route& route = routes[activeRouteIndex];
      goalPoint_ = routePoint(activeRouteIndex, RouteIndex(route.totalPoints));
      for (int i = activeRoutePointIndex; i < route.totalPoints; ++i) {
        const Waypoint& from = routePoint(activeRouteIndex, RouteIndex(i));
        const Waypoint& to = routePoint(activeRouteIndex, RouteIndex(i + 1));
        totalDistanceRemaining_ +=
            gps.distanceBetween(from.latitude(), from.longitude(), to.latitude(), to.longitude());
      }
    }

    // update time remaining
    if (!gps.hasFreshGroundSpeed() || gps.speed.mps() < 0.5) {
      pointTimeRemaining = 0;
    } else {
      pointTimeRemaining = pointDistanceRemaining / gps.speed.mps();
    }

    // get degress to active point
    courseToActive_ = gps.courseTo(gps.location.lat(), gps.location.lng(), activePoint.latitude(),
                                   activePoint.longitude());
    turnToActive = courseToActive_ - gps.course.deg();
    if (turnToActive > 180)
      turnToActive -= 360;
    else if (turnToActive < -180)
      turnToActive += 360;

    // if there's a next point, get course to that as well
    if (nextPointIndex_) {
      courseToNext_ = gps.courseTo(gps.location.lat(), gps.location.lng(), nextPoint_.latitude(),
                                   nextPoint_.longitude());
      turnToNext_ = courseToNext_ - gps.course.deg();
      if (turnToNext_ > 180)
        turnToNext_ -= 360;
      else if (turnToNext_ < -180)
        turnToNext_ += 360;
    }

    // get glide to active (and goal point, if we're on a route)
    const double heightAboveWaypoint = gps.altitude.meters() - activePoint.ele;
    glideToActive = isfinite(heightAboveWaypoint) && heightAboveWaypoint > 0
                        ? pointDistanceRemaining / heightAboveWaypoint
                        : 0;
    const double heightAboveGoal = gps.altitude.meters() - goalPoint_.ele;
    glideToGoal_ = isfinite(heightAboveGoal) && heightAboveGoal > 0
                       ? goalDistanceRemaining() / heightAboveGoal
                       : 0;

    // update relative altimeters (in cm)
    // alt above active point
    altAboveWaypoint = isfinite(heightAboveWaypoint) ? 100 * heightAboveWaypoint : -1000000;

    // alt above goal (if we're on a route and have a goal; otherwise, set relative goal alt to same
    // as next point)
    if (activeRouteIndex)
      altAboveGoal_ = isfinite(heightAboveGoal) ? 100 * heightAboveGoal : -1000000;
    else
      altAboveGoal_ = altAboveWaypoint;
  }
}

// Start, Sequence, and End Navigation Functions

bool Navigator::activatePoint(WaypointID pointIndex) { return activatePoint(pointIndex, true); }

bool Navigator::activatePoint(WaypointID pointIndex, bool playSound) {
  if (!pointIndex || pointIndex > totalWaypoints) return false;

  navigating = true;
  reachedGoal_ = false;
  lastNavType_ = LastNavType::Point;
  lastRouteIndex_ = RouteID::None;
  lastRoutePointIndex_ = RouteIndex::None;
  lastWaypointIndex_ = pointIndex;

  // Point navigation is exclusive from Route navigation, so cancel any Route navigation
  activeRouteIndex = RouteID::None;
  activeRoutePointIndex = RouteIndex::None;

  activeWaypointIndex = pointIndex;
  activePoint = waypoint(activeWaypointIndex);
  activeRoutePoint = RoutePoint();

  if (playSound) speaker.playSound(fx::enter);

  if (gpsPositionUsable()) {
    double newDistance = gps.distanceBetween(gps.location.lat(), gps.location.lng(),
                                             activePoint.latitude(), activePoint.longitude());

    segmentDistance = newDistance;
    totalDistanceRemaining_ = newDistance;
    pointDistanceRemaining = newDistance;
  } else {
    segmentDistance = 0;
    totalDistanceRemaining_ = 0;
    clearNavSolution();
  }

  savePersistedState();
  return navigating;
}

bool Navigator::activateRoute(RouteID routeIndex) { return activateRoute(routeIndex, true); }

bool Navigator::activateRoute(RouteID routeIndex, bool playSound) {
  return activateRoute(routeIndex, RouteIndex(1), playSound);
}

bool Navigator::activateRoute(RouteID routeIndex, RouteIndex routePointIndex) {
  return activateRoute(routeIndex, routePointIndex, true);
}

bool Navigator::activateRoute(RouteID routeIndex, RouteIndex routePointIndex, bool playSound) {
  if (!routeIndex || routeIndex > totalRoutes) return false;

  // first check if any valid points
  uint8_t validPoints = routes[routeIndex].totalPoints;
  if (routePointIndex < 1 || routePointIndex > validPoints) return false;
  if (!validPoints) {
    navigating = false;
  } else {
    navigating = true;
    reachedGoal_ = false;
    activeRouteIndex = routeIndex;
    activeWaypointIndex = WaypointID::None;
    lastNavType_ = LastNavType::Route;
    lastRouteIndex_ = routeIndex;
    lastRoutePointIndex_ = routePointIndex;
    lastWaypointIndex_ = WaypointID::None;

    Serial.print("*** NEW ROUTE: ");
    Serial.println(routes[activeRouteIndex].name);

    // set activePointIndex to one before the desired point, then call sequenceWaypoint() to
    // increment and populate new
    // activePoint, and nextPoint, if any
    activeRoutePointIndex = routePointIndex - 1;
    sequenceWaypoint(playSound);
    if (!gpsPositionUsable()) clearNavSolution();

    update();  // Populate remaining-route metrics for the selected starting point.
  }
  savePersistedState();
  return navigating;
}

bool Navigator::sequenceWaypoint(bool playSound) {
  Serial.print("entering sequence..");

  bool successfulSequence = false;

  // sequence to next point if we're on a route && there's another point in the Route
  if (activeRouteIndex && activeRoutePointIndex < routes[activeRouteIndex].totalPoints) {
    successfulSequence = true;

    // TODO: play going to next point sound, or whatever
    if (playSound) speaker.playSound(fx::enter);

    activeRoutePointIndex++;
    lastNavType_ = LastNavType::Route;
    lastRouteIndex_ = activeRouteIndex;
    lastRoutePointIndex_ = activeRoutePointIndex;
    lastWaypointIndex_ = WaypointID::None;
    Serial.print(" new active index:");
    Serial.print(activeRoutePointIndex);
    Serial.print(" route index:");
    Serial.print(activeRouteIndex);
    activeRoutePoint = routePointMeta(activeRouteIndex, activeRoutePointIndex);
    activePoint = waypoint(activeRoutePoint.waypointIndex);

    Serial.print(" new point:");
    Serial.print(activePoint.name);
    Serial.print(" new lat: ");
    Serial.print(activePoint.latitude());

    if (activeRoutePointIndex + 1 <
        routes[activeRouteIndex]
            .totalPoints) {  // if there's also a next point in the list, capture that
      nextPointIndex_ = activeRoutePointIndex + 1;
      nextPoint_ = routePoint(activeRouteIndex, nextPointIndex_);
    } else {  // otherwise signify no next point, so we don't show display functions related to next
              // point
      nextPointIndex_ = RouteIndex::NoNextPoint;
    }

    // get distance between present (prev) point and new activePoint (used for distance progress
    // bar) if we're sequencing to the very first point, then there's no previous point to use, so
    // use our current location instead
    if (activeRoutePointIndex == 1) {
      segmentDistance =
          gpsPositionUsable()
              ? gps.distanceBetween(gps.location.lat(), gps.location.lng(),
                                    routePoint(activeRouteIndex, activeRoutePointIndex).latitude(),
                                    routePoint(activeRouteIndex, activeRoutePointIndex).longitude())
              : 0;
    } else {
      segmentDistance =
          gps.distanceBetween(routePoint(activeRouteIndex, activeRoutePointIndex - 1).latitude(),
                              routePoint(activeRouteIndex, activeRoutePointIndex - 1).longitude(),
                              routePoint(activeRouteIndex, activeRoutePointIndex).latitude(),
                              routePoint(activeRouteIndex, activeRoutePointIndex).longitude());
    }

  } else {  // otherwise, we made it to our destination!
    // TODO: celebrate!  (play reaching goal sound, or whatever)
    reachedGoal_ = true;
    if (playSound) speaker.playSound(fx::confirm);
  }
  if (successfulSequence) savePersistedState();
  Serial.print(" succes is: ");
  Serial.println(successfulSequence);
  return successfulSequence;
}

void Navigator::cancelNav() {
  pointDistanceRemaining = 0;
  pointTimeRemaining = 0;
  activeRouteIndex = RouteID::None;
  activeWaypointIndex = WaypointID::None;
  activeRoutePointIndex = RouteIndex::None;
  activeRoutePoint = RoutePoint();
  reachedGoal_ = false;
  navigating = false;
  turnToActive = 0;
  turnToNext_ = 0;
  savePersistedState();
  speaker.playSound(fx::cancel);
}
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
