DangerMonkeys/leaf/(commit log)

2025-02-17 Move Speaker to Main System Timer To Allow Sleep
    onSpeakerTimerSample() called every 4 cycles of main loop, rather than it's own timer. This way we can ensure we update speaker pwm note when we're not sleeping
2025-02-23 fix bug not allowing sleep when no vario note
    [speaker.cpp, vario.ino]
2025-07-18 Split GPS hardware abstraction from GPS instrument (#162)
    * Add basic framework without functional changes
    * Use LC86G in LeafGPS
    * Init GPS from LC86G
    * Move hardware control to LC86G
    * Implement LC86G::update()
    * Move commented-out init to LC86G
    * Get GPS data from LC86G rather than directly from Serial0
    * Fix NMEA parsing logic
    * Clean up for PR
    [gps.cpp, gps.h, lc86g.cpp, lc86g.h, power_control.h, taskman.cpp]
2025-07-29 326 fanet auto-detect (#164)
    * WIP - auto-detect Fanet
    * Improved Fanet Detection
    * [FANET 3.2.6]
    * Detects presence of FANET Radio.
    * Bugfixes and check on initialization.
    * Fanet setting icon
    When uninstalled, shows warning icon instead of system setting
    * Decrease fanet detect time
    ---------
    [fanet_radio.cpp, fanet_radio.h, fanet_radio_types.h, main.cpp, power.cpp, variant.h]
2025-07-29 Abstract AHT20 into IAmbientSource (#163)
    * Abstract AHT20 into IAmbientSource
    * Fix field name
    [aht20.cpp, aht20.h, ambient.cpp, ambient.h, baro.cpp, log.cpp, power.cpp, taskman.cpp]
2025-08-01 Fix charging bug on <3.2.6 hardware (#167)
    [power.cpp]
2025-08-01 Fix startup delay waiting for Serial (#168)
    * Fix startup delay waiting for Serial
    * WIP on fix_boot_time
    Remove delays altogether, including while() loop
    [main.cpp]
2025-08-08 [Bugfix] Fix crash on quick NMEA updates (#174)
    If NMEA Updates are coming in too quickly, the BLE stack throws away the update. A return will crash FreeRTOS. Thx for spotting, Ries!
    [ble.cpp]
2025-08-10 Transmit pressure information via message bus (#176)
2025-08-10 Class-ify power (#179)
    * Move power functions into class methods
    * Improve enums, move constants to implementation
    * Change singleton references to instance, clean up
    * Make power information read-only
    * Rename clamped enum
    * Move function implementations to .cpp
2025-08-10 Class-ify buttons (#178)
    * Move button functions into class methods
    * Move variables into class fields and clean up
2025-08-10 Class-ify display (#177)
    * Move display functions into class methods
    * Move used variables into class fields
    * Clean up class
    * Strictly type MainPage enum
    * Strictly type PageAction enum
    * Use instance methods rather than singleton methods
    * Harmonize clamped and wrapping enums
    * Fix problems missed in merge
    [buttons.cpp, display.cpp, power.cpp, power.h, taskman.cpp]
2025-08-12 Transmit GPS text via message bus (#175)
    * Transmit GPS text via message bus
    * Remove unused method
    * Make invalid operation fail loudly
    [gps.cpp, gps.h, lc86g.cpp, lc86g.h, main.cpp, message_bus.h, message_types.h, power.cpp]
2025-08-12 Class-ify taskman (#186)
    * Class-ify taskman
    * Fix typo in merge commit conflict resolution
    [main.cpp, taskman.cpp, taskman.h]
2025-08-13 Add Hidden Dev Menu (#189)
    * Add Hidden Dev Menu
    including user settings for developer options
    * clarified log start/stop logic location
    * Improve for loop (skip drawing hidden menu)
    [settings.h]
2025-08-17 Split buttons into hardware and dispatcher (#190)
    * Split Buttons into hardware and dispatch
    * Update information flow diagram
    * Fix behavior
    [buttons.cpp, buttons.h, fanet_radio.h, fatal_error.cpp, main.cpp, message_types.h, power.cpp, taskman.cpp]
2025-08-17 Track and use Ambient state (#193)
2025-08-17 Add Sensor Axes Definitions in vario/hardware/readme.md (#198)
2025-08-18 Fix merge + buttons state transition (#202)
    * Fix merge issue for initial sensor connection
    * Fix buttons state transition issue
    [buttons.cpp, main.cpp]
2025-08-19 Improve fatal error and add backtrace (#203)
    * Improve fatal_error
    * Also log backtrace to file
    * Adjust README
    [fatal_error.cpp]
2025-08-20 Simplify Buttons (#205)
2025-08-20 Clean up baro: part 1 (#206)
    * Add Barometer state
    * Protect fields and evaluate lazily
    * Fix IMU's premature baro access
    * Fix baro first reading and flight detection early baro access
    * Fix altAdjusted access while sleeping
    * Protect baro access when not Ready
    [ambient.h, baro.cpp, baro.h, ble.cpp, fatal_error.cpp, igc.cpp, imu.cpp, imu.h]
2025-08-21 Split out charging and debug pages to separate files (#207)
2025-08-21 Cleanup baro: part 2 (#209)
    * Protect climbRate
    * Protect climbRateFiltered
    * Protect and initialize climbRateFiltered
    * Remove unused resources
    * Fix evaluation of climbRateAverage validity
    [baro.cpp, baro.h, ble.cpp, fanet_radio.cpp, gps.cpp, log.cpp, ms5611.cpp, running_average.h]
2025-08-21 Add system state/power state transition diagrams (#210)
2025-08-23 Replace Telemetry with additional message bus logging (#208)
    [baro.cpp, baro.h, buslog.cpp, buslog.h, flight.cpp, gps.cpp, imu.cpp, imu.h]
2025-09-01 Clean up IMU (#211)
    * Protect field access, improve gravity init
    * Fix revealed unprotected field accesses
    * Re-disable IMU debug logging
    * Remove IMU init
    * Add additional debugging hooks
    [baro.cpp, baro.h, ble.cpp, imu.cpp, imu.h, kalman.cpp, kalman.h]
2025-09-03 Add sensor sanity checks and improve access logic and assertions (#226)
    * Add sensor sanity checks
    * Fix access logic + improve assertions
    [aht20.cpp, baro.cpp, icm_20948.cpp, imu.cpp, kalman.cpp, kalman.h, ms5611.cpp, ms5611.h]
2025-09-04 Show fatal error message as multi-line text (#231)
    [baro.cpp, buttons.cpp, fatal_error.cpp, speaker.cpp, taskman.cpp]
2025-09-06 219 [Crash] In flight Crash (#222)
    * [Fanet Crash] Fixing FANET crashing
    Small chance of the vario crashing on RX'ing Fanet packets. This is due to using a static variable in a function from an ISR.
    Fixes #219
    * Use global instance for FanetRadio rather than static member
    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
    [debug_webserver.cpp, fanet_radio.cpp, fanet_radio.h, log.cpp, main.cpp]
2025-09-19 Add ESP32 wifi/BLE FCC ID (#235)
    * Add ESP32 wifi/BLE FCC ID
    * Add FCC ID's to About Page
2025-09-19 Add Charge Current Monitor (#236)
    * Add Charge Current Monitor
    read ISET pin ADC and convert to actual charge current in mA
    * Add charge current to debug page
    * Adjust Terminology
2025-09-21 Remove weAreFlying, Improve AutoStop Detection (#240)
    * Remove weAreFlying, Improve AutoStop Detection
    remove parallel 'we are flying' state variable and instead just use the timer_running state
    improve auto-stop detection and further condition it on a calm IMU accel value
    This should fix the issue of unexpected speaker and wind_estimate behavior based on the weAreFlying state variable.
    Also should limit the number of false positives of AutoStop
    * Fix initial_alt reset logic on timer stop
    [log.cpp, log.h, speaker.cpp, wind_estimate.cpp]
2025-09-21 Timer AutoStop Alert Dialog (#241)
    * WIP AutoStop dialog handler
    * Proper Display of AutoStop Alert Dialog
2025-10-18 [FANET] Sync Word Change (#249)
    - updated the BLE updates for FANET neighbors to include the checksum. This seems to make SeeYou Navigator happy now!
    - Bugfix - Change SyncWord to match OGN-Tracker reference for SX1262.
    [ble.cpp, fanet_radio.cpp]
2025-12-18 Fix Baro Shutdown Bug (#250)
    [power.cpp]
2025-12-18 Added additional debugging info for GPS new sentence bug (#251)
    [gps.cpp]
2025-12-23 Fix premature access of baro() (#258)
    [log.cpp, power.cpp]
2025-12-23 Wifi menu simplification (#259)
    * Simplify Wifi Menu and Add Reset option
    * Restructured Wifi Menu and user flow
    * tweaks to wifi config
    * more tweaks to wifi setup
    [power.cpp]
2026-03-29 Add Low Battery Warning before auto-shutdown (#266)
2026-04-04 Adjust auto-off time (#268)
    * Adjust auto-off time
    wait longer if no gps fix to allow searching
    some minor bug and logic fixes in auto-turn off
    * Adjust auto-off time
    * Remove old serial prints
    [power.cpp, power.h]
2026-04-05 KML and logging improvements (#269)
    * WIP- KML timestamps
    * KML gx:track supported
    Replace simple "LineString" with "GX Track" to support timestamped waypoints in track log
    * Clean up KML logging
    Fix flight track description/summary
    Add guards on checking baro.climbRateFiltered() if not ready
    Log gps altitude instead of baro altitude for records and max/min/above launch
    Add both distance along path and straight-line (Start to Finish) distance recording in logbook
    [flight_stats.h, log.cpp, log.h]
2026-04-22 Pin versions of pio and espressif (#272)
    * Pin versions of pio and espressif
    * updated platform version reference
    * updated platform url again
2026-04-22 Adjustable AutoOff Timeout and UI Improvements (#270)
    * Improve wifi setup directions
    * Make AutoOff Setting Adjustable
    Also remove time-out-reset from alt/accel/gps changes; just button pushes reset the time out.
    * Additional UI tweaks and fixes
    * format files
    [log.cpp, power.cpp, settings.h]
2026-05-05 Power Updates (battery voltage and shutdown procedure) (#279)
    * Power Updates
    use calibrated ADC voltage value for battery %
    fix improper display.update() calls during/after shutdown
    * show Flight Summary page optional
    add bool to show Flight Summary or not (so we can conditionally not show it when shutting down)
    [display.cpp, flight.cpp, flight.h, igc.cpp, igc.h, log.cpp, log.h, power.cpp]
2026-05-05 Fix: Prevent crashing when calling ClimbRate during boot races (#273)
    * Fix: Prevent crashing when calling ClimbRate during boot races
    * Fix: double pop_page() crash from AutoStop alert dialog (regression from #241) (#275)
    * Fix: showingAlert_ not reset after auto-close causes double pop_page() crash
    When flightTimer_autoStop() called closeAlert() (either on timer
    expiry or conditions reset), showingAlert_ was left as true. On the
    next tick the else-branch would call closeAlert() again, invoking
    pop_page() on a page no longer on the modal stack. pop_page() then
    called etl::stack::top() on the wrong state, returne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
    [baro.cpp, log.cpp]
2026-05-09 Add basic Self Test functionality (#262)
    * WIP on self test
    * WIP self test (mainly buttons so far)
    * Fix reboot bug (button handling)
    * Display/UI tweaks on self test page
    * WIP self test - add vario test
    * MVP of vario test working
    * WIP combining all tests
    * MVP of all tests combined
    * Add in speaker self test
    * Add Power Self Test
    * Small Self Test Fixes
    * Add "run self test" option in developer menu
    * Small bugfix with self test sd card file
    * fix speaker volume setting bug
    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
    [sd_card.h, settings.h, taskman.cpp, taskman.h]
2026-05-11 Add diagnostics network connection (#265)
    * Add diagnostic network detection & connection capability
    * Fix diagnostic WiFi scan handling
    * Initialize diagnostic network state
    * Retry diagnostic WiFi scan on power on
    * Delay diagnostic scan after power on
    * Fix connection procedure
    * Format C++ files
    * Add usage note on USB input flag
    [diagnostic_network.cpp, diagnostic_network.h, power.cpp, power.h, taskman.cpp]
2026-05-12 fix log Auto Start check error
    [log.cpp]
2026-05-16 Attempt diagnostic network connection once while off + charging (#286)
2026-05-17 Discover leaf device on network during factory commissioning (#288)
2026-05-18 Add memory reset to factory_interface (#292)
    * Add memory reset to factory_interface
    * Split reconnect checklist item out separately
    [webserver.cpp]
2026-05-18 Ensure Factory Reset clears everything necessary, and those values get reinstated on next boot (#293)
    [fanet_radio.cpp, settings.h]
2026-05-19 Implement factory interface persistence (#297)
    * Rework database layout
    * Add operator identification
    * Solicit notes from operator
    * Add cancellation
    * Read firmware version
    * Add support for release firmware
    * Assign FANET ID
    * Fix diagnostic network connection when already charged
    * Fix spurious rebuilds
    * Use previously-assigned FANET ID for recognized MAC addresses
    * Add device commissioning sessions
    * Retrieve test result details
    * Write results to database
    * Autoformat
    [diagnostic_network.cpp, factory_discovery.cpp]
2026-05-19 Fix Self Test Bugs (#298)
    * Fix Self Test Bugs
    Button test fail (timeout) now works properly
    Fix IMU and Ambient testing too soon after boot
    * fix timing bug on speaker test
2026-05-20 Finish factory interface MVP (#299)
    * Improve timeout behavior
    * Improve new device discovery behavior and add /discovery for debugging
    * Improve verification tests legibility
    * Fix self test details retrieval upon failure
    * Rearrange factory_interface page structure
    * Add commissioning completion comfirmation
    * Clear self test result files from SD card
    * Add + link and reorder FANET ID step
    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
    [factory_discovery.cpp, factory_discovery.h]
2026-05-21 Fix occasional GPS-caused fatal errors (#300)
    * Add failing test
    * Handle non-standard TinyGPSPlus parsing behavior
    [gps.cpp, main.cpp]
2026-05-21 Improve Self tests & report text (#301)
    * Refinement to SelfTest
    changed order of tests
    ensure IMU is stable before testing
    change text output of test results to be future-proof JSON parsable
    * tweak tests
2026-05-22 Remove alt-change triggered log auto-start (#303)
    Alt trigger was causing false positives and also if triggered before GPS fix, then log-auto-stop was firing because gps.speed is zero until a fix.
    [log.cpp]
2026-05-25 Don't allow log auto-start if Flight Summary is showing (#305)
    if the user is still looking at the flight summary, then don't allow another log to auto-start in the background. This also helps if the user forgets to turn off their vario, since a new log can't start (once a log auto-starts, the vario won't turn itself off).
    [log.cpp]
2026-06-02 Fix: critical assignment bug in UDP message type check (#308)
    Changed msgType = 'P' (assignment) to msgType == 'P' (comparison).
    This bug caused all unrecognized message types to incorrectly execute
    the pressure update handler instead of being rejected.
    [udp_message_server.cpp]
2026-06-02 [FANET] Adding unit test to show crash when parsing rx packet with no location (#307)
    Fixed crash
    [fanet_neighbors.h]
2026-06-02 Vario bug (#304)
    * Attempt at Vario climbrate fix
    From Codex:
    Implemented the IMU/baro/Kalman hardening pass.
    The biggest concrete issue was in icm_20948.cpp (line 20): the DMP was producing ~75 Hz while the task loop consumed one packet at 20 Hz. I changed the DMP ODR to ~20 Hz, drain FIFO bursts to the newest valid sample, and reset/log if the FIFO still has backlog or incomplete packets.
    I also hardened imu.cpp (line 39) by normalizing the reconstructed quaternion before world-Z rotation, rejecting implausible quaternion/gravity states, aligning gravity init to the actual 20 Hz cadence, and only adapting the gravity baseline when total acceleration and vertical acceleration look steady.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
    [icm_20948.cpp, imu.cpp, kalman.cpp]
2026-06-08 GPX dynamic routes (#316)
    * refactor routes into array of indices
    this avoids saving duplicate points for each route
    * Allow skipping of poorly formatted gpx waypoints instead of failing the entire parse
    * Fix tag open/close bug when no lat/lon attributes
    * add parse character limit to not hang device
    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
    [gpx.cpp, gpx.h, gpx_parser.cpp, gpx_parser.h]
2026-06-14 Fix(IGC) Version bump for IGC Lib (#319)
    [igc.cpp]
2026-06-16 IMU Self Test Fixes (#320)
    * Fix ambient self Test bug
    * Remove baro condition on IMU test
    * Add Self Test Running display screen
    * Include gravity warm-up in IMU test
    ..so we're not waiting for it in vario test
2026-06-16 Adjust timeout of IMU test (#321)
2026-06-18 Mass Storage in charge mode (#324)
    properly initialize USB.begin() when MSC and CDC are both ready
2026-06-23 Fix Gravity estimate bug (protection threshold and slew rates) (#328)c
    also add a second debug page just for gravity estimate values and sample counts
    [display.cpp, icm_20948.cpp, icm_20948.h, imu.cpp, imu.h]
2026-06-23 Improve vario startup readiness and default build target (#331)
    * remove gravity init samples and just use 1.0g
    * Improve vario startup readiness and splash progress
    Improve startup sensor readiness handling
    - Start gravity estimate at 1.0g and clamp updates to a narrow plausible range
    - Discard initial baro samples before setting launch/initial altitude
    - Require Kalman warmup before reporting climb rate
    - Gate startup on clean IMU samples, with a 5s fallback for turbulent restarts
    - Keep splash visible until baro and IMU/Kalman startup readiness completes
    - Add splash progress bar for startup readiness
    - Prevent orientation-inconsistent vert! samples from injecting false vertical accele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
    [baro.cpp, baro.h, display.cpp, imu.cpp, imu.h]
2026-06-24 fix(factory): re-download release firmware when cached asset is stale (#332)
    The release-asset cache was keyed only by tag/asset-name and skipped
    downloading whenever a file already existed at that path. If a release asset
    was re-uploaded under the same tag (e.g. a rebuilt firmware.bin), the factory
    interface served the stale cached binary indefinitely, with no way to refresh
    short of manually deleting github_cache.
    Store each asset's GitHub sha256 digest on refresh, and validate the cached
    file against it (falling back to byte size, then to assuming current when no
    metadata is available) before reusing it. A mismatch now triggers a
    re-download automatically.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
2026-06-26 Added User Webserver and Custom Wifi Setup Captive Portal (#335)
    * Add shell of basic wifi web app for users to interact with leaf
    * Don't clear wifi credentials just by doing factory_interface scan
    * adjust web app menu page layout
    * Custom Leaf Wifi Portal
    * Clean up, remove WiFiManager, add bad password failure handling on web app
    * Add wifi coordinator, reduce heap usage and wifi page size
    * Show wifi searching status when first opening wifi menu
    * adjust searching status behavior
    * update Leaf UI to show Wifi setup instructions faster
    * faster wifi reset and transient connection failure handling
    * Add delay-explaining screen before wifi connect instructions
    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
    [diagnostic_network.cpp, taskman.cpp, webserver.cpp, webserver.h, wifi_coordinator.cpp, wifi_coordinator.h]
2026-06-26 Leaf logbook updates (#336)
    * update logbook schema
    * bare bones logbook entry and proper system clock sync
    * create basic logbook entry file
    * Add differentiation between timer start and first-fix obtained
    * Handle logbook entries with and without tracklogs
    * add logbook store helper functions
    * basic logbook viewer
    * Logbook UI tweaks
    * more logbook UI tweaks
    [flight.cpp, flight.h, flight_stats.h, gps.cpp, gps.h, log.cpp]
2026-06-29 Logbook tweaks (#342)
    * Improve web app logbook layout and navigation
    - Tighten web app logbook/profile layout and delete confirmation spacing
    - Format logbook dates with full weekday and EU-style dates
    - Respect Leaf unit settings in logbook web app display
    - Use single-pass logbook navigation for page turns and delete targets
    - Add 500 generated logbook JSON fixtures for performance testing
    * Refine logbook and flight summary displays
    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
    [logbook_store.cpp, logbook_store.h, webserver.cpp]
2026-06-29 Menu restructure (#343)
    * Revamp device menu structure
    - reorganize main, settings, connect, flight, and nav data menus
    - add menu glyphs, whole-row highlight helpers, and tighter OLED layout
    - update web app, logbook, BLE naming, and WiFi reconnect behavior
    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
    [ble.cpp, ble.h]
2026-06-30 Prep ig cupload (#345)
    * Add Leaf Log profile linking flow
    Clean up IGC header metadata and expose split firmware/hardware display versions.
    Add optional pilot email and Leaf Log link code storage in profile schema and web app editing UI.
    Improve WiFi setup from AP-hosted web app, including async scan refresh, branded setup UI, AP-to-network transition handling, and user-facing captive portal handoff text.
    Track a backlog item to remove temporary WiFi setup SD diagnostic CSV logging later.
    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
2026-07-04 Add route import and nav file persistence (#348)
    Support XCTSK route import through the web app and save imported routes to SD-backed Leaf JSON files.
    Load GPX, CUP, WPT/WYP, and KML nav files from /waypoints, load saved routes from /routes, and persist loaded nav state plus active destination/progress across power cycles.
    Refresh the Nav Data and Flight menus for Load File, Clear All, Select Dest, Reset Route, and the new nav glyphs.
    Verified with Format Leaf C++ Files and leaf_3_2_6_release.
    [gps.cpp, gpx.cpp, gpx.h, route_store.cpp, route_store.h, sd_card.cpp, webserver.cpp]
2026-07-08 Write viewer-compatible IGC task areas (#352)
    Emit standard task declaration point records with takeoff and landing placeholders so route and point navigation declarations render in common IGC viewers. Encode task area radii in raw meters to match viewer expectations, while preserving Leaf-specific L records for metadata.
2026-07-08 Guard logging and nav against stale GPS fixes (#354)
    [ble.cpp, gps.cpp, gps.h, gpx.cpp, igc.cpp, log.cpp, user_waypoints.cpp]
2026-07-08 Memory and Heap optimization (#355)
    * Add heap lifecycle diagnostics
    * Improve heap diagnostics and radio memory lifecycle
    * Add web and WiFi connection diagnostics
    * Tune navigation waypoint limits
    * Stream web app JSON with bounded buffers
    * Tighten web app WiFi setup lifecycle
    * Remove KML logging and waypoint support
    * Update heap improvement backlog
    [TODO.h, ble.cpp, ble.h, boot_diagnostics.cpp, diagnostic_network.cpp, factory_discovery.cpp, fanet_radio.cpp]
2026-07-08 Backlog Items (#356)
    * Reassert SD label and document diagnostics
    * Add web app firmware update check
    * Refresh web app firmware check backlog
    [boot_report.csv, heap_lifecycle.csv, heap_monitor.csv, web_requests.csv, webapp_requests.csv, wifi_autoconnect.csv, wifi_setup.csv]
2026-07-10 Factory interface update (#359)
    * Fix factory commissioning reset flow
    * Align factory interface with Leaf styling
    [factory_discovery.cpp, webserver.cpp]
2026-07-10 Fix WiFi setup portal recovery (#360)
    [webserver.cpp]
2026-07-16 Adjust gravity estimate limits, harden FANET SPI handling, and add gated vario diagnostics (#361)
    * Add gated vario diagnostics and tune gravity estimate
    * Harden FANET radio detection and SPI handling
    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
2026-07-26 018 release clean up (#363)
    * Polish Leaf profile and flight menu UI
    * Add logbook IGC downloads
    * Polish web app QR menu
    * Tighten release UI alignment
    [webserver.cpp]
2026-07-26 Add thermal detection replay and Leaf map display prototypes (#364)
    * Add IGC thermal detection replay tool
    * Enhance thermal replay tuning tool
    * Add Leaf LCD display simulations
2026-07-27 Add display editor tooling and circle drawing helpers (#367)
    * Add display editor tooling
    * Enhance display editor and circle drawing helpers
    [baro20hz_1.csv, baro50hz_1.csv, baro_accel_50hz_1.csv, example1.csv]
2026-07-28 Fix Too Short password bug (#369)
    [webserver.cpp]
2026-07-29 Fix active profile after deletion
    [webserver.cpp]
2026-08-04 Add vario volume shortcut (#373)
    [log.cpp, settings.h]
2026-08-04 Add optional CPU utilization diagnostic log (#374)
    * Add CPU utilization diagnostic log
    * Move scratch diagnostics logs
    [boot_report.csv, cpu_utilization.csv, cpu_utilization2.csv, cpu_utilization3.csv, cpu_utilization4.csv, heap_lifecycle.csv, heap_monitor.csv, web_requests.csv]
2026-08-06 Add gated Thermal Track detection and Leaf Labs settings (#376)
    * Add IGC B-record flight data extensions
    * Enhance display editor primitives
    * Add thermal navigation prototype
    * Refine display page menu labels
    * Align CPU utilization labels with thermal tasks
    * Optimize thermal nav display drawing
    * Tune thermal detector defaults
    * Improve thermal tracking display and replay
    * Restore thermal replay simulator features
    * Tune thermal replay ground horizon
    * Dampen replay horizon zoom
    * Polish replay map interactions and thermal markers
    * Smooth replay follow rendering
    * Refine replay map selection and scrubbi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
    [cpu_utilization5.csv, cpu_utilization6.csv]
2026-08-11 Add Thermal Core replay, simulator, and hosted training page (#378)
    * Prototype thermal core replay display
    * Update thermal track display controls
    * Add thermal core simulator game
    * Polish thermal core trainer UI
    * Refine thermal core tutorial flow
    * Add thermal core tutorial script
    * Host thermal core simulator on website
2026-08-14 Add Leaf Log device pairing behind Leaf Labs toggle (#380)
    * Add Leaf Log device pairing
    * Format Leaf Log webserver changes
2026-08-20 Add automatic Leaf Log flight uploads (#383)
    * Plan: Auto Upload to LeafLog
    created an architecture and implementation plan for supporting auto-uploads to LeafLog
    * docs: separate USB power-on ownership backlog
    * docs: define local Leaf Log rejections
    * feat: auto-upload flights to Leaf Log
    * fix(leaf-log): make auto-upload retries reliable
    Decode chunked ingest responses before parsing, retain firmware SD ownership while retries are pending, and expose USB only on user cancellation or completion. Keep upload progress totals stable across eligibility rescans.
    * fix(leaf-log): improve upload reliability and controls
    Keep Wi-Fi connected across a multi-file upload session and record st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
    [buttons.cpp, buttons.h, leaf_log_client.cpp, leaf_log_client.h, leaf_log_credentials.cpp, leaf_log_credentials.h, leaf_log_sync.cpp, leaf_log_sync.h]
2026-08-20 Stabilize LeafLog SD ownership and USB storage (#384)
    Keep firmware and host SD access mutually exclusive, batch MSC I/O through a recoverable 4 KiB DMA buffer, and make power-on transitions disconnect USB cleanly.
    Also harden LeafLog retry, cancel, eject, diagnostics, and failure states and add an isolated ESP32-S3 MSC reference test.
    [buslog.cpp, buttons.cpp, buttons.h, diagnostic_logs.cpp, fatal_error.cpp, leaf_log_sync.cpp, leaf_log_sync.h, main.cpp]
2026-08-20 Add IGC track previews and Leaf Log status icons (#386)
    * Polish web app IGC preview
    * Add Leaf Log status icons
2026-08-20 Add a host device emulator for the Leaf firmware (#381)
    `sim/` builds the real `src/vario` sources for the host and runs them against a
    virtual ESP32 board: a virtual clock, a virtual GPIO/ADC/LEDC board, the SD card
    as a host folder, NVS as text files, and sensor data played from a recording.
    Only the layers that cannot exist off-device are replaced (Arduino core, ESP-IDF,
    FreeRTOS, the sensor drivers' I2C/SPI traffic, the radios); the display, menus,
    instruments, navigation and logging are the shipping code, so what the emulator
    draws is what the device draws.
    The runtime serves a browser control panel over HTTP -- screen, buttons, clock
    control, scenario scrubbing, a 3D view of the loade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
    [Arduino.h, AsyncUDP.h, Embedded_Template_Library.h, Esp.h, FS.h, HardwareSerial.h, ICM_20948.h]
2026-08-21 Fix the emulator against main + review follow-ups (#387)
    * Restore the emulator build against main
    Stubs for the headers #383, #384 and #386 pulled into the firmware.
    * Add a Thermal Core scenario and script
    Both circling directions, an off-centre entry and a re-centring correction.
    * Fix IGC flights that cross midnight
    Elapsed time went negative at the rollover, making a 49-day scenario.
    Also documents that scenario seek does not rewind device state.
    * Fix the emulator's cross-thread and restart handling
    Clock and frame state the HTTP threads touch is now atomic; serial and tone
    output are append-only with a cursor per consumer; /api/restart re-execs
    instead of re-running setup(); --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
    [Arduino.h, HTTPClient.h, HardwareSerial.h, WiFiClientSecure.h, arduino.cpp, board.cpp, board.h, clock.cpp]
2026-08-30 fix(leaf-log): use production URL
    [comms.cpp, webserver.cpp]
2026-08-30 fix(leaf-log): free BLE memory for charge uploads
    [leaf_log_client.cpp, leaf_log_client.h, leaf_log_sync.cpp, leaf_log_sync.h, main.cpp, power.cpp]
2026-09-06 Recover commissioned devices after settings reset
    [leaf_log_sync.cpp, leaf_log_sync.h, settings.h, webserver.cpp]
2026-09-08 Fit Leaf BLE name and UART service in primary advertisement
2026-09-08 Recover BLE advertising and show connection status
    Retry advertising from the BLE task while enabled and disconnected, with serialized start/stop handling. Recreate the GATT database on Bluetooth restarts and preserve ownership of the static server callback.
    Show runtime BLE status in the Connect menu and document diagnostics. Update simulator stubs for the status display and current SD-card API.
    Validated with the leaf_3_2_6_release build, verified flashing to both OTA slots, simulator startup and Connect menu checks, and user-tested SeeYou Navigator disconnect/reconnect with NMEA streaming.
2026-09-09 Improve Bluetooth reliability and update defaults, favicon, and speaker research (#400)
    * Stop BLE before sleeping barometer
    * Fit Leaf BLE name and UART service in primary advertisement
    * Recover BLE advertising and show connection status
    Validated with the leaf_3_2_6_release build, verified flashing to both OTA slots, simulator startup and Co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
2026-09-19 Add configurable vario audio settings to the web app (#402)
    * Disable sink tones when sink alarm is off
    * Anchor sink tone at alarm threshold
    * Add web vario settings and tone tests
    * Slow vario tests and expand gauge scale
    * Refine web vario controls and tone curves
    * Define vario tones with explicit rate endpoints
    * Tighten vario controls and preserve sink cadence
    * Move vario controls to settings page
    * Polish vario settings controls and previews
    * Polish settings feedback and unlink confirmation
    * Separate vario settings section state
    * Space Leaf Log unlink confirmation
    * Show firmware update errors in developer mode
    [settings.h, speaker.cpp, speaker.h, webserver.cpp]
2026-09-20 Handle missing ambient sensors and improve charging battery estimates (#403)
    * allow for no AHT20 ambient sensor
    * Handle unavailable ambient sensor in self-test and UI
    * Correct battery percentage while charging
    * Tune charging voltage compensation
    [aht20.cpp, aht20.h, battery_characterization.h, power.cpp, power.h]
2026-09-23 Fix clicking and stepping in vario tones (#404)
    * Fix tone noise artifacts by using MCPWM and freq smoothing
    * disable mcpwm timer during silence to allow for future light-sleep during silence
    * rename default freq to bootstrap freq for clarity
    * Remove smoothing and 1ms timer from speaker_driver
    * Add vario tone smoothing to existing 10ms speaker update task
    * Remove esp_timer remnants from sim hal
    [TODO.h, mcpwm_sim.cpp, mcpwm_timer.h, speaker.cpp, speaker.h]
2026-09-23 Improve Leaf Log charging upload status (#407)
    * Improve Leaf Log charging status
    * Clarify Leaf Log connection progress
    * Streamline Leaf Log upload progress
2026-09-23 Fix simulator diagnostics and audio timing (#408)
    [comms.cpp]
2026-09-24 Expand thermal training tutorial (#410)
    * Add thermal training tutorial prototype
    * Expand thermal training tutorial
2026-09-27 Improve cooperative thermal training with 3D friends and harder conditions (#412)
    * Add thermal training scenarios with friends
    * Improve cooperative thermal training and add harder conditions
    * Randomize wind and persist friends stage turn direction
2026-10-19 Add Leaf IGC checksums and native validation utility (#414)
    Pin IgcLogger v0.0.6, use the provisional XLV identifier, and expose the MD5 dependency to the simulator. Add a small C checksum validator with Windows cross-compilation and macOS/Linux build instructions.
    The G record verifies the logger MD5 checksum; it does not authenticate a recorder or establish CIVL/XContest acceptance.
2026-10-19 Include prebuilt Windows IGC validator
    Track the Windows x86 executable and document downloading, running, and rebuilding it from source. Keep other generated validator outputs ignored.
2026-10-21 Improve thermal guidance and layouts with live simulator training (#415)
    * Refine Thermal Core LCD layout and simulator display tools
    Rework altitude, climb, wind, and map placement on the Thermal Core page. Add simulator LCD zoom, pixel grid, and coordinate inspection controls, and document the verified Windows Docker startup workflow.
    * Project Thermal Core breadcrumbs to current altitude
    Capture compact wind snapshots with each observation and project breadcrumbs using altitude difference and inferred upward air speed. Read samples through a chronological view instead of copying the history, and use the same projection for centering advice.
    Validation: formatter, thermal projection/hi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
2026-10-21 Add configurable navigation fields and thermal display auto switching (#417)
2026-10-21 Add v3.2.8 hardware support with LSM6DSV IMU (#416)
    * Add Leaf v3.2.8 LSM6DSV IMU support
    Integrate SFLP gravity, experimental Kalman acceleration-bias estimation, power lifecycle handling and commissioning calibration. Preserve the legacy ICM estimator and document bench results, replay tests and remaining flight qualification.
    * Fix v3.2.8 IMU saturation recovery and gate bias learning
    * Capture commissioning IMU bias and restore normal commissioning behavior
    * update vscode json extention list
2026-10-21 Retire dev firmware builds and gate UDP sensor injection (#420)
    Build release firmware for all supported hardware, keep v3.2.2 available for manual builds, and limit GitHub builds and OTA announcements to field variants. Remove retired build-only features and update tooling, diagnostics documentation, and regression coverage.
    Retain UDP sensor injection behind developer mode and a separate default-off web setting. Clear the saved opt-in when developer mode is disabled and enforce the gate in both the API and packet receiver.
2026-10-22 Add bounded runtime assessments and restore GPS UART slot yielding (#421)
    * Add bounded runtime telemetry and baseline assessment reports
    * Yield GPS UART reads between characters when the task slot expires
    * Save Navigate runtime baseline and diagnostic follow-up evidence
    * Normalize historical runtime assessment README line endings
2026-10-22 Add Leaf Log website shortcut for linked devices (#422)
2026-10-22 Polish simulator LCD controls and device panel (#423)
2026-10-22 Revamp charging dialogs and animate Leaf Log uploads (#425)
    Use shared pixel glyphs and procedural animations, keep uploads responsive with a background worker, add cancel confirmation and cap sessions at 100 flights. Update USB notices and the charging footer, with simulator coverage and visual review captures.
2026-10-23 Speed up Thermal Track rendering and restore HELLO splash (#426)
    * Speed up Thermal Track rendering and retain live thermal data
    Stamp precomputed range rings, erase masks and marker sprites into the native framebuffer. Outline range labels and optimize even-diameter circle drawing while preserving pixels.
    Remove the temporary fake-thermal build and data. Add circle/bitmap/display regression coverage and retain the exploratory device timing reports separately from manual updates. Verified production Leaf 3.2.8 build and both-slot device flash.
    * Restore static HELLO startup splash
2026-10-23 Harden logbook saves and recovery with bounded retries (#430)
    * Harden logbook writes and recovery with bounded save retries
    * Record Phase 1 build and dual-slot flash on Leaf 3.2.8
    * Keep USB diagnostics from blocking charge-to-on transitions
    * Record hardware confirmation of USB startup fix
    * Record Phase 1 save recovery and deletion checks on hardware
2026-10-23 Track sustained g-load and preserve interval diagnostics (#431)
    Raw once-per-second g-load snapshots miss brief peaks, while unfiltered logbook extremes can include launch and ground handling. This integrates sustained g-load tracking on both ICM-20948 and LSM6DSV hardware and adds interval diagnostics so field testing can show which measurements were retained or discarded.
    - Feed both IMU instrument paths, show fresh filtered load on the User page, and persist unavailable extrema as null instead of 1 g.
    - Add V2 IGC records for raw/filtered interval extrema and timestamps, sample/gap/clipping/reset counts, detector transitions, and pending/committed/discarded extrema. Write a final diagnos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
2026-10-24 Add Leaf v3.2.8 hardware schematic
2026-10-29 Preserve vario continuity through delayed sensor updates (#434)
2026-10-29 Reduce logbook save overhead and make repairs explicit (#436)
    * Lighten flight logbook saves and defer quiet recovery
    * Capture SD dialogs and logbook states for visual review
    * Polish standalone SD dialogs with centered rounded frames
    * Make logbook browsing read-only and repair explicit
    * Verify completed log saves and retire superseded backups
    * Raise shared rounded dialogs three pixels
    * Distinguish logbook read failures and validate upload scan queues
2026-10-29 Improve FANET radio configuration and add range-test logging (#433)
    * Add FANET range-test logging and evaluation backlog
    Record independent per-flight neighbor CSVs, save runtime captures on STOP with retry support, and gate runtime FANET screens and radio actions on detected hardware. Remove the unsafe web FANET diagnostics page.
    Document the antenna evaluation plan and remaining RF work. Validate with formatting, simulator regressions, developer-card checks, runtime-report tests, and the leaf_3_2_6_release firmware build; no Leaf was detected for flashing.
    * Document student and instructor training firmware plan
    * Configure SX1262 current limit and adaptive FANET coding
2026-10-29 Show persistent Leaf Log results on the charging screen (#437)
2026-10-29 Share launch evidence with g-load tracking and diagnose filter restarts (#439)
2026-10-29 Preserve October field tests and reusable device screen captures (#441)
    * Preserve October field-test recordings and portable analysis archive
    * Add reusable device capture library and preserve cleanup history
    * Use the documentation index convention for historical records
2026-10-30 Bound shutdown stalls and recover safely to charging (#442)
    * Bound shutdown and add independent power-off recovery guard
    * Keep shutdown fault selection in visual menu order and verify its layouts
    * Polish shutdown fault menu and isolate each test run's saved data
    * Record shutdown candidate checks and 3.2.6 test deployment
    * Record initial shutdown fault trials and remaining recovery checks
    * Give emergency RTC resets boot time and a second recovery stage
    * Stop both RTC watchdog enable modes before shortening its timeout
    * Record failed USB recovery, verified flight save, and replacement deployment
    * Isolate late shutdown recovery with developer fault boundaries
    * Fit late shutdo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
2026-11-01 Replace verbose flight traces with compact event diagnostics (#444)
2026-11-13 Record compact IGC sensor history and one-second climb extrema (#445)
    * Record compact IGC sensor history and one-second climb extrema
    * Simplify IGC sensor records and remove redundant flags
    * Leave IGC g-load eligibility to track readers
2026-11-13 Optimize cylinder route navigation by default (#447)
    * Optimize cylinder route navigation by default
    * Document the production route diagnostics workflow
